sratle/WCH-Model-Terminal/docs/project/Keyboard-2.md

# Keyboard-2 模块（游戏手柄）

## 概述

本模块为游戏操控输入方案，提供丰富的游戏控制输入能力，既服务于终端游戏场景，也可作为独立 USB HID 设备连接电脑。

- **主控芯片**：CH32V103C8T6
- **输入设备**：6 个按钮 + 3 个钮子开关 + 2 个摇杆 + 2 个旋转编码器
- **与核心模块接口**：模块侧 UART1（PA9-TX / PA10-RX），**230400/8-N-1**
- **CH9329 接口**：UART2（PA2-TX / PA3-RX），**115200/8-N-1**
- **模块 ID**：`0x20`（与 Keyboard-1 共用键盘模块 ID，通过子类型区分）
- **模块类型编号**：`0x04`
- **子类型编号**：`0x02`（Game Keyboard）

## 硬件组成

- **CH32V103C8T6**：GPIO 按键扫描、ADC 摇杆采集、编码器计数、协议帧打包、CH9329 通信
- **6 个按钮**（BUTTON1~BUTTON6）：机械按键，GPIO 直连，内部上拉
  - PB10 → BUT1，PB11 → BUT2，PB12 → BUT3
  - PB13 → BUT4，PB14 → BUT5，PB15 → BUT6
- **3 个钮子开关**（SW1~SW3）：每个开关有 UP/DOWN 两路 GPIO，内部上拉
  - PB0 → SW1_UP，PB1 → SW1_DOWN
  - PA13 → SW2_UP，PA14 → SW2_DOWN
  - PB4 → SW3_UP，PB5 → SW3_DOWN
- **2 个摇杆**（ROC1~ROC2）：双轴模拟摇杆，4 路 ADC 输入
  - PA4 → ADC_IN4 → ROC1_X
  - PA5 → ADC_IN5 → ROC1_Y
  - PA6 → ADC_IN6 → ROC2_X
  - PA7 → ADC_IN7 → ROC2_Y
- **2 个旋转编码器**（EC1~EC2）：增量式编码器，A/B 正交信号 + D 按下信号
  - PB6 → EC1_A，PB7 → EC1_B，PA11 → EC1_D（按下）
  - PB8 → EC2_A，PB9 → EC2_B，PA12 → EC2_D（按下）
- **CH9329**：串口转 HID 芯片，UART2 连接，将输入转换为 USB HID 报告
- **USB-A 接口**：Device 口，输出 HID 信号，可接 PC 等主机

### GPIO 引脚分配总表

| 引脚 | 功能 | 方向 | 模式 | 说明 |
|---|---|---|---|---|
| PA2  | UART2_TX | AF_PP | 复用推挽 | CH9329 通信 |
| PA3  | UART2_RX | IPU | 上拉输入 | CH9329 通信 |
| PA4  | ADC_IN4 | AIN | 模拟输入 | 摇杆 1 X 轴 |
| PA5  | ADC_IN5 | AIN | 模拟输入 | 摇杆 1 Y 轴 |
| PA6  | ADC_IN6 | AIN | 模拟输入 | 摇杆 2 X 轴 |
| PA7  | ADC_IN7 | AIN | 模拟输入 | 摇杆 2 Y 轴 |
| PA9  | UART1_TX | AF_PP | 复用推挽 | Core 通信 |
| PA10 | UART1_RX | IPU | 上拉输入 | Core 通信 |
| PA11 | EC1_D | IPU | 上拉输入 | 编码器 1 按下 |
| PA12 | EC2_D | IPU | 上拉输入 | 编码器 2 按下 |
| PA13 | SW2_UP | IPU | 上拉输入 | 开关 2 上拨 |
| PA14 | SW2_DOWN | IPU | 上拉输入 | 开关 2 下拨 |
| PB0  | SW1_UP | IPU | 上拉输入 | 开关 1 上拨 |
| PB1  | SW1_DOWN | IPU | 上拉输入 | 开关 1 下拨 |
| PB4  | SW3_UP | IPU | 上拉输入 | 开关 3 上拨 |
| PB5  | SW3_DOWN | IPU | 上拉输入 | 开关 3 下拨 |
| PB6  | EC1_A | IPU | 上拉输入 | 编码器 1 A 相 |
| PB7  | EC1_B | IPU | 上拉输入 | 编码器 1 B 相 |
| PB8  | EC2_A | IPU | 上拉输入 | 编码器 2 A 相 |
| PB9  | EC2_B | IPU | 上拉输入 | 编码器 2 B 相 |
| PB10 | BUT1 | IPU | 上拉输入 | 按钮 1 |
| PB11 | BUT2 | IPU | 上拉输入 | 按钮 2 |
| PB12 | BUT3 | IPU | 上拉输入 | 按钮 3 |
| PB13 | BUT4 | IPU | 上拉输入 | 按钮 4 |
| PB14 | BUT5 | IPU | 上拉输入 | 按钮 5 |
| PB15 | BUT6 | IPU | 上拉输入 | 按钮 6 |

## 软件职责

### 初始化阶段

- 初始化 CH32V103 时钟、GPIO
- 初始化 UART1（230400, 8-N-1）：PA9-TX / PA10-RX，连接 Core
- 初始化 UART2（115200, 8-N-1）：PA2-TX / PA3-RX，连接 CH9329
- 初始化 GPIO：6 个按钮 + 3 个钮子开关（6 路）+ 2 个编码器 D 信号，配置内部上拉
- 初始化 ADC：配置 4 通道（IN4~IN7）用于摇杆 X/Y 采样
- 初始化编码器：A/B 正交解码（主循环扫描式边沿检测）
- 初始化 CH9329：设置为键盘+鼠标混合模式
- 加载按键映射表

### 运行阶段

- **按钮扫描**：2ms 定时扫描 6 个按钮，检测按下 / 释放事件，软件消抖（3 次扫描 ≈6ms）
- **钮子开关扫描**：定时扫描 3 个开关的 UP/DOWN 状态，检测拨动事件
- **摇杆采集**：2ms 扫描周期内读取 4 通道 ADC，死区处理（±20/255）与归一化至 uint8（0~255，中心 128）
- **编码器解码**：主循环扫描式检测 A/B 正交信号变化，累计旋转增量（顺时针/逆时针），支持 D 按下检测
- **双通道输出**（均变化触发）：
  - 通过 **UART1** 向 Core 上报游戏控制事件（`CMD_KBD_GAME_INPUT`，9 字节全量状态）
  - 通过 **UART2 → CH9329 → USB-A** 输出标准 HID 键盘+鼠标报告（约 20ms 限流），实现接电脑即插即用

### 中断与事件

- TIM2 中断：2ms 扫描节拍（按钮/开关/摇杆 ADC/编码器均在此节拍驱动）
- UART1 中断：接收 Core 下发的查询或配置指令

## 项目目录结构

```
keyboard-2/
├── User/                           # 用户代码
│   ├── main.c                      # 主程序（2ms 扫描调度、双通道输出）
│   ├── Gamepad/                    # 摇杆 ADC、按钮/开关扫描、编码器解码、HID 报告构建
│   ├── CH9329/                     # CH9329 串口转 HID 驱动（UART2 @115200）
│   ├── Uart/                       # UART1 协议栈（230400，接 Core）
│   ├── protocol/                   # 统一协议帧打包/解析
│   └── ...                         # 中断/系统配置
├── Core/  Debug/  Peripheral/  Startup/  Ld/
└── game.wvproj                     # MounRiver Studio 工程文件
```

## 命名规范

- **文件**：统一采用下划线加小写字母，例如 `hardware.c`、`gamepad.h`
- **函数**：每个单词首字母大写加下划线，例如 `Hardware_Init()`、`Joystick_Read()`
- **变量**：统一小写加下划线，例如 `joy_x`、`btn_a_pressed`
- **文件夹**：下划线写法，仅首字母大写，例如 `Gamepad`、`CH9329`
- **系统目录**（`Core`、`Debug`、`Peripheral`、`Startup`）保持不动，不参与上述命名规范

## 开发要点

1. **摇杆死区与迟滞**：ADC 12-bit（0~4095）映射至 uint8（中心 128），软件死区 ±20；
   ROC1 方向判定带**迟滞**（压下阈值 <100/>200，释放阈值 <120/>180），防止方向键抖动；
   变化量 ≥10 才触发上报，滤除 ADC 微跳。**注意 ROC1/ROC2 的 X/Y 轴在硬件上互换**，
   固件已按实际方向修正（见 `gamepad.c` 注释）。
2. **编码器解码**：旋转编码器 A/B 正交信号做主循环扫描式边沿检测与方向判断，累计增量；
   上报 Core 后增量清零；HID 路径上增量 ×3 叠加到鼠标移动。
3. **钮子开关处理**：每个开关有 UP/DOWN 两路 GPIO，低电平有效（内部上拉），同一时刻 UP 和 DOWN 不应同时为低。可编码为三态：上拨（UP=0, DOWN=1）、下拨（UP=1, DOWN=0）、中间（UP=1, DOWN=1）。
4. **CH9329 混合模式映射**：CH9329 原生支持键盘和鼠标 HID 报告，不支持游戏手柄报告描述符。
   实际映射：ROC1 → **方向键**（W/A/S/D 方向 → Up/Left/Down/Right 箭头键）、BUT3~6 → H/J/K/L、
   SW1~3 上拨 → Left Shift/Ctrl/Alt（键盘报告）；ROC2 → 鼠标相对移动（÷8 缩放）、
   BUT1/BUT2 → 鼠标左/右键、EC1_D → 鼠标中键、EC1/EC2 增量 ×3 叠加鼠标 Y/X（鼠标报告）；
   EC2_D 当前未映射。
5. **双通道输出一致性**：同一输入状态同时向 Core（`CMD_KBD_GAME_INPUT`，变化触发）和
   CH9329（键盘+鼠标两帧 HID 报告，变化触发 + 约 20ms 限流）输出。接电脑时无需依赖 Core 即可工作。
6. **与 Keyboard-1 的协议兼容**：两者共用 `0x20` 模块 ID，Core 通过 `CMD_GET_TYPE` 子类型（`0x01` Main / `0x02` Game）区分。支持 `CMD_KBD_GET_STATUS` SUB=0x03 查询当前游戏输入快照。
7. **ADC 采样稳定性**：摇杆电位器供电建议使用 LDO 稳定电压，避免电源波动导致 ADC 值跳变。扫描周期 2ms。
8. **接电脑即插即用**：通过 CH9329 独立输出 HID，意味着即使不插入移动终端，单独把游戏手柄模块接电脑也应能正常工作，这是该模块的重要卖点。
9. **Core 侧联动**：Core 的 `keyboard.c` 将 ROC1 方向转换为方向键 HID 报告、ROC2 转换为鼠标移动
   转发 Display（与模块侧 HID 映射同构），游戏应用（如 Display-1 本地游戏）由此获得方向输入。
