sratle/WCH-Model-Terminal/docs/project/Protocol_Submodels.md

# Submodels 模块通信协议

## 1. 模块概述

- **模块类型编号**：`0x05`
- **模块 ID**：`0x40` ~ `0x42`（对应 UART6/7/8 三个配件槽）

Submodels 为可热插拔的配件模块，通过 UART 与 Core（V5F）通信。整机最多同时插入 **2 ~ 3** 个 Submodel（Submodel-7 副屏占用两个物理位置）。Core 通过 `CMD_GET_TYPE` 识别每个槽位实际插入的子类型。

| 子类型 | 名称 | 功能 |
|---|---|---|
| `0x01` | Fingerprint | 指纹识别 |
| `0x02` | Health | 健康监测（心率/血氧/HRV） |
| `0x03` | NFC | NFC 读卡（被动接收卡号） |
| `0x04` | Touch Ring | 触摸圆环 |
| `0x05` | RGB | RGB 灯效控制 |
| `0x06` | Laser | 激光测距 |
| `0x07` | Sub-Display | 副屏（反射屏，黑白低分辨率） |

### 1.1 帧格式速查

Submodels 通过 **UART6/7/8** 与 Core（V5F）通信，物理层参数：

| 参数 | 值 |
|---|-----|
| 波特率 | 230400 |
| 数据位 | 8 |
| 停止位 | 1 |
| 校验 | 无 |
| 流控 | 无 |

**帧结构**（总长度最大 264 字节）：

```
+--------+--------+--------+--------+--------+-------------+--------+--------+--------+--------+
|  HEAD  |  SRC   |  DST   |  LEN   |  CMD   |  DATA[0..N] | TAIL0  | TAIL1  | TAIL2  | TAIL3  |
| 1 byte | 1 byte | 1 byte | 1 byte | 1 byte |   N bytes   | 1 byte | 1 byte | 1 byte | 1 byte |
+--------+--------+--------+--------+--------+-------------+--------+--------+--------+--------+
```

- **HEAD**：固定 `0xAA`
- **LEN**：`CMD + DATA` 的总字节数，`N = LEN - 1`，范围 `1 ~ 255`
- **DATA**：数据域，长度由 LEN 推导
- **TAIL**：固定序列 `A5 5A FC FD`

**常用模块 ID**：

| ID | 模块 |
|----|---|
| `0x00` | Core（主控） |
| `0x40` | Submodel-1（UART6） |
| `0x41` | Submodel-2（UART7） |
| `0x42` | Submodel-3（UART8） |

> 完整协议规范（含接收状态机、通用操作码 `0x00~0x0F`、NACK 错误码定义）见 `PROJECT.md`。

---

## 2. 通用操作码定义

所有 Submodel 子类型共用以下操作码，通过 **DATA[0] 子命令** 区分具体功能。

| 操作码 | 宏名 | 方向 | 说明 |
| --- | --- | --- | --- |
| `0x40` | `CMD_SUB_EVT_NOTIFY` | Submodel → Core | 事件通知（识别成功、检测到 NFC 标签等） |
| `0x41` | `CMD_SUB_SET_MODE` | Core → Submodel | 设置模式 / 启动动作（注册指纹、开始测距等） |
| `0x42` | `CMD_SUB_GET_STATUS` | Core → Submodel | 查询状态 / 数据 |
| `0x43` | `CMD_SUB_DATA_REPORT` | Submodel → Core | 数据周期性上报（健康数据、RGB 状态等） |
| `0x44` | `CMD_SUB_SET_CONFIG` | Core → Submodel | 设置配置参数（删除指纹、删除标签等） |
| `0x45` | `CMD_SUB_ACTION_RESULT` | Submodel → Core | 动作结果（指纹注册成功、测距完成等） |
| `0x46` | `CMD_SUB_BULK_TRANSFER` | 双向 | 批量传输控制（副屏图片等） |
| `0x47~0x4F` | — | — | 预留 |

---

## 3. ACK/NACK 响应规则

### 3.1 设计原则

| 语义类别 | 说明 | 响应要求 |
|---|---|---|
| **查询 (Query)** | `GET_STATUS` | **必须 ACK + 数据** |
| **设置/动作 (Set/Action)** | `SET_MODE` / `SET_CONFIG` | **发送即忘，不响应** |
| **事件/上报 (Event)** | `EVT_NOTIFY` / `DATA_REPORT` / `ACTION_RESULT` | **不需要响应** |

> 发送即忘：Core 向 Submodel 发送设置/控制命令后不需要等待 ACK。

### 3.2 ACK / NACK 帧格式

**ACK 帧**：`[AA][DST][SRC][LEN][CMD=0x04][DATA...][A5][5A][FC][FD]`

**NACK 帧**：`[AA][DST][SRC][02][CMD=0x05][错误码:1][A5][5A][FC][FD]`

错误码详见 `PROJECT.md`。

---

## 4. 子类型协议详解

### 4.1 指纹识别（子类型 = 0x01）

#### 子命令定义

| 操作码 | 子命令 | 方向 | 说明 | DATA 格式 |
|---|---|---|---|---|
| `0x41` | `0x01` | Core→FP | 开始注册新指纹 | `[子命令:1][ID:1(可选)]`，缺省时模块以当前模板数量作为新 ID |
| `0x41` | `0x02` | Core→FP | 取消注册 | `[子命令:1]` |
| `0x41` | `0x03` | Core→FP | 设置 LED 灯效 | `[子命令:1][功能码:1][颜色:1][速度:1]` |
| `0x41` | `0x04` | Core→FP | 设置安全等级 | `[子命令:1][等级:1]` |
| `0x44` | `0x01` | Core→FP | 删除指纹 | `[子命令:1][指纹ID:1]` |
| `0x44` | `0x02` | Core→FP | 清空所有指纹 | `[子命令:1]` |
| `0x44` | `0x03` | Core→FP | 传感器休眠 | `[子命令:1]` |
| `0x42` | `0x00` | Core→FP | 查询指纹列表 | `[子命令:1]`，ACK + `[数量:1][ID0:1][ID1:1]...`（仅 ID 列表） |
| `0x42` | `0x01` | Core→FP | 查询指纹数量 | `[子命令:1]`，ACK + `[数量:1]` |
| `0x40` | `0x01` | FP→Core | 识别成功 | `[子命令:1][指纹ID:1][名字:16字节]`（模块侧名字补零，用户名由 Core Auth 解析） |
| `0x40` | `0x02` | FP→Core | 识别失败 | `[子命令:1][错误码:1]` |
| `0x40` | `0x03` | FP→Core | 注册/验证进度事件 | `[子命令:1][步骤类型:1][子步骤或ID:1][确认码:1]` |
| `0x45` | `0x01` | FP→Core | 注册成功 | `[子命令:1][指纹ID:1][名字:16字节]`（名字补零） |
| `0x45` | `0x02` | FP→Core | 注册失败 | `[子命令:1][错误码:1]` |

> 名字字段固定 **16 字节**，不足补零，UTF-8 编码；当前固件统一补零，
> 指纹 ID → 用户名的映射由 Core 的 Auth 模块（user.json 凭据绑定）完成。
>
> **进度事件（SUB=0x03）**：自动注册（`PS_AutoEnroll`）与自动验证（`PS_AutoIdentify`）
> 过程中，传感器每个应答包都会转换为一帧进度事件上报 Core：步骤类型对应 Syno 协议
> 的阶段（采图/生成特征/合并/存储/比对等），确认码为该阶段结果。Display 据此实时更新
> 录入引导 UI（提示抬手、再次按压、录入进度）。

#### LED 灯效子命令详解（CMD 0x41 SUB=0x03）

Core 通过此命令控制指纹模块上的 LED 呼吸灯效果，模块内部转发为 Syno 协议的 `PS_ControlBLN`（`0x3C`）指令。

**DATA 格式**：

```
DATA[0] = 0x03（子命令）
DATA[1] = 功能码
DATA[2] = 颜色
DATA[3] = 速度（循环次数/周期）
```

**功能码定义**：

| 功能码 | 宏名 | 说明 |
|---|---|---|
| `0x01` | `FP_LED_BREATH` | 呼吸灯 |
| `0x02` | `FP_LED_FLICKER` | 闪烁 |
| `0x03` | `FP_LED_ON` | 常亮 |
| `0x04` | `FP_LED_OFF` | 关闭 |
| `0x05` | `FP_LED_GRADUAL_ON` | 渐亮 |
| `0x06` | `FP_LED_GRADUAL_OFF` | 渐灭 |
| `0x07` | `FP_LED_HORSE` | 跑马灯 |

**颜色定义**：

| 颜色值 | 宏名 | 说明 |
|---|---|---|
| `0x00` | `FP_COLOR_OFF` | 灭灯 |
| `0x01` | `FP_COLOR_BLUE` | 蓝色 |
| `0x02` | `FP_COLOR_GREEN` | 绿色 |
| `0x03` | `FP_COLOR_CYAN` | 青色 |
| `0x04` | `FP_COLOR_RED` | 红色 |
| `0x05` | `FP_COLOR_MAGENTA` | 品红 |
| `0x06` | `FP_COLOR_YELLOW` | 黄色 |
| `0x07` | `FP_COLOR_WHITE` | 白色 |

**速度**：`0x00` ~ `0xFF`，数值越大速度越快（对应 Syno 协议中的 cycle 参数）。

> **注意**：灯效命令为"发送即忘"，模块不回复 ACK。若传感器处于休眠状态，模块会缓存灯效命令，待唤醒后发送。

#### 安全等级子命令详解（CMD 0x41 SUB=0x04）

设置指纹匹配的安全等级，影响识别精度和速度的平衡。

**DATA 格式**：

```
DATA[0] = 0x04（子命令）
DATA[1] = 安全等级
```

| 等级 | 说明 |
|---|---|
| `0x01` | 低安全等级（速度快，误识率稍高） |
| `0x02` | 中安全等级（默认，平衡） |
| `0x03` | 高安全等级（速度慢，误识率低） |

> 安全等级通过 Syno 协议的 `PS_WriteReg`（`0x0E`）写入系统寄存器实现。

#### 传感器休眠子命令详解（CMD 0x44 SUB=0x03）

使指纹传感器进入低功耗休眠模式。休眠后传感器停止自动检测，需通过 TOUCHOUT 中断或 Core 唤醒。

**DATA 格式**：

```
DATA[0] = 0x03（子命令）
```

> 模块内部发送 `PS_Sleep`（`0x33`）指令。休眠后 TOUCHOUT 引脚仍然有效，手指按下时输出低电平唤醒模块，模块再唤醒传感器进行验证。

#### 查询指纹数量子命令详解（CMD 0x42 SUB=0x01）

轻量级查询，仅返回指纹库中的有效模板数量，不返回完整列表。

**DATA 格式**：

```
DATA[0] = 0x01（子命令）
```

**ACK 响应**：

```
DATA[0] = 数量（1字节，0~255）
```

> 模块内部发送 `PS_ValidTempleteNum`（`0x1D`）获取数量。

#### 注册流程

```
① Core → FP: [标准帧] CMD=0x41 SUB=0x01 开始注册
② FP → Core: [标准帧] CMD=0x04 ACK（进入注册模式）
③ 用户在指纹模块上录入指纹...
④ FP → Core: [标准帧] CMD=0x45 SUB=0x01 注册成功 + 新指纹ID + 名字
```

#### 自动验证流程

```
① 手指按下 → TOUCHOUT 中断触发
② FP 模块发送 PS_AutoIdentify（0x32）启动自动验证
③ 验证成功：FP → Core: [标准帧] CMD=0x40 SUB=0x01 [指纹ID][名字:16字节]
   验证失败：FP → Core: [标准帧] CMD=0x40 SUB=0x02 [错误码]
```

#### LED 灯效控制流程

```
① Core → FP: [标准帧] CMD=0x41 SUB=0x03 [功能码][颜色][速度]
② FP 模块内部转发为 PS_ControlBLN（0x3C）
③ （发送即忘，不回复 ACK）
```

---

### 4.2 健康监测（子类型 = 0x02）

模块上电默认 IDLE（等待手指），检测到手指（IR 超阈值）自动进入 MONITORING 开始测量，
手指离开自动回到 IDLE；Core 也可强制开始/停止。定时主动上报间隔默认 5 秒。

#### 子命令定义

| 操作码 | 子命令 | 方向 | 说明 | DATA 格式 |
|---|---|---|---|---|
| `0x44` | `0x01` | Core→Health | 设置监测间隔 | `[子命令:1][间隔秒数:2(uint16大端)]` |
| `0x44` | `0x02` | Core→Health | 开始监测 | `[子命令:1]` |
| `0x44` | `0x03` | Core→Health | 停止监测 | `[子命令:1]` |
| `0x42` | `0x00` | Core→Health | 查询当前数据 | `[子命令:1]`，ACK + `[心率:1][血氧:1][HRV:2(uint16大端)]` |
| `0x43` | `0x01` | Health→Core | 健康数据上报 | `[子命令:1][心率:1][血氧:1][HRV:2(uint16大端)]` |

> **心率**：0~255 BPM（1 字节）。**血氧**：0~100%（1 字节）。**HRV**：心率变异性 SDNN，0~65535 ms（2 字节 uint16 大端）。
> 心率或血氧为 0 时（算法未产出有效值）模块跳过该次主动上报。

---

### 4.3 NFC（子类型 = 0x03）

NFC 模块为不可配置的被动读卡模块，通过 UART2（9600bps）向 MCU 主动输出卡片数据。MCU 仅做帧解析与协议转发。

#### NFC 模块原始帧格式（UART2, 9600bps）

有卡时每 91ms 输出一次 8 字节帧：

```
[帧头=0xAA:1][路由号:1][卡号:5][奇偶校验:1]
```

- 路由号：`0x30`~`0x33`，对应第 1~4 路卡
- 卡号：5 字节原始卡号
- 奇偶校验：1 字节

#### 子命令定义

| 操作码 | 子命令 | 方向 | 说明 | DATA 格式 |
|---|---|---|---|---|
| `0x40` | `0x01` | NFC→Core | 卡片识别上报 | `[子命令:1][卡ID:1][卡号:5字节]` |
| `0x42` | `0x00` | Core→NFC | 查询当前卡状态 | `[子命令:1]`，ACK + `[卡ID:1][卡号:5字节]` |

> **卡 ID**：1~4（由 NFC 模块路由号 `0x30`~`0x33` 映射）。若无卡，ACK 响应中卡 ID 返回 `0x00`，卡号全 `0x00`。
>
> NFC 模块不可配置，无 SET_MODE / SET_CONFIG 命令。

---

### 4.4 触摸圆环（子类型 = 0x04）

硬件为单片 TTP229-BSF 驱动 16 个触摸焊盘，布局为 **2×2 中心方阵 + 12 位环绕圆环**。

- TP9/TP11/TP8/TP10 → 中心方阵（上左/上右/下左/下右）
- TP13/TP3/TP2/TP1/TP0/TP15/TP14/TP7/TP6/TP5/TP4/TP12 → 环绕圆环（12 位，顺时针）

详见 `Submodel-4.md` 中的键 ID 定义。

#### 子命令定义

| 操作码 | 子命令 | 方向 | 说明 | DATA 格式 |
|---|---|---|---|---|
| `0x43` | `0x01` | Touch→Core | 触摸状态上报 | `[子命令:1][触摸位图:2(uint16大端)]` |
| `0x42` | `0x00` | Core→Touch | 查询触摸状态 | `[子命令:1]`，ACK + `[触摸位图:2(uint16大端)]` |
| `0x41` | `0x01` | Core→Touch | 重新校准基线 | `[子命令:1]` |

#### 触摸位图定义（16-bit）

`bit0`=Key1(TP9,方阵左上) → `bit15`=Key16(TP12,圆环11点钟)，bit=1 表示触摸。

| bit | 键 ID | 触摸引脚 | 分组 | 位置 |
|-----|---|---|---|---|
| 0 | 1 | TP9 | 方阵 | 左上 |
| 1 | 2 | TP11 | 方阵 | 右上 |
| 2 | 3 | TP8 | 方阵 | 左下 |
| 3 | 4 | TP10 | 方阵 | 右下 |
| 4 | 5 | TP13 | 圆环 | 12 点钟 |
| 5 | 6 | TP3 | 圆环 | 1 点钟 |
| 6 | 7 | TP2 | 圆环 | 2 点钟 |
| 7 | 8 | TP1 | 圆环 | 3 点钟 |
| 8 | 9 | TP0 | 圆环 | 4 点钟 |
| 9 | 10 | TP15 | 圆环 | 5 点钟 |
| 10 | 11 | TP14 | 圆环 | 6 点钟 |
| 11 | 12 | TP7 | 圆环 | 7 点钟 |
| 12 | 13 | TP6 | 圆环 | 8 点钟 |
| 13 | 14 | TP5 | 圆环 | 9 点钟 |
| 14 | 15 | TP4 | 圆环 | 10 点钟 |
| 15 | 16 | TP12 | 圆环 | 11 点钟 |

#### 触摸事件流程

```
① 触摸状态变化 → 模块上报 [CMD=0x43 SUB=0x01][位图高字节][位图低字节]
② Core 可随时查询 [CMD=0x42 SUB=0x00] → ACK [位图高字节][位图低字节]
③ Core 可要求重新校准 [CMD=0x41 SUB=0x01]（发送即忘）
```

#### Core 侧行为：圆环 → 鼠标滚轮

Core 收到触摸位图上报后，将圆环（bit4~bit15）的旋转手势映射为标准鼠标
滚轮事件，经 Display 协议 `CMD_DISP_INPUT_EVENT`（0x15）转发给 Display：

- 以半步（0.5 焊盘）分辨率跟踪圆环质心，每 2 半步（1 焊盘）= 1 格滚轮；
- 顺时针 = 向下滚动（滚轮值为负），详见 `Submodel-4.md` 的映射章节；
- 中心 2×2 方阵（bit0~bit3）当前不参与滚轮映射。

---

### 4.5 RGB 灯效（子类型 = 0x05）

RGB 模块为 **7×7 WS2812 LED 矩阵**（共 49 颗灯珠），支持预设模式与自定义逐帧动画。

#### 子命令定义

| 操作码 | 子命令 | 方向 | 说明 | DATA 格式 |
|---|---|---|---|---|
| `0x41` | `0x01` | Core→RGB | 设置 RGB 模式 | `[子命令:1][模式:1][R:1][G:1][B:1][亮度:1][速度:1]` |
| `0x41` | `0x02` | Core→RGB | 传输自定义帧 | `[子命令:1][帧序号:1][帧数据:147]` |
| `0x41` | `0x03` | Core→RGB | 播放自定义动画 | `[子命令:1][总帧数:1][帧间隔:2(uint16大端)]` |
| `0x41` | `0x04` | Core→RGB | 中心波纹动画（一次性事件） | `[子命令:1][速度:1]` |
| `0x41` | `0x05` | Core→RGB | 边缘波浪动画（一次性事件） | `[子命令:1][方向:1][速度:1]` |
| `0x44` | — | Core→RGB | 快捷常亮（无子命令） | `[R:1][G:1][B:1]`（亮度 0xFF、8 档） |
| `0x42` | `0x00` | Core→RGB | 查询当前模式 | `[子命令:1]`，ACK + `[模式:1][R:1][G:1][B:1][亮度:1][速度:1]` |
| `0x43` | `0x01` | RGB→Core | 当前模式上报（预留，当前固件未使用） | `[子命令:1][模式:1][R:1][G:1][B:1][亮度:1][速度:1]` |

> **模式**：`0x00`=自定义（从 rgb.json 加载），`0x01`=常亮，`0x02`=呼吸，`0x03`=跑马灯。
> **帧间隔**：每帧之间的延迟时间，单位 ms。
>
> **固件偏差说明**：查询状态的正确接口为 `0x42 SUB=0x00`（与其他 Submodel 一致，
> Core 侧 `Submodels_RGB_QueryStatus()` 按此发送）。当前 Submodel-5 固件实际响应的是
> 通用 `CMD_GET_STATUS(0x02)`（ACK 同样返回 6 字节状态），对 0x42 会 NACK，
> 属待修正的固件缺陷；协议以本节定义为准。

#### 速度档位定义（V1.6，适用于所有速度字段）

所有命令中的**速度字段统一为档位 1~10**，渲染帧周期固定 10ms（100fps）：

| 档位 | 1 | 2 | 3 | 4 | 5 | 6 | 7 | 8 | 9 | 10 |
|---|---|---|---|---|---|---|---|---|---|----|
| 每步时间 | 47.7ms | 38.1ms | 30.5ms | 24.4ms | 19.5ms | 15.6ms | 12.5ms | **10.0ms** | 8.0ms | 6.4ms |

- **8 档为基准**（10ms/步，即历史固件 speed=255 的行为）；
- 每升一档，动画步进时间 × 0.8；每降一档 ÷ 0.8；
- 9/10 档快于帧周期，模块侧以固定点累加器实现单帧多步，动画仍平滑；
- 非法档位（0 或 >10）按 **8 档**处理。

#### 中心波纹动画事件（CMD 0x41 SUB=0x04）

**一次性动画事件，不是模式切换**：亮度波纹从 7×7 矩阵中心扩散到边缘**一次**后
动画结束，模块自动回到触发前的模式渲染。每颗 LED 按到中心的距离分环，
波前最亮、尾迹线性衰减（4 步）。**颜色与基准亮度沿用模式 1（常亮）配置的
R/G/B/亮度**（本命令不携带颜色参数，也不改变模式状态）。

```
DATA[0] = 0x04（子命令）
DATA[1] = 速度档位（1~10，见速度档位定义）
```

#### 边缘波浪动画事件（CMD 0x41 SUB=0x05）

**一次性动画事件，不是模式切换**：亮度波浪从矩阵一侧传播到另一侧**一次**后
动画结束，模块自动回到触发前的模式渲染。波浪前沿最亮、尾迹线性衰减（3 步）。
**颜色与基准亮度沿用模式 1 配置**。方向决定轴向与传播方向（四方向）。

```
DATA[0] = 0x05（子命令）
DATA[1] = 方向：0x00=左→右, 0x01=右→左, 0x02=上→下, 0x03=下→上
DATA[2] = 速度档位（1~10，见速度档位定义）
```

> **注意**：触发 SUB=0x04/0x05 前应先用 SUB=0x01（模式 1）配置好颜色与亮度，
> 否则颜色/亮度为初始值 0（全暗，动画不可见）。动画播放期间收到新模式设置
> （SUB=0x01）会取消正在播放的一次性动画。发送即忘，模块不回复 ACK。
> `GET_STATUS` 上报的模式字段保持为当前模式（0x00~0x03），不受动画事件影响。
>
> **Display 游戏联动路径**：Display-1 本地游戏通过 Display 协议扩展码
> `CMD_DISP_EXT_RGB_EFFECT`（0x1E）请求 Core 代发本命令（Core 查找 RGB 槽位后
> 调用 `Submodels_RGB_StartRipple` / `Submodels_RGB_StartWave`），详见
> `Protocol_Display.md` V3.6。

#### 预设模式说明

| 模式 | 名称 | 行为 |
|---|---|---|
| `0x00` | 自定义 | 从 `rgb.json` 加载逐帧动画数据 |
| `0x01` | 常亮 | 全部 LED 以指定 R/G/B 颜色常亮 |
| `0x02` | 呼吸 | 全部 LED 以指定颜色呼吸，速度参数控制周期 |
| `0x03` | 跑马灯 | 单灯依次点亮，速度参数控制移动速率 |

#### 自定义帧动画协议

自定义模式（`rgb_mode=0`）下，Core 从 CONFIG 目录下的 `rgb.json` 读取逐帧动画数据，通过标准帧逐帧传输给 RGB 模块。

**rgb.json 格式**：

```json
{
  "frame_count": 5,
  "frame_interval": 100,
  "frames": [
    [[0,0,0],[0,0,0],[0,0,0],...],
    [[255,0,0],[0,255,0],[0,0,255],...],
    ...
  ]
}
```

- `frame_count`：总帧数，最大 **20** 帧
- `frame_interval`：帧间隔（ms），范围 50~1000
- `frames`：数组，每帧包含 49 个 RGB 三元组（每颗 LED 的 24bit RGB888 颜色值）
- 每颗 LED 用 `[R, G, B]` 表示，如 `[255, 0, 0]` 为纯红
- 每帧数据按行优先排列：`[LED0, LED1, ..., LED48]`，对应矩阵位置 `(row, col) = index / 7, index % 7`

**帧传输流程**：

```
① Core 读取 rgb.json，解析帧数据
② Core → RGB: [标准帧] CMD=0x41 SUB=0x02 传输第 N 帧
   DATA: [帧序号:1][LED0_R:1][LED0_G:1][LED0_B:1]...[LED48_R:1][LED48_G:1][LED48_B:1]
   帧序号从 0 开始，每帧 DATA 共 149 字节（1+147，其中 147=49×3 RGB888）

③ 重复②直到所有帧传输完毕

④ Core → RGB: [标准帧] CMD=0x41 SUB=0x03 开始播放
   DATA: [总帧数:1][帧间隔:2(uint16大端)]

⑤ RGB 模块循环播放已接收的帧动画
```

> **帧序号**：0~19，最多 20 帧。
> **单帧数据量**：147 字节（49×3 RGB888），加帧序号共 148 字节，在标准帧最大 255 字节数据域内。
> **RGB888 颜色**：每颗 LED 用 3 字节表示完整颜色（R, G, B 各 1 字节），颜色由帧数据决定，亮度由模式设置命令的全局亮度参数控制。
> **HSV 饱和度**：渲染时 HSV 饱和度强制为最大值（255），仅通过 V 分量缩放实现亮度控制。

---

### 4.6 激光测距（子类型 = 0x06）

采用 VL53L0X-V2 ToF 激光测距传感器，默认模式量程 30~1200 mm。

#### 槽位学习机制

Submodel-6 上电后不知道自身所处的配件槽位（模块 ID），需通过 Core 的 GET_TYPE 命令动态学习：

1. Submodel-6 初始模块 ID 为 `0x00`（未知）
2. Core 向各 UART 端口发送 GET_TYPE，DST 字段为对应槽位地址（0x40/0x41/0x42）
3. Submodel-6 收到 GET_TYPE 后，从 DST 字段读取自身模块 ID
4. 后续所有响应帧的 SRC 字段使用学习到的模块 ID

#### 子命令定义

| 操作码 | 子命令 | 方向 | 说明 | DATA 格式 |
|---|---|---|---|---|
| `0x41` | `0x01` | Core→Laser | 开始测距（切换到 100ms 上报周期） | `[子命令:1]` |
| `0x41` | `0x02` | Core→Laser | 停止测距（回到待机 1s 上报周期） | `[子命令:1]` |
| `0x45` | `0x01` | Laser→Core | 测距结果（按当前周期主动上报） | `[子命令:1][距离mm:2(uint16大端)]` |
| `0x45` | `0x02` | Laser→Core | 测距失败（按当前周期主动上报） | `[子命令:1][错误码:1]` |

> **距离**：0~65535 mm（2 字节 uint16 大端），为模块侧滑动平均滤波（窗口 8）后的结果，
> VL53L0X 默认模式有效量程 30~1200 mm。
> **SET_MODE 命令为发送即忘**，模块不回复 ACK。

#### 测距错误码

| 错误码 | 宏名 | 说明 |
|---|---|---|
| `0x01` | `LR_ERR_NOT_INIT` | 传感器未初始化 |
| `0x02` | `LR_ERR_TIMEOUT` | 测量超时 |
| `0x03` | `LR_ERR_OUT_OF_RANGE` | 超出有效量程 |

#### 双状态定时上报机制

模块上电初始化成功后立即启动 VL53L0X 连续测距（无时自检流程），并进入
**待机状态**。上报为模块侧定时主动发送（TIM2 1kHz 时基调度），不依赖
GET_TYPE 轮询；GET_TYPE 仅回复固定 5 字节身份 ACK。

| 状态 | 进入条件 | 上报周期 | 说明 |
|---|---|---|---|
| 待机（STANDBY） | 上电默认 / 收到 SUB=0x02 | **1000ms** | 每 1s 上报一次滑动平均距离 |
| 测距（RANGING） | 收到 SUB=0x01 | **100ms** | 每 100ms 上报一次滑动平均距离 |

- 传感器连续测距（约 33ms 时序预算），每次数据就绪即采样；
  无效样本（DeviceError ≠ RANGECOMPLETE）不入滤波窗口。
- 滤波为窗口 8 的滑动平均，上报值为窗口内有效样本均值。
- 若上报时刻滤波窗口为空（持续无有效样本），上报 `0x45 SUB=0x02`
  `LR_ERR_OUT_OF_RANGE`。
- Core 收到结果帧后按 `Display_SendSubmodelEvent(SUBMODEL_TYPE_LASER, ...)`
  转发给在线 Display（同 Health 转发路径）。

#### 槽位学习与初始化流程

```
① Core → Laser: [AA][0x00][0x4x][02][0x01][][A5][5A][FC][FD]  (CMD_GET_TYPE)
② Laser 学习自身模块 ID = DST = 0x4x
③ Laser → Core: [AA][0x4x][0x00][03][0x04][0x05][0x06][A5][5A][FC][FD]  (ACK: 类型=0x05, 子类型=0x06)
```

#### 开始测距流程（切换到 50ms 上报）

```
① Core → Laser: [标准帧] CMD=0x41 SUB=0x01 开始测距
② Laser 切换上报周期为 100ms（传感器本就在连续测距）
③ （发送即忘，不回复 ACK）
```

#### 测距数据上报流程（模块主动）

```
Laser → Core: CMD=0x45 SUB=0x01 [距离mm:2]  （待机每 1s / 测距每 100ms）
或 Laser → Core: CMD=0x45 SUB=0x02 [错误码:1]  （滤波窗口为空时）
```

#### 停止测距流程（回到 1s 待机上报）

```
① Core → Laser: [标准帧] CMD=0x41 SUB=0x02 停止测距
② Laser 上报周期切回 1000ms，传感器保持连续测距
③ （发送即忘，不回复 ACK）
```

---

### 4.7 副屏（子类型 = 0x07）

副屏为 2.13 寸反射式黑白屏（122×250 分辨率），通过 UART 接收 Core 发送的状态信息、图片和系统状态。状态模式下支持**三页轮显**（Audio / System / Modules，每 6 次心跳约 3 秒自动切换）；图片模式固定显示 BMP 不翻页。

#### 子命令定义

| 操作码 | 子命令 | 方向 | 说明 | DATA 格式 |
|---|---|---|---|---|
| `0x41` | `0x01` | Core→SubDisp | 传输模块状态 | `[子命令:1][状态数据:变长]` |
| `0x41` | `0x02` | Core→SubDisp | 传输自定义内容 | `[子命令:1][内容类型:1][内容数据:变长]` |
| `0x41` | `0x03` | Core→SubDisp | 清屏 | `[子命令:1]` |
| `0x41` | `0x04` | Core→SubDisp | 切换显示模式 | `[子命令:1][模式:1]` |
| `0x41` | `0x05` | Core→SubDisp | 设置 BMP 文件名 | `[子命令:1][文件名:变长]` |
| `0x41` | `0x10` | Core→SubDisp | BMP 图片传输 | `[子命令:1][帧标志:1][图片数据:变长]`（多帧） |
| `0x41` | `0x11` | Core→SubDisp | 设备列表 | `[子命令:1][帧标志:1][设备数据:变长]`（多帧） |
| `0x42` | `0x00` | SubDisp→Core | 请求系统状态 | `[子命令:1]` |
| `0x42` | `0x01` | SubDisp→Core | 请求设备列表 | `[子命令:1]` |
| `0x42` | `0x02` | SubDisp→Core | 请求 BMP 图片 | `[子命令:1][文件名:变长]` |
| `0x46` | `0x01` | Core→SubDisp | 图片传输握手 | `[子命令:1][图片宽度:2][图片高度:2][数据大小:4]` |
| `0x46` | `0x02` | SubDisp→Core | 图片接收完成确认 | `[子命令:1][结果:1]` |
| `0x46` | `0x03` | Core→SubDisp | 图片数据块 | `[子命令:1][图片数据:变长]`（多帧） |

#### 切换显示模式（CMD 0x41 SUB=0x04）

Core 切换副屏的显示模式。副屏有两种显示模式：

| 模式值 | 宏名 | 说明 |
|---|---|---|
| `0x00` | `SUBDISP_MODE_STATUS` | 状态显示模式 |
| `0x01` | `SUBDISP_MODE_IMAGE` | 图片显示模式（固定显示当前 BMP 图片，不自动翻页） |

**DATA 格式**：

```
DATA[0] = 0x04（子命令）
DATA[1] = 模式（0x00 或 0x01）
```

> 在 `bmp get <filename> sub` 命令中，BMP 传输完成后 Core 自动发送 `SUB=0x04 MODE=0x01` 切换到图片模式。
> 使用 `subdisp mode 0` 可切回状态显示模式，恢复三页轮换。

#### 状态数据格式（CMD 0x41 SUB=0x01）

```
DATA[1]: 状态位图（1字节）
  - bit0: 电量有效    - bit1: 蓝牙状态有效
  - bit2: 时间有效    - bit3: 当前应用有效
DATA[2]: 电量百分比（1字节，若 bit0=1）
DATA[3]: 蓝牙状态（1字节，0=断开, 1=已连接，若 bit1=1）
DATA[4..7]: 时间戳（Unix 时间秒数，32位大端，若 bit2=1）
DATA[8]: 当前应用ID（1字节，若 bit3=1）
```

> 状态数据长度由 LEN 推导，位图指示哪些字段有效。

#### 自定义内容格式（CMD 0x41 SUB=0x02）

```
DATA[1]: 内容类型（1字节）
  - 0x00: 文本    - 0x01: 图标    - 0x02: 进度条
  - 0x03: 简单图形（矩形/圆）
DATA[2..N]: 内容数据（变长，由内容类型定义）
```

#### BMP 图片传输（CMD 0x41 SUB=0x10）

Core 从默认存储设备的 `\BMP` 目录读取指定 BMP 文件，解析为 1bit 位图后，以多帧方式传输给副屏。

**帧标志 FLAGS 定义**（与 Display CLI 直通多帧格式一致）：

| 位 | 宏名 | 值 | 说明 |
|----|---|-----|---|
| bit0 | `SUBDISP_FLAG_SOF` | `0x01` | Start of Frame — 多帧传输的首帧 |
| bit1 | `SUBDISP_FLAG_EOF` | `0x02` | End of Frame — 多帧传输的末帧 |

- 单帧响应：`FLAGS = 0x03`（SOF + EOF 同时置位）
- 多帧首帧：`FLAGS = 0x01`（仅 SOF）
- 多帧中间帧：`FLAGS = 0x00`（无标志）
- 多帧末帧：`FLAGS = 0x02`（仅 EOF）

**首帧 DATA 格式**（FLAGS 包含 SOF）：

```
DATA[0] = 0x10（子命令）
DATA[1] = FLAGS（0x01 或 0x03）
DATA[2..3] = 图片宽度（uint16 大端）
DATA[4..5] = 图片高度（uint16 大端）
DATA[6..9] = 图片数据总字节数（uint32 大端）
DATA[10..N] = 图片数据（首帧 payload，最多 245 字节）
```

**后续帧 DATA 格式**：

```
DATA[0] = 0x10（子命令）
DATA[1] = FLAGS
DATA[2..N] = 图片数据（最多 253 字节）
```

> 每帧 DATA 域最大 255 字节，减去子命令(1) + FLAGS(1) = 253 字节 payload。
> 首帧额外包含图片头(8字节)，因此首帧 payload 最多 245 字节。
> 图片数据为 1bit 位图格式：每行字节数 = `(宽度 + 7) / 8`，行优先排列，MSB 对应最左像素。

**BMP 请求流程**（SubDisp 主动请求）：

```
① SubDisp → Core: [标准帧] CMD=0x42 SUB=0x02 [文件名...]
② Core 读取 \BMP\<文件名>.bmp，解析为 1bit 位图
③ Core → SubDisp: [标准帧] CMD=0x41 SUB=0x10 FLAGS=0x01 [头+数据]
④ Core → SubDisp: [标准帧] CMD=0x41 SUB=0x10 FLAGS=0x00 [数据]
   ...（重复直到所有数据发送完毕）
⑤ Core → SubDisp: [标准帧] CMD=0x41 SUB=0x10 FLAGS=0x02 [最后数据]
```

> 若 BMP 文件不存在或解析失败，Core 发送单帧 `FLAGS=0x03`，DATA 仅含 `[0x10][0x03][0x00]`（宽度=0 表示失败）。

#### 设备列表传输（CMD 0x41 SUB=0x11）

Core 将当前所有模块的在线状态编码后传输给副屏，用于副屏显示设备状态页。

**首帧 DATA 格式**（FLAGS 包含 SOF）：

```
DATA[0] = 0x11（子命令）
DATA[1] = FLAGS
DATA[2] = 模块总数 N（1字节）
DATA[3..] = 模块条目（变长）
```

**模块条目格式**（每个条目 5 字节）：

```
[模块ID:1][模块类型:1][子类型:1][在线状态:1][miss_count:1]
```

- **模块ID**：协议模块 ID（如 `0x10`=Display, `0x20`=Keyboard, `0x40`=Submodel1 等）
- **模块类型**：`MODULE_TYPE_xxx`（如 `0x05`=Submodel）
- **子类型**：`MODULE_SUBTYPE_xxx`
- **在线状态**：`0x00`=UNKNOWN, `0x01`=ONLINE, `0x02`=OFFLINE
- **miss_count**：心跳未回应次数

> 6 个模块 × 5 字节 = 30 字节，可在单帧内传输完毕（FLAGS = 0x03）。

#### 系统状态传输（CMD 0x42 SUB=0x00 请求，Core 多帧响应）

副屏请求系统当前运行状态，Core 以 `CMD_SUB_DATA_REPORT (0x43)` 多帧响应。

**请求帧**：

```
[标准帧] CMD=0x42 SUB=0x00
```

**响应帧**（Core → SubDisp，CMD=0x43，多帧）：

```
DATA[0] = 0x20（系统状态子命令 SUBCMD_SYS_STATUS）
DATA[1] = FLAGS（SOF/EOF 标记）
DATA[2..N] = 系统状态数据
```

**系统状态数据格式（SOF 首帧）**：

| 偏移 | 长度 | 字段 | 说明 |
|---|---|---|---|
| 0 | 1 | 版本 | 状态数据格式版本，当前 `0x02` |
| 1 | 1 | 音频状态 | `0x00`=IDLE, `0x01`=PLAYING, `0x02`=PAUSED, `0x03`=STOPPED |
| 2 | 1 | 音量 | 0~100 |
| 3 | 4 | 播放时长 | 毫秒数（uint32 大端） |
| 7 | 1 | 电量百分比 | 0~100；Power 未在线/未上报时为 `0xFF`=未知 |
| 8 | 1 | 充电状态 | `0x00`=未充电, `0x01`=充电中（取自 Power 状态位图 bit0） |
| 9 | 1 | 蓝牙连接数 | 当前 BLE 连接数 |
| 10 | 1 | 蓝牙可发现 | `0x00`=不可发现, `0x01`=可发现 |
| 11 | 1 | 屏幕亮度 | 0~100 |
| 12 | 1 | 键盘背光 | 0~100 |
| 13 | 1 | CH378 设备 | `0x00`=USB, `0x01`=TF |
| 14 | 1 | CH378 忙碌 | `0x00`=空闲, `0x01`=忙碌 |
| 15 | 1 | CH9350 HID 数量 | 已连接的 HID 设备数 |
| 16 | 1 | RGB 模式 | 0~3 |
| 17 | 1 | RGB 亮度 | 0~255 |
| 18 | 1 | 配置已加载 | `0x00`=否, `0x01`=是 |
| 19 | 1 | 模块总数 | 后续模块条目数量 |
| 20 | 1 | Display 类型 | **v2 新增**：`0x00`=无, `0x01`=LCD, `0x02`=EInk |
| 21 | 1 | Keyboard 类型 | **v2 新增**：`0x00`=无, `0x01`=Main, `0x02`=Game, `0x03`=Music |
| 22 | 1 | CH9350 设备类型 | **v2 新增**：`0x00`=无, `0x01`=键盘, `0x02`=相对鼠标, `0x03`=绝对鼠标, `0x04`=多媒体, `0x05`=扫描枪 |
| 23 | 1 | 曲目名长度 N | **v2 新增**：当前曲名长度（0~31） |
| 24..24+N-1 | N | 曲目名 | **v2 新增**：UTF-8，不含终止符 |
| 24+N | 4 | 键盘按键统计 | **v2 新增**：uint32 大端 |
| 28+N.. | 5×M | 模块条目 | 同 LS_DEV 格式（M = 模块总数） |

> v2 字段（偏移 20 起）为变长布局，解析时必须以曲目名长度字段定位后续偏移。

#### 图片传输流程（Bulk Mode，CMD 0x46）

副屏图片为黑白位图（1 bit/像素），采用 **标准帧握手 + 多帧数据传输**：

```
① Core → SubDisp: [标准帧] CMD=0x46 SUB=0x01 图片握手
   DATA: [宽度:2][高度:2][总字节数:4]
   总字节数 = ceil(宽度/8) × 高度

② SubDisp → Core: [标准帧] CMD=0x04 ACK（准备接收）

③ Core → SubDisp: [标准帧] CMD=0x46 SUB=0x03 [图片数据块]
   每帧最多 252 字节 payload，多帧传输直到全部数据发完

④ SubDisp → Core: [标准帧] CMD=0x46 SUB=0x02 接收完成确认
   DATA[0]: 结果（0=成功, 1=失败）
```

> 图片数据按行优先排列，每行字节数 = `(宽度 + 7) / 8`。MSB 对应每字节最左边的像素。

---

## 5. CMD_GET_TYPE 响应

Submodel 响应 `CMD_GET_TYPE` 时，`CMD_ACK` 的 DATA 格式如下：

| 字节 | 字段 | 值/说明 |
|---|---|---|
| DATA[0] | 模块类型编号 | `0x05` |
| DATA[1] | 模块子类型编号 | 见下表 |
| DATA[2] | 硬件版本号 | 模块硬件版本 |
| DATA[3] | 固件主版本号 | 固件主版本 |
| DATA[4] | 固件次版本号 | 固件次版本 |

> **身份 ACK 指纹约束**：Core 按 `LEN == 6 且 DATA[0] == 0x05` 识别 GET_TYPE 身份 ACK
> 并刷新槽位类型/在线状态。因此：
> 1. 身份 ACK 数据域**固定 5 字节**，不支持扩展字节（原"DATA[5..N] 扩展信息"已废弃）；
> 2. 各子类型的查询 ACK（QUERY_LIST / GET_STATUS 等）数据域长度**不得为 5 字节**；
> 3. 模块→Core 方向避免背靠背连发多帧（Core 双缓冲保旧丢新，紧跟身份 ACK 之后的
>    事件帧在 Core 主循环繁忙时可能被丢弃，事件应可周期重发）。
>
> **链路自恢复**：Core 对非在线槽位会周期性发送 `0x00` 填充字节（反卡死填充），
> 模块解析器必须将 `0x00` 视为无效字节直接忽略（现有帧头 `0xAA` 判定天然满足）。

**Submodel 子类型定义**

> 代码宏定义：`protocol.h` → `MODULE_SUBTYPE_SUBMODEL_*`

| 子类型编号 | 宏名 | 实现名称 | 说明 |
|---|---|---|---|
| `0x00` | `MODULE_SUBTYPE_SUBMODEL_RESERVED` | 保留 | 系统保留 |
| `0x01` | `MODULE_SUBTYPE_SUBMODEL_FINGERPRINT` | 指纹识别 | 指纹录入与识别 |
| `0x02` | `MODULE_SUBTYPE_SUBMODEL_HEALTH` | 健康监测 | 心率/血氧/HRV |
| `0x03` | `MODULE_SUBTYPE_SUBMODEL_NFC` | NFC 读卡 | 被动接收卡号（不可配置） |
| `0x04` | `MODULE_SUBTYPE_SUBMODEL_TOUCH_RING` | 触摸圆环 | TTP229 16 键触摸（2×2 方阵 + 12 位圆环） |
| `0x05` | `MODULE_SUBTYPE_SUBMODEL_RGB` | RGB 灯效 | 灯效控制 |
| `0x06` | `MODULE_SUBTYPE_SUBMODEL_LASER` | 激光测距 | 距离测量 |
| `0x07` | `MODULE_SUBTYPE_SUBMODEL_SUB_DISPLAY` | 副屏 | 反射式黑白屏 |
| `0x08~0xFF` | — | 预留 | 未来扩展 |

---

## 6. 版本记录

| 版本 | 日期 | 说明 |
|---|---|---|
| V1.0 | 2026-04-24 | 初始版本：定义 7 种 Submodel 子类型的通用操作码与子命令体系 |
| V1.1 | 2026-06-05 | 副屏协议扩展：新增 BMP_TRANS(0x10)、LS_DEV(0x11)、GET_STATUS(0x00~0x02)、SET_DISPLAY_MODE(0x04) 命令；多帧传输协议；系统状态数据格式 |
| V1.2 | 2026-06-11 | NFC 子类型重写：改为被动读卡模块，删除 SET_CONFIG 命令，卡号改为 5 字节 + 卡 ID（1~4） |
| V1.3 | 2026-07-21 | 触摸圆环行为定义：Core 将圆环（bit4~bit15）旋转映射为标准鼠标滚轮事件转发 Display（半步质心跟踪，每焊盘 1 格，顺时针=向下） |
| V1.4 | 2026-07-27 | 热插拔可靠性加固：身份 ACK 指纹约束（LEN 固定 6，废弃扩展字节）；查询 ACK 数据域长度禁止为 5 字节；Core 侧接收改双缓冲（保旧丢新）+ 100ms 帧间超时；新增非在线槽位 0x00 反卡死填充机制；OFFLINE 时 Core 清空槽位类型缓存 |
| V1.5 | 2026-08-05 | RGB 子类型扩展：新增一次性动画事件——中心波纹（SUB=0x04）与边缘波浪（SUB=0x05，四方向），播放一次后自动回到原模式，颜色/亮度沿用模式 1 配置 |
| V1.6 | 2026-08-06 | RGB 速度字段改为档位制（1~10）：8 档=10ms/步（原 speed=255 行为），每升一档 × 0.8；非法档位按 8 档处理；config 默认 rgb_speed 由 50 改为 8，旧越界值钳制为 8 |
| V1.7 | 2026-08-06 | 激光测距子类型更名（Infrared/红外 → Laser/激光，宏 `MODULE_SUBTYPE_SUBMODEL_LASER`、`LR_*`）；测距上报机制重做：模块上电即连续测距，待机 1s / 测距 100ms 定时主动上报滑动平均（窗口 8）结果，GET_TYPE 不再附带测距数据 |
| V1.8 | 2026-08-08 | 文档对齐实际固件：指纹新增注册/验证进度事件（0x40 SUB=0x03）、注册可携带可选 ID、查询指纹列表 ACK 改为仅 ID 列表（名字恒补零，由 Core Auth 解析）；健康子类型描述修正为心率/血氧/HRV（无体温），补充手指自动检测与默认 5s 上报；RGB 新增 SET_CONFIG(0x44) 快捷常亮、标注 0x42 查询的固件偏差、0x43 上报标记预留未用；副屏新增 SET_BMP_NAME(0x05)、系统状态响应子命令修正为 0x20、系统状态数据补齐 v2 字段（Display/Keyboard 类型、CH9350 设备类型、曲目名、按键统计）、双页轮显修正为三页轮显 |
