sratle/WCH-Model-Terminal/docs/project/Submodel-2.md

# Submodel-2 模块（健康监测）

## 概述

本模块为生理参数监测扩展方案，用于实时采集心率、血氧及 HRV（心率变异性）数据。

- **主控芯片**：CH32V103C8T6
- **与核心模块接口**：模块侧 UART1（PA9-TX, PA10-RX），**230400/8-N-1**
- **模块 ID**：`0x40` ~ `0x42`
- **模块类型编号**：`0x05`
- **子类型编号**：`0x02`（Health Monitor）

## 硬件组成

- **CH32V103C8T6**：传感器数据采集、滤波处理、协议帧打包
- **心率 / 血氧传感器**：MAX30102（I2C 接口，集成红光 + 红外 LED + 光电二极管）

### 引脚分配

| 引脚 | 功能 | 说明 |
|---|---|---|
| PA9 | UART1_TX | 与 Core 通信发送 |
| PA10 | UART1_RX | 与 Core 通信接收 |
| PB14 | I2C_SCL | MAX30102 时钟线 |
| PB15 | I2C_SDA | MAX30102 数据线 |
| PB13 | GPIO_INT | MAX30102 中断输入（低电平有效） |

## 软件职责

### 初始化阶段

- 初始化 CH32V103 时钟、GPIO、I2C（PB14/PB15）、UART1（PA9/PA10，230400）
- 初始化 MAX30102：配置采样率、LED 电流、FIFO 中断阈值
- 配置 PB13 为外部中断输入，下降沿触发
- 向 Core 回复 `CMD_GET_TYPE`，上报子类型 `0x02`

### 运行阶段

- **心率 / 血氧 / HRV 采集**：
  - 从 MAX30102 FIFO 读取原始光电容积脉搏波（PPG）数据
  - 软件滤波（如移动平均、带通滤波）去除基线漂移与运动伪影
  - 通过峰值检测计算心率（BPM）与血氧饱和度（SpO2）
  - 通过相邻 RR 间期标准差计算 HRV（心率变异性，单位 ms）
- **手指自动检测（IDLE/MONITORING 双状态）**：
  - 上电默认 IDLE 状态，仅监测 PROX_INT / IR 电平；手指放上（IR ≥ `MAX30102_FINGER_OFF_IR_MIN`=5000）
    自动进入 MONITORING 开始测量，无需 Core 下发开始命令
  - 连续 50 个低 IR 样本判定手指离开，自动回到 IDLE 并停止上报
  - Core 也可通过 `CMD_SUB_SET_CONFIG`（0x44）SUB=0x02/0x03 强制开始/停止监测
- **数据上报**：
  - 定时主动上报：`CMD_SUB_DATA_REPORT`（0x43 SUB=0x01），上报间隔默认 **5 秒**，
    可由 `CMD_SUB_SET_CONFIG` SUB=0x01 设置（uint16 大端秒数）
  - 响应 Core 查询：`CMD_SUB_GET_STATUS`（0x42 SUB=0x00），ACK 携带 `[心率:1][血氧:1][HRV:2]`
  - **零值过滤**：心率或血氧为 0 时跳过本次主动上报（算法未产出有效值的
    首次/未稳定阶段不产生 0 值数据，避免污染 Core 侧统计）
- **异常检测**：心率 / 血氧超出预设阈值时，立即上报告警事件

### 中断与事件

- MAX30102 中断（PB13 INT 引脚，EXTI 下降沿）：FIFO 几乎满，触发批量读取
- 主循环 10ms 轮询 `Max30102_PollFIFO()` 作为中断后备（双保险）
- TIM2 更新中断：1kHz 毫秒时基，驱动采样轮询与上报节拍
- UART1 中断：接收 Core 的查询或配置指令

> **注意**：USART1 同时承担 Core 协议通信，禁止 `USART_Printf_Init()` 类 printf 调试输出，
> 否则会污染协议帧（main.c 中已刻意不初始化 printf）。

## 项目目录结构

```
submodel_2/
├── Common/                         # 公共代码与系统文件
│   ├── Common/                     # 自定义公共模块
│   │   ├── Max30102/               # MAX30102 驱动与 PPG 算法
│   │   ├── Filter/                 # 数字滤波算法（移动平均、带通等）
│   │   ├── Uart/                   # UART1 协议栈
│   │   ├── hardware.c              # 全局调度与初始化入口
│   │   └── hardware.h              # 全局调度头文件
│   ├── Core/                       # RISC-V 内核相关文件
│   ├── Debug/                      # 调试支持文件
│   ├── Peripheral/                 # 芯片外设库
│   └── Startup/                    # 启动文件
│
├── User/                           # 用户代码（main.c / 中断 / 系统配置）
├── Ld/                             # 链接脚本
├── .cproject
├── .project
└── submodel_2.wvproj               # MounRiver Studio 工程文件
```

## 命名规范

- **文件**：统一采用下划线加小写字母，例如 `hardware.c`、`max30102.h`
- **函数**：每个单词首字母大写加下划线，例如 `Hardware_Init()`、`Hr_Calculate()`
- **变量**：统一小写加下划线，例如 `heart_rate`、`spo2_value`
- **文件夹**：下划线写法，仅首字母大写，例如 `Max30102`、`Filter`
- **系统目录**（`Core`、`Debug`、`Peripheral`、`Startup`）保持不动，不参与上述命名规范

## 开发要点

1. **PPG 算法精度**：CH32V103 算力有限，不建议实现复杂的机器学习方法；采用简单的峰值检测 + 直流/交流分量比值法估算 SpO2 即可，精度约 ±2%~±5%，满足消费级场景。
2. **HRV 计算**：HRV 通过相邻 RR 间期（峰值间隔）的标准差（SDNN）计算，单位 ms。建议至少积累 5 个有效 RR 间期后再计算并上报，避免数据不稳定。
3. **接触式测量要求**：MAX30102 需要手指紧贴传感器窗口，模块外壳设计应预留测量窗口并做遮光处理，环境光干扰会严重影响 PPG 信号质量。
4. **功耗管理**：MAX30102 可在空闲时进入低功耗模式，仅在测量周期唤醒；若模块由电池供电（通过核心板 5V），降低功耗尤为重要。
5. **数据平滑**：心率和血氧值波动较大，建议在上报前做滑动窗口平均（如前 5 个有效值的均值），避免 UI 上数字乱跳。
6. **与 Core/Display 的协同**：健康数据上报到达 Core 后经 `Display_SendSubmodelEvent(SUBMODEL_TYPE_HEALTH, ...)`
   转发给在线 Display，由 Display 的 Health 应用以数字/图表形式展示；Submodel-2 只负责采集与上报，
   UI 渲染完全由 Display / Core 负责。
7. **软件 I2C**：PB14/PB15 为软件模拟 I2C（非硬件外设），时序由驱动内延时保证。
