sratle/WCH-Model-Terminal/docs/project/Submodel-4.md

# Submodel-4 模块（触摸圆环）

## 概述

本模块为电容触摸输入扩展方案，通过 TTP229-BSF 驱动 16 个触摸焊盘，组成 **2×2 中心方阵 + 12 位环绕圆环**，构成一个「圆盘导航器」：**圆环旋转** → 由 Core 映射为标准鼠标滚轮（列表滚动、滑条调节等），**中心 2×2 方阵** → 由 Core 映射为导航键（确定 / 返回 / 上一项页 / 下一项页），无需触屏或鼠标即可操作整机，适用于菜单浏览、电子书翻页、音乐控制、灯效调节等场景。

- **主控芯片**：CH32V103C8T6
- **与核心模块接口**：模块侧 UART1（PA9/PA10），**230400/8-N-1**
- **模块 ID**：`0x40` ~ `0x42`
- **模块类型编号**：`0x05`
- **子类型编号**：`0x04`（Touch Ring）

## 硬件组成

### 主控

- **CH32V103C8T6**：TTP229 串行读取、协议帧打包

### 触摸 — TTP229-BSF 电容触摸（16 键）

采用单片 TTP229-BSF 驱动 16 个触摸焊盘，全部 16 通道均使用。

| 引脚 | 功能 |
|---|---|
| PB15 | TTP229 SDO（数据输出） |
| PB14 | TTP229 SCL（时钟输出） |

**TTP229 配置要求**：

| 配置引脚 | 功能 | 要求 | 说明 |
|---|---|---|---|
| TP2 (KYSEL) | 键数选择 | 串高阻电阻接 VSS → **16 键模式** | 必须为 16 键串行输出 |
| TP4 (SKMS0) | 多键模式 | 串高阻电阻接 VSS → **多键触发** | 支持多点同时触摸 |
| TP1 (SAHL) | 输出极性 | 悬空（默认低有效） | bit=0 表示触摸 |
| TP3 (SKMS1) | 多键模式 | 串高阻电阻接 VSS → 配合 TP4 实现全 16 键多键 | TP3=0, TP4=0 = 全多键触发 |

### 触摸焊盘布局

16 个触摸焊盘分为两组：

**中心方阵（2×2）**：

```
┌─────┬─────┐
│ TP9 │TP11 │    ← 上排
├─────┼─────┤
│ TP8 │TP10 │    ← 下排
└─────┴─────┘
 左列   右列
```

**环绕圆环（12 位，顺时针）**：

```
          TP13
     TP3        TP2
   TP1            TP0
  TP15            TP14
   TP7            TP6
     TP5        TP4
          TP12
```

圆环顺序（顺时针）：TP13 → TP3 → TP2 → TP1 → TP0 → TP15 → TP14 → TP7 → TP6 → TP5 → TP4 → TP12

### 键 ID 定义

| 键 ID | 触摸引脚 | 分组 | 位置 |
|---|---|---|---|
| 1 | TP9 | 方阵 | 左上 |
| 2 | TP11 | 方阵 | 右上 |
| 3 | TP8 | 方阵 | 左下 |
| 4 | TP10 | 方阵 | 右下 |
| 5 | TP13 | 圆环 | 12 点钟 |
| 6 | TP3 | 圆环 | 1 点钟 |
| 7 | TP2 | 圆环 | 2 点钟 |
| 8 | TP1 | 圆环 | 3 点钟 |
| 9 | TP0 | 圆环 | 4 点钟 |
| 10 | TP15 | 圆环 | 5 点钟 |
| 11 | TP14 | 圆环 | 6 点钟 |
| 12 | TP7 | 圆环 | 7 点钟 |
| 13 | TP6 | 圆环 | 8 点钟 |
| 14 | TP5 | 圆环 | 9 点钟 |
| 15 | TP4 | 圆环 | 10 点钟 |
| 16 | TP12 | 圆环 | 11 点钟 |

### 引脚分配汇总

| 功能 | 引脚 | 模式 | 说明 |
|---|---|---|---|
| UART1 TX | PA9 | AF_PP | 连接 Core（230400） |
| UART1 RX | PA10 | IPU | 连接 Core（230400） |
| TTP229 SDO | PB15 | Input | 触摸 IC 数据输出 |
| TTP229 SCL | PB14 | Output | 触摸 IC 时钟输出 |

## 软件职责

### 初始化阶段

- 初始化 CH32V103 时钟、GPIO、UART1（230400）
- 初始化 TTP229 串行接口 GPIO：PB15（SDO 输入）、PB14（SCL 推挽输出）
- 上电校准 TTP229 基线（消除 PCB 寄生电容）
- 等待 TTP229 上电稳定（约 0.5 秒）
- 向 Core 回复 `CMD_GET_TYPE`，上报子类型 `0x04`

### 运行阶段

- **触摸检测**：定时读取 TTP229 的 16-bit 串行数据，通过校准和映射转换为 16 键状态
- **事件上报**：状态变化时通过 UART1 向 Core 上报触摸事件
- **指令响应**：响应 Core 的模式设置和状态查询

### 中断与事件

- **定时器中断**：触摸扫描周期（建议 ≥ 10ms，TTP229 响应时间 32ms@16 键模式）
- **UART1 中断**：接收 Core 下发的命令

## 项目目录结构

```
submodel-4/
├── User/                           # 用户代码
│   ├── main.c                      # 主程序入口
│   ├── ch32v10x_conf.h             # 外设配置头文件
│   ├── ch32v10x_it.c               # 中断服务函数
│   ├── ch32v10x_it.h
│   ├── system_ch32v10x.c           # 系统时钟配置
│   ├── system_ch32v10x.h
│   ├── TTP229/                     # TTP229 电容触摸 IC 驱动
│   │   ├── ttp229.c                #   串行读取、校准、TP→键映射
│   │   └── ttp229.h
│   └── Uart/                       # UART1 协议通信（后续添加）
│       ├── uart_core.c
│       └── uart_core.h
├── Core/                           # RISC-V 内核文件
├── Debug/                          # 调试支持（USART printf）
├── Peripheral/                     # 芯片外设库
├── Startup/                        # 启动文件
├── Ld/                             # 链接脚本
├── touch.launch                    # OpenOCD 调试配置
└── touch.wvproj                    # MounRiver Studio 工程文件
```

## 命名规范

- **文件**：统一采用下划线加小写字母，例如 `uart_core.c`、`ttp229.h`
- **函数**：每个单词首字母大写加下划线，例如 `TTP229_Read()`、`TTP229_Calibrate()`
- **变量**：统一小写加下划线，例如 `touch_bitmap`、`raw_data`
- **文件夹**：首字母大写，例如 `TTP229`、`Uart`
- **系统目录**（`Core`、`Debug`、`Peripheral`、`Startup`）保持不动，不参与上述命名规范

## 开发要点

1. **TTP229 串行时序**：MCU 等待 SDO 数据有效信号（DV，约 93μs）后发 SCL 时钟读取数据。16 键模式响应时间约 32ms，扫描周期建议 ≥ 10ms。SCL 超时 2ms 自动复位。
2. **上电校准**：TTP229 基线校准受 PCB 寄生电容影响，需在 500ms 上电稳定后捕获空闲状态作为基线，运行时用 `(~raw) & baseline` 消除寄生位。
3. **多键检测**：支持多点同时触摸（和弦/多指手势），TTP229 硬件需配置 TP4=0、TP3=0 启用全多键触发模式。
4. **圆环滑动**：12 位圆环支持滑动手势识别（顺时针/逆时针），需处理跨越 0° 点的情况，建议用环形缓冲区记录最近 N 个触摸点再做趋势判断。
5. **方阵中心键**：2×2 方阵（键 ID 1~4）作为点按环中心键，模块固件只需上报触摸位图，Core 在 `submodels_touch_matrix_to_keys()` 做**上升沿边沿检测**并注入标准 HID 键盘轻触（左上=返回/Esc、右上=确定/Enter、左下=上一项页/Left、右下=下一项页/Right），与圆环的滚轮事件通过位段（方阵 bit0~3、圆环 bit4~15）天然区分。详见下文「Core 侧方阵 → 导航键映射」。

## Core 侧圆环 → 鼠标滚轮映射

模块固件只需在触摸状态变化时上报 16 位触摸位图（已实现，10ms 扫描）。
**Core 负责把圆环旋转映射为标准鼠标滚轮事件**（`submodels.c` 的
`submodels_touch_ring_to_wheel()`）：

- 圆环 12 键占据位图 bit4~bit15（键 ID 5~16），位序号递增方向与物理顺时针一致
  （bit4=TP13 12点钟 → bit15=TP12 11点钟）。
- Core 以**半步**（0.5 焊盘）分辨率跟踪手指质心：一圈 = 12 焊盘 = 24 半步；
  相邻两焊盘同时触发（手指搭接）时质心取半步位置。
- 质心每累计移动 **2 半步（1 个焊盘）** 产生 1 格滚轮增量；一次上报可携带多格
  （快速滑动）。距锚点超过 3 个焊盘的跳变视为异常（多点误触/抬手重放），
  重新锚定不产生滚轮增量；手指离开圆环（位图归零）即停止跟踪。
- 方向约定：**顺时针 = 向下滚动**（滚轮值为负；协议定义滚轮正值 = 向上），
  可由 `TOUCH_RING_WHEEL_DIR` 宏翻转。
- 滚轮增量打包为标准鼠标报告（buttons=0, dx=0, dy=0, wheel=±N），经
  `CMD_DISP_INPUT_EVENT`（0x15）转发给 Display，与真实鼠标滚轮走同一路径。

## Core 侧方阵 → 导航键映射（iPod 式点按环中心键）

方阵 4 键（触摸位图 bit0~bit3，键 ID 1~4）由 Core 的
`submodels_touch_matrix_to_keys()` 映射为标准 HID 键盘事件，与环=滚轮互不干扰
（环用 bit4~15）。整块模块因此成为一个「圆盘导航器」：环滚动 + 中心 4 键
（确定 / 返回 / 上一项页 / 下一项页），无需触屏或鼠标即可操作整机。

| 键 ID | 位置 | 动作 | 注入的 HID 键码 | Display 生成事件 |
|---|---|---|---|---|
| 1 | 左上 (TP9)  | 返回 | Esc `0x29` | `UI_EVENT_KEY_BACK` |
| 2 | 右上 (TP11) | 确定/开始 | Enter `0x28` | `UI_EVENT_KEY_OK` |
| 3 | 左下 (TP8)  | 上一项/页 | Left `0x50`  | `UI_EVENT_KEY_LEFT_ARROW` |
| 4 | 右下 (TP10) | 下一项/页 | Right `0x4F` | `UI_EVENT_KEY_RIGHT_ARROW` |

- **边沿检测**：Core 缓存上一帧方阵位图，仅在**按下的上升沿**触发一次；
  抬起不产生事件。支持多点（多个中心键同帧按下各触发一次）。
- **轻触注入**：每次触发发送「按下报告（键码置于槽位）+ 抬起报告（空）」两帧
  标准 HID 键盘报告，经 `CMD_DISP_INPUT_EVENT`（0x15，dev=`INPUT_DEV_KEYBOARD`）
  转发，与外接键盘走完全相同的路径，因此天然复用 MiniUI 的焦点/返回/翻页逻辑。
- **无自动连发**：一次触摸 = 一次动作（连续滚动交给环）；需要多次翻页可多次点按。
- **一致性**：`UI_EVENT_KEY_LEFT_ARROW`/`RIGHT_ARROW` 在两块屏的电子书里均为
  上一页/下一页；方向键的 USB HID 键码（0x50=Left、0x51=Down）两屏已统一。
