sratle/WCH-Model-Terminal/docs/devboard/hardware/devboard-lcd参考代码/STM32/Objects/2.htm

# Static Call Graph for image .\Objects\2.0TFT

#<CALLGRAPH># ARM Linker, 5060750: Last Updated: Wed Nov 13 20:01:38 2019

### Maximum Stack Usage = 40 bytes + Unknown(Functions without stacksize, Cycles, Untraceable Function Pointers)

### Call chain for Maximum Stack Depth:

__rt_entry_main ⇒ main ⇒ display_char16_16 ⇒ TFT_SEND_DATA

### Functions with no stack information

- __user_initial_stackheap

### Mutually Recursive functions

- NMI_Handler ⇒ NMI_Handler
- HardFault_Handler ⇒ HardFault_Handler
- MemManage_Handler ⇒ MemManage_Handler
- BusFault_Handler ⇒ BusFault_Handler
- UsageFault_Handler ⇒ UsageFault_Handler
- SVC_Handler ⇒ SVC_Handler
- DebugMon_Handler ⇒ DebugMon_Handler
- PendSV_Handler ⇒ PendSV_Handler
- SysTick_Handler ⇒ SysTick_Handler
- ADC1_2_IRQHandler ⇒ ADC1_2_IRQHandler

### Function Pointers

- ADC1_2_IRQHandler from startup_stm32f10x_md.o(.text) referenced from startup_stm32f10x_md.o(RESET)
- BusFault_Handler from startup_stm32f10x_md.o(.text) referenced from startup_stm32f10x_md.o(RESET)
- CAN1_RX1_IRQHandler from startup_stm32f10x_md.o(.text) referenced from startup_stm32f10x_md.o(RESET)
- CAN1_SCE_IRQHandler from startup_stm32f10x_md.o(.text) referenced from startup_stm32f10x_md.o(RESET)
- DMA1_Channel1_IRQHandler from startup_stm32f10x_md.o(.text) referenced from startup_stm32f10x_md.o(RESET)
- DMA1_Channel2_IRQHandler from startup_stm32f10x_md.o(.text) referenced from startup_stm32f10x_md.o(RESET)
- DMA1_Channel3_IRQHandler from startup_stm32f10x_md.o(.text) referenced from startup_stm32f10x_md.o(RESET)
- DMA1_Channel4_IRQHandler from startup_stm32f10x_md.o(.text) referenced from startup_stm32f10x_md.o(RESET)
- DMA1_Channel5_IRQHandler from startup_stm32f10x_md.o(.text) referenced from startup_stm32f10x_md.o(RESET)
- DMA1_Channel6_IRQHandler from startup_stm32f10x_md.o(.text) referenced from startup_stm32f10x_md.o(RESET)
- DMA1_Channel7_IRQHandler from startup_stm32f10x_md.o(.text) referenced from startup_stm32f10x_md.o(RESET)
- DebugMon_Handler from startup_stm32f10x_md.o(.text) referenced from startup_stm32f10x_md.o(RESET)
- EXTI0_IRQHandler from startup_stm32f10x_md.o(.text) referenced from startup_stm32f10x_md.o(RESET)
- EXTI15_10_IRQHandler from startup_stm32f10x_md.o(.text) referenced from startup_stm32f10x_md.o(RESET)
- EXTI1_IRQHandler from startup_stm32f10x_md.o(.text) referenced from startup_stm32f10x_md.o(RESET)
- EXTI2_IRQHandler from startup_stm32f10x_md.o(.text) referenced from startup_stm32f10x_md.o(RESET)
- EXTI3_IRQHandler from startup_stm32f10x_md.o(.text) referenced from startup_stm32f10x_md.o(RESET)
- EXTI4_IRQHandler from startup_stm32f10x_md.o(.text) referenced from startup_stm32f10x_md.o(RESET)
- EXTI9_5_IRQHandler from startup_stm32f10x_md.o(.text) referenced from startup_stm32f10x_md.o(RESET)
- FLASH_IRQHandler from startup_stm32f10x_md.o(.text) referenced from startup_stm32f10x_md.o(RESET)
- HardFault_Handler from startup_stm32f10x_md.o(.text) referenced from startup_stm32f10x_md.o(RESET)
- I2C1_ER_IRQHandler from startup_stm32f10x_md.o(.text) referenced from startup_stm32f10x_md.o(RESET)
- I2C1_EV_IRQHandler from startup_stm32f10x_md.o(.text) referenced from startup_stm32f10x_md.o(RESET)
- I2C2_ER_IRQHandler from startup_stm32f10x_md.o(.text) referenced from startup_stm32f10x_md.o(RESET)
- I2C2_EV_IRQHandler from startup_stm32f10x_md.o(.text) referenced from startup_stm32f10x_md.o(RESET)
- MemManage_Handler from startup_stm32f10x_md.o(.text) referenced from startup_stm32f10x_md.o(RESET)
- NMI_Handler from startup_stm32f10x_md.o(.text) referenced from startup_stm32f10x_md.o(RESET)
- PVD_IRQHandler from startup_stm32f10x_md.o(.text) referenced from startup_stm32f10x_md.o(RESET)
- PendSV_Handler from startup_stm32f10x_md.o(.text) referenced from startup_stm32f10x_md.o(RESET)
- RCC_IRQHandler from startup_stm32f10x_md.o(.text) referenced from startup_stm32f10x_md.o(RESET)
- RTCAlarm_IRQHandler from startup_stm32f10x_md.o(.text) referenced from startup_stm32f10x_md.o(RESET)
- RTC_IRQHandler from startup_stm32f10x_md.o(.text) referenced from startup_stm32f10x_md.o(RESET)
- Reset_Handler from startup_stm32f10x_md.o(.text) referenced from startup_stm32f10x_md.o(RESET)
- SPI1_IRQHandler from startup_stm32f10x_md.o(.text) referenced from startup_stm32f10x_md.o(RESET)
- SPI2_IRQHandler from startup_stm32f10x_md.o(.text) referenced from startup_stm32f10x_md.o(RESET)
- SVC_Handler from startup_stm32f10x_md.o(.text) referenced from startup_stm32f10x_md.o(RESET)
- SysTick_Handler from startup_stm32f10x_md.o(.text) referenced from startup_stm32f10x_md.o(RESET)
- SystemInit from system_stm32f10x.o(i.SystemInit) referenced from startup_stm32f10x_md.o(.text)
- TAMPER_IRQHandler from startup_stm32f10x_md.o(.text) referenced from startup_stm32f10x_md.o(RESET)
- TIM1_BRK_IRQHandler from startup_stm32f10x_md.o(.text) referenced from startup_stm32f10x_md.o(RESET)
- TIM1_CC_IRQHandler from startup_stm32f10x_md.o(.text) referenced from startup_stm32f10x_md.o(RESET)
- TIM1_TRG_COM_IRQHandler from startup_stm32f10x_md.o(.text) referenced from startup_stm32f10x_md.o(RESET)
- TIM1_UP_IRQHandler from startup_stm32f10x_md.o(.text) referenced from startup_stm32f10x_md.o(RESET)
- TIM2_IRQHandler from startup_stm32f10x_md.o(.text) referenced from startup_stm32f10x_md.o(RESET)
- TIM3_IRQHandler from startup_stm32f10x_md.o(.text) referenced from startup_stm32f10x_md.o(RESET)
- TIM4_IRQHandler from startup_stm32f10x_md.o(.text) referenced from startup_stm32f10x_md.o(RESET)
- USART1_IRQHandler from startup_stm32f10x_md.o(.text) referenced from startup_stm32f10x_md.o(RESET)
- USART2_IRQHandler from startup_stm32f10x_md.o(.text) referenced from startup_stm32f10x_md.o(RESET)
- USART3_IRQHandler from startup_stm32f10x_md.o(.text) referenced from startup_stm32f10x_md.o(RESET)
- USBWakeUp_IRQHandler from startup_stm32f10x_md.o(.text) referenced from startup_stm32f10x_md.o(RESET)
- USB_HP_CAN1_TX_IRQHandler from startup_stm32f10x_md.o(.text) referenced from startup_stm32f10x_md.o(RESET)
- USB_LP_CAN1_RX0_IRQHandler from startup_stm32f10x_md.o(.text) referenced from startup_stm32f10x_md.o(RESET)
- UsageFault_Handler from startup_stm32f10x_md.o(.text) referenced from startup_stm32f10x_md.o(RESET)
- WWDG_IRQHandler from startup_stm32f10x_md.o(.text) referenced from startup_stm32f10x_md.o(RESET)
- __main from __main.o(!!!main) referenced from startup_stm32f10x_md.o(.text)

### Global Symbols

__main (Thumb, 8 bytes, Stack size 0 bytes, __main.o(!!!main))

[Calls]

- >> __scatterload
- >> __rt_entry

__scatterload (Thumb, 0 bytes, Stack size unknown bytes, __scatter.o(!!!scatter))

[Called By]

- >> __main

__scatterload_rt2 (Thumb, 44 bytes, Stack size unknown bytes, __scatter.o(!!!scatter), UNUSED)

[Calls]

- >> __rt_entry

__scatterload_rt2_thumb_only (Thumb, 0 bytes, Stack size unknown bytes, __scatter.o(!!!scatter), UNUSED)

__scatterload_null (Thumb, 0 bytes, Stack size unknown bytes, __scatter.o(!!!scatter), UNUSED)

__scatterload_copy (Thumb, 26 bytes, Stack size unknown bytes, __scatter_copy.o(!!handler_copy), UNUSED)

[Calls]

- >> __scatterload_copy

[Called By]

- >> __scatterload_copy

__scatterload_zeroinit (Thumb, 28 bytes, Stack size unknown bytes, __scatter_zi.o(!!handler_zi), UNUSED)

__rt_lib_init (Thumb, 0 bytes, Stack size unknown bytes, libinit.o(.ARM.Collect$$libinit$$00000000))

[Called By]

- >> __rt_entry_li

__rt_lib_init_alloca_1 (Thumb, 0 bytes, Stack size unknown bytes, libinit2.o(.ARM.Collect$$libinit$$0000002E))

__rt_lib_init_argv_1 (Thumb, 0 bytes, Stack size unknown bytes, libinit2.o(.ARM.Collect$$libinit$$0000002C))

__rt_lib_init_atexit_1 (Thumb, 0 bytes, Stack size unknown bytes, libinit2.o(.ARM.Collect$$libinit$$0000001B))

__rt_lib_init_clock_1 (Thumb, 0 bytes, Stack size unknown bytes, libinit2.o(.ARM.Collect$$libinit$$00000021))

__rt_lib_init_cpp_1 (Thumb, 0 bytes, Stack size unknown bytes, libinit2.o(.ARM.Collect$$libinit$$00000032))

__rt_lib_init_exceptions_1 (Thumb, 0 bytes, Stack size unknown bytes, libinit2.o(.ARM.Collect$$libinit$$00000030))

__rt_lib_init_fp_1 (Thumb, 0 bytes, Stack size unknown bytes, libinit2.o(.ARM.Collect$$libinit$$00000002))

__rt_lib_init_fp_trap_1 (Thumb, 0 bytes, Stack size unknown bytes, libinit2.o(.ARM.Collect$$libinit$$0000001F))

__rt_lib_init_getenv_1 (Thumb, 0 bytes, Stack size unknown bytes, libinit2.o(.ARM.Collect$$libinit$$00000023))

__rt_lib_init_heap_1 (Thumb, 0 bytes, Stack size unknown bytes, libinit2.o(.ARM.Collect$$libinit$$0000000A))

__rt_lib_init_lc_collate_1 (Thumb, 0 bytes, Stack size unknown bytes, libinit2.o(.ARM.Collect$$libinit$$00000011))

__rt_lib_init_lc_ctype_1 (Thumb, 0 bytes, Stack size unknown bytes, libinit2.o(.ARM.Collect$$libinit$$00000013))

__rt_lib_init_lc_monetary_1 (Thumb, 0 bytes, Stack size unknown bytes, libinit2.o(.ARM.Collect$$libinit$$00000015))

__rt_lib_init_lc_numeric_1 (Thumb, 0 bytes, Stack size unknown bytes, libinit2.o(.ARM.Collect$$libinit$$00000017))

__rt_lib_init_lc_time_1 (Thumb, 0 bytes, Stack size unknown bytes, libinit2.o(.ARM.Collect$$libinit$$00000019))

__rt_lib_init_preinit_1 (Thumb, 0 bytes, Stack size unknown bytes, libinit2.o(.ARM.Collect$$libinit$$00000004))

__rt_lib_init_rand_1 (Thumb, 0 bytes, Stack size unknown bytes, libinit2.o(.ARM.Collect$$libinit$$0000000E))

__rt_lib_init_return (Thumb, 0 bytes, Stack size unknown bytes, libinit2.o(.ARM.Collect$$libinit$$00000033))

__rt_lib_init_signal_1 (Thumb, 0 bytes, Stack size unknown bytes, libinit2.o(.ARM.Collect$$libinit$$0000001D))

__rt_lib_init_stdio_1 (Thumb, 0 bytes, Stack size unknown bytes, libinit2.o(.ARM.Collect$$libinit$$00000025))

__rt_lib_init_user_alloc_1 (Thumb, 0 bytes, Stack size unknown bytes, libinit2.o(.ARM.Collect$$libinit$$0000000C))

__rt_lib_shutdown (Thumb, 0 bytes, Stack size unknown bytes, libshutdown.o(.ARM.Collect$$libshutdown$$00000000))

[Called By]

- >> __rt_exit_ls

__rt_lib_shutdown_cpp_1 (Thumb, 0 bytes, Stack size unknown bytes, libshutdown2.o(.ARM.Collect$$libshutdown$$00000002))

__rt_lib_shutdown_fp_trap_1 (Thumb, 0 bytes, Stack size unknown bytes, libshutdown2.o(.ARM.Collect$$libshutdown$$00000007))

__rt_lib_shutdown_heap_1 (Thumb, 0 bytes, Stack size unknown bytes, libshutdown2.o(.ARM.Collect$$libshutdown$$0000000F))

__rt_lib_shutdown_return (Thumb, 0 bytes, Stack size unknown bytes, libshutdown2.o(.ARM.Collect$$libshutdown$$00000010))

__rt_lib_shutdown_signal_1 (Thumb, 0 bytes, Stack size unknown bytes, libshutdown2.o(.ARM.Collect$$libshutdown$$0000000A))

__rt_lib_shutdown_stdio_1 (Thumb, 0 bytes, Stack size unknown bytes, libshutdown2.o(.ARM.Collect$$libshutdown$$00000004))

__rt_lib_shutdown_user_alloc_1 (Thumb, 0 bytes, Stack size unknown bytes, libshutdown2.o(.ARM.Collect$$libshutdown$$0000000C))

__rt_entry (Thumb, 0 bytes, Stack size unknown bytes, __rtentry.o(.ARM.Collect$$rtentry$$00000000))

[Called By]

- >> __scatterload_rt2
- >> __main

__rt_entry_presh_1 (Thumb, 0 bytes, Stack size unknown bytes, __rtentry2.o(.ARM.Collect$$rtentry$$00000002))

__rt_entry_sh (Thumb, 0 bytes, Stack size unknown bytes, __rtentry4.o(.ARM.Collect$$rtentry$$00000004))

[Stack]

- Max Depth = 8 + Unknown Stack Size
- Call Chain = __rt_entry_sh ⇒ __user_setup_stackheap

[Calls]

- >> __user_setup_stackheap

__rt_entry_li (Thumb, 0 bytes, Stack size unknown bytes, __rtentry2.o(.ARM.Collect$$rtentry$$0000000A))

[Calls]

- >> __rt_lib_init

__rt_entry_postsh_1 (Thumb, 0 bytes, Stack size unknown bytes, __rtentry2.o(.ARM.Collect$$rtentry$$00000009))

__rt_entry_main (Thumb, 0 bytes, Stack size unknown bytes, __rtentry2.o(.ARM.Collect$$rtentry$$0000000D))

[Stack]

- Max Depth = 40 + Unknown Stack Size
- Call Chain = __rt_entry_main ⇒ main ⇒ display_char16_16 ⇒ TFT_SEND_DATA

[Calls]

- >> exit
- >> main

__rt_entry_postli_1 (Thumb, 0 bytes, Stack size unknown bytes, __rtentry2.o(.ARM.Collect$$rtentry$$0000000C))

__rt_exit (Thumb, 0 bytes, Stack size unknown bytes, rtexit.o(.ARM.Collect$$rtexit$$00000000))

[Called By]

- >> exit

__rt_exit_ls (Thumb, 0 bytes, Stack size unknown bytes, rtexit2.o(.ARM.Collect$$rtexit$$00000003))

[Calls]

- >> __rt_lib_shutdown

__rt_exit_prels_1 (Thumb, 0 bytes, Stack size unknown bytes, rtexit2.o(.ARM.Collect$$rtexit$$00000002))

__rt_exit_exit (Thumb, 0 bytes, Stack size unknown bytes, rtexit2.o(.ARM.Collect$$rtexit$$00000004))

[Calls]

- >> _sys_exit

Reset_Handler (Thumb, 8 bytes, Stack size 0 bytes, startup_stm32f10x_md.o(.text))
[Address Reference Count : 1]

- startup_stm32f10x_md.o(RESET)

NMI_Handler (Thumb, 2 bytes, Stack size 0 bytes, startup_stm32f10x_md.o(.text))

[Calls]

- >> NMI_Handler

[Called By]

- >> NMI_Handler

[Address Reference Count : 1]

- startup_stm32f10x_md.o(RESET)

HardFault_Handler (Thumb, 2 bytes, Stack size 0 bytes, startup_stm32f10x_md.o(.text))

[Calls]

- >> HardFault_Handler

[Called By]

- >> HardFault_Handler

[Address Reference Count : 1]

- startup_stm32f10x_md.o(RESET)

MemManage_Handler (Thumb, 2 bytes, Stack size 0 bytes, startup_stm32f10x_md.o(.text))

[Calls]

- >> MemManage_Handler

[Called By]

- >> MemManage_Handler

[Address Reference Count : 1]

- startup_stm32f10x_md.o(RESET)

BusFault_Handler (Thumb, 2 bytes, Stack size 0 bytes, startup_stm32f10x_md.o(.text))

[Calls]

- >> BusFault_Handler

[Called By]

- >> BusFault_Handler

[Address Reference Count : 1]

- startup_stm32f10x_md.o(RESET)

UsageFault_Handler (Thumb, 2 bytes, Stack size 0 bytes, startup_stm32f10x_md.o(.text))

[Calls]

- >> UsageFault_Handler

[Called By]

- >> UsageFault_Handler

[Address Reference Count : 1]

- startup_stm32f10x_md.o(RESET)

SVC_Handler (Thumb, 2 bytes, Stack size 0 bytes, startup_stm32f10x_md.o(.text))

[Calls]

- >> SVC_Handler

[Called By]

- >> SVC_Handler

[Address Reference Count : 1]

- startup_stm32f10x_md.o(RESET)

DebugMon_Handler (Thumb, 2 bytes, Stack size 0 bytes, startup_stm32f10x_md.o(.text))

[Calls]

- >> DebugMon_Handler

[Called By]

- >> DebugMon_Handler

[Address Reference Count : 1]

- startup_stm32f10x_md.o(RESET)

PendSV_Handler (Thumb, 2 bytes, Stack size 0 bytes, startup_stm32f10x_md.o(.text))

[Calls]

- >> PendSV_Handler

[Called By]

- >> PendSV_Handler

[Address Reference Count : 1]

- startup_stm32f10x_md.o(RESET)

SysTick_Handler (Thumb, 2 bytes, Stack size 0 bytes, startup_stm32f10x_md.o(.text))

[Calls]

- >> SysTick_Handler

[Called By]

- >> SysTick_Handler

[Address Reference Count : 1]

- startup_stm32f10x_md.o(RESET)

ADC1_2_IRQHandler (Thumb, 0 bytes, Stack size 0 bytes, startup_stm32f10x_md.o(.text))

[Calls]

- >> ADC1_2_IRQHandler

[Called By]

- >> ADC1_2_IRQHandler

[Address Reference Count : 1]

- startup_stm32f10x_md.o(RESET)

CAN1_RX1_IRQHandler (Thumb, 0 bytes, Stack size 0 bytes, startup_stm32f10x_md.o(.text))
[Address Reference Count : 1]

- startup_stm32f10x_md.o(RESET)

CAN1_SCE_IRQHandler (Thumb, 0 bytes, Stack size 0 bytes, startup_stm32f10x_md.o(.text))
[Address Reference Count : 1]

- startup_stm32f10x_md.o(RESET)

DMA1_Channel1_IRQHandler (Thumb, 0 bytes, Stack size 0 bytes, startup_stm32f10x_md.o(.text))
[Address Reference Count : 1]

- startup_stm32f10x_md.o(RESET)

DMA1_Channel2_IRQHandler (Thumb, 0 bytes, Stack size 0 bytes, startup_stm32f10x_md.o(.text))
[Address Reference Count : 1]

- startup_stm32f10x_md.o(RESET)

DMA1_Channel3_IRQHandler (Thumb, 0 bytes, Stack size 0 bytes, startup_stm32f10x_md.o(.text))
[Address Reference Count : 1]

- startup_stm32f10x_md.o(RESET)

DMA1_Channel4_IRQHandler (Thumb, 0 bytes, Stack size 0 bytes, startup_stm32f10x_md.o(.text))
[Address Reference Count : 1]

- startup_stm32f10x_md.o(RESET)

DMA1_Channel5_IRQHandler (Thumb, 0 bytes, Stack size 0 bytes, startup_stm32f10x_md.o(.text))
[Address Reference Count : 1]

- startup_stm32f10x_md.o(RESET)

DMA1_Channel6_IRQHandler (Thumb, 0 bytes, Stack size 0 bytes, startup_stm32f10x_md.o(.text))
[Address Reference Count : 1]

- startup_stm32f10x_md.o(RESET)

DMA1_Channel7_IRQHandler (Thumb, 0 bytes, Stack size 0 bytes, startup_stm32f10x_md.o(.text))
[Address Reference Count : 1]

- startup_stm32f10x_md.o(RESET)

EXTI0_IRQHandler (Thumb, 0 bytes, Stack size 0 bytes, startup_stm32f10x_md.o(.text))
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
[Address Reference Count : 1]

- startup_stm32f10x_md.o(RESET)

USBWakeUp_IRQHandler (Thumb, 0 bytes, Stack size 0 bytes, startup_stm32f10x_md.o(.text))
[Address Reference Count : 1]

- startup_stm32f10x_md.o(RESET)

USB_HP_CAN1_TX_IRQHandler (Thumb, 0 bytes, Stack size 0 bytes, startup_stm32f10x_md.o(.text))
[Address Reference Count : 1]

- startup_stm32f10x_md.o(RESET)

USB_LP_CAN1_RX0_IRQHandler (Thumb, 0 bytes, Stack size 0 bytes, startup_stm32f10x_md.o(.text))
[Address Reference Count : 1]

- startup_stm32f10x_md.o(RESET)

WWDG_IRQHandler (Thumb, 0 bytes, Stack size 0 bytes, startup_stm32f10x_md.o(.text))
[Address Reference Count : 1]

- startup_stm32f10x_md.o(RESET)

__user_initial_stackheap (Thumb, 0 bytes, Stack size unknown bytes, startup_stm32f10x_md.o(.text))

[Called By]

- >> __user_setup_stackheap

__use_two_region_memory (Thumb, 2 bytes, Stack size 0 bytes, heapauxi.o(.text), UNUSED)

__rt_heap_escrow$2region (Thumb, 2 bytes, Stack size 0 bytes, heapauxi.o(.text), UNUSED)

__rt_heap_expand$2region (Thumb, 2 bytes, Stack size 0 bytes, heapauxi.o(.text), UNUSED)

__user_setup_stackheap (Thumb, 74 bytes, Stack size 8 bytes, sys_stackheap_outer.o(.text))

[Stack]

- Max Depth = 8 + Unknown Stack Size
- Call Chain = __user_setup_stackheap

[Calls]

- >> __user_perproc_libspace
- >> __user_initial_stackheap

[Called By]

- >> __rt_entry_sh

exit (Thumb, 18 bytes, Stack size 8 bytes, exit.o(.text))

[Stack]

- Max Depth = 8 + Unknown Stack Size
- Call Chain = exit

[Calls]

- >> __rt_exit

[Called By]

- >> __rt_entry_main

__user_libspace (Thumb, 8 bytes, Stack size 0 bytes, libspace.o(.text), UNUSED)

__user_perproc_libspace (Thumb, 0 bytes, Stack size 0 bytes, libspace.o(.text))

[Called By]

- >> __user_setup_stackheap

__user_perthread_libspace (Thumb, 0 bytes, Stack size 0 bytes, libspace.o(.text), UNUSED)

_sys_exit (Thumb, 8 bytes, Stack size 0 bytes, sys_exit.o(.text))

[Called By]

- >> __rt_exit_exit

__I$use$semihosting (Thumb, 0 bytes, Stack size 0 bytes, use_no_semi.o(.text), UNUSED)

__use_no_semihosting_swi (Thumb, 2 bytes, Stack size 0 bytes, use_no_semi.o(.text), UNUSED)

__semihosting_library_function (Thumb, 0 bytes, Stack size unknown bytes, indicate_semi.o(.text), UNUSED)

IO_init (Thumb, 70 bytes, Stack size 0 bytes, 2.0tftspi.o(i.IO_init))

[Called By]

- >> main

OLED_clear (Thumb, 110 bytes, Stack size 12 bytes, 2.0tftspi.o(i.OLED_clear))

[Stack]

- Max Depth = 20
- Call Chain = OLED_clear ⇒ TFT_SEND_DATA

[Calls]

- >> TFT_SEND_DATA
- >> TFT_SEND_CMD

[Called By]

- >> main

OLED_full (Thumb, 116 bytes, Stack size 16 bytes, 2.0tftspi.o(i.OLED_full))

[Stack]

- Max Depth = 24
- Call Chain = OLED_full ⇒ TFT_SEND_DATA

[Calls]

- >> TFT_SEND_DATA
- >> TFT_SEND_CMD

[Called By]

- >> main

OLED_init (Thumb, 488 bytes, Stack size 4 bytes, 2.0tftspi.o(i.OLED_init))

[Stack]

- Max Depth = 12
- Call Chain = OLED_init ⇒ TFT_SEND_DATA

[Calls]

- >> delay_ms
- >> TFT_SEND_DATA
- >> TFT_SEND_CMD

[Called By]

- >> main

Picture_display (Thumb, 116 bytes, Stack size 16 bytes, 2.0tftspi.o(i.Picture_display))

[Stack]

- Max Depth = 24
- Call Chain = Picture_display ⇒ TFT_SEND_DATA

[Calls]

- >> TFT_SEND_DATA
- >> TFT_SEND_CMD

[Called By]

- >> main

SPI_SendByte (Thumb, 56 bytes, Stack size 0 bytes, 2.0tftspi.o(i.SPI_SendByte))

[Called By]

- >> TFT_SEND_DATA
- >> TFT_SEND_CMD

SYS_init (Thumb, 196 bytes, Stack size 0 bytes, 2.0tftspi.o(i.SYS_init))

[Called By]

- >> main

SystemInit (Thumb, 78 bytes, Stack size 8 bytes, system_stm32f10x.o(i.SystemInit))

[Stack]

- Max Depth = 28
- Call Chain = SystemInit ⇒ SetSysClock ⇒ SetSysClockTo72

[Calls]

- >> SetSysClock

[Address Reference Count : 1]

- startup_stm32f10x_md.o(.text)

TFT_SEND_CMD (Thumb, 34 bytes, Stack size 8 bytes, 2.0tftspi.o(i.TFT_SEND_CMD))

[Stack]

- Max Depth = 8
- Call Chain = TFT_SEND_CMD

[Calls]

- >> SPI_SendByte

[Called By]

- >> display_char16_16
- >> Picture_display
- >> OLED_init
- >> OLED_full
- >> OLED_clear

TFT_SEND_DATA (Thumb, 34 bytes, Stack size 8 bytes, 2.0tftspi.o(i.TFT_SEND_DATA))

[Stack]

- Max Depth = 8
- Call Chain = TFT_SEND_DATA

[Calls]

- >> SPI_SendByte

[Called By]

- >> display_char16_16
- >> Picture_display
- >> OLED_init
- >> OLED_full
- >> OLED_clear

delay_ms (Thumb, 24 bytes, Stack size 0 bytes, 2.0tftspi.o(i.delay_ms))

[Called By]

- >> main
- >> OLED_init

display_char16_16 (Thumb, 190 bytes, Stack size 32 bytes, 2.0tftspi.o(i.display_char16_16))

[Stack]

- Max Depth = 40
- Call Chain = display_char16_16 ⇒ TFT_SEND_DATA

[Calls]

- >> TFT_SEND_DATA
- >> TFT_SEND_CMD

[Called By]

- >> main

main (Thumb, 280 bytes, Stack size 0 bytes, 2.0tftspi.o(i.main))

[Stack]

- Max Depth = 40
- Call Chain = main ⇒ display_char16_16 ⇒ TFT_SEND_DATA

[Calls]

- >> display_char16_16
- >> delay_ms
- >> SYS_init
- >> Picture_display
- >> OLED_init
- >> OLED_full
- >> OLED_clear
- >> IO_init

[Called By]

- >> __rt_entry_main

### Local Symbols

SetSysClock (Thumb, 8 bytes, Stack size 8 bytes, system_stm32f10x.o(i.SetSysClock))

[Stack]

- Max Depth = 20
- Call Chain = SetSysClock ⇒ SetSysClockTo72

[Calls]

- >> SetSysClockTo72

[Called By]

- >> SystemInit

SetSysClockTo72 (Thumb, 214 bytes, Stack size 12 bytes, system_stm32f10x.o(i.SetSysClockTo72))

[Stack]

- Max Depth = 12
- Call Chain = SetSysClockTo72

[Called By]

- >> SetSysClock

### Undefined Global Symbols
