sratle/WCH-Model-Terminal/docs/devboard/hardware/PCB_PCB26_2026-08-08.pdf

LED7 | LED8 | LED9 5V 3V³ | LD¹

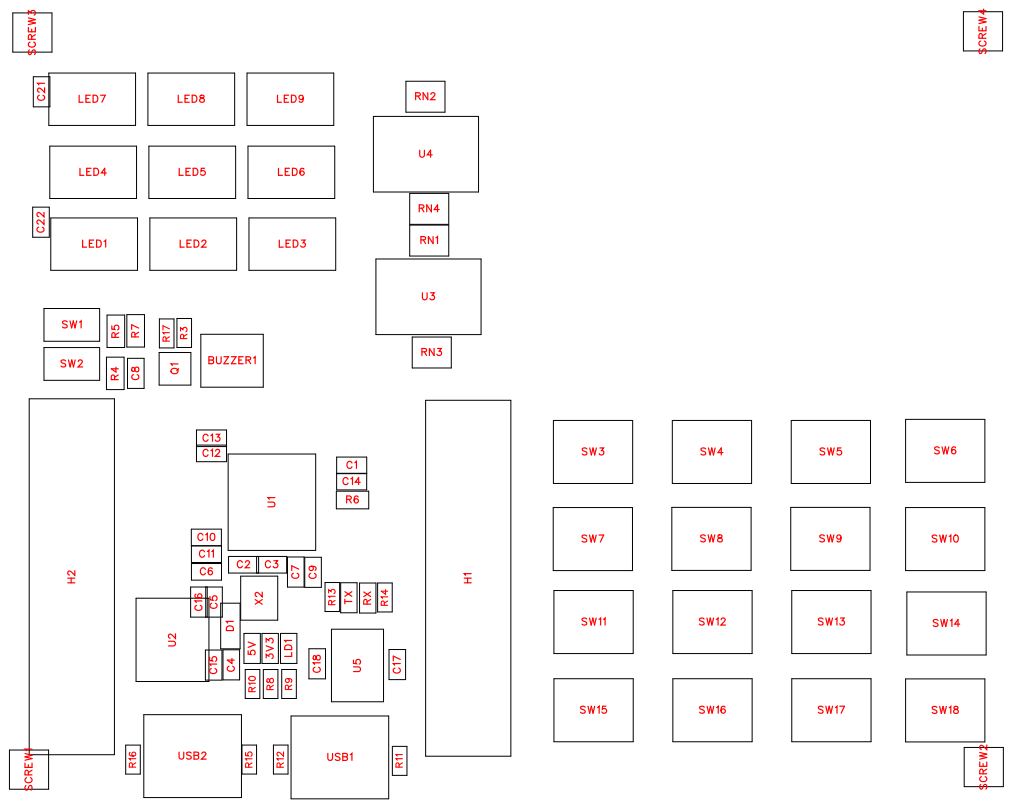
[picture p1: page 1]

FPC1
C19
C20

No. | Quantity | Comment | Designator | Footprint | Value | Manufacturer Part | Manufacturer | Supplier Part | Supplier
1 | 5 | LED_0603-B | 3V3,5V,LD1,RX,TX | LED_0603
2 | 1 | 4kHz | BUZZER1 | BUZ-SMD_L 5.0-W5.5-P4. 60 | 4kHz | MLT-5020 | 华能 | C94598 | LCSC
3 | 16 | 0.1uF | C1,C4,C5,C6,C7,C8,C9,C1 0,C11,C12,C13,C14,C19,C 20,C21,C22 | C0603
4 | 2 | 22pF | C2,C3 | C0603
5 | 2 | 1uF | C15,C16 | C0603
6 | 2 | 100nF | C17,C18 | C0603 | 100nF
7 | 1 | BZT52C3V3-E3-18 | D1 | SOD-123_L2 .7-W1.6-LS3. 7-RD-1 | | BZT52C3V3-E3-18 | VISHAY(威世 ) | C5224067 | LCSC
8 | 1 | FPC-05F-14 PH15 | FPC1 | FPC-SMD_1 4P-P0.50_X UNPU_FPC-05F-14PH15 | | FPC-05F-14 PH15 | XUNPU(讯普 ) | C2856818 | LCSC
9 | 2 | FG-PZ2.54-2 -14P-SMT | H1,H2 | HDR-SMD_2 8P-P2.54-V-M-R2-C14-L S7.5 | | FG-PZ2.54-2 -14P-SMT | FG(富港) | C55130829 | LCSC
10 | 9 | XL-5050RGB C-2812B | LED1,LED2,LED3,LED4,LE D5,LED6,LED7,LED8,LED9 | LED-SMD_4 P-L5.0-W5.0-BL_XL-5050 RGBC | | XL-5050RGB C-2812B | XINGLIGHT( 成兴光) | C2843785 | LCSC
11 | 1 | SS8550 | Q1 | SOT-23-3_L2 .9-W1.3-P1.9 0-LS2.4-BR | | SS8550 | 宏嘉诚 | C7420371 | LCSC
12 | 1 | 10K | R3 | R0603_2 | 10K
13 | 3 | 10K | R4,R6,R7 | 0603 | 10K
14 | 1 | 1K | R5 | 0603
15 | 2 | 1K | R8,R9 | R0603 | 1K
16 | 3 | 3K | R10,R13,R14 | R0603 | 3K
17 | 4 | 5.1K | R11,R12,R15,R16 | R0603 | 5.1K
18 | 1 | 1K | R17 | R0603_2 | 1K
19 | 4 | 10k | RN1,RN2,RN3,RN4 | RES-ARRAY -SMD_0603-8P-L3.2-W1. 6-BL | 10k | 4D03WGJ01 03T5E | UNI-ROYAL( 厚声) | C29718 | LCSC
20 | 4 | M2螺丝 | SCREW1,SCREW2,SCRE W3,SCREW4 | M2螺丝
21 | 2 | HX 3x4x2-2P -1.6N TACTILE SWITCH | SW1,SW2 | KEY-SMD_L 4.0-W3.0-LS 4.9-1 | | HX 3x4x2-2P -1.6N TACTILE SWITCH | hanxia(韩下) | C49234124 | LCSC

22 | 16 | KEYBOARD-SW | SW3,SW4,SW5,SW6,SW7, SW8,SW9,SW10,SW11,SW 12,SW13,SW14,SW15,SW1 6,SW17,SW18 | SW-SMD_L6 .1-W6.1-LS6. 7_YZA-069-5 .0
23 | 1 | CH32V307W | U1 | QFN68_8X8
24 | 1 | TLV1117LV3 3DCYR | U2 | SOT-223_L6. 7-W3.5-P2.3 0-BR | | TLV1117LV3 3DCYR | TI(德州仪器 ) | C15578 | LCSC
25 | 2 | 74HC165D,6 53 | U3,U4 | SOIC-16_L9. 9-W3.9-P1.2 7-LS6.0-BL | | 74HC165D,6 53 | Nexperia( 安 ) 世 | C5613 | LCSC
26 | 1 | CH340N | U5 | SOP-8_L4.9-W3.9-P1.27-LS6.0-BL | | CH340N | WCH(南京沁 恒) | C2977777 | LCSC
27 | 2 | TYPE-C 16PIN 2MD(073) | USB1,USB2 | USB-C-SMD _TYPE-C-6PI N-2MD-073 | | TYPE-C 16PIN 2MD(073) | SHOU HAN(首韩 ) | C2765186 | LCSC
28 | 1 | 8MHz | X2 | CRYSTAL-S MD_4P-L3.2-W2.5-BL | 8MHz | X322525MO B4SI | YXC(扬兴晶 振) | | LCSC

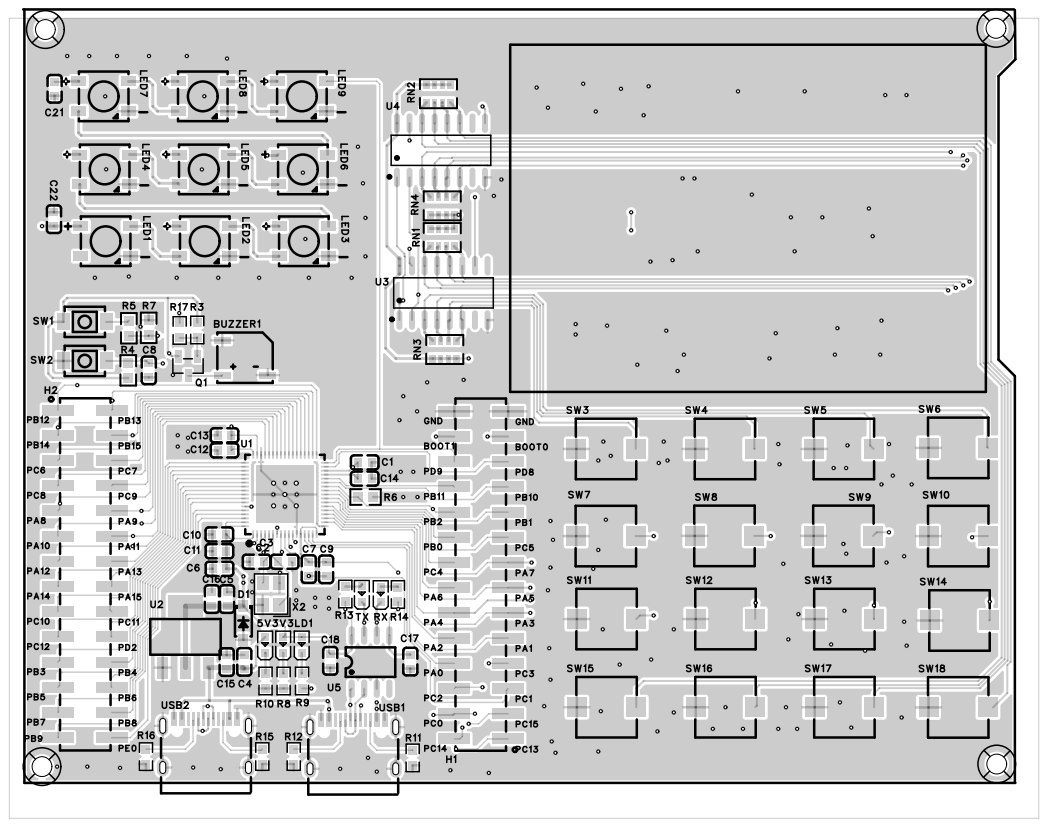
[picture p2: page 5]

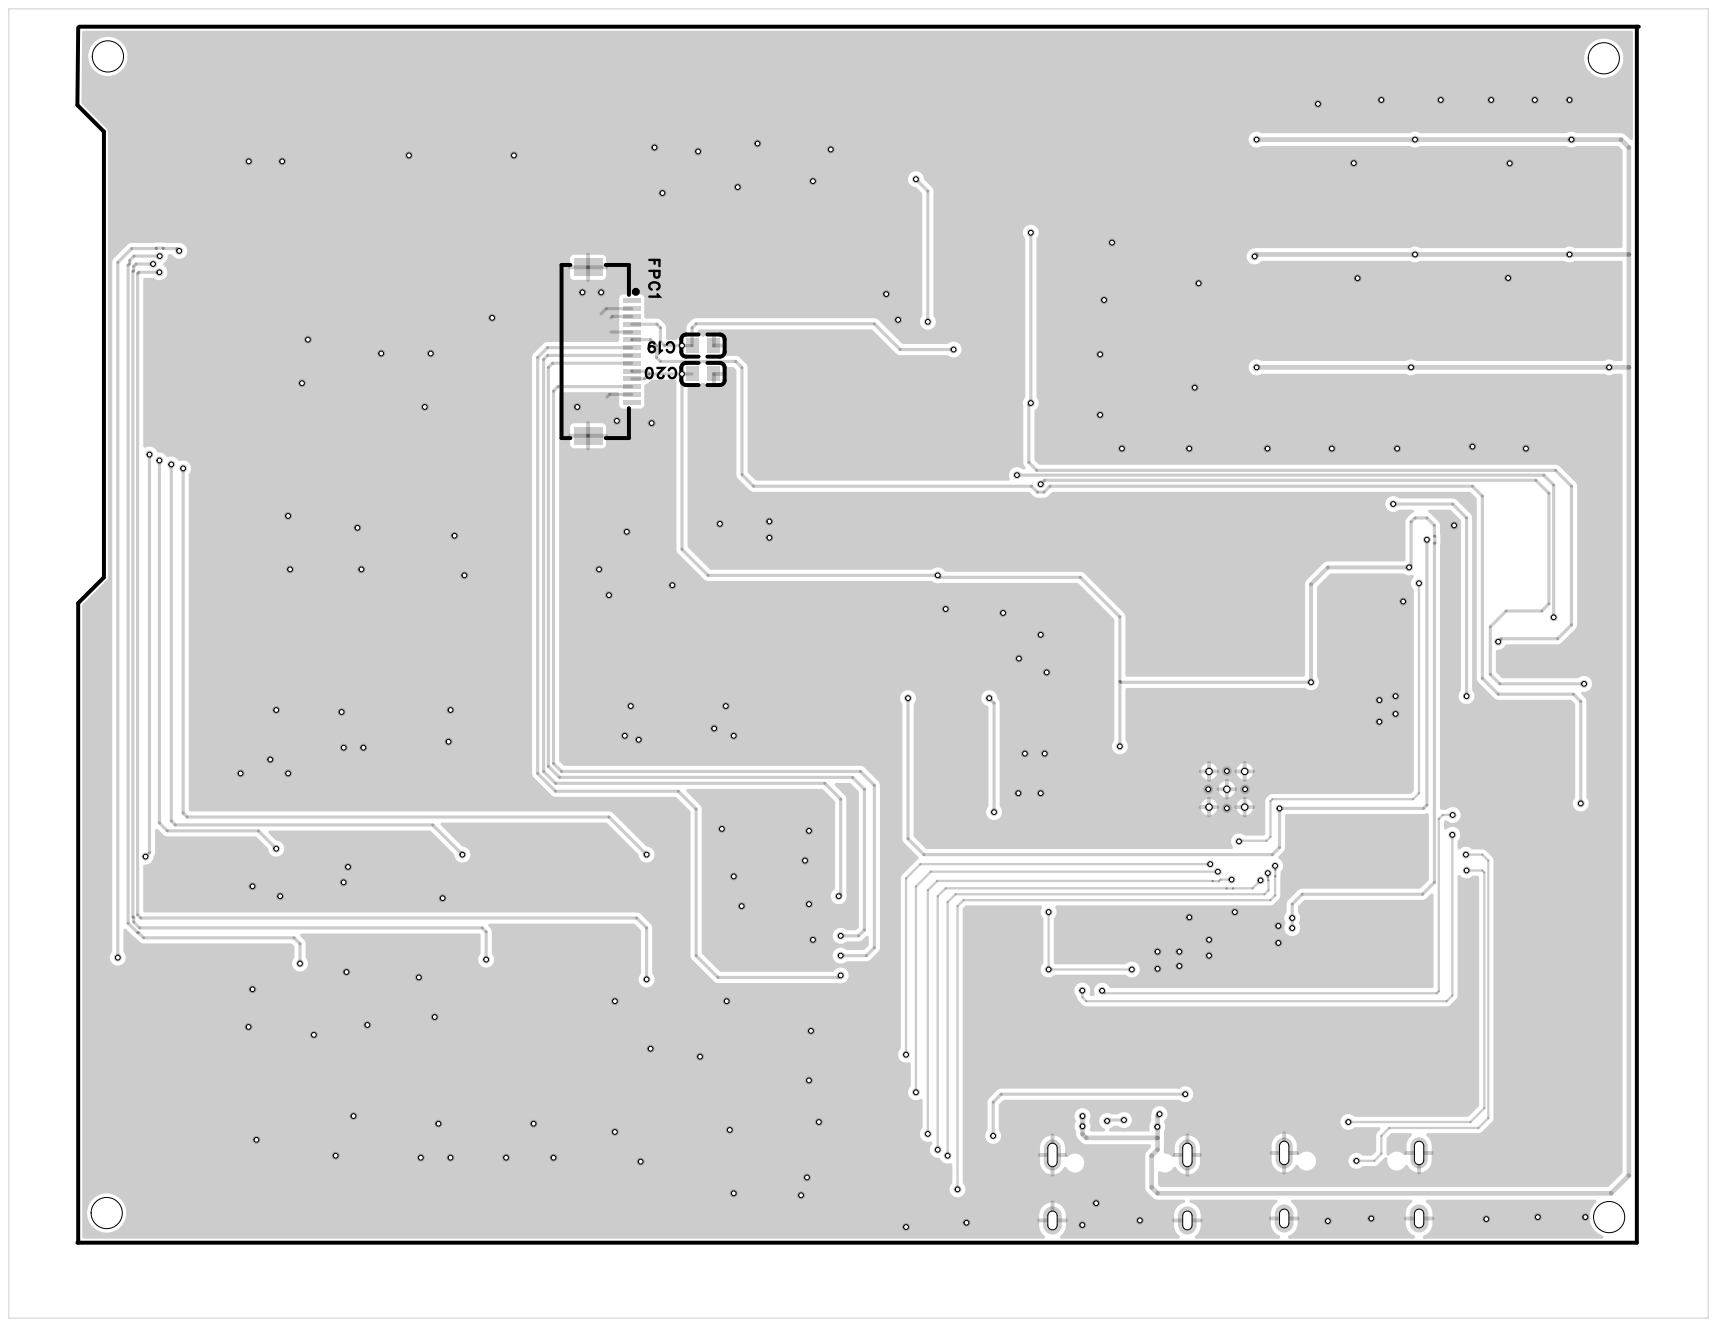
[picture p3: page 6]
