sratle/WCH-Model-Terminal/docs/datasheet/Epaper.md

# ZJY648480-0583AAAMFGN 电子纸显示模块技术规格书
**版本**：3.0  
**发布日期**：2022年07月13日  
**制造商**：郑州中景园电子技术有限公司  
**商城地址**：https://oled-zjy.taobao.com  
**联系电话**：18639000975  
**公司地址**：中国河南省郑州市高新技术产业开发区金盏街16号亿达科技新城9号楼302室

## 注意事项
1. 在基于本模块规格书设计产品前，请联系郑州中景园电子技术有限公司。
2. 本文档所含信息仅用于说明产品特性和性能。郑州中景园电子技术有限公司不对因使用本文档所述模块而产生的任何知识产权索赔或其他问题承担责任。

## 修订历史
| Rev | 日期 | 修改项 | 页码 | 备注 |
|-----|---|---|---|---|
| 1.0 | 2020.10.09 | 首次创建 | 全部 | |
| 2.0 | 2021.04.12 | 首次创建 | 全部 | |
| 3.0 | 2022.07.13 | 更新电子纸模块机械图纸<br>更新直流特性<br>更新光学规格<br>更新检验方法和条件<br>更新包装 | P5<br>P8<br>P36<br>P41-44<br>P45 | |

## 目录
1. 概述 -------------------------------------------------------------------------------(4)
2. 特性 -------------------------------------------------------------------------------(4)
3. 机械规格 ---------------------------------------------------------------------------(4)
4. 电子纸模块机械图纸 -----------------------------------------------------------------(5)
5. 输入/输出引脚定义 -----------------------------------------------------------------(6-7)
6. 电气特性 ---------------------------------------------------------------------------(7)
    6.1 绝对最大额定值 -------------------------------------------------------------(7)
    6.2 面板直流特性 ---------------------------------------------------------------(8)
    6.3 面板交流特性 ---------------------------------------------------------------(9-11)
    6.4 时序特性 -------------------------------------------------------------------(12-13)
7. 命令表 -----------------------------------------------------------------------------(14-35)
8. 光学规格 ---------------------------------------------------------------------------(36)
9. 操作、安全与环境要求 --------------------------------------------------------------(36)
10. 可靠性测试 -------------------------------------------------------------------------(37)
11. 典型SPI接口应用电路 ---------------------------------------------------------------(38)
12. 典型操作流程 ----------------------------------------------------------------------(39)
    12.1 正常操作流程 -------------------------------------------------------------(39)
    12.2 正常操作参考程序代码 -----------------------------------------------------(40)
13. 零件编号定义 ----------------------------------------------------------------------(41)
14. 检验方法和条件 --------------------------------------------------------------------(41)
    14.1 检验条件 -----------------------------------------------------------------(41)
    14.2 显示区域 -----------------------------------------------------------------(41)
    14.3 产品通用检验标准 ---------------------------------------------------------(42-44)
15. 包装 ------------------------------------------------------------------------------(45)

## 1. 概述
本显示器为TFT有源矩阵电泳显示器，集成了接口和参考系统设计。5.83英寸有效显示区域包含648×480像素，支持1位黑白全显示能力。每个面板均集成了栅极缓冲器、源极缓冲器、接口、时序控制逻辑、振荡器、DC-DC转换器、SRAM、LUT、VCOM和边框控制电路。

## 2. 特性
- 648×480像素分辨率
- 高对比度
- 高反射率
- 超宽视角
- 超低功耗
- 纯反射模式
- 双稳态显示
- 商用温度范围
- 支持横屏/竖屏模式
- 硬涂层防眩光显示表面
- 超低电流深度睡眠模式
- 片上显示RAM
- 波形可存储在片上OTP或由MCU写入
- 支持串行外设接口(SPI)
- 片上振荡器
- 片上升压和调节器控制，用于生成VCOM、栅极和源极驱动电压
- I2C信号主接口，用于读取外部温度传感器
- 内置温度传感器

## 3. 机械规格
| 参数 | 规格 | 单位 | 备注 |
|---|---|---|---|
| 屏幕尺寸 | 5.83 | Inch | |
| 显示分辨率 | 648(H)×480(V) | Pixel | Dpi:138 |
| 有效显示区域 | 118.78×88.22 | mm | |
| 像素间距 | 0.1833×0.1833 | mm | |
| 像素形状 | 矩形 | | |
| 外形尺寸 | 125.4(H)×99.5(V)×1.20(D) | mm | |
| 重量 | 28.6±0.5 | g | |

## 4. 电子纸模块机械图纸
**单位：mm**
- 整体尺寸：125.40±0.20(H) × 99.50±0.20(V)
- 有效显示区域：118.78(A.A) × 88.22(A.A)
- 其他关键尺寸：
  - 24.00±0.3
  - 6.00±0.30
  - 57.43±0.30
  - 55.47
  - 3.30
  - 0.30±0.03

## 5. 输入/输出引脚定义
**引脚类型说明**：I=输入引脚，O=输出引脚，I/O=双向引脚，P=电源引脚，C=电容引脚

| 引脚号 | 名称 | I/O | 描述 | 备注 |
|---|---|-----|---|---|
| 1 | NC | - | 不与其他NC引脚连接 | 保持开路 |
| 2 | GDR | O | N沟道MOSFET栅极驱动控制 | |
| 3 | RESE | I | 控制环路电流检测输入 | |
| 4 | NC | - | 不与其他NC引脚连接 | 保持开路 |
| 5 | VSH2 | C | 正源极驱动电压(红色) | |
| 6 | TSCL | O | I2C时钟(需外部上拉电阻，未使用时开路) | |
| 7 | TSDA | I/O | I2C数据(需外部上拉电阻，未使用时开路) | |
| 8 | BS1 | I | 总线接口选择引脚 | 注5-5 |
| 9 | BUSY | O | 忙状态输出引脚 | 注5-4 |
| 10 | RES# | I | 复位信号输入，低电平有效 | 注5-3 |
| 11 | D/C# | I | 数据/命令控制引脚 | 注5-2 |
| 12 | CS# | I | 片选输入引脚 | 注5-1 |
| 13 | SCL | I | 串行时钟引脚(SPI) | |
| 14 | SDA | I/O | 串行数据引脚(SPI) | |
| 15 | VDDIO | P | 接口逻辑引脚电源，应与VCI连接 | |
| 16 | VCI | P | 芯片电源 | |
| 17 | VSS | P | 地 | |
| 18 | VDD | C | 核心逻辑电源引脚，可由VCI内部调节，需在VDD与VSS间接电容 | |
| 19 | VPP | P | 测试用 | |
| 20 | VSH1 | C | 正源极驱动电压 | |
| 21 | VGH | C | 正栅极驱动电压和VSH1电源引脚 | |
| 22 | VSL | C | 负源极驱动电压 | |
| 23 | VGL | C | 负栅极驱动电压、VCOM和VSL电源引脚 | |
| 24 | VCOM | C | VCOM驱动电压 | |

### 引脚说明备注
- **注5-1**：CS#为连接MCU的片选输入，仅当CS#拉低时，芯片才允许与MCU通信。
- **注5-2**：D/C#为4线SPI模式下连接MCU的数据/命令控制引脚。引脚为高电平时，SDA上的数据被解释为数据；引脚为低电平时，被解释为命令。
- **注5-3**：RES#为复位信号输入，低电平有效。
- **注5-4**：BUSY为忙状态输出引脚。当BUSY为高电平时，不应中断芯片操作，不应发送命令。芯片在以下情况会将BUSY引脚置高：输出显示波形、与数字温度传感器通信。
- **注5-5**：总线接口选择

| BS1状态 | MCU接口 |
|---|---|
| L | 4线串行外设接口(SPI)-8位SPI |
| H | 3线串行外设接口(SPI)-9位SPI |

## 6. 电气特性
### 6.1 绝对最大额定值
| 参数 | 符号 | 额定值 | 单位 |
|---|---|---|---|
| 逻辑电源电压 | VCI | -0.3 ~ +6.0 | V |
| 逻辑输入电压 | VIN | -0.3 ~ VCI+0.3 | V |
| 工作温度范围 | TOPR | 0 ~ +50 | ℃ |
| 存储温度范围 | TSTG | -25 ~ +70 | ℃ |
| 最佳存储温度 | TSTGo | 23±2 | ℃ |
| 最佳存储湿度 | HSTGo | 55±10 | %RH |

**注意**：超过最大额定值可能导致器件损坏。功能操作应限制在面板直流特性表规定的范围内。

### 6.2 面板直流特性
**测试条件**：VSS=0V，VCI=3.3V

| 参数 | 符号 | 条件 | 适用引脚 | 最小值 | 典型值 | 最大值 | 单位 |
|---|---|---|---|---|---|---|---|
| 单端地 | VSS | - | - | - | 0 | - | V |
| 逻辑电源电压 | VCI | - | VCI | 2.3 | 3.3 | 3.6 | V |
| 核心逻辑电压 | VDD | - | VDD | 2.3 | 3.3 | 3.6 | V |
| 高电平输入电压 | VIH | - | - | 0.7VCI | - | VCI | V |
| 低电平输入电压 | VIL | - | - | 0 | - | 0.3VCI | V |
| 高电平输出电压 | VOH | IOH=-400uA | - | VCI-0.4 | - | - | V |
| 低电平输出电压 | VOL | IOL=400uA | - | 0 | - | 0.4 | V |
| 典型功耗 | PTYP | - | - | - | 21.45 | - | mW |
| 深度睡眠模式功耗 | PSTPY | - | - | - | 0.003 | - | mW |
| 典型工作电流 | Iopr_VCI | - | - | - | 6.5 | - | mA |
| 图像更新时间 | - | 25℃ | - | - | 4 | - | sec |
| 睡眠模式电流 | Islp_VCI | DC/DC关闭，无时钟，无输入负载，RAM数据保留 | - | - | 30 | - | uA |
| 深度睡眠模式电流 | Idslp_VCI | DC/DC关闭，无时钟，无输入负载，RAM数据不保留 | - | - | 1 | - | uA |

### 备注
1. 典型功耗是在从水平2阶图案切换到垂直2阶图案时测量的。
2. 深度睡眠功耗是面板控制器处于深度睡眠模式时的功耗。
3. 所列电气/光学特性仅在中景园提供的控制器和波形下保证。

### 6.3 面板交流特性
#### 6.3.1 MCU接口选择
提供3线/4线串行接口，用于从MCU传输命令和显示数据。串行接口支持8位模式。芯片激活(CSB=低)时，可通过时钟输入/输出数据。输入时，数据在时钟上升沿从MSB开始写入。输入过多参数时，芯片仅接受定义的参数，忽略未定义的参数。

| BS | 接口 | CSB | DC | SCL | SDA |
|----|---|---|---|---|---|
| 高 | 3线SPI | 可用 | 接地 | 可用 | 可用 |
| 低 | 4线SPI | 可用 | 可用 | 可用 | 可用 |

#### 6.3.2 3线SPI格式
数据/命令通过传输的第一位识别。数据以9位为单位传输。为防止噪声导致故障，建议每9位将CSB信号置高(CSB信号上升沿复位串行计数器)。
- **写操作**：依次传输命令、第一个参数、最后一个参数
- **读操作**：若SDA上第一个输入数据为高，SDA引脚将在第一个SCL下降沿后输出数据的MSB位

#### 6.3.3 4线SPI格式
数据/命令通过DC引脚识别。数据以8位为单位传输。为防止噪声导致故障，建议每8位将CSB信号置高(CSB信号上升沿复位串行计数器)。
- **写操作**：依次传输命令、第一个参数、最后一个参数
- **读操作**：若DC引脚为高，SDA引脚将在CSB下降沿后输出数据的MSB位

#### 6.3.4 3线双SPI格式
数据/命令通过SDA上传输的第一位识别。数据以5个SPI时钟为单位传输。为防止噪声导致故障，建议每5个SPI时钟将CSB信号置高(CSB信号上升沿复位串行计数器)。在3线双SPI模式下，SDA和SDA1仅用于数据写传输的输入模式。

#### 6.3.5 4线双SPI格式
数据/命令通过DC引脚识别。数据以4个SPI时钟为单位传输。为防止噪声导致故障，建议每4个SPI时钟将CSB信号置高(CSB信号上升沿复位串行计数器)。在4线双SPI模式下，SDA和SDA1仅用于数据写传输的输入模式。

### 6.4 时序特性
#### 3线串行接口特性(写模式)
| 符号 | 信号/参数 | 最小值 | 单位 |
|---|---|---|---|
| Tcss | 片选建立时间 | 60 | ns |
| TcSH | 片选保持时间 | 65 | ns |
| Tscc | 片选建立时间 | 20 | ns |
| TCHW | 片选建立时间 | 40 | ns |
| TscYcW | 串行时钟周期(写) | 100 | ns |
| TSHW | SCL高电平脉冲宽度(写) | 35 | ns |
| TSLW | SCL低电平脉冲宽度(写) | 35 | ns |
| TsDs | SDA(DIN)数据建立时间 | 30 | ns |
| TSDH | SDA(DIN)数据保持时间 | 30 | ns |

#### 3线串行接口特性(读模式)
| 符号 | 信号/参数 | 最小值 | 最大值 | 单位 |
|---|---|---|---|---|
| Tcss | 片选建立时间 | 60 | | ns |
| TcSH | 片选保持时间 | 65 | | ns |
| Tscc | 片选建立时间 | 20 | | ns |
| TCHW | 片选建立时间 | 40 | | ns |
| TSCYCR | 串行时钟周期(读) | 230 | | ns |
| TSHR | SCL高电平脉冲宽度(读) | 60 | | ns |
| TSLR | SCL低电平脉冲宽度(读) | 60 | | ns |
| TACC | SDA(DOUT)访问时间 | | 230 | ns |
| TOH | SDA(DOUT)输出禁用时间 | 15 | | ns |

#### 4线串行接口特性(写模式)
| 符号 | 信号/参数 | 最小值 | 单位 |
|---|---|---|---|
| Tcss | CSB片选建立时间 | 60 | ns |
| TCSH | 片选保持时间 | 65 | ns |
| Tscc | 片选建立时间 | 20 | ns |
| TCHW | 片选建立时间 | 40 | ns |
| TSCYCW | SCL串行时钟周期(写) | 100 | ns |
| TSHW | SCL高电平脉冲宽度(写) | 35 | ns |
| TSLW | SCL低电平脉冲宽度(写) | 35 | ns |
| TDocs | DC建立时间 | 30 | ns |
| TDCH | DC保持时间 | 30 | ns |
| TsDs | SDA(DIN)数据建立时间 | 30 | ns |
| TSDH | SDA(DIN)数据保持时间 | 30 | ns |

#### 4线串行接口特性(读模式)
| 符号 | 信号/参数 | 最小值 | 最大值 | 单位 |
|---|---|---|---|---|
| Tcss | CSB片选建立时间 | 60 | | ns |
| TCSH | 片选保持时间 | 65 | | ns |
| Tscc | 片选建立时间 | 20 | | ns |
| TCHW | 片选建立时间 | 40 | | ns |
| TSCYCR | SCL串行时钟周期(读) | 230 | | ns |
| TSHR | SCL高电平脉冲宽度(读) | 60 | | ns |
| TSLR | SCL低电平脉冲宽度(读) | 60 | | ns |
| TDocs | DC建立时间 | 30 | | ns |
| TDCH | DC保持时间 | 30 | | ns |
| TACC | SDA(DOUT)访问时间 | | 230 | ns |
| TOH | SDA(DOUT)输出禁用时间 | 15 | | ns |

## 7. 命令表
**说明**：W/R: 0=写周期，1=读周期；C/D: 0=命令，1=数据；D7-D0: -=无关，#=有效数据

| 序号 | 命令 | W/R | C/D | D7-D0 | 寄存器 | 默认值 |
|---|---|-----|-----|---|---|---|
| 1 | 面板设置(PSR) | 0 | 0 | 00000000 | R00H | 00H |
| | | 0 | 1 | REG KW/R UD SHL SHD_N RST_N | | 0FH |
| 2 | 电源设置(PWR) | 0 | 0 | 00000001 | R01H | 01H |
| | | 0 | 1 | - BD_EN - VSR_EN VS_EN VG_EN | | 07H |
| | | 0 | 1 | VCOM_SLEW - VG_LVL[2:0] | | 17H |
| | | 0 | 1 | VDH_LVL[5:0] | | 3AH |
| | | 0 | 1 | VDL_LVL[5:0] | | 3AH |
| | | 0 | 1 | VDHR_LVL[5:0] | | 03H |
| 3 | 电源关闭(POF) | 0 | 0 | 00000010 | R02H | 02H |
| 4 | 电源关闭序列设置(PFS) | 0 | 0 | 00000011 | R03H | 03H |
| | | 0 | 1 | T_VDS_OFF[1:0] | | 00H |
| 5 | 电源开启(PON) | 0 | 0 | 00000100 | R04H | 04H |
| 6 | 电源开启测量(PMES) | 0 | 0 | 00000101 | R05H | 05H |
| 7 | 升压软启动(BTST) | 0 | 0 | 00000110 | R06H | 06H |
| | | 0 | 1 | BT_PHA[7:0] | | 17H |
| | | 0 | 1 | BT_PHB[7:0] | | 17H |
| | | 0 | 1 | BT_PHC1[5:0] | | 17H |
| | | 0 | 1 | PHC2_EN BT_PHC2[5:0] | | 17H |
| 8 | 深度睡眠(DSLP) | 0 | 0 | 00000111 | R07H | 07H |
| | | 0 | 1 | 10100101(校验码) | | A5H |
| 9 | 显示开始传输1(DTM1，白/黑数据) | 0 | 0 | 00010000 | R10H | 10H |
| | | 0 | 1 | KPXL[1:8]~KPXL[n-7:n] | | - |
| 10 | 数据停止(DSP) | 0 | 0 | 00010001 | R11H | 11H |
| | | 1 | 1 | data_flag | | 00H |
| 11 | 显示刷新(DRF) | 0 | 0 | 00010010 | R12H | 12H |
| 12 | 显示开始传输2(DTM2，红数据) | 0 | 0 | 00010011 | R13H | 13H |
| | | 0 | 1 | RPXL[1:8]~RPXL[n-7:n] | | - |
| 13 | 双SPI模式(DUSPI) | 0 | 0 | 00010101 | R15H | 15H |
| | | 1 | 1 | MM_EN DUSPI_EN | | 00H |
| 14 | 自动序列(AUTO) | 0 | 0 | 00010111 | R17H | 17H |
| | | 0 | 1 | 10100101(校验码) | | A5H |
| 15 | VCOM查找表(LUTC，61字节命令) | 0 | 0 | 00100000 | R20H | 20H |
| | | 0 | 1 | 电平选择0~3、帧数0~3、重复次数 | | - |
| 16 | 白到白查找表(LUTWW，43字节命令) | 0 | 0 | 00100001 | R21H | 21H |
| | | 0 | 1 | 电平选择0~3、帧数0~3、重复次数 | | - |
| 17 | 黑到白/红色查找表(LUTKW/LUTR，61字节) | 0 | 0 | 00100010 | R22H | 22H |
| | | 0 | 1 | 电平选择0~3、帧数0~3、重复次数 | | - |
| 18 | 白到黑查找表(LUTWK/LUTW) | 0 | 0 | 00100011 | R23H | 23H |
| 19 | 黑到黑查找表(LUTKK/LUTK) | 0 | 0 | 00100100 | R24H | 24H |
| 20 | 边框查找表(LUTBD，43字节命令) | 0 | 0 | 00100101 | R25H | 25H |
| | | 0 | 1 | 电平选择0~3、帧数0~3、重复次数 | | - |
| 21 | LUT选项(LUTOPT) | 0 | 0 | 00101010 | R2AH | 2AH |
| | | 0 | 1 | STATE_XON[9:0] | | 00H |
| 22 | KW LUT选项(KWOPT) | 0 | 0 | 00101011 | R2BH | 2BH |
| | | 0 | 1 | ATRED NORED | | 00H |
| | | 0 | 1 | KWE[9:8] | | 00H |
| | | 0 | 1 | KWE[7:0] | | 00H |
| 23 | PLL控制(PLL) | 0 | 0 | 00110000 | R30H | 30H |
| | | 0 | 1 | FRS[3:0] | | 06H |
| 24 | 温度传感器校准(TSC) | 0 | 0 | 01000000 | R40H | 40H |
| | | 1 | 1 | D10/TS7~D3/TS0 | | 00H |
| | | 1 | 1 | D2 D1 D0 | | 00H |
| 25 | 温度传感器使能(TSE) | 0 | 0 | 01000001 | R41H | 41H |
| | | 0 | 1 | TSE - TO[3:0] | | 00H |
| 26 | 温度传感器写入(TSW) | 0 | 0 | 01000010 | R42H | 42H |
| | | 0 | 1 | WATTR[7:0] | | 00H |
| | | 0 | 1 | WMSB[7:0] | | 00H |
| | | 0 | 1 | WLSB[7:0] | | 00H |
| 27 | 温度传感器读取(TSR) | 0 | 0 | 01000011 | R43H | 43H |
| | | 1 | 1 | RMSB[7:0] | | 00H |
| | | 1 | 1 | RLSB[7:0] | | 00H |
| 28 | 面板玻璃检查(PBC) | 0 | 0 | 01000100 | R44H | 44H |
| | | 1 | 1 | PSTA | | 00H |
| 29 | VCOM和数据间隔设置(CDI) | 0 | 0 | 01010000 | R50H | 50H |
| | | 0 | 1 | BDZ BDV[1:0] N2OCP DDX[1:0] | | 31H |
| | | 0 | 1 | SDEND CDI[3:0] | | 07H |
| 30 | 低功耗检测(LPD) | 0 | 0 | 01010001 | R51H | 51H |
| | | 1 | 1 | LPD | | 01H |
| 31 | 结束电压设置(EVS) | 0 | 0 | 01010010 | R52H | 52H |
| | | 0 | 1 | VCEND 0 0 BDEND[1:0] | | 02H |
| 32 | TCON设置(TCON) | 0 | 0 | 01100000 | R60H | 60H |
| | | 0 | 1 | S2G[3:0] G2S[3:0] | | - |
| 33 | 分辨率设置(TRES) | 0 | 0 | 01100001 | R61H | 61H |
| | | 0 | 1 | HRES[9:8] | | 03H |
| | | 0 | 1 | HRES[7:3] 000 | | 20H |
| | | 0 | 1 | VRES[9:8] | | 02H |
| | | 0 | 1 | VRES[7:0] | | 58H |
| 34 | 栅极/源极起始设置(GSST) | 0 | 0 | 01100101 | R65H | 65H |
| | | 0 | 1 | HST[9:8] | | 00H |
| | | 0 | 1 | HST[7:3] 000 | | 00H |
| | | 0 | 1 | VST[9:8] | | 00H |
| | | 0 | 1 | VST[7:0] | | 00H |
| 35 | 版本号(REV) | 0 | 0 | 01110000 | R70H | 70H |
| | | 1 | 1 | PROD_REV[23:16] | | FFH |
| | | 1 | 1 | PROD_REV[15:8] | | FFH |
| | | 1 | 1 | PROD_REV[7:0] | | FFH |
| | | 1 | 1 | LUT_REV[23:16] | | FFH |
| | | 1 | 1 | LUT_REV[15:8] | | FFH |
| | | 1 | 1 | CHIP_REV[7:0] | | 0CH |
| | | 1 | 1 | LUT_REV[7:0] | | FFH |
| 36 | 获取状态(FLG) | 0 | 0 | 01110001 | R71H | 71H |
| | | 1 | 1 | PTL_Flag I2C_ERR IC_BUSYN Data_Flag PON POF BUSY_N | | 13H |
| 37 | 自动测量VCOM(AMV) | 0 | 0 | 10000000 | R80H | 80H |
| | | 0 | 1 | AMVT[1:0] XON AMVS AMV AMVE | | 10H |
| 38 | VCOM值(VV) | 0 | 0 | 10000001 | R81H | 81H |
| | | 1 | 1 | VV[6:0] | | 00H |
| 39 | VCOM_DC设置(VDCS) | 0 | 0 | 10000010 | R82H | 82H |
| | | 0 | 1 | VDCS[6:0] | | 00H |
| 40 | 部分窗口(PTL) | 0 | 0 | 10010000 | R90H | 90H |
| | | 0 | 1 | HRST[9:8] | | 00H |
| | | 0 | 1 | HRST[7:3] 000 | | 00H |
| | | 0 | 1 | HRED[9:8] | | 03H |
| | | 0 | 1 | HRED[7:3] | | 1FH |
| | | 0 | 1 | VRST[9:8] | | 00H |
| | | 0 | 1 | VRST[7:0] | | 00H |
| | | 0 | 1 | VRED[9:8] | | 02H |
| | | 0 | 1 | VRED[7:0] | | 57H |
| | | 0 | 1 | PT_SCAN | | 00H |
| 41 | 部分进入(PTIN) | 0 | 0 | 10010001 | R91H | 91H |
| 42 | 部分退出(PTOUT) | 0 | 0 | 10010010 | R92H | 92H |
| 43 | 编程模式(PGM) | 0 | 0 | 10100000 | RA0H | A0H |
| 44 | 激活编程(APG) | 0 | 0 | 10100001 | RA1H | A1H |
| 45 | 读取OTP数据(ROTP) | 0 | 0 | 10100010 | RA2H | A2H |
| | | 1 | 1 | OTP地址0x000~0x17FF的数据 | | - |
| 46 | 级联设置(CCSET) | 0 | 0 | 11100000 | RE0H | E0H |
| | | 0 | 1 | TSFIX CCEN | | 00H |
| 47 | 省电模式(PWS) | 0 | 0 | 11100011 | RE3H | E3H |
| | | 0 | 1 | VCOM_W[3:0] SD_W[3:0] | | 00H |
| 48 | LVD电压选择(LVSEL) | 0 | 0 | 11100100 | RE4H | E4H |
| | | 0 | 1 | LVD_SEL[1:0] | | 03H |
| 49 | 强制温度(TSSET) | 0 | 0 | 11100101 | RE5H | E5H |
| | | 0 | 1 | TS_SET[7:0] | | 00H |
| 50 | 温度边界相位-C2(TSBDRY) | 0 | 0 | 11100111 | RE7H | E7H |
| | | 0 | 1 | TSBDRY_PHC2[7:0] | | 00H |

### 命令详细说明
#### (1) 面板设置(PSR，R00H)
| 操作 | W/R | C/D | D7 | D6 | D5 | D4 | D3 | D2 | D1 | D0 |
|---|-----|-----|----|----|----|----|----|----|----|----|
| 设置面板 | 0 | 0 | 0 | 0 | 0 | 0 | 0 | 0 | 0 | 0 |
| | 0 | 1 | REG | KW/R | UD | SHL | SHD_N | RST_N | | |

- **REG**：LUT选择，0=来自OTP(默认)，1=来自寄存器
- **KW/R**：黑白红模式，0=黑白红(KWR)模式(默认)，1=黑白(KW)模式
- **UD**：栅极扫描方向，0=向下扫描(Gn-1→G0)，1=向上扫描(G0→Gn-1，默认)
- **SHL**：源极移位方向，0=左移(Sn-1→S0)，1=右移(S0→Sn-1，默认)
- **SHD_N**：升压开关，0=升压关闭，1=升压开启(默认)
- **RST_N**：软复位，0=复位(升压关闭，寄存器恢复默认，驱动复位)，1=无影响(默认)

#### (2) 电源设置(PWR，R01H)
| 操作 | W/R | C/D | D7 | D6 | D5 | D4 | D3 | D2 | D1 | D0 |
|---|-----|-----|----|----|----|----|----|----|----|----|
| 选择内部/外部电源 | 0 | 0 | 0 | 0 | 0 | 0 | 0 | 0 | 0 | 1 |
| | 0 | 1 | | BD_EN | | VSR_EN | VS_EN | VG_EN | | |
| | 0 | 1 | | VCOM_SLEW | | VG_LVL[2:0] | | | | |
| | 0 | 1 | VDH_LVL[5:0] | | | | | | | |
| | 0 | 1 | VDL_LVL[5:0] | | | | | | | |
| | 0 | 1 | VDHR_LVL[5:0] | | | | | | | |

- **BD_EN**：边框LDO使能，0=禁用(默认)，1=使能
- **VSR_EN**：源极LV电源选择，0=外部VDHR引脚，1=内部DC/DC生成(默认)
- **VS_EN**：源极电源选择，0=外部VDH/VDL引脚，1=内部DC/DC生成(默认)
- **VG_EN**：栅极电源选择，0=外部VGH/VGL引脚，1=内部DC/DC生成(默认)
- **VCOM_SLEW**：VCOM压摆率选择，固定为"1"

**VG_LVL[2:0]电压等级**
| VG_LVL[2:0] | VGH/VGL电压 |
|---|---|
| 000 | 9V/-9V |
| 001 | 10V/-10V |
| 010 | 11V/-11V |
| 011 | 12V/-12V |
| 100 | 17V/-17V |
| 101 | 18V/-18V |
| 110 | 19V/-19V |
| 111(默认) | 20V/-20V |

**VDL_LVL[5:0]电压等级(默认：111010b=-14.0V)**
| VDL_LVL | 电压(V) | VDL_LVL | 电压(V) | VDL_LVL | 电压(V) | VDL_LVL | 电压(V) |
|---|---|---|---|---|---|---|---|
| 000000 | -2.4 | 010001 | -5.8 | 100010 | -9.2 | 110011 | -12.6 |
| 000001 | -2.6 | 010010 | -6.0 | 100011 | -9.4 | 110100 | -12.8 |
| 000010 | -2.8 | 010011 | -6.2 | 100100 | -9.6 | 110101 | -13.0 |
| 000011 | -3.0 | 010100 | -6.4 | 100101 | -9.8 | 110110 | -13.2 |
| 000100 | -3.2 | 010101 | -6.6 | 100110 | -10.0 | 110111 | -13.4 |
| 000101 | -3.4 | 010110 | -6.8 | 100111 | -10.2 | 111000 | -13.6 |
| 000110 | -3.6 | 010111 | -7.0 | 101000 | -10.4 | 111001 | -13.8 |
| 000111 | -3.8 | 011000 | -7.2 | 101001 | -10.6 | 111010 | -14.0 |
| 001000 | -4.0 | 011001 | -7.4 | 101010 | -10.8 | 111011 | -14.2 |
| 001001 | -4.2 | 011010 | -7.6 | 101011 | -11.0 | 111100 | -14.4 |
| 001010 | -4.4 | 011011 | -7.8 | 101100 | -11.2 | 111101 | -14.6 |
| 001011 | -4.6 | 011100 | -8.0 | 101101 | -11.4 | 111110 | -14.8 |
| 001100 | -4.8 | 011101 | -8.2 | 101110 | -11.6 | 111111 | -15.0 |
| 001101 | -5.0 | 011110 | -8.4 | 101111 | -11.8 | | |
| 001110 | -5.2 | 011111 | -8.6 | 110000 | -12.0 | | |
| 001111 | -5.4 | 100000 | -8.8 | 110001 | -12.2 | | |
| 010000 | -5.6 | 100001 | -9.0 | 110010 | -12.4 | | |

**VDHR_LVL[5:0]电压等级(默认：000011b=3.0V)**
| VDHR_LVL | 电压(V) | VDHR_LVL | 电压(V) | VDHR_LVL | 电压(V) | VDHR_LVL | 电压(V) |
|---|---|---|---|---|---|---|---|
| 000000 | 2.4 | 010001 | 5.8 | 100010 | 9.2 | 110011 | 12.6 |
| 000001 | 2.6 | 010010 | 6.0 | 100011 | 9.4 | 110100 | 12.8 |
| 000010 | 2.8 | 010011 | 6.2 | 100100 | 9.6 | 110101 | 13.0 |
| 000011 | 3.0 | 010100 | 6.4 | 100101 | 9.8 | 110110 | 13.2 |
| 000100 | 3.2 | 010101 | 6.6 | 100110 | 10.0 | 110111 | 13.4 |
| 000101 | 3.4 | 010110 | 6.8 | 100111 | 10.2 | 111000 | 13.6 |
| 000110 | 3.6 | 010111 | 7.0 | 101000 | 10.4 | 111001 | 13.8 |
| 000111 | 3.8 | 011000 | 7.2 | 101001 | 10.6 | 111010 | 14.0 |
| 001000 | 4.0 | 011001 | 7.4 | 101010 | 10.8 | 111011 | 14.2 |
| 001001 | 4.2 | 011010 | 7.6 | 101011 | 11.0 | 111100 | 14.4 |
| 001010 | 4.4 | 011011 | 7.8 | 101100 | 11.2 | 111101 | 14.6 |
| 001011 | 4.6 | 011100 | 8.0 | 101101 | 11.4 | 111110 | 14.8 |
| 001100 | 4.8 | 011101 | 8.2 | 101110 | 11.6 | 111111 | 15.0 |
| 001101 | 5.0 | 011110 | 8.4 | 101111 | 11.8 | | |
| 001110 | 5.2 | 011111 | 8.6 | 110000 | 12.0 | | |
| 001111 | 5.4 | 100000 | 8.8 | 110001 | 12.2 | | |
| 010000 | 5.6 | 100001 | 9.0 | 110010 | 12.4 | | |

#### (3) 电源关闭(POF，R02H)
| 操作 | W/R | C/D | D7 | D6 | D5 | D4 | D3 | D2 | D1 | D0 |
|---|-----|-----|----|----|----|----|----|----|----|----|
| 关闭电源 | 0 | 0 | 0 | 0 | 0 | 0 | 0 | 0 | 1 | 0 |

执行该命令后，驱动器将关闭电源。将关闭升压、控制器、源极驱动器、栅极驱动器、VCOM和温度传感器，但寄存器数据将保留直到VDD关闭或进入深度睡眠模式。源极/栅极/边框/VCOM将被释放为浮空状态。

#### (4) 电源关闭序列设置(PFS，R03H)
| 操作 | W/R | C/D | D7 | D6 | D5 | D4 | D3 | D2 | D1 | D0 |
|---|-----|-----|----|----|----|----|----|----|----|----|
| 设置电源关闭序列 | 0 | 0 | 0 | 0 | 0 | 0 | 0 | 0 | 1 | 1 |
| | 0 | 1 | | | | | | T_VDS_OFF[1:0] | | |

- **T_VDS_OFF[1:0]**：源极到栅极电源关闭间隔时间
  - 00b：1帧(默认)
  - 01b：2帧
  - 10b：3帧
  - 11b：4帧

#### (5) 电源开启(PON，R04H)
| 操作 | W/R | C/D | D7 | D6 | D5 | D4 | D3 | D2 | D1 | D0 |
|---|-----|-----|----|----|----|----|----|----|----|----|
| 开启电源 | 0 | 0 | 0 | 0 | 0 | 0 | 0 | 1 | 0 | 0 |

执行该命令后，驱动器将开启电源。将开启升压、控制器、调节器，温度传感器将在升压使能前进行一次检测。当所有电压准备就绪后，BUSY_N信号将返回高电平。

#### (6) 电源开启测量(PMES，R05H)
| 操作 | W/R | C/D | D7 | D6 | D5 | D4 | D3 | D2 | D1 | D0 |
|---|-----|-----|----|----|----|----|----|----|----|----|
| 设置内部带隙 | 0 | 0 | 0 | 0 | 0 | 0 | 0 | 1 | 0 | 1 |

该命令使能内部带隙，将在下一次POF命令时清除。

#### (7) 升压软启动(BTST，R06H)
| 操作 | W/R | C/D | D7 | D6 | D5 | D4 | D3 | D2 | D1 | D0 |
|---|-----|-----|----|----|----|----|----|----|----|----|
| 设置升压软启动 | 0 | 0 | 0 | 0 | 0 | 0 | 0 | 1 | 1 | 0 |
| | 0 | 1 | BT_PHA[7:6] | BT_PHA[5:3] | BT_PHA[2:0] | | | | | |
| | 0 | 1 | BT_PHB[7:6] | BT_PHB[5:3] | BT_PHB[2:0] | | | | | |
| | 0 | 1 | | BT_PHC1[5:3] | BT_PHC1[2:0] | | | | | |
| | 0 | 1 | PHC2EN | BT_PHC2[5:3] | BT_PHC2[2:0] | | | | | |

- **BT_PHA/PHB/PHC[7:6]**：对应相位的软启动周期
  - 00b：10ms
  - 01b：20ms
  - 10b：30ms
  - 11b：40ms
- **BT_PHA/PHB/PHC[5:3]**：对应相位的驱动强度
  - 000b：强度1
  - 001b：强度2
  - ...
  - 111b：强度8(最强)
- **BT_PHA/PHB/PHC[2:0]**：对应相位GDR的最小关断时间
  - 000b：0.27μs
  - 001b：0.34μs
  - 010b：0.40μs
  - 011b：0.54μs
  - 100b：0.80μs
  - 101b：1.54μs
  - 110b：3.34μs
  - 111b：6.58μs
- **PHC2EN**：升压相位C2使能
  - 0：禁用，相位C始终使用相位C1设置
  - 1：使能，温度>TSBDRY_PHC2时用C1，≤时用C2

#### (8) 深度睡眠(DSLP，R07H)
| 操作 | W/R | C/D | D7 | D6 | D5 | D4 | D3 | D2 | D1 | D0 |
|---|-----|-----|----|----|----|----|----|----|----|----|
| 进入深度睡眠 | 0 | 0 | 0 | 0 | 0 | 0 | 0 | 1 | 1 | 1 |
| | 0 | 1 | 1 | 0 | 1 | 0 | 0 | 1 | 0 | 1(校验码A5H) |

传输该命令后，芯片将进入深度睡眠模式以节省功耗。仅当校验码为0xA5时命令才会执行。可通过硬件复位退出深度睡眠模式，返回待机模式。

#### (9) 显示开始传输1(DTM1，R10H)
| 操作 | W/R | C/D | D7-D0 |
|---|-----|-----|---|
| 开始数据传输 | 0 | 0 | 00010000 |
| | 0 | 1 | Pixel1~Pixel8, ..., Pixel(n-7)~Pixel(n) |

该命令开始传输数据并写入SRAM：
- KW模式：写入"OLD"数据到SRAM
- KWR模式：写入"K/W"数据到SRAM
- 编程模式：写入"OTP"数据到SRAM用于编程

#### (10) 数据停止(DSP，R11H)
| 操作 | W/R | C/D | D7-D0 |
|---|-----|-----|---|
| 停止数据传输 | 0 | 0 | 00010001 |
| | 1 | 1 | data_flag |

- **data_flag**：用户数据接收标志
  - 0：驱动器未接收完所有数据
  - 1：驱动器已接收完一帧数据(DTM1和DTM2)

在"数据开始"或"数据停止"命令后，若data_flag=1，面板将开始刷新，BUSY_N信号变为"0"。

#### (11) 显示刷新(DRF，R12H)
| 操作 | W/R | C/D | D7-D0 |
|---|-----|-----|---|
| 刷新显示 | 0 | 0 | 00010010 |

发送该命令后，驱动器将根据SRAM数据和LUT刷新显示(data/VCOM)。BUSY_N信号变为"0"，面板开始刷新。

#### (12) 显示开始传输2(DTM2，R13H)
| 操作 | W/R | C/D | D7-D0 |
|---|-----|-----|---|
| 开始数据传输 | 0 | 0 | 00010011 |
| | 0 | 1 | Pixel1~Pixel8, ..., Pixel(n-7)~Pixel(n) |

该命令开始传输数据并写入SRAM：
- KW模式：写入"NEW"数据到SRAM
- KWR模式：写入"RED"数据到SRAM

#### (13) 双SPI模式(DUSPI，R15H)
| 操作 | W/R | C/D | D7-D0 |
|---|-----|-----|---|
| 设置双SPI模式 | 0 | 0 | 00010101 |
| | 1 | 1 | MM_EN DUSPI_EN |

- **MM_EN**：MM输入引脚定义使能，0=禁用，1=使能
- **DUSPI_EN**：双SPI模式使能，0=禁用(单SPI模式)，1=使能

#### (14) 自动序列(AUTO，R17H)
| 操作 | W/R | C/D | D7-D0 |
|---|-----|-----|---|
| 自动序列 | 0 | 0 | 00010111 |
| | 0 | 1 | 10100101(校验码) |

该命令使能内部序列连续执行多个命令，最小化空闲时间，降低功耗并简化主机控制流程：
- AUTO(0x17)+Code(0xA5) = PON → DRF → POF
- AUTO(0x17)+Code(0xA7) = PON → DRF → POF → DSLP

#### (15) VCOM查找表(LUTC，R20H，61字节命令)
结构：字节2~7重复10次，共61字节
- 字节2,8,14,...56：电平选择(D[7:6]=电平0，D[5:4]=电平1，D[3:2]=电平2，D[1:0]=电平3)
  - 00b：VCOM_DC
  - 01b：VDH+VCOM_DC(VCOMH)
  - 10b：VDL+VCOM_DC(VCOML)
  - 11b：浮空
- 字节3~6,9~12,...57~60：帧数(00000000b=0帧，11111111b=255帧)
- 字节7,13,19,...61：重复次数(00000000b=0次，11111111b=255次)

- KWR模式(KW/R=0)：使用全部10组
- KW模式(KW/R=1)：仅使用前7组

#### (16) 白到白查找表(LUTWW，R21H，43字节命令)
结构：字节2~7重复7次，共43字节
- 字节2,8,14,...38：电平选择
  - 00b：GND
  - 01b：VDH
  - 10b：VDL
  - 11b：VDHR
- 字节3~6,9~12,...39~42：帧数(00000000b=0帧，11111111b=255帧)
- 字节7,13,19,...43：重复次数(00000000b=0次，11111111b=255次)

- KWR模式(KW/R=0)：不使用
- KW模式(KW/R=1)：使用

#### (17) 黑到白/红色查找表(LUTKW/LUTR，R22H，61字节命令)
结构同LUTC，电平选择同LUTWW。
- KWR模式(KW/R=0)：使用全部10组
- KW模式(KW/R=1)：仅使用前7组

#### (18) 白到黑查找表(LUTWK/LUTW，R23H)
结构和定义同LUTKW/LUTR，无论KW/R为0或1均使用。

#### (19) 黑到黑查找表(LUTKK/LUTK，R24H)
结构和定义同LUTKW/LUTR，无论KW/R为0或1均使用。

#### (20) 边框查找表(LUTBD，R25H，43字节命令)
结构同LUTWW，电平选择：
- BD_EN=0：00b=VCOM，01b=VDH，10b=VDL，11b=VDHR
- BD_EN=1：00b=VCOM，01b=VBH(VCOM-VDL)，10b=VBL(VCOM-VDH)，11b=VDHR

无论KW/R为0或1，仅使用7组。

#### (21) LUT选项(LUTOPT，R2AH)
| 操作 | W/R | C/D | D7-D0 |
|---|-----|-----|---|
| 设置LUT选项 | 0 | 0 | 00101010 |
| | 0 | 1 | STATE_XON[9:0] |

- **STATE_XON[9:0]**：全栅极开启控制，每一位对应一个状态
  - 0000000000b：无全栅极开启
  - 0000000001b：状态1全栅极开启
  - 0000000011b：状态1和状态2全栅极开启

#### (22) KW LUT选项(KWOPT，R2BH，仅KWR模式有效)
| 操作 | W/R | C/D | D7-D0 |
|---|-----|-----|---|
| 设置KW LUT选项 | 0 | 0 | 00101011 |
| | 0 | 1 | ATRED NORED |
| | 0 | 1 | KWE[9:8] |
| | 0 | 1 | KWE[7:0] |

**(ATRED, NORED) LUT选择**
| ATRED | NORED | 描述 |
|---|---|---|
| 0 | 0 | 始终使用KWR LUT |
| 0 | 1 | 仅使用KW LUT |
| 1 | 0 | 由红色数据自动检测 |
| 1 | 1 | 仅使用KW LUT |

- **KWE[9:0]**：KW LUT使能控制位，每一位对应一个状态，至少需设置1位使能

#### (23) PLL控制(PLL，R30H)
| 操作 | W/R | C/D | D7-D0 |
|---|-----|-----|---|
| 控制PLL | 0 | 0 | 00110000 |
| | 0 | 1 | FRS[3:0] |

**FRS帧速率设置**
| FRS | 帧速率(Hz) | FRS | 帧速率(Hz) |
|-----|---|-----|---|
| 0000 | 5 | 1000 | 70 |
| 0001 | 10 | 1001 | 80 |
| 0010 | 15 | 1010 | 90 |
| 0011 | 20 | 1011 | 100 |
| 0100 | 30 | 1100 | 110 |
| 0101 | 40 | 1101 | 130 |
| 0110 | 50 | 1110 | 150 |
| 0111 | 60 | 1111 | 200 |

- 水平Hsync H_Active：820时钟
- 垂直Vsync V_Active：620行

#### (24) 温度传感器校准(TSC，R40H)
| 操作 | W/R | C/D | D7-D0 |
|---|-----|-----|---|
| 温度检测 | 0 | 0 | 01000000 |
| | 1 | 1 | D10/TS7 D9/TS6 D8/TS5 D7/TS4 D6/TS3 D5/TS2 D4/TS1 D3/TS0 |
| | 1 | 1 | D2 D1 D0 |

- TSE(R41h)=0：读取内部温度传感器值(TS[7:0])
- TSE(R41h)=1：读取外部LM75温度传感器值(D[10:0])

**温度值对应表**
| TS[7:0]/D[10:3] | 温度(℃) | TS[7:0]/D[10:3] | 温度(℃) | TS[7:0]/D[10:3] | 温度(℃) |
|---|---|---|---|---|---|
| 11100111 | -25 | 11111000 | -8 | 00011001 | 25 |
| 11101000 | -24 | 11111001 | -7 | 00011010 | 26 |
| 11101001 | -23 | 11111010 | -6 | 00011011 | 27 |
| 11101010 | -22 | 11111011 | -5 | 00011100 | 28 |
| 11101011 | -21 | 11111100 | -4 | 00011101 | 29 |
| 11101100 | -20 | 11111101 | -3 | 00011110 | 30 |
| 11101101 | -19 | 11111110 | -2 | 00011111 | 31 |
| 11101110 | -18 | 11111111 | -1 | 00100000 | 32 |
| 11101111 | -17 | 00000000 | 0 | 00100001 | 33 |
| 11110000 | -16 | 00000001 | 1 | 00100010 | 34 |
| 11110001 | -15 | 00000010 | 2 | 00100011 | 35 |
| 11110010 | -14 | 00000011 | 3 | 00100100 | 36 |
| 11110011 | -13 | 00000100 | 4 | 00100101 | 37 |
| 11110100 | -12 | 00000101 | 5 | 00100110 | 38 |
| 11110101 | -11 | 00000110 | 6 | 00100111 | 39 |
| 11110110 | -10 | 00000111 | 7 | 00101000 | 40 |
| 11110111 | -9 | 00001000 | 8 | 00101001 | 41 |
| | | 00001001 | 9 | 00101010 | 42 |
| | | 00001010 | 10 | 00101011 | 43 |
| | | 00001011 | 11 | 00101100 | 44 |
| | | 00001100 | 12 | 00101101 | 45 |
| | | 00001101 | 13 | 00101110 | 46 |
| | | 00001110 | 14 | 00101111 | 47 |
| | | 00001111 | 15 | 00110000 | 48 |
| | | 00010000 | 16 | 00110001 | 49 |
| | | 00010001 | 17 | | |
| | | 00010010 | 18 | | |
| | | 00010011 | 19 | | |
| | | 00010100 | 20 | | |
| | | 00010101 | 21 | | |
| | | 00010110 | 22 | | |
| | | 00010111 | 23 | | |
| | | 00011000 | 24 | | |

#### (25) 温度传感器使能(TSE，R41H)
| 操作 | W/R | C/D | D7-D0 |
|---|-----|-----|---|
| 使能温度传感器/偏移 | 0 | 0 | 01000001 |
| | 0 | 1 | TSE - TO[3:0] |

- **TSE**：内部温度传感器开关，0=使能(默认)，1=禁用(使用外部传感器)
- **TO[3:0]**：温度偏移

**温度偏移校准**
| TO[3:0] | 校准值(℃) | TO[3:0] | 校准值(℃) |
|---|---|---|---|
| 0000 | +0(默认) | 1000 | -8 |
| 0001 | +1 | 1001 | -7 |
| 0010 | +2 | 1010 | -6 |
| 0011 | +3 | 1011 | -5 |
| 0100 | +4 | 1100 | -4 |
| 0101 | +5 | 1101 | -3 |
| 0110 | +6 | 1110 | -2 |
| 0111 | +7 | 1111 | -1 |

#### (26) 温度传感器写入(TSW，R42H)
| 操作 | W/R | C/D | D7-D0 |
|---|-----|-----|---|
| 写入外部温度传感器 | 0 | 0 | 01000010 |
| | 0 | 1 | WATTR[7:0] |
| | 0 | 1 | WMSB[7:0] |
| | 0 | 1 | WLSB[7:0] |

- **WATTR[7:6]**：I2C写字节数
  - 00b：1字节(仅头字节)
  - 01b：2字节(头字节+指针)
  - 10b：3字节(头字节+指针+1参数)
  - 11b：4字节(头字节+指针+1参数+2参数)
- **WATTR[5:3]**：用户定义地址位(A2,A1,A0)
- **WATTR[2:0]**：指针设置
- **WMSB[7:0]**：写入外部温度传感器数据的高字节
- **WLSB[7:0]**：写入外部温度传感器数据的低字节

#### (27) 温度传感器读取(TSR，R43H)
| 操作 | W/R | C/D | D7-D0 |
|---|-----|-----|---|
| 读取外部温度传感器 | 0 | 0 | 01000011 |
| | 1 | 1 | RMSB[7:0] |
| | 1 | 1 | RLSB[7:0] |

- **RMSB[7:0]**：从外部温度传感器读取数据的高字节
- **RLSB[7:0]**：从外部温度传感器读取数据的低字节

#### (28) 面板玻璃检查(PBC，R44H)
| 操作 | W/R | C/D | D7-D0 |
|---|-----|-----|---|
| 检查面板玻璃 | 0 | 0 | 01000100 |
| | 1 | 1 | PSTA |

- **PSTA**：面板检查结果，0=检查失败(面板损坏)，1=检查通过

#### (29) VCOM和数据间隔设置(CDI，R50H)
| 操作 | W/R | C/D | D7-D0 |
|---|-----|-----|---|
| 设置VCOM和数据间隔 | 0 | 0 | 01010000 |
| | 0 | 1 | BDZ BDV[1:0] N2OCP DDX[1:0] |
| | 0 | 1 | SDEND CDI[3:0] |

- **BDZ**：边框高阻控制，0=禁用(默认)，1=使能
- **BDV[1:0]**：边框LUT选择(不同模式下对应不同LUT)
- **N2OCP**：KW模式下显示刷新后将NEW数据复制到OLD数据，0=禁用(默认)，1=使能
- **DDX[1:0]**：数据极性(不同模式下对应不同LUT)
- **SDEND**：源极驱动结束，0=结束时输出2帧0V，1=保持最后状态
- **CDI[3:0]**：VCOM和数据间隔(单位：hsync)，0000b=17，0111b=10(默认)，1111b=2

#### (30) 低功耗检测(LPD，R51H)
| 操作 | W/R | C/D | D7-D0 |
|---|-----|-----|---|
| 检测低功耗 | 0 | 0 | 01010001 |
| | 1 | 1 | LPD |

- **LPD**：内部低功耗检测标志，0=低功耗输入(VDD<LVSEL设置值)，1=正常状态(默认)

#### (31) 结束电压设置(EVS，R52H)
| 操作 | W/R | C/D | D7-D0 |
|---|-----|-----|---|
| 设置结束电压 | 0 | 0 | 01010010 |
| | 0 | 1 | VCEND 0 0 BDEND[1:0] |

- **VCEND**：VCOM结束电压选择，0b=VCOM_DC，1b=浮空
- **BDEND[1:0]**：边框结束电压选择，00b=0V，01b=0V，10b=VCOM_DC，11b=浮空

#### (32) TCON设置(TCON，R60H)
| 操作 | W/R | C/D | D7-D0 |
|---|-----|-----|---|
| 设置栅极/源极非重叠周期 | 0 | 0 | 01100000 |
| | 0 | 1 | S2G[3:0] G2S[3:0] |

- **S2G[3:0]/G2S[3:0]**：源极到栅极/栅极到源极非重叠周期，单位=667ns
  - 0000b：4
  - 0010b：12(默认)
  - 1111b：64

#### (33) 分辨率设置(TRES，R61H)
| 操作 | W/R | C/D | D7-D0 |
|---|-----|-----|---|
| 设置显示分辨率 | 0 | 0 | 01100001 |
| | 0 | 1 | HRES[9:8] |
| | 0 | 1 | HRES[7:3] 000 |
| | 0 | 1 | VRES[9:8] |
| | 0 | 1 | VRES[7:0] |

- **HRES[9:3]**：水平显示分辨率(范围：01h~64h)
- **VRES[9:0]**：垂直显示分辨率(范围：001h~258h)
- 有源通道计算(HST=0,VST=0)：
  - 栅极：首有源栅极=G0，末有源栅极=VRES[9:0]-1
  - 源极：首有源源极=S0，末有源源极=HRES[9:3]×8-1

#### (34) 栅极/源极起始设置(GSST，R65H)
| 操作 | W/R | C/D | D7-D0 |
|---|-----|-----|---|
| 设置栅极/源极起始位置 | 0 | 0 | 01100101 |
| | 0 | 1 | HST[9:8] |
| | 0 | 1 | HST[7:3] 000 |
| | 0 | 1 | VST[9:8] |
| | 0 | 1 | VST[7:0] |

- **HST[9:3]**：水平显示起始位置(源极，范围：00h~63h)
- **VST[9:0]**：垂直显示起始位置(栅极，范围：000h~257h)

#### (35) 版本号(REV，R70H)
| 操作 | W/R | C/D | D7-D0 |
|---|-----|-----|---|
| 读取版本 | 0 | 0 | 01110000 |
| | 1 | 1 | PROD_REV[23:16] |
| | 1 | 1 | PROD_REV[15:8] |
| | 1 | 1 | PROD_REV[7:0] |
| | 1 | 1 | LUT_REV[23:16] |
| | 1 | 1 | LUT_REV[15:8] |
| | 1 | 1 | CHIP_REV[7:0] |
| | 1 | 1 | LUT_REV[7:0] |

- **PROD_REV[23:0]**：产品版本，从OTP地址0x0BDD~0x0BDF或0x17DD~0x17DF读取
- **LUT_REV[23:0]**：LUT版本，从OTP地址0x0BE0~0x0BE2或0x17E0~0x17E2读取
- **CHIP_REV[7:0]**：芯片版本，固定为00001100b

#### (36) 获取状态(FLG，R71H)
| 操作 | W/R | C/D | D7-D0 |
|---|-----|-----|---|
| 读取标志 | 0 | 0 | 01110001 |
| | 1 | 1 | PTL_Flag I2C_ERR IC_BUSYN Data_Flag PON POF BUSY_N |

- **PTL_Flag**：部分显示状态(高=部分模式)
- **I2C_ERR**：I2C主错误状态
- **IC_BUSYN**：I2C主忙状态(低有效)
- **Data_Flag**：驱动器已接收完一帧数据
- **PON**：电源开启状态
- **POF**：电源关闭状态
- **BUSY_N**：驱动器忙状态(低有效)

#### (37) 自动测量VCOM(AMV，R80H)
| 操作 | W/R | C/D | D7-D0 |
|---|-----|-----|---|
| 自动测量VCOM | 0 | 0 | 10000000 |
| | 0 | 1 | AMVT[1:0] XON AMVS AMV AMVE |

- **AMVT[1:0]**：自动测量VCOM时间
  - 00b：3s
  - 01b：5s(默认)
  - 10b：8s
  - 11b：10s
- **XON**：自动测量期间全栅极开启，0=正常扫描(默认)，1=全栅极开启
- **AMVS**：自动测量期间源极输出，0=输出0V(默认)，1=输出VDHR
- **AMV**：VCOM值获取方式，0=通过VV命令获取(默认)，1=模拟信号输出(需外部ADC)
- **AMVE**：自动测量VCOM使能，0=无影响(默认)，1=触发自动测量

#### (38) VCOM值(VV，R81H)
| 操作 | W/R | C/D | D7-D0 |
|---|-----|-----|---|
| 获取VCOM值 | 0 | 0 | 10000001 |
| | 1 | 1 | VV[6:0] |

**VV[6:0] VCOM电压对应表**
| VV[6:0] | 电压(V) | VV[6:0] | 电压(V) | VV[6:0] | 电压(V) |
|---|---|---|---|---|---|
| 0000000 | -0.10 | 0011011 | -1.45 | 0110110 | -2.80 |
| 0000001 | -0.15 | 0011100 | -1.50 | 0110111 | -2.85 |
| 0000010 | -0.20 | 0011101 | -1.55 | 0111000 | -2.90 |
| 0000011 | -0.25 | 0011110 | -1.60 | 0111001 | -2.95 |
| 0000100 | -0.30 | 0011111 | -1.65 | 0111010 | -3.00 |
| 0000101 | -0.35 | 0100000 | -1.70 | 0111011 | -3.05 |
| 0000110 | -0.40 | 0100001 | -1.75 | 0111100 | -3.10 |
| 0000111 | -0.45 | 0100010 | -1.80 | 0111101 | -3.15 |
| 0001000 | -0.50 | 0100011 | -1.85 | 0111110 | -3.20 |
| 0001001 | -0.55 | 0100100 | -1.90 | 0111111 | -3.25 |
| 0001010 | -0.60 | 0100101 | -1.95 | 1000000 | -3.30 |
| 0001011 | -0.65 | 0100110 | -2.00 | 1000001 | -3.35 |
| 0001100 | -0.70 | 0100111 | -2.05 | 1000010 | -3.40 |
| 0001101 | -0.75 | 0101000 | -2.10 | 1000011 | -3.45 |
| 0001110 | -0.80 | 0101001 | -2.15 | 1000100 | -3.50 |
| 0001111 | -0.85 | 0101010 | -2.20 | 1000101 | -3.55 |
| 0010000 | -0.90 | 0101011 | -2.25 | 1000110 | -3.60 |
| 0010001 | -0.95 | 0101100 | -2.30 | 1000111 | -3.65 |
| 0010010 | -1.00 | 0101101 | -2.35 | 1001000 | -3.70 |
| 0010011 | -1.05 | 0101110 | -2.40 | 1001001 | -3.75 |
| 0010100 | -1.10 | 0101111 | -2.45 | 1001010 | -3.80 |
| 0010101 | -1.15 | 0110000 | -2.50 | 1001011 | -3.85 |
| 0010110 | -1.20 | 0110001 | -2.55 | 1001100 | -3.90 |
| 0010111 | -1.25 | 0110010 | -2.60 | 1001101 | -3.95 |
| 0011000 | -1.30 | 0110011 | -2.65 | 1001110 | -4.00 |
| 0011001 | -1.35 | 0110100 | -2.70 | 1001111 | -4.05 |
| 0011010 | -1.40 | 0110101 | -2.75 | | |

#### (39) VCOM_DC设置(VDCS，R82H)
| 操作 | W/R | C/D | D7-D0 |
|---|-----|-----|---|
| 设置VCOM_DC | 0 | 0 | 10000010 |
| | 0 | 1 | VDCS[6:0] |

VDCS[6:0]电压对应表同VV[6:0]。

#### (40) 部分窗口(PTL，R90H)
| 操作 | W/R | C/D | D7-D0 |
|---|-----|-----|---|
| 设置部分窗口 | 0 | 0 | 10010000 |
| | 0 | 1 | HRST[9:8] |
| | 0 | 1 | HRST[7:3] 000 |
| | 0 | 1 | HRED[9:8] |
| | 0 | 1 | HRED[7:3] |
| | 0 | 1 | VRST[9:8] |
| | 0 | 1 | VRST[7:0] |
| | 0 | 1 | VRED[9:8] |
| | 0 | 1 | VRED[7:0] |
| | 0 | 1 | PT_SCAN |

- **HRST[9:3]**：水平起始通道组(范围：00h~63h)
- **HRED[9:3]**：水平结束通道组(范围：00h~63h，必须大于HRST)
- **VRST[9:0]**：垂直起始行(范围：000h~257h)
- **VRED[9:0]**：垂直结束行(范围：000h~257h，必须大于VRST)
- **PT_SCAN**：栅极扫描范围，0=仅扫描部分窗口内，1=扫描部分窗口内外(默认)

#### (41) 部分进入(PTIN，R91H)
| 操作 | W/R | C/D | D7-D0 |
|---|-----|-----|---|
| 进入部分模式 | 0 | 0 | 10010001 |

#### (42) 部分退出(PTOUT，R92H)
| 操作 | W/R | C/D | D7-D0 |
|---|-----|-----|---|
| 退出部分模式 | 0 | 0 | 10010010 |

执行后退出部分模式，进入正常模式。

#### (43) 编程模式(PGM，RA0H)
| 操作 | W/R | C/D | D7-D0 |
|---|-----|-----|---|
| 进入编程模式 | 0 | 0 | 10100000 |

发送该命令后，芯片进入编程模式。编程完成后，需硬件复位退出编程模式。

#### (44) 激活编程(APG，RA1H)
| 操作 | W/R | C/D | D7-D0 |
|---|-----|-----|---|
| 激活OTP编程 | 0 | 0 | 10100001 |

传输该命令后，编程状态机被激活。BUSY_N标志将变为0直到编程完成。

#### (45) 读取OTP数据(ROTP，RA2H)
| 操作 | W/R | C/D | D7-D0 |
|---|-----|-----|---|
| 读取OTP数据 | 0 | 0 | 10100010 |
| | 1 | 1 | OTP地址0x000~0x17FF的数据 |

用于读取OTP内容以检查编程数据。最大地址=0x17FF。

**OTP编程流程**：
1. 供电并复位
2. 发送PGM命令进入编程模式
3. 发送DTM1命令写入数据
4. 施加VPP=7.75V，等待10ms
5. 发送APG命令激活编程
6. 检查BUSY_N=1，移除VPP，等待VPP<3.0V
7. 发送ROTP命令检查数据
8. 若正确则完成，否则跳过0x0BF0~0x0BFF
9. 复位退出

#### (46) 级联设置(CCSET，RE0H)
| 操作 | W/R | C/D | D7-D0 |
|---|-----|-----|---|
| 设置级联选项 | 0 | 0 | 11100000 |
| | 0 | 1 | TSFIX CCEN |

- **TSFIX**：从机温度与主机相同，0=由内部/外部传感器定义(默认)，1=由TS_SET[7:0]寄存器定义
- **CCEN**：输出时钟使能，0=CL引脚输出0V(默认)，1=CL引脚输出时钟到从芯片

#### (47) 省电模式(PWS，RE3H)
| 操作 | W/R | C/D | D7-D0 |
|---|-----|-----|---|
| VCOM和源极省电 | 0 | 0 | 11100011 |
| | 0 | 1 | VCOM_W[3:0] SD_W[3:0] |

- **VCOM_W[3:0]**：VCOM省电宽度(单位：行周期)
- **SD_W[3:0]**：源极省电宽度(单位：660ns)

当VCOM/源极输出电压从负变正或正变负时，省电机制被激活。

#### (48) LVD电压选择(LVSEL，RE4H)
| 操作 | W/R | C/D | D7-D0 |
|---|-----|-----|---|
| 选择LVD电压 | 0 | 0 | 11100100 |
| | 0 | 1 | LVD_SEL[1:0] |

**LVD电压选择**
| LVD_SEL[1:0] | LVD值 |
|---|---|
| 00 | <2.2V |
| 01 | <2.3V |
| 10 | <2.4V |
| 11(默认) | <2.5V |

#### (49) 强制温度(TSSET，RE5H)
| 操作 | W/R | C/D | D7-D0 |
|---|-----|-----|---|
| 级联强制温度值 | 0 | 0 | 11100101 |
| | 0 | 1 | TS_SET[7:0] |

用于级联时固定主从芯片的温度值。

#### (50) 温度边界相位-C2(TSBDRY，RE7H)
| 操作 | W/R | C/D | D7-D0 |
|---|-----|-----|---|
| 设置相位-C2温度边界 | 0 | 0 | 11100111 |
| | 0 | 1 | TSBDRY_PHC2[7:0] |

用于判断是否应用升压相位-C2的温度边界。

## 8. 光学规格
**测量条件**：照明角度45°，检测角度垂直(除非另有说明)

| 符号 | 参数 | 条件 | 最小值 | 典型值 | 最大值 | 单位 | 备注 |
|---|---|---|---|---|---|---|---|
| CR | 对比度 | 室内 | 8:1 | - | - | - | 注8-1,8-2 |
| R | 白色反射率 | - | - | 30 | - | % | |
| GN | 2灰度级 | - | - | DS+(WS-DS)*n(m-1) | - | - | 注8-3 |
| T_update | 图像更新时间 | 23℃ | - | 4 | - | sec | |
| Life | 寿命 | TOPR | - | 1000000次或5年 | - | - | |

### 备注
- 8-1：亮度计：Eye-One Pro分光光度计
- 8-2：CR=全白像素表面反射率/全黑像素表面反射率
- 8-3：WS=白态，DS=暗态

## 9. 操作、安全与环境要求
### 警告
- 显示器玻璃掉落或撞击硬物可能破裂，请小心操作。
- 若显示器破裂，请勿接触电泳材料。若不慎接触，请用肥皂水清洗。

### 注意事项
- 显示模块不应暴露在酸、碱等腐蚀性有害气体中。
- 请勿拆卸显示模块，否则会造成永久性损坏并使保修失效。
- 请遵守处理精密电子元件的通用注意事项。玻璃易碎，前表面易损坏，且显示器对静电和恶劣环境条件敏感。

### 数据手册状态
本数据手册包含最终产品规格。

### 极限值
给出的极限值符合IEC 134绝对最大额定值系统。超过一个或多个极限值可能导致器件永久性损坏。这些仅为应力额定值，不暗示器件可在这些或特性部分规定以外的任何条件下工作。长时间暴露在极限值下可能影响器件可靠性。

### 应用信息
所提供的应用信息仅为参考，不构成规格书的一部分。

## 10. 可靠性测试
| 序号 | 测试项目 | 测试条件 |
|---|---|---|
| 1 | 低温存储 | T=-25℃，240h，白图案测试 |
| 2 | 高温存储 | T=60℃，RH=35%，240h，白图案测试 |
| 3 | 高温工作 | T=40℃，RH=35%，240h |
| 4 | 低温工作 | 0℃，240h |
| 5 | 高温高湿工作 | T=40℃，RH=80%，240h |
| 6 | 高温高湿存储 | T=50℃，RH=90%，240h，白图案测试 |
| 7 | 温度循环 | 1周期：[-25℃ 30min] → [+60℃ 30min]，共50周期，白图案测试 |
| 8 | 抗紫外线照射 | 765W/m²，168h，40℃，白图案测试 |
| 9 | ESD静电枪 | 成品外壳：空气±15KV，接触±8KV<br>裸EPD(不含IC和FPC区域)：空气±8KV，接触±6KV<br>裸EPD(含IC和FPC区域)：空气±4KV，接触±2KV |

**注意**：测试完成后在常温下放置1小时，显示性能正常即为合格。

## 11. 典型SPI接口应用电路
### 电路连接
- 电源：VDD、VDDIO、VCI接3.3V，VSS接地
- SPI接口：CSB、RST_N、SCL、SDA、DC、BS接MCU对应引脚
- 控制引脚：BUSY_N接MCU输入引脚
- 温度传感器：TSCL、TSDA接外部I2C温度传感器(需上拉)
- 电源引脚：VGH、VGL、VDH、VDL、VDHR、VCOM接对应滤波电容
- 外部元件：NMOS管Q1、电阻R1、多个滤波电容、肖特基二极管、电感

### 推荐元器件
1. **开关NMOS**：Vishay Si1308EDL
   - VDS>20V，ID>500mA，VGS(th)<1.5V
   - Ciss<200pF，RDS(on)<400mΩ
2. **肖特基二极管**：OnSemi MBR0530
   - VR>20V，IF>500mA
   - IR<1mA @VR=15V，TA=100℃
3. **电感**：Bourns SRN2010TA-1R5Y
   - DCR=0.5Ω，Isat=1.2A @25℃

### 推荐电阻要求
| 类别 | 引脚 | 电阻要求 |
|---|---|---|
| 电源 | VDD, VDDA, VDDIO, GND, GNDA, VDM | <10Ω |
| 升压 | VGL, VGH, GDR, RESE | <10Ω |
| 调节器 | VDH, VDL, VDHR, VCOM, VDDD, VDDO | <10Ω |
| 逻辑 | MS, BS, CSB, SCL, SDA, SDA1, GDR等 | <50Ω |
| OTP | VPP | <20Ω |

## 12. 典型操作流程
### 12.1 正常操作流程
```
开始
  ↓
在VDD/VDDA/VDDIO上施加2.3V~3.6V，等待VDD达到95%×(2.3V~3.6V)至少1ms
  ↓
复位IC
  ↓
复位完成：RST_N=高，BUSY=高，VDD电流≤34uA
  ↓
初始化IC：
  PSR(R00H) → PWR(R01H) → PFS(R03H) → BTST(R06H)
  PLL(R30H) → CDI(R50H) → TCON(R60H) → VDCS(R82H) → PWS(RE3H)
  ↓
初始化完成
  ↓
显示流程：
  TRES(R61H) → GSST(R65H) → DTM1(R10H)写入图像数据
  → DTM2(R13H)写入图像数据 → PON(R04H)
  ↓
检查BUSY=1
  ↓
DRF(R12H)刷新显示
  ↓
检查BUSY=1
  ↓
POF(R02H)关闭电源
  ↓
检查BUSY=1
  ↓
显示完成：VGH=VDD，VGL/VDH/VDHR/VDL=0V，VDD电流≤34uA
  ↓
(可选)进入深度睡眠
  ↓
深度睡眠完成：VDDDO≈0V，VDD电流≤1.1uA
  ↓
结束：移除VDD/VDDA/VDDIO电源至0V
```

**注意**：定义为输入类型的控制引脚不能浮空。

### 12.2 正常操作参考程序代码
```c
void Epaper_Init(void)
{
    Epaper_Write_Command(0x00);
    Epaper_Write_Data(0x0f);
}
```

## 13. 零件编号定义
TBD(待定)

## 14. 检验方法和条件
### 14.1 检验条件
| 项目 | 条件 |
|---|---|
| 照度 | 800~1500 lux |
| 温度 | 22℃±3℃ |
| 湿度 | 55±10%RH |
| 距离 | ≥30cm |
| 角度 | 法线0°，前后45° |
| 检验方法 | 目视 |

### 14.2 显示区域划分
- **A区**：有效显示区域
- **B区**：边框区域
- **C区**：从B区边缘到面板边缘

### 14.3 产品通用检验标准
#### 14.3.1 外观检验标准
##### 斑点缺陷(点、异物、气泡、凹痕等)
- 直径计算：D=(L+W)/2(L=长度，W=宽度)
- 两点间距≥10mm
- **A区标准**：
  - D>1mm：N=0
  - 0.8<D≤1mm：N≤1
  - 0.5<D≤0.8mm：N≤2
  - 0.25<D≤0.5mm：N≤3/cm²
  - D≤0.25mm：忽略，N<4个忽略
- **B/C区**：标准同A区
- 检验方法：目视
- 严重程度：MIN(轻微)

##### 线条缺陷(划痕、毛发等)
- 判定规则：W/L<1/4按线条判定，W/L≥1/4按点判定
- 两线间距≥5mm
- **7.5"-13.3"模块(不含7.5")**：
  - L>10mm或W>0.8mm：N=0
  - 5mm≤L≤10mm且0.5mm≤W≤0.8mm：N≤2
  - L≤5mm且W≤0.5mm：忽略
- **4.2"-7.5"模块(不含4.2")**：
  - L>8mm或W>0.2mm：N=0
  - 2mm<L<8mm且0.1mm<W<0.2mm：N<4
  - L≤2mm且W≤0.1mm：忽略
- **4.2"以下模块**：
  - L>5mm或W>0.2mm：N=0
  - 2mm≤L≤5mm且0.1mm≤W≤0.2mm：N≤4
  - L≤2mm且W≤0.1mm：忽略
- **B/C区**：忽略
- 检验方法：目视、膜厚计
- 严重程度：MIN(轻微)

##### 面板崩角和裂纹缺陷
- **面板崩角**：
  - 边缘崩角：7.5"以上(含7.5")模块：X≤6mm，Y≤1mm，Z≤T，N=3允许；7.5"以下模块：X≤3mm，Y≤1mm，Z≤T，N=3允许
  - 角落崩角：IC侧X≤2mm，Y≤2mm；非IC侧X≤1mm，Y≤1mm允许
  - 注意：崩角不得损坏边缘布线，不影响显示则允许
- **裂纹**：玻璃任何区域不允许有裂纹
- **毛边**：不超过外形尺寸正负偏差，X+Y≤0.2mm
- **面板翘曲**：翘曲高度H≤总面板长度×1%
- 检验方法：目视、膜厚计、卡尺
- 严重程度：MIN(轻微)

##### 防水膜缺陷
- 防水膜损坏、起皱、开边：不允许
- 超出模块边缘(按图纸)：不允许
- 边缘翘曲超过技术文件高度：不允许
- 检验方法：目视
- 严重程度：MIN(轻微)

##### 胶粘剂缺陷
- **RTV胶**：
  - 溢出超出面板侧边影响尺寸：不允许
  - 边缘无胶1mm且未暴露布线：允许
  - 胶高度超过显示表面：不允许
- **EC胶**：
  - 溢出超出面板侧边影响尺寸：不允许
  - 边缘无胶1mm且未暴露布线：允许
  - 胶高度超过显示表面：不允许
  - 点胶均匀，无明显凹陷、断裂、气泡、鼓包，不高于PS上表面，补胶直径≤1mm
- **银点胶**：
  - 单个银点点胶量≥1mm：允许
  - 双银点一个≥1mm且另一个有胶：允许
  - 面板上银点胶残留≤0.2mm：允许
- 检验方法：目视、膜厚计
- 严重程度：MIN(轻微)

##### FPC缺陷
- FPC/TCP损坏、金手指氧化、胶残留：不允许
- TCP冲切面毛边高度≤0.4mm：允许
- FPC损坏断裂：不允许
- 折痕不影响电气性能和显示：允许
- 检验方法：目视、卡尺
- 严重程度：MIN(轻微)

##### 保护膜缺陷
- 表面划痕、折痕但不影响保护功能：允许
- 边缘胶L≤5mm，W≤0.5mm，N=2，未进入显示区：允许
- 检验方法：目视
- 严重程度：MIN(轻微)

##### 其他缺陷
- **污渍**：可用>99%酒精正常擦除：允许
- **拉片**：位置和方向符合文件要求，保护膜可撕下
- **遮光胶带**：倾斜≤10°，平整无翘曲，完全覆盖IC
- **加强板**：平整无翘曲，不允许超出FPC左右边缘，左右可小于FPC边缘0.5mm
- **标签/喷码**：内容符合工单要求，粘贴位置符合技术文件要求
- 检验方法：目视、手动拉扯、膜厚计
- 严重程度：MIN(轻微)

## 15. 包装
- **包装类型**：PET托盘(TPET648480-0583A)
- **包装顺序**：
  1. 每个PET托盘放1个产品
  2. 15个PET托盘叠放，顶部放1个空托盘
  3. 16个托盘为一组放入内小纸箱
  4. 12个小纸箱放入一个外纸箱
  5. 包装完成
- **包装数量**：1×15×12=180个/外纸箱
- **纸箱尺寸**：
  - 小纸箱：190×160×80mm
  - 外纸箱：394×344×255mm
- **版本**：Ver.1
