sratle/WCH-Model-Terminal/docs/project/Protocol_Keyboard.md

# Keyboard 模块通信协议

## 1. 模块概述

- **模块类型编号**：`0x04`
- **模块 ID**：`0x20`（预留范围 `0x20~0x22`）

Keyboard 模块有三种物理形态，均通过 UART3 与 Core（V5F）通信：

| 子类型 | 名称 | 主要特征 |
|---|---|---|
| `0x01` | Keyboard-1（主键盘） | 40 配列，CH9329 串口转 HID，标准 USB HID 键盘输出 |
| `0x02` | Keyboard-2（游戏键盘） | 2 摇杆 + 6 按钮 + 3 钮子开关 + 2 旋转编码器，CH9329 串口转 HID（键盘+鼠标混合模式） |
| `0x03` | Keyboard-3（音乐键盘） | 24 触摸琴键（TTP229） + 3 推子 + 12 按钮，无 CH9329，直连 Core |

### 1.1 帧格式速查

Keyboard 模块通过 **UART3** 与 Core（V5F）通信，物理层参数：

| 参数 | 值 |
|---|-----|
| 波特率 | 230400 |
| 数据位 | 8 |
| 停止位 | 1 |
| 校验 | 无 |
| 流控 | 无 |

**帧结构**（总长度最大 264 字节）：

```
+--------+--------+--------+--------+--------+-------------+--------+--------+--------+--------+
|  HEAD  |  SRC   |  DST   |  LEN   |  CMD   |  DATA[0..N] | TAIL0  | TAIL1  | TAIL2  | TAIL3  |
| 1 byte | 1 byte | 1 byte | 1 byte | 1 byte |   N bytes   | 1 byte | 1 byte | 1 byte | 1 byte |
+--------+--------+--------+--------+--------+-------------+--------+--------+--------+--------+
```

- **HEAD**：固定 `0xAA`。仅在接收状态机处于“等待帧头”时识别为新帧起始，数据域中的 `0xAA` 不会触发重解析。
- **LEN**：`CMD + DATA` 的总字节数，即 `N = LEN - 1`，范围 `1 ~ 255`。`LEN = 1` 表示 DATA 为空。
- **DATA**：数据域，长度由 LEN 推导，最大 255 字节。
- **TAIL**：固定序列 `A5 5A FC FD`，任一字节不匹配则丢弃整帧。

**常用模块 ID**：

| ID | 模块 |
|----|---|
| `0x00` | Core（主控） |
| `0x20` | Keyboard（本模块） |

**帧长度计算**：
```
总帧长 = 1(HEAD) + 1(SRC) + 1(DST) + 1(LEN) + 1(CMD) + N(DATA) + 4(TAIL)
       = 9 + N
       = 8 + LEN
```

> 完整协议规范（含接收状态机、通用操作码 `0x00~0x0F`、NACK 错误码定义）见 `PROJECT.md`。

---

## 2. 操作码定义

Keyboard 模块专用操作码范围为 `0x21 ~ 0x2F`，按模块 ID 高 4 位 `0x2` 统一分配。

### 2.1 基础操作码（0x21 ~ 0x2F）

| 操作码 | 宏名 | 方向 | 说明 | DATA 格式 |
| --- | --- | --- | --- | --- |
| `0x21` | `CMD_KBD_SET_BACKLIGHT` | Core -> Keyboard | 设置键盘背光 | `[模式:1][亮度:1]` |
| `0x22` | `CMD_KBD_GET_BACKLIGHT` | Core -> Keyboard | 获取背光状态 | 无，Keyboard 回复 ACK + `[模式:1][亮度:1]` |
| `0x23` | `CMD_KBD_SET_CONFIG` | Core -> Keyboard | 设置配置参数（键映射等） | `[配置项:1][配置值:变长]` |
| `0x24` | `CMD_KBD_GET_STATUS` | Core -> Keyboard | 获取键盘状态 | `[状态类型:1]`，Keyboard 回复 ACK + 状态数据 |
| `0x25` | `CMD_KBD_HID_REPORT` | Keyboard -> Core | HID 输入报告（Keyboard-1/2） | `[报告类型:1][HID报告数据:变长]` |
| `0x26` | `CMD_KBD_MUSIC_KEYS` | Keyboard -> Core | 音乐键盘琴键位图（Keyboard-3） | `[位图:3]` |
| `0x27` | `CMD_KBD_MUSIC_BUTTONS` | Keyboard -> Core | 音乐键盘按钮位图（Keyboard-3） | `[位图:2]` |
| `0x28` | `CMD_KBD_MUSIC_FADERS` | Keyboard -> Core | 音乐键盘推子值（Keyboard-3） | `[推子1:2][推子2:2][推子3:2]` |
| `0x29` | `CMD_KBD_GAME_INPUT` | Keyboard -> Core | 游戏键盘输入事件 | `[ROC1_X:uint8][ROC1_Y:uint8][ROC2_X:uint8][ROC2_Y:uint8][按钮:1][开关:1][EC1增量:int8][EC2增量:int8][编码器按下:1]` |
| `0x2A` | `CMD_KBD_MUSIC_EVENT_CTRL` | Core -> Keyboard | 开始/停止音乐键盘事件定时上报 | `[状态:1]` |
| `0x2B~0x2F` | — | — | 预留 | — |

---

## 3. ACK/NACK 响应规则

### 3.1 设计原则

ACK/NACK 由**命令语义**决定：

| 语义类别 | 说明 | 响应要求 |
|---|---|---|
| **查询 (Query)** | 请求获取某信息 | **必须 ACK + 数据** |
| **动作 (Action)** | 请求执行某操作 | **必须 ACK（空）或 NACK** |
| **设置 (Set)** | 修改某参数/状态 | **发送即忘，不响应** |
| **事件 (Event)** | 单向输入/状态上报 | **不需要响应** |

> **发送即忘**：Core 向 Keyboard 发送设置类命令后不需要等待 ACK。Keyboard 被动执行，不支持时静默丢弃。

### 3.2 操作码响应要求

| 码 | 命令 | 语义 | 接收方行为 |
|---|---|---|---|
| `0x21` | SET_BACKLIGHT | 设置 | 发送即忘，Keyboard 不回复 |
| `0x22` | GET_BACKLIGHT | 查询 | Keyboard 回复 ACK + `[模式:1][亮度:1]` |
| `0x23` | SET_CONFIG | 设置 | 发送即忘，Keyboard 不回复 |
| `0x24` | GET_STATUS | 查询 | Keyboard 回复 ACK + 状态数据 或 NACK |
| `0x25` | HID_REPORT | 事件 | Core 不回复 |
| `0x26` | MUSIC_KEYS | 事件/状态 | Core 不回复（事件上报时）；ACK + 数据（查询响应时） |
| `0x27` | MUSIC_BUTTONS | 事件/状态 | Core 不回复（事件上报时）；ACK + 数据（查询响应时） |
| `0x28` | MUSIC_FADERS | 事件/状态 | Core 不回复（事件上报时）；ACK + 数据（查询响应时） |
| `0x29` | GAME_INPUT | 事件 | Core 不回复 |
| `0x2A` | MUSIC_EVENT_CTRL | 设置 | 发送即忘，Keyboard 不回复 |

### 3.3 ACK / NACK 帧格式

**ACK 帧**：
```
[AA][DST][SRC][LEN][CMD=0x04][DATA...][A5][5A][FC][FD]
```
- SRC/DST 与原请求**交换**
- DATA 可选携带响应数据，`LEN = 1 + data_len`
- 空 ACK：`LEN = 01`，无 DATA

**NACK 帧**：
```
[AA][DST][SRC][02][CMD=0x05][错误码:1][A5][5A][FC][FD]
```
- DATA[0] = 错误码（1 字节），详见 `PROJECT.md` 通用协议错误码定义
- `LEN = 02`

### 3.4 Core 侧超时处理

Core 发送**查询类**命令后，应在 **500ms** 内收到 ACK/NACK。超时后由应用层处理。**协议层不实现自动重传**。

---

## 4. 数据格式详解

### 4.1 背光控制格式（CMD 0x21 / 0x22）

**设置背光（Core → Keyboard，0x21）**：
```
DATA[0]: 背光模式（1字节）
  - 0x00: 关闭
  - 0x01: 常亮
  - 0x02: 呼吸灯
  - 0x03: 跑马灯
  - 0x04: 随按键点亮
  - 0x80~0xFF: 用户自定义
DATA[1]: 亮度（1字节，0~100，0xFF=不变）
```

**获取背光响应（Keyboard → Core，ACK）**：
```
DATA[0]: 当前背光模式（1字节）
DATA[1]: 当前亮度（1字节，0~100）
```

### 4.2 配置设置/查询格式（CMD 0x23 / 0x24）

**设置配置（Core → Keyboard，0x23）**：
```
DATA[0]: 配置项（1字节）
  - 0x00: 键位映射层（0=默认层, 1=Fn层, 2=自定义层1...）
  - 0x01: 单个键映射（DATA[1]=物理键ID, DATA[2]=映射键码）
  - 0x02: 去抖时间（DATA[1]=毫秒，1字节）
  - 0x03: 重复按键速率（DATA[1]=字符/秒，1字节）
  - 0x80~0xFF: 用户自定义配置项
DATA[1..N]: 配置值（变长，由配置项决定长度）
```

**获取状态（Core → Keyboard，0x24）**：
```
DATA[0]: 状态类型（1字节）
  - 0x00: 查询音乐键盘琴键状态 → 回复 ACK，DATA 格式同 4.4 节
  - 0x01: 查询音乐键盘按钮状态 → 回复 ACK，DATA 格式同 4.5 节
  - 0x02: 查询音乐键盘推子状态 → 回复 ACK，DATA 格式同 4.6 节
  - 0x03: 查询游戏键盘输入状态 → 回复 ACK，DATA 格式同 4.7 节
  - 0x04: 查询当前按键矩阵状态 → 回复 ACK + `[按键位图:变长]`
  - 0x05: 查询音乐键盘事件上报状态 → 回复 ACK + `[状态:1]`（0=停止，1=运行）
```

### 4.3 HID 输入报告格式（CMD 0x25）

Keyboard-1（主键盘）和 Keyboard-2（游戏键盘）通过 CH9329 获取 HID 报告，通过本命令上报给 Core。

```
DATA[0]: 报告类型（1字节）
  - 0x00: 键盘报告（仿 HID Keyboard Boot Report）
  - 0x01: 鼠标报告（仿 HID Mouse Boot Report）

DATA[1..N]: HID 报告数据（N = LEN - 2）
```

**键盘报告（类型 = 0x00，N = 8）**：
```
DATA[1]: 修饰键（bitmask）
  - bit0: Left Ctrl    - bit1: Left Shift
  - bit2: Left Alt     - bit3: Left GUI
  - bit4: Right Ctrl   - bit5: Right Shift
  - bit6: Right Alt    - bit7: Right GUI
DATA[2]: 保留（0x00）
DATA[3]: 键码 0（USB HID Usage ID，0x00 表示空槽）
DATA[4]: 键码 1
DATA[5]: 键码 2
DATA[6]: 键码 3
DATA[7]: 键码 4
DATA[8]: 键码 5
```

> 最多同时上报 6 个非修饰键。释放按键时对应键码槽填 `0x00`。

**鼠标报告（类型 = 0x01，N = 4）**：
```
DATA[1]: 按钮状态（bitmask）
  - bit0: 左键    - bit1: 右键    - bit2: 中键
DATA[2]: X 轴偏移（int8，-128~127，正值向右）
DATA[3]: Y 轴偏移（int8，-128~127，正值向下）
DATA[4]: 滚轮偏移（int8，正值为远离用户/向上滚动）
```

### 4.4 音乐键盘琴键格式（CMD 0x26）

Keyboard-3（音乐键盘）上报 24 个琴键的按下/释放位图。

```
DATA[0]: 琴键位图 byte0（bit0=键1/C4, bit1=键2/C#4, ..., bit7=键8/G4）
DATA[1]: 琴键位图 byte1（bit0=键9/G#4, ..., bit7=键16/D#5）
DATA[2]: 琴键位图 byte2（bit0=键17/E5, ..., bit7=键24/B5）
```

> 位图共 3 字节（24 bit），bit = 1 表示按下，bit = 0 表示释放。
> 键 ID 与 MIDI note 的关系：`MIDI note = 59 + 键 ID`（键 1 = C4 = MIDI 60）。
> LEN = 4（CMD + 3 字节位图）。
> 无按键按下时 3 字节全为 `0x00`。

**示例**：同时按下 C4（键1）、E4（键5）和 G4（键8）
```
LEN = 04
DATA[0] = 0x91  /* bit0(键1/C4) + bit4(键5/E4) + bit7(键8/G4) = 0b10010001 */
DATA[1] = 0x00
DATA[2] = 0x00
```

### 4.5 音乐键盘按钮格式（CMD 0x27）

```
DATA[0]: 按钮位图低字节（bit0=KEY1, bit1=KEY2, ..., bit7=KEY8）
DATA[1]: 按钮位图高字节（bit0=KEY9, bit1=KEY10, bit2=KEY11, bit3=KEY12, bit4~7=预留）
```

> 位图共 2 字节（12 bit 有效），bit = 1 表示按下，bit = 0 表示释放。
> DATA[1] 的 bit4~7 为预留位，应置 0。
> LEN = 3（CMD + 2 字节位图）。

**示例**：KEY1 和 KEY7 同时按下
```
LEN = 03
DATA[0] = 0x41  /* bit0(KEY1) + bit6(KEY7) = 0b01000001 */
DATA[1] = 0x00
```

### 4.6 音乐键盘推子格式（CMD 0x28）

```
DATA[0..1]: 推子 1 值（uint16 大端，0~65535，左推子 FADER_L）
DATA[2..3]: 推子 2 值（uint16 大端，0~65535，中推子 FADER_M）
DATA[4..5]: 推子 3 值（uint16 大端，0~65535，右推子 FADER_R）
```

> 推子值 0 表示最低位置，65535 表示最高位置。
> 推子为电位器通过 ADC 采集，原始 12-bit（0~4095）左移映射到 16-bit。
> LEN = 7（CMD + 6 字节）。

### 4.7 游戏键盘输入格式（CMD 0x29）

Keyboard-2（游戏键盘）上报 2 个摇杆、6 个按钮、3 个钮子开关、2 个旋转编码器的完整状态。

**HID 映射方案（CH9329 混合模式，实际固件实现）**：

| 输入设备 | CH9329 HID 映射 | 说明 |
|---|---|---|
| ROC1 方向 | 方向键（Up/Down/Left/Right） | 带迟滞：压下 <100/>200，释放 <120/>180；X/Y 轴硬件互换已在固件修正 |
| ROC2 X/Y | 鼠标相对移动 | (值-128)/8 缩放，保留模拟精度 |
| BUT1 | 鼠标左键 | mouse button bit0 |
| BUT2 | 鼠标右键 | mouse button bit1 |
| BUT3~BUT6 | H/J/K/L 键盘键 | |
| SW1 | Left Shift | 修饰键 bit1（上拨=按下） |
| SW2 | Left Ctrl | 修饰键 bit0（上拨=按下） |
| SW3 | Left Alt | 修饰键 bit2（上拨=按下） |
| EC1 旋转 | 鼠标 Y 轴偏移 | 增量 ×3 叠加 |
| EC2 旋转 | 鼠标 X 轴偏移 | 增量 ×3 叠加 |
| EC1_D | 鼠标中键 | button bit2 |
| EC2_D | 未映射 | 预留 |

> 钮子开关映射为修饰键：SW UP 位置 = 修饰键按下，SW 中间/DOWN = 修饰键释放。

**Core 协议数据格式**：

```
DATA[0]: ROC1_X 轴（uint8，0~255，中心=128）
DATA[1]: ROC1_Y 轴（uint8，0~255，中心=128）
DATA[2]: ROC2_X 轴（uint8，0~255，中心=128）
DATA[3]: ROC2_Y 轴（uint8，0~255，中心=128）
DATA[4]: 按钮位图（bitmask）
  - bit0: BUT1    - bit1: BUT2
  - bit2: BUT3    - bit3: BUT4
  - bit4: BUT5    - bit5: BUT6
  - bit6~7: 预留
DATA[5]: 钮子开关状态（bitmask）
  - bit0~1: SW1 状态（00=中间, 01=UP, 10=DOWN, 11=保留）
  - bit2~3: SW2 状态（00=中间, 01=UP, 10=DOWN, 11=保留）
  - bit4~5: SW3 状态（00=中间, 01=UP, 10=DOWN, 11=保留）
  - bit6~7: 预留
DATA[6]: EC1 旋转增量（int8，正=顺时针，负=逆时针，读后清零）
DATA[7]: EC2 旋转增量（int8，正=顺时针，负=逆时针，读后清零）
DATA[8]: 编码器按下位图（bitmask）
  - bit0: EC1_D（编码器1按下）
  - bit1: EC2_D（编码器2按下）
  - bit2~7: 预留
```

> 摇杆中心位置为 (128, 128)，经过死区处理后上报。
> 按钮按下对应 bit 置 1，释放置 0。
> 编码器增量为累积值，Core 读取后 Keyboard 侧清零。
> LEN = 10（CMD + 9 字节 DATA）。
> 上报周期建议 10~20ms，仅在数据变化时上报（节省带宽）。

### 4.8 音乐键盘事件控制格式（CMD 0x2A）

Core 向 Keyboard-3 发送，控制是否开启事件定时上报。

```
DATA[0]: 控制状态（1字节）
  - 0x00: 停止事件上报（进入待机模式）
  - 0x01: 开始事件上报（进入定时上报模式）
```

> 发送即忘，Keyboard 不回复 ACK/NACK。
> Keyboard-3 上电后默认处于待机模式，仅响应心跳和查询，不主动上报事件。
> 收到 0x01 后开始按固定周期上报琴键（0x26）、按钮（0x27）、推子（0x28）状态。
> 收到 0x00 后停止上报，回到待机模式。

---

## 5. CMD_GET_TYPE 响应

Keyboard 模块响应 `CMD_GET_TYPE` 时，`CMD_ACK` 的 DATA 格式如下：

| 字节 | 字段 | 值/说明 |
|---|---|---|
| DATA[0] | 模块类型编号 | `0x04` |
| DATA[1] | 模块子类型编号 | 见下表 |
| DATA[2] | 硬件版本号 | 键盘硬件版本 |
| DATA[3] | 固件主版本号 | 键盘固件主版本 |
| DATA[4] | 固件次版本号 | 键盘固件次版本 |

> **身份 ACK 指纹约束**：Core 按 `LEN == 6 且 DATA[0] == 0x04` 识别 GET_TYPE 身份 ACK
> 并刷新槽位在线状态与 `type_id`。因此：
> 1. 身份 ACK 数据域**固定 5 字节**，不支持扩展字节（原"DATA[5..N] 扩展信息"已废弃）；
> 2. 查询类 ACK 数据域长度**不得为 5 字节**（现有查询均满足：背光 2B、琴键位图 2B、
>    按钮位图 1B、推子 6B、事件控制 1B、游戏输入 9B），新增查询命令时必须遵守。

**Keyboard 子类型定义**

> 代码宏定义：`protocol.h` → `MODULE_SUBTYPE_KEYBOARD_*`

| 子类型编号 | 宏名 | 实现名称 | 说明 |
|---|---|---|---|
| `0x00` | `MODULE_SUBTYPE_KEYBOARD_RESERVED` | 保留 | 系统保留 |
| `0x01` | `MODULE_SUBTYPE_KEYBOARD_MAIN` | Main Keyboard | 主键盘（标准 40 配列 + CH9329） |
| `0x02` | `MODULE_SUBTYPE_KEYBOARD_GAME` | Game Keyboard | 游戏键盘（摇杆 + 自定义按键 + CH9329） |
| `0x03` | `MODULE_SUBTYPE_KEYBOARD_MUSIC` | Music Keyboard | 音乐键盘（24 触摸琴键 + 3 推子 + 12 按钮） |
| `0x04~0xFF` | — | 预留 | 未来扩展 |

---

## 6. 版本记录

| 版本 | 日期 | 说明 |
|---|---|---|
| V1.0 | 2026-04-24 | 初始版本：定义 HID 报告、音乐键盘、游戏键盘操作码及数据格式 |
| V1.1 | 2026-06-08 | Keyboard-3 硬件对齐：24 键位图、12 按钮位图、3 推子；新增事件控制命令（0x2A）；移除旋钮；修正 HID 报告适用模块 |
| V1.2 | 2026-07-06 | Keyboard-2 硬件对齐：2 摇杆 + 6 按钮 + 3 钮子开关 + 2 旋转编码器；扩展 GAME_INPUT(0x29) 数据格式至 9 字节；定义 CH9329 键盘+鼠标混合模式 HID 映射 |
| V1.3 | 2026-07-27 | 热插拔可靠性加固：身份 ACK 指纹约束（LEN 固定 6，废弃扩展字节，查询 ACK 数据域禁止 5 字节）——修复背光/推子等查询 ACK 被 Core 误认身份帧污染 type_id 的缺陷；键盘失联时 Core 复位 type_id；模块侧 USART ISR 增加 ORE 清除 |
| V1.4 | 2026-08-08 | 文档对齐实际固件：Keyboard-2 HID 映射修正为实际实现（ROC1→方向键带迟滞、ROC2→鼠标移动 ÷8、EC 增量 ×3、EC1_D→鼠标中键、EC2_D 未映射、X/Y 轴硬件互换说明）；Keyboard-1 补充 74HC165 级联 39 键方案与 HID 报告节流说明（模块文档侧） |
