sratle/WCH-Model-Terminal/docs/project/Protocol_Wireless.md

# Wireless 模块通信协议

## 1. 模块概述

- **模块类型编号**：`0x02`
- **模块 ID**：`0x01`
- **物理接口**：SPI（CH585F 侧 = SPI0 Slave，Core 侧 V5F = SPI4 Master，同一物理链路两侧外设编号不同）

CH585F 为独立 RISC-V MCU，内置 **BLE 协议栈**，与 Core 通过 SPI 进行全双工通信。应用层载荷严格遵循统一紧凑二进制协议格式。

> **注意**：CH585F 仅支持 **BLE（低功耗蓝牙）**，不支持 Bluetooth Classic，因此不支持 A2DP、SPP 等 Classic 协议。当前固件仅实现 **Peripheral 角色**（APP CLI 数据通道）；Central 角色（BLE 键鼠 HID over GATT）在协议层预留、固件未实现。

### 1.1 帧格式速查

SPI 物理层参数：

| 参数 | 值 |
|---|-----|
| 接口 | CH585F 侧 SPI0 Slave / Core 侧 SPI4 Master |
| 角色 | V5F = Master，CH585F = Slave |
| 数据位 | 8 |
| 时钟极性 | CPOL Low（Mode 0） |
| 时钟相位 | CPHA 1Edge |
| NSS | 软件控制；CH585F 复用 NSS 线产生上行通知脉冲 |
| 收发缓冲 | CH585F 侧 RX/TX 各 20KB 环形缓冲 |

**标准帧结构**（总长度最大 264 字节，DATA ≤ 255 字节）：

```
+--------+--------+--------+--------+--------+-------------+--------+--------+--------+--------+
|  HEAD  |  SRC   |  DST   |  LEN   |  CMD   |  DATA[0..N] | TAIL0  | TAIL1  | TAIL2  | TAIL3  |
| 1 byte | 1 byte | 1 byte | 1 byte | 1 byte |   N bytes   | 1 byte | 1 byte | 1 byte | 1 byte |
+--------+--------+--------+--------+--------+-------------+--------+--------+--------+--------+
```

- **HEAD**：固定 `0xAA`。仅在接收状态机处于"等待帧头"时识别为新帧起始，数据域中的 `0xAA` 不会触发重解析。
- **LEN**：`CMD + DATA` 的总字节数，即 `N = LEN - 1`，范围 `1 ~ 255`。`LEN = 1` 表示 DATA 为空。
- **DATA**：数据域，长度由 LEN 推导，最大 255 字节。
- **TAIL**：固定序列 `A5 5A FC FD`，任一字节不匹配则丢弃整帧。

**流式帧结构**（用于大数据量传输，DATA 长度不受 255 字节限制）：

```
+--------+--------+--------+--------+--------+-------------+--------+--------+--------+--------+
|  HEAD  |  SRC   |  DST   |  0xFF  |  CMD   |  DATA[0..N] | TAIL0  | TAIL1  | TAIL2  | TAIL3  |
| 1 byte | 1 byte | 1 byte | 1 byte | 1 byte |  N bytes    | 1 byte | 1 byte | 1 byte | 1 byte |
+--------+--------+--------+--------+--------+-------------+--------+--------+--------+--------+
```

- **LEN = 0xFF**：特殊值，表示本帧为**流式帧**，DATA 长度不由 LEN 字段决定，而是通过扫描帧尾序列 `A5 5A FC FD` 来确定。
- **DATA 最大长度**：受实现限制，建议单帧不超过 20KB。
- **帧尾冲突处理**：若 DATA 中偶然出现与帧尾相同的字节序列，接收方状态机需支持**回退解析**（详见 1.3 节）。

**常用模块 ID**：

| ID | 模块 |
|----|---|
| `0x00` | Core（主控） |
| `0x01` | Wireless / CH585F（本模块） |

**帧长度计算**：
```
标准帧总帧长 = 1(HEAD) + 1(SRC) + 1(DST) + 1(LEN) + 1(CMD) + N(DATA) + 4(TAIL)
             = 9 + N
             = 8 + LEN

流式帧总帧长 = 9 + N（N 由帧尾位置决定，N 可为任意值）
```

> 完整协议规范（含通用操作码 `0x00~0x0F`、NACK 错误码定义）见 `PROJECT.md`。

### 1.2 流式帧尾扫描与回退机制

当 LEN = 0xFF 时，接收状态机不预先计算 DATA 长度，而是逐字节扫描帧尾序列。为避免 DATA 中偶然出现的帧尾字节被误识别，状态机采用以下回退策略：

```
WAIT_STREAM_DATA:
  - 收到 TAIL0 (0xA5)：进入 TENTATIVE_TAIL1，暂存该字节位置
  - 收到其他字节：存入 DATA 缓冲区

TENTATIVE_TAIL1:
  - 收到 TAIL1 (0x5A)：进入 TENTATIVE_TAIL2
  - 收到其他字节：将之前暂存的 TAIL0 和当前字节均存入 DATA，返回 WAIT_STREAM_DATA

TENTATIVE_TAIL2:
  - 收到 TAIL2 (0xFC)：进入 TENTATIVE_TAIL3
  - 收到其他字节：将之前暂存的 TAIL0、TAIL1 和当前字节均存入 DATA，返回 WAIT_STREAM_DATA

TENTATIVE_TAIL3:
  - 收到 TAIL3 (0xFD)：帧完整，提交处理
  - 收到其他字节：将之前暂存的 TAIL0、TAIL1、TAIL2 和当前字节均存入 DATA，返回 WAIT_STREAM_DATA
```

> 此机制保证 DATA 中即使出现完整的 `A5 5A FC FD` 序列（概率极低，约 2.3e-10），也只会提前结束当前帧。应用层可通过帧完整性校验（如下一帧 HEAD 是否正确）检测并恢复。

### 1.3 SPI 通信特殊说明

CH585F 作为 **SPI Slave**，无法主动发起数据传输。当前实现采用**通知 + 轮询双保险**：

1. **NSS 通知脉冲（主路径）**：CH585F 有上行数据入 TX 缓冲时，在 NSS 线上产生通知脉冲
   （`SPI_Slave_NotifyMaster()`），Core 侧 EXTI 置位标志后发起 SPI 读取事务。
2. **周期保活轮询（兜底）**：Core 主循环每 10ms 至少发起一次全双工事务
   （`CH585F_BT_Poll()`，每次交换固定长度字节，无数据补 `0x00` dummy），
   防止通知丢失造成死锁；Core 有下行数据待发时也立即发起事务。
3. **全双工复用**：每次事务同时完成下行发送与上行接收。

---

## 2. 操作码定义

Wireless 模块专用操作码范围为 `0x50 ~ 0x5F`（特例，不参与模块 ID 高 4 位映射）。当基础操作码空间不足时，使用扩展操作码机制。

> **实现状态（2026-08）**：当前 CH585F 固件仅实现 `CMD_GET_TYPE`(0x01)、
> `CMD_BT_GET_STATUS`(0x51)、`CMD_BT_RESET`(0x59) 与扩展码 `CMD_BT_EXT_CLI_DATA`(0x50/0x07)；
> 其余操作码为协议预留（Central 角色功能），收发两侧固件均未实现，
> CH585F 收到未实现的命令会回复 `NACK(PROTO_ERR_UNSUPPORTED_CMD)`。

### 2.1 基础操作码（0x51 ~ 0x5F）

| 操作码 | 宏名 | 方向 | 说明 | DATA 格式 |
| --- | --- | --- | --- | --- |
| `0x51` | `CMD_BT_GET_STATUS` | Core -> CH585F | 查询蓝牙连接状态 | 无，CH585F 回复 ACK + 状态数据 |
| `0x52` | `CMD_BT_SEND_DATA` | Core -> CH585F | 通过蓝牙发送原始数据（APP 数据通道） | `[数据:变长]` |
| `0x53` | — | — | 预留 | — |
| `0x54` | `CMD_BT_CONN_EVT` | CH585F -> Core | 蓝牙连接/断开/配对事件 | `[事件类型:1][设备类型:1][MAC:6][名称:16]` |
| `0x55` | `CMD_BT_RECV_DATA` | CH585F -> Core | 蓝牙接收到数据上报（APP 数据通道） | `[数据:变长]` |
| `0x56` | `CMD_BT_HID_REPORT` | CH585F -> Core | HID 输入事件上报（BLE 键鼠） | `[报告类型:1][HID数据:变长]` |
| `0x57` | — | — | 预留 | — |
| `0x58` | `CMD_BT_SET_DISCOVERABLE` | Core -> CH585F | 设置可发现性/广播开关 | `[开关:1]` |
| `0x59` | `CMD_BT_RESET` | Core -> CH585F | 复位蓝牙模块 | `[确认码:0xA5]` |
| `0x5A~0x5F` | — | — | 预留 | — |

### 2.2 扩展操作码（CMD = 0x50，DATA[0] 为子命令）

| 扩展码 | 宏名 | 方向 | 说明 | DATA 格式 |
| --- | --- | --- | --- | --- |
| `0x01` | `CMD_BT_EXT_SCAN` | Core -> CH585F | 请求扫描/停止扫描 | `[操作:1][超时:1][过滤:1]` |
| `0x02` | `CMD_BT_EXT_DEVICE_LIST` | CH585F -> Core | 设备列表（扫描结果/配对列表） | `[列表类型:1][数量:1][设备信息:23字节×N]` |
| `0x03` | `CMD_BT_EXT_CONNECT` | Core -> CH585F | 请求连接/断开指定设备 | `[操作:1][MAC:6]` |
| `0x04` | `CMD_BT_EXT_PAIRING_MGMT` | 双向 | 配对设备管理（查询/删除/清空/结果） | `[操作:1][MAC(6)/结果(1)]` |
| `0x05` | `CMD_BT_EXT_SET_MODE` | Core -> CH585F | 设置蓝牙工作模式与广播参数 | `[模式:1][名称开关:1][自定义名:16]` |
| `0x06` | — | — | 预留 | — |
| `0x07` | `CMD_BT_EXT_CLI_DATA` | 双向 | APP CLI 数据通道 | `[FLAGS:1][数据:变长]` |
| `0x08` | — | — | 预留 | — |
| `0x09` | — | — | 预留 | — |
| `0x0A~0x3F` | — | — | 预留 | — |

---

## 3. ACK/NACK 响应规则

### 3.1 设计原则

ACK/NACK 由**命令语义**决定：

| 语义类别 | 说明 | 响应要求 |
|---|---|---|
| **查询 (Query)** | 请求获取某信息 | **必须 ACK + 数据** |
| **动作 (Action)** | 请求执行某操作 | **必须 ACK（空）或 NACK** |
| **设置 (Set)** | 修改某参数/状态 | **发送即忘，不响应** |
| **事件 (Event)** | 单向状态/输入上报 | **不需要响应** |

> **发送即忘**：Core 向 CH585F 发送设置类命令后不需要等待 ACK。CH585F 被动执行，不支持时静默丢弃。

### 3.2 操作码响应要求

| 码 | 命令 | 语义 | 接收方行为 |
|---|---|---|---|
| `0x51` | GET_STATUS | 查询 | CH585F 回复 ACK + 状态数据 |
| `0x52` | SEND_DATA | 动作 | CH585F 回复 ACK 空 或 NACK（缓冲区满时） |
| `0x53` | — | — | 预留 |
| `0x54` | CONN_EVT | 事件 | Core 不回复 |
| `0x55` | RECV_DATA | 事件 | Core 不回复 |
| `0x56` | HID_REPORT | 事件 | Core 不回复 |
| `0x57` | — | — | 预留 |
| `0x58` | SET_DISCOVERABLE | 设置 | 发送即忘，CH585F 不回复 |
| `0x59` | RESET | 动作 | CH585F 回复 ACK 空 或 NACK |
| `0x50/0x01` | SCAN | 动作 | CH585F 回复 ACK 空 或 NACK |
| `0x50/0x02` | DEVICE_LIST | 查询响应 | 发送即忘（作为扫描/查询的 ACK payload） |
| `0x50/0x03` | CONNECT | 动作 | CH585F 回复 ACK 空 或 NACK |
| `0x50/0x04` | PAIRING_MGMT | 动作/查询 | 双向 ACK 或 NACK |
| `0x50/0x05` | SET_MODE | 设置 | 发送即忘，CH585F 不回复 |
| `0x50/0x06` | — | — | 预留 |
| `0x50/0x07` | CLI_DATA | 数据通道 | **应用层自定义**，协议层不强制 ACK。建议采用流式帧（LEN=0xFF）传输。 |
| `0x50/0x08` | — | — | 预留 |
| `0x50/0x09` | — | — | 预留 |

### 3.3 ACK / NACK 帧格式

**ACK 帧**：
```
[AA][DST][SRC][LEN][CMD=0x04][DATA...][A5][5A][FC][FD]
```
- SRC/DST 与原请求**交换**
- DATA 可选携带响应数据，`LEN = 1 + data_len`
- 空 ACK：`LEN = 01`，无 DATA

**NACK 帧**：
```
[AA][DST][SRC][02][CMD=0x05][错误码:1][A5][5A][FC][FD]
```
- DATA[0] = 错误码（1 字节），详见 `PROJECT.md` 通用协议错误码定义
- `LEN = 02`

### 3.4 Core 侧超时处理

Core 发送**查询/动作类**命令后，应在 **500ms** 内收到 ACK/NACK。超时后由应用层处理。**协议层不实现自动重传**。

---

## 4. 数据格式详解

### 4.1 蓝牙状态格式（CMD 0x51 ACK）

CH585F 回复 `CMD_BT_GET_STATUS` 时使用以下格式：

```
DATA[0]: 状态位图（1字节）
  - bit0: 蓝牙开关状态（0=关闭, 1=开启）
  - bit1: 是否正在扫描（0=否, 1=是）
  - bit2: 是否有 BLE 设备已连接（0=否, 1=是）
  - bit3: APP 数据通道是否已连接（0=否, 1=是）
  - bit4~7: 预留

DATA[1]: 已连接设备数量（1字节）
DATA[2]: 当前工作模式（1字节）
  - 0x00: 待机/关闭
  - 0x01: HID Host 模式（扫描连接 BLE 键鼠）
  - 0x02: Peripheral 模式（广播等待 APP 作为 Central 连接）
  - 0x03: 并发模式（HID + APP 同时运行）

DATA[3..8]: 主连接设备 MAC 地址（6字节，无连接时全填 0x00）
```

> 总 DATA 长度：9 字节，`LEN = 10`。

### 4.2 蓝牙数据发送格式（CMD 0x52）

Core 通过本命令向已连接的 BLE 设备（如手机 APP）发送原始数据。

```
DATA[0..N]: 原始数据（变长，N ≤ 255，实际受 LEN 限制）
```

> 本命令为通用数据通道，不解析数据内容。若目标为 APP CLI，建议优先使用扩展码 `0x07`（`CMD_BT_EXT_CLI_DATA`）以获得更清晰的语义。

### 4.3 连接事件格式（CMD 0x54）

CH585F 在 BLE 设备连接、断开、配对状态变化时主动上报。

```
DATA[0]: 事件类型（1字节）
  - 0x00: 设备已连接
  - 0x01: 设备已断开
  - 0x02: 连接失败/超时
  - 0x03: 配对成功
  - 0x04: 配对请求（需用户确认）

DATA[1]: 设备类型（1字节）
  - 0x00: 未知
  - 0x01: BLE 键盘
  - 0x02: BLE 鼠标
  - 0x03: 其他 BLE HID 设备
  - 0x04: 手机/PC（APP）

DATA[2..7]: 设备 MAC 地址（6字节）
DATA[8..23]: 设备名称（16字节，不足补 0x00，UTF-8 编码）
```

> 总 DATA 长度：24 字节，`LEN = 25`。

### 4.4 蓝牙数据接收格式（CMD 0x55）

CH585F 收到 BLE 远端（如手机 APP）发来的数据后，通过本命令上报 Core。

```
DATA[0..N]: 原始数据（变长，N ≤ 255）
```

### 4.5 HID 报告格式（CMD 0x56）

CH585F 在连接的 BLE HID 设备（键盘/鼠标）有输入时上报。

```
DATA[0]: 报告类型（1字节）
  - 0x00: 键盘报告（仿 HID Keyboard Boot Report）
  - 0x01: 鼠标报告（仿 HID Mouse Boot Report）

DATA[1..N]: HID 报告数据（N = LEN - 2）
```

**键盘报告（类型 = 0x00，N = 8）**：
```
DATA[1]: 修饰键（bitmask）
  - bit0: Left Ctrl    - bit1: Left Shift
  - bit2: Left Alt     - bit3: Left GUI
  - bit4: Right Ctrl   - bit5: Right Shift
  - bit6: Right Alt    - bit7: Right GUI
DATA[2]: 保留（0x00）
DATA[3]: 键码 0（USB HID Usage ID，0x00 表示空槽）
DATA[4]: 键码 1
DATA[5]: 键码 2
DATA[6]: 键码 3
DATA[7]: 键码 4
DATA[8]: 键码 5
```

> 最多同时上报 6 个非修饰键。释放按键时对应键码槽填 `0x00`。

**鼠标报告（类型 = 0x01，N = 4）**：
```
DATA[1]: 按钮状态（bitmask）
  - bit0: 左键    - bit1: 右键    - bit2: 中键
DATA[2]: X 轴偏移（int8，-128~127，正值向右）
DATA[3]: Y 轴偏移（int8，-128~127，正值向下）
DATA[4]: 滚轮偏移（int8，正值为远离用户/向上滚动）
```

### 4.6 扫描请求格式（扩展码 0x01）

Core 请求 CH585F 开始或停止扫描周围 BLE 设备。

```
DATA[0]: 扩展码 = 0x01
DATA[1]: 操作类型（1字节）
  - 0x00: 开始扫描
  - 0x01: 停止扫描

DATA[2]: 扫描超时（1字节，单位秒，0 表示使用默认 10 秒）
DATA[3]: 设备类型过滤（1字节，bitmask）
  - bit0: HID 设备（键鼠）
  - bit1: 手机/PC（APP）
  - bit2~7: 预留
  - 0xFF: 不过滤（扫描所有 BLE 设备）
```

> 总 DATA 长度：4 字节，`LEN = 5`。

### 4.7 设备列表格式（扩展码 0x02）

CH585F 将扫描结果或已配对设备列表上报 Core。

```
DATA[0]: 扩展码 = 0x02
DATA[1]: 列表类型（1字节）
  - 0x00: 扫描结果
  - 0x01: 已配对设备列表

DATA[2]: 设备数量 N（1字节）
DATA[3]:      设备1状态（1字节）
  - 0x00: 已配对
  - 0x01: 已连接
  - 0x02: 发现中（仅扫描结果）
DATA[4..19]:  设备1名称（16字节，不足补 0x00，UTF-8 编码）
DATA[20..25]: 设备1 MAC 地址（6字节）
... 后续设备
```

> 每个设备信息固定 **23 字节**：状态(1) + 名称(16) + MAC(6)。
> 设备数量 `N = (LEN - 1 - 2) / 23`。
> 若设备列表超过单帧容量，可分多帧上报，或先以 `NACK`（`PROTO_ERR_LEN_MISMATCH`）拒绝，再由 Core 通过 `CMD_BT_EXT_PAIRING_MGMT`（查询）分批次获取。

### 4.8 连接/断开请求格式（扩展码 0x03）

Core 请求 CH585F 连接或断开指定 BLE 设备。

```
DATA[0]: 扩展码 = 0x03
DATA[1]: 操作类型（1字节）
  - 0x00: 断开指定设备
  - 0x01: 连接指定设备（需已配对或在最近扫描结果中）
  - 0x02: 断开所有已连接设备

DATA[2..7]: 目标设备 MAC 地址（6字节，操作类型为 0x00/0x01 时有效；0x02 时可填 0x00）
```

> 总 DATA 长度：8 字节，`LEN = 9`。

### 4.9 配对管理格式（扩展码 0x04）

双向命令，用于管理已配对设备列表。

**查询/删除/清空（Core -> CH585F）**：
```
DATA[0]: 扩展码 = 0x04
DATA[1]: 操作类型（1字节）
  - 0x00: 查询已配对列表
  - 0x01: 删除指定配对设备
  - 0x02: 清空所有配对记录

DATA[2..7]: MAC 地址（6字节，仅操作类型 0x01 时有效）
```

- 操作类型 `0x00`：CH585F 回复 ACK，其 DATA 使用扩展码 `0x02`（`CMD_BT_EXT_DEVICE_LIST`，列表类型 = `0x01`）。
- 操作类型 `0x01/0x02`：发送即忘，或回复 ACK 空。

**配对结果上报（CH585F -> Core）**：
```
DATA[0]: 扩展码 = 0x04
DATA[1]: 操作类型 = 0x03（配对结果）
DATA[2]: 结果状态（1字节）
  - 0x00: 配对成功
  - 0x01: 配对失败（拒绝/超时）
  - 0x02: 配对取消

DATA[3..8]: 设备 MAC 地址（6字节）
DATA[9..24]: 设备名称（16字节）
```

### 4.10 工作模式设置格式（扩展码 0x05）

Core 设置 CH585F 的蓝牙工作模式与广播参数。

```
DATA[0]: 扩展码 = 0x05
DATA[1]: 工作模式（1字节）
  - 0x00: 关闭蓝牙
  - 0x01: HID Host 模式（扫描连接 BLE 键鼠，不对外广播等待 APP）
  - 0x02: Peripheral 模式（广播等待 APP 作为 Central 连接）
  - 0x03: 双角色并发模式（Central 连接 BLE 键鼠 + Peripheral 被手机 APP 连接）

DATA[2]: 广播名称开关（1字节）
  - 0x00: 不修改广播名称
  - 0x01: 使用默认广播名称
  - 0x02: 使用后续自定义名称

DATA[3..18]: 自定义广播名称（16字节，不足补 0x00，仅当 DATA[2]=0x02 时有效）
```

> 总 DATA 长度：19 字节，`LEN = 20`。

### 4.11 CLI 数据格式（扩展码 0x07）

移动端 APP 通过 BLE 自定义 Profile 与 CH585F 建立数据通道，CH585F 通过本扩展码与 Core 双向透传 CLI 数据。

#### 4.11.1 标准帧模式（单帧 CLI 数据 ≤ 253 字节）

```
DATA[0]: 扩展码 = 0x07
DATA[1]: FLAGS（1字节）
  - bit0: SOF (Start of Frame) — 1 = 本条消息的首包
  - bit1: EOF (End of Frame)   — 1 = 本条消息的尾包
  - bit2~7: 预留，填 0

DATA[2..N]: CLI 原始数据（变长，UTF-8 编码）
```

> 总 DATA 长度：2 + N 字节，`LEN = 3 + N`。单帧 CLI 数据不超过 253 字节。

#### 4.11.2 流式帧模式（单帧 CLI 数据 > 253 字节，最大 20KB）

当单条 CLI 数据超过 253 字节时，使用**流式帧**（LEN = 0xFF）：

```
[AA][SRC][DST][0xFF][CMD=0x50][DATA: 07 FLAGS <CLI数据>][A5][5A][FC][FD]
```

- **LEN = 0xFF**：表示本帧为流式帧，DATA 长度不受 255 字节限制。
- **FLAGS**：同标准帧，bit0=SOF, bit1=EOF。
- **DATA 最大长度**：受实现限制，建议单帧不超过 20KB。
- **帧尾确定边界**：接收方通过扫描 `A5 5A FC FD` 确定帧结束，而非解析 LEN 字段。

**多帧拆分规则**：

若 CLI 数据超过单帧容量（甚至超过流式帧容量），可拆分为多帧：

```
帧 1: [AA][01][00][0xFF][50][07][01][数据块1...][A5][5A][FC][FD]  (SOF=1, EOF=0)
帧 2: [AA][01][00][0xFF][50][07][00][数据块2...][A5][5A][FC][FD]  (SOF=0, EOF=0)
帧 N: [AA][01][00][0xFF][50][07][02][数据块N...][A5][5A][FC][FD]  (SOF=0, EOF=1)
```

> 接收方通过 FLAGS 的 SOF/EOF 位判断整条 CLI 消息的起止。

**数据流向**：
- **下行**（APP -> CH585F -> Core）：APP 发送命令字符串，CH585F 重组完整消息后，通过本命令上报 Core，Core 转发给 `CLI_Process()` 解析执行。
- **上行**（Core -> CH585F -> APP）：`CLI_Process()` 的输出通过 `printf()` 经本命令下发给 CH585F，由 CH585F 经 BLE 回传 APP。

> 对于大输出（如 `tree`、`cat 大文件`），Core 应将输出分块发送，每块一个流式帧。CH585F 收到后立即通过 BLE Notify 转发给 APP，无需缓存完整 20KB。

---

## 5. CMD_GET_TYPE 响应

CH585F 模块响应 `CMD_GET_TYPE` 时，`CMD_ACK` 的 DATA 格式如下：

| 字节 | 字段 | 值/说明 |
|---|---|---|
| DATA[0] | 模块类型编号 | `0x02` |
| DATA[1] | 模块子类型编号 | `0x01`（`MODULE_SUBTYPE_WIRELESS_BT`，标准 BLE 模块） |
| DATA[2] | 硬件版本号 | CH585F 硬件版本（当前 `0x01`） |
| DATA[3] | 固件主版本号 | 固件主版本（当前 `0x01`） |
| DATA[4] | 固件次版本号 | 固件次版本（当前 `0x00`） |
| DATA[5] | 保留 | `0x00` |

> **注意**：Wireless 的 GET_TYPE ACK 数据域为 **6 字节**（LEN=7），与其他 UART 模块的
> 5 字节身份指纹规则不同；Wireless 不在 6 个 UART 心跳槽位内，不受该约束。

**Wireless 子类型定义**

> 代码宏定义：`protocol.h` → `MODULE_SUBTYPE_WIRELESS_*`

| 子类型编号 | 宏名 | 实现名称 | 说明 |
|---|---|---|---|
| `0x00` | `MODULE_SUBTYPE_WIRELESS_RESERVED` | 保留 | 系统保留 |
| `0x01` | `MODULE_SUBTYPE_WIRELESS_BT` | 标准 BLE 模块 | CH585F（BLE 5.4，支持 HID over GATT + 自定义数据通道） |
| `0x02~0xFF` | — | 预留 | 未来扩展 |

---

## 6. 版本记录

| 版本 | 日期 | 说明 |
|---|---|---|
| V1.0 | 2026-04-24 | 初始版本：定义 5 个基础操作码 |
| V2.0 | 2026-05-04 | 扩展并引入扩展操作码机制（基码 0x50），新增 HID 上报、扫描/连接/配对管理、APP CLI 等协议（**基于错误假设，误认为支持 Classic/A2DP**） |
| V2.1 | 2026-05-04 | 修正：根据 CH585F 数据手册，确认芯片仅支持 BLE（不支持 Classic/A2DP）。移除音频流、音频控制、OTA 相关操作码及数据格式；修正 HID 为 HID over GATT；修正工作模式描述。 |
| V2.2 | 2026-05-12 | 修正 CLI_DATA 格式：去除 DATA 中冗余的基码 0x50（CMD 字段已含 0x50）；新增流式帧机制（LEN=0xFF），支持单帧最大 20KB 数据传输，以帧尾为结束标志；新增帧尾回退解析机制说明。 |
| V2.3 | 2026-08-08 | 对齐实际固件：物理接口澄清为 CH585F 侧 SPI0 Slave / Core 侧 SPI4 Master；§1.3 改写为已实现的 NSS 通知脉冲 + 10ms 保活轮询机制；标注当前仅实现 GET_TYPE/GET_STATUS/RESET/CLI_DATA，Central 相关操作码为预留；GET_TYPE ACK 数据域修正为固定 6 字节（含保留字节） |
