sratle/WCH-Model-Terminal/docs/datasheet/TTP229-BSF.md

# TTP229-BSF TonTouch™

## 16键/8键触摸按键检测IC

**版本**：V1.1 | **初稿日期**：2009/12/22 | 页码：共16页
---

## 一、总体描述（GENERAL DESCRIPTION）

TTP229-BSF TonTouch™ 是一款专为触摸按键控制设计的**电容式感应IC**，芯片内置触摸传感器稳压器，感应方案稳定性强，可适配多种使用环境。
该芯片可透过非导电介质连接人机交互面板，主要用于替代传统机械开关/按键。这款专用标准产品（ASSP）可独立配置为**8路触摸按键**或**最多16路触摸按键**。

---

## 二、产品特性（FEATURES）

1. 工作电压：**2.4V ~ 5.5V**
2. 内置稳压器
3. 休眠电流（3V供电，休眠模式、采样率8Hz）
   - 16键模式：典型值 **2.5μA**
   - 8键模式：典型值 **2.0μA**
4. 可通过配置选择**8独立按键**或**16独立按键**模式
5. 8键模式可配置**8路独立并行输出**；8键/16键模式均支持**二线串行输出接口**
6. 8路独立输出可配置驱动类型：CMOS/开漏(OD)/集电极开路(OC)，同时可选择高有效/低有效
7. 二线串行接口可配置高有效/低有效
8. 支持**单键触发/多键同时触发**配置
9. 休眠模式提供两种采样率：低速8Hz、高速64Hz
10. 可通过引脚配置**最长按键锁定时长**，典型约80秒
11. 灵敏度可通过外接电容调节，电容取值范围：**1~50pF**
12. 上电后拥有约**0.5秒稳定时间**，此阶段请勿触摸按键，芯片所有功能暂时禁用
13. 具备**环境自动校准功能**：所有按键长时间无触发时，自动重新校准，重校准周期约4.0秒
    **应用领域（APPLICATION）**
    各类消费电子产品、传统机械按键替代场景

---

## 三、模块框图（BLOCK DIAGRAM）

```
SENADJ0 ──── TP0 TP1 TP2 TP3
SENADJ1 ──── TP4 TP5 TP6 TP7
SENADJ2 ──── TP8 TP9 TP10 TP11
SENADJ3 ──── TP12 TP13 TP14 TP15
┌─────────────────────────────────────────────────────────────┐
│ 感应端口与检测电路 + 感应输入电路 + 按键扫描电路 │
└───────────────┬───────────────────────────────────────────┘
 │
┌───────────────▼──────────────┐ ┌───────────────────────┐
│ 时序计数器 │ │ 唤醒检测控制电路 │
└───────────────┬──────────────┘ └───────────┬───────────┘
 │ │
┌───────────────▼──────────────┐ ┌───────────▼───────────┐
│ 功能控制电路 │ │ SLPSENA SLPSENB │
└───────────────┬──────────────┘ └───────────┬───────────┘
 │ │
┌───────────────▼──────────────┐ ┌───────────▼───────────┐
│ 系统振荡器电路 │ │ 串行输出缓冲电路 │
└───────────────┬──────────────┘ │ SDO SCL │
 │ └───────────────────────┘
┌───────────────▼──────────────┐
│ 功能选项控制电路 │
└───────────────┬──────────────┘
 │
┌───────────────▼──────────────┐
│ 测试引脚 TEST │
└───────────────┬──────────────┘
 │
┌───────────────▼──────────────┐
│ 上电电路 + 内部稳压器电路 │
└──────────────────────────────┘
```

---

## 四、封装引脚定义（PACKAGE CONFIGURATION）

**封装类型**：SSOP-28（28脚窄体贴片）

### 引脚排布（引脚号对应）

| 引脚号 | 引脚名称 | 引脚号 | 引脚名称 | 引脚号 | 引脚名称 | 引脚号 | 引脚名称 |
| --- | --- | --- | --- | --- | --- | --- | --- |
| 1 | SLPSENA | 8 | TP14 | 15  | TP11 | 22  | TP6 |
| 2 | TP2 | 9 | SENADJ3 | 16  | TP10 | 23  | SENADJ1 |
| 3 | TP3 | 10  | TP13 | 17  | SENADJ2 | 24  | TP5 |
| 4 | SENADJ0 | 11  | TP12 | 18  | TP9 | 25  | TP4 |
| 5 | TP1 | 12  | SDO | 19  | TP8 | 26  | VDD |
| 6 | TP0 | 13  | SCL | 20  | TEST | 27  | VSS |
| 7 | TP15 | 14  | SLPSENB | 21  | TP7 | 28  | SLPSENA |

> 补充：3脚为空脚(NC)

---

## 五、引脚详细说明（PIN DESCRIPTION）

**引脚类型说明**

- I：仅CMOS输入
- I-PH：CMOS输入+内部上拉电阻
- I-PL：CMOS输入+内部下拉电阻
- O：CMOS推挽输出
- I/O：双向CMOS口
- P：电源/地
- OD：开漏输出（TPQ0~TPQ7内置二极管保护；SDO无二极管保护）
  
  | 引脚号 | 引脚名称    | 复用功能   | 引脚类型   | 功能描述                                         |
  | --- | ------- | ------ | ------ | -------------------------------------------- |
  | 1   | SLPSENA | -      | I/O    | A组(TP0~TP7)休眠模式灵敏度调节引脚                       |
  | 2   | TP2     | KYSEL  | I/O    | 触摸按键输入(KEY-2)；**按键数量选择**：8键/16键，默认8键         |
  | 3   | NC      | -      | -      | 空脚                                           |
  | 4   | SENADJ0 | -      | I/O    | TP0~TP3 共用灵敏度调节引脚                            |
  | 5   | TP1     | SAHL   | I/O    | 触摸按键输入(KEY-1)；**输出极性选择**：高有效/低有效             |
  | 6   | TP0     | OPDEN  | I/O    | 触摸按键输入(KEY-0)；8路并行输出驱动类型选择：CMOS/OD/OC        |
  | 7   | TP15    | TPQ7   | I/O/OD | 触摸按键输入(KEY-15)；8键模式并行输出引脚TPQ7                |
  | 8   | TP14    | TPQ6   | I/O/OD | 触摸按键输入(KEY-14)；8键模式并行输出引脚TPQ6                |
  | 9   | SENADJ3 | -      | I/O    | TP12~TP15 共用灵敏度调节引脚                          |
  | 10  | TP13    | TPQ5   | I/O/OD | 触摸按键输入(KEY-13)；8键模式并行输出引脚TPQ5                |
  | 11  | TP12    | TPQ4   | I/O/OD | 触摸按键输入(KEY-12)；8键模式并行输出引脚TPQ4                |
  | 12  | SDO     | -      | O      | 二线串行输出数据端；极性由TP1配置                           |
  | 13  | SCL     | -      | I      | 二线串行输入时钟端；极性由TP1配置                           |
  | 14  | SLPSENB | -      | I/O    | B组(TP8~TP15)休眠模式灵敏度调节引脚                      |
  | 15  | TP11    | TPQ3   | I/O/OD | 触摸按键输入(KEY-11)；8键模式并行输出引脚TPQ3                |
  | 16  | TP10    | TPQ2   | I/O/OD | 触摸按键输入(KEY-10)；8键模式并行输出引脚TPQ2                |
  | 17  | SENADJ2 | -      | I/O    | TP8~TP11 共用灵敏度调节引脚                           |
  | 18  | TP9     | TPQ1   | I/O/OD | 触摸按键输入(KEY-9)；8键模式并行输出引脚TPQ1                 |
  | 19  | TP8     | TPQ0   | I/O/OD | 触摸按键输入(KEY-8)；8键模式并行输出引脚TPQ0                 |
  | 20  | TEST    | -      | I-PL   | 测试专用引脚，正常使用悬空/接地                             |
  | 21  | TP7     | SKSRT  | I/O    | 触摸按键输入(KEY-7)；**最长按键时长配置**：无限时长/80秒，默认无限     |
  | 22  | TP6     | SLWPTM | I/O    | 触摸按键输入(KEY-6)；休眠模式采样时长配置：4.0ms/2.0ms，默认4.0ms |
  | 23  | SENADJ1 | -      | I/O    | TP4~TP7 共用灵敏度调节引脚                            |
  | 24  | TP5     | WPSCT  | I/O    | 触摸按键输入(KEY-5)；**休眠采样率**：8Hz/64Hz，默认8Hz       |
  | 25  | TP4     | SKMS0  | I/O    | 触摸按键输入(KEY-4)；单键/多键触发配置位0，默认单键               |
  | 26  | VDD     | -      | P      | 电源正极                                         |
  | 27  | VSS     | -      | P      | 电源负极/系统地                                     |
  | 28  | SLPSENA | -      | I/O    | A组(TP0~TP7)休眠模式灵敏度调节引脚                       |
  | 补充  | TP3     | SKMS1  | I/O    | 触摸按键输入(KEY-3)；单键/多键触发配置位1，默认单键               |

---

## 六、电气特性（ELECTRICAL CHARACTERISTICS）

### 1. 绝对最大额定值（Absolute Maximum Ratings）

| 参数 | 符号 | 测试条件 | 数值 | 单位  |
| --- | ---- | ---- | --- | --- |
| 工作温度 | TOP  | — | -40 ~ +85 | ℃ |
| 存储温度 | TSTG | — | -50 ~ +125 | ℃ |
| 供电电压 | VDD  | 25℃  | VSS-0.3 ~ VSS+6.0 | V |
| 输入电压 | VIN  | 25℃  | VSS-0.3 ~ VDD+0.3 | V |
| 人体模式ESD防静电 | ESD  | — | 6 | KV  |

> 备注：VSS 代表系统地

### 2. 直流/交流电气参数（测试条件：室温25℃）

| 参数 | 符号 | 测试条件 | 最小值 | 典型值  | 最大值 | 单位  |
| --- | ---- | --- | --- | ---- | --- | --- |
| 工作电压 | VDD  | — | 2.4 | — | 5.5 | V |
| 内部稳压器输出电压 | VREG | — | 2.2 | 2.3  | 2.4 | V |
| 工作电流（无负载） | IOP  | VDD=3.0V | — | 20 | — | μA  |
| 休眠电流（8键、采样率8Hz、采样时长4.0ms）  | ISD  | VDD=3.0V | — | 2.0  | — | μA  |
| 休眠电流（16键、采样率8Hz、采样时长4.0ms） | ISD  | VDD=3.0V | — | 2.5  | — | μA  |
| 休眠电流（8键、采样率64Hz） | ISD  | VDD=3.0V | — | 5.5  | — | μA  |
| 休眠电流（16键、采样率64Hz） | ISD  | VDD=3.0V | — | 9.0  | — | μA  |
| 输入低电平电压 | VIL  | 输入端口 | 0 | — | 0.2VDD | V |
| 输入高电平电压 | VIH  | 输入端口 | 0.8VDD | — | 1.0VDD | V |
| 输出灌电流 | IOL  | VDD=3V, VOL=0.6V | — | 8 | — | mA  |
| 输出拉电流 | IOH  | VDD=3V, VOH=2.4V | — | -4 | — | mA  |
| 休眠模式唤醒响应时间(8Hz) | TWU  | VDD=3.0V | — | 125  | — | mS  |
| 休眠模式唤醒响应时间(64Hz) | TWU  | VDD=3.0V | — | 15.6 | — | mS  |
| 工作模式输出响应时间(16键) | TR | VDD=3.0V | — | 32 | — | mS  |
| 工作模式输出响应时间(8键) | TR | VDD=3.0V | — | 16 | — | mS  |
| 最长按键锁定时长 | TMOT | — | 50 | 80 | 110 | Sec |
| TEST引脚内部下拉电阻 | RPL  | VDD=3.0V | — | 30K  | — | ohm |

---

## 七、功能详解（FUNCTION DESCRIPTION）

### 1. 灵敏度调节

PCB上电极尺寸、走线寄生电容都会影响触摸灵敏度，芯片提供多种外部调节方式：

#### 1.1 电极尺寸

其他条件不变：**电极面积越大，灵敏度越高**；面积越小，灵敏度越低（需在有效范围内使用）。

#### 1.2 面板厚度

其他条件不变：**覆盖介质面板越薄，灵敏度越高**；面板越厚，灵敏度越低（不可超过最大限值）。

#### 1.3 外接电容调节（核心方式）

电容取值范围：`1pF ≤ CJ0~CJ3、CJWA、CJWB ≤ 50pF`

- 电容容值越大，灵敏度越低；电容悬空（不接）时，灵敏度最高。
- **CJ0~CJ3**：调节**正常工作模式**下按键灵敏度
- **CJWA、CJWB**：调节**休眠唤醒模式**下灵敏度
- 调节顺序建议：先调CJ0~CJ3，再调CJWA/CJWB
  电容与按键分组对应：
- CJ0：K0、K8
- CJ1：K1、K2、K3、K9、K10、K11
- CJ2：K4、K5、K6、K7、K12、K13
- CJ3：K14、K15
- CJWA：A组唤醒灵敏度（TP0~TP7）
- CJWB：B组唤醒灵敏度（TP8~TP15）
  
  ### 2. 按键数量选择（8键 / 16键）
  
  由 **TP2(KYSEL)** 引脚配置：
- 引脚**不接电阻到VSS**（默认）：**8键模式**
- 引脚**串高阻值电阻接VSS**：**16键模式**
  
  ### 3. 输出模式
  
  #### 3.1 模式总规则
1. 16键模式：**仅支持二线串行输出**
2. 8键模式：同时支持「8路独立并行输出」+「二线串行输出」；并行输出仅8键模式可用
   
   #### 3.2 8路并行输出驱动类型（TP0/OPDEN）
- TP0悬空（默认）：**CMOS推挽输出**
- TP0串高阻电阻接VSS：**开漏(OD)输出**
  
  #### 3.3 并行输出极性 / OD/OC选择（TP1/SAHL）
1. **CMOS输出模式下**
   - TP1悬空（默认）：并行输出**高有效**
   - TP1串高阻电阻接VSS：并行输出**低有效**
2. **OD/OC输出模式下**
   - TP1悬空（默认）：**开漏(OD)**，状态：浮空 / 低有效
   - TP1串高阻电阻接VSS：**集电极开路(OC)**，状态：浮空 / 高有效
     
     > 注意：OD/OC模式引脚内置二极管保护，禁止外接不同电压域器件，避免漏电流。
     
     #### 3.4 二线串行输出接口（SDO+SCL）
- SDO：串行数据输出；SCL：串行时钟输入
- 极性由TP1(SAHL)配置：默认低有效，接电阻到VSS变为高有效
- 工作方式：
  1. 主控轮询读取按键数据
  2. 等待芯片输出数据有效(DV)信号后，主控发时钟读取数据
- 超时机制：SCL引脚**2ms无电平跳变**，串行接口自动复位，回到待机状态
  
  #### 3.5 串行接口时序参数
  
  | 参数          | 最小值 | 典型值 | 最大值  | 单位  |
  | ----------- | --- | --- | ---- | --- |
  | DV          | —   | 93  | —    | μs  |
  | Tw          | 10  | —   | —    | μs  |
  | Tout        | —   | 2   | —    | ms  |
  | T_resp(16键) | —   | 32  | —    | ms  |
  | T_resp(8键)  | —   | 16  | —    | ms  |
  | F_SCL       | 1K  | —   | 512K | Hz  |
  | 时序分类：       |     |     |      |     |
1. TP1=1、TP2=0：16键，高有效
2. TP1=0、TP2=0：16键，低有效
3. TP1=1、TP2=1：8键，高有效
4. TP1=0、TP2=1：8键，低有效
   
   ### 4. 按键触发模式（单键 / 多键）
   
   由 **TP3(SKMS1)、TP4(SKMS0)** 组合配置；引脚接电阻到VSS = 逻辑0，悬空 = 逻辑1。
   按键分组：
- 第一组：TP0、TP1、TP2、TP3、TP8、TP9、TP10、TP11
- 第二组：TP4、TP5、TP6、TP7、TP12、TP13、TP14、TP15
  
  | TP3(SKMS1) | TP4(SKMS0) | 工作模式             |
  | ---------- | ---------- | ---------------- |
  | 1（默认）      | 1（默认）      | 整组16键，**全单键触发**  |
  | 1          | 0          | 两组独立，**两组均单键触发** |
  | 0          | 1          | 两组独立，一组单键、二组多键   |
  | 0          | 0          | 整组16键，**全多键触发**  |
  | 补充说明：      |            |                  |
1. 8键模式仅使用 TP0~TP7；
2. 单键模式下多键同时按下时，**按扫描顺序(TP0→TP15)判定优先级**，与按压力度无关。
   
   ### 5. 休眠模式采样率 & 采样时长
   
   #### 5.1 休眠采样率（TP5/WPSCT）
- 引脚悬空（默认）：**8Hz**
- 引脚串高阻电阻接VSS：**64Hz**
  对应唤醒响应：8Hz→125ms；64Hz→15.6ms
  
  #### 5.2 休眠采样时长（TP6/SLWPTM）
- 引脚悬空（默认）：**4.0ms**
- 引脚串高阻电阻接VSS：**2.0ms**
  
  ### 6. 最长按键锁定时长（TP7/SKSRT）
  
  用于防误触发（异物长期覆盖按键）：
- 引脚悬空（默认）：**关闭限时**，按键可一直触发（无限时长）
- 引脚串高阻电阻接VSS：**开启80秒限时**；超时后输出复位，需重新触摸才可触发
  
  > 注意：开启80秒限时+串行输出时，串行接口仅支持**轮询读取**模式。
  
  ### 7. 内置稳压器
  
  电容触摸电路对电源稳定性要求高，芯片集成稳压器，稳定内部供电，杜绝灵敏度异常、误触发。
  
  ### 8. 自动校准功能
1. 上电后：0.5秒初始化校准，此阶段所有功能禁用，禁止触摸按键；
2. 正常工作后：**所有按键4秒无触发，自动重新环境校准**，循环执行，适配温湿度、环境变化。
   
   ### 9. 休眠→工作模式时序
3. 误触发：短暂触摸唤醒后，4秒无有效按键，自动重校准，回到休眠；
4. 有效触发：触摸唤醒→进入按键扫描（工作模式）；按键松开后，约8秒无新触发，回到休眠。
   
   ### 10. 功能配置总表
   
   > 规则：引脚悬空=状态1；引脚串高阻电阻接VSS=状态0
   
   #### （1）输出模式组合（TP0 + TP1）
   
   | TP0(OPDEN) | TP1(SAHL) | 8路并行输出       | 二线串行输出  |
   | ---------- | --------- | ------------ | ------- |
   | 1          | 1         | CMOS 高有效（默认） | 低有效（默认） |
   | 1          | 0         | CMOS 低有效     | 高有效     |
   | 0          | 1         | OD 低有效       | 低有效     |
   | 0          | 0         | OC 高有效       | 高有效     |
   
   #### （2）按键数量（TP2/KYSEL）
   
   | TP2 | 模式       |
   | --- | -------- |
   | 1   | 8键模式（默认） |
   | 0   | 16键模式    |
   
   #### （3）单/多键模式（TP3+TP4）
   
   见本文「4. 按键触发模式」表格
   
   #### （4）休眠采样率（TP5/WPSCT）
   
   | TP5 | 采样率     |
   | --- | ------- |
   | 1   | 8Hz（默认） |
   | 0   | 64Hz    |
   
   #### （5）休眠采样时长（TP6/SLWPTM）
   
   | TP6 | 采样时长      |
   | --- | --------- |
   | 1   | 4.0ms（默认） |
   | 0   | 2.0ms     |
   
   #### （6）按键最长时长（TP7/SKSRT）
   
   | TP7 | 功能状态          |
   | --- | ------------- |
   | 1   | 关闭限时，无限触发（默认） |
   | 0   | 开启80秒最长按键锁定   |

---

## 八、应用电路（APPLICATION CIRCUIT）

### 1. 16键模式应用电路

- 供电：VDD 接电源，VSS 接地；VDD-VSS之间并联104(0.1μF)滤波电容C1，走线尽量短。
- 按键电极：TP0~TP15分别外接触摸电极K0~K15。
- 灵敏度电容：CJ0/CJ1/CJ2/CJ3、CJWA/CJWB 按分组外接1~50pF高精度电容。
- 配置电阻：RP2~RP7（推荐820KΩ）按需接至对应配置引脚与VSS之间，实现功能选择。
- 串行接口：SDO、SCL 外接主控MCU。
  
  ### 2. 8键模式应用电路
- 基础电路同16键；仅使用 TP0~TP7 对应按键 K0~K7。
- 并行输出：TPQ0~TPQ7（TP8~TP15引脚）作为8路独立输出。
- 闲置引脚：不使用串行接口时，**SCL引脚必须接VDD/VSS，禁止悬空**。
  
  ### PCB设计注意事项
1. 触摸电极到芯片引脚的走线**越短越好**，走线禁止平行、交叉；
2. 电源必须稳定，电压快速波动会造成灵敏度异常、误触发；
3. 按键覆盖面板**禁止含金属/导电材质**，表面涂层保持一致；
4. 电源滤波电容C1紧邻VDD/VSS引脚布局，走线最短；
5. 灵敏度电容优先选用 **NPO/X7R** 低温度系数电容，推荐NPO；
6. 配置电阻RP0~RP7 标准取值：**820KΩ**；
7. 不用串行接口时，SCL严禁悬空。

---

## 九、封装尺寸（PACKAGE OUTLINE）

**封装**：SSOP-28
包含公制(mm)、英制(inch)尺寸，关键尺寸摘要：

- 总宽度、引脚间距、本体厚度、引脚厚度等参数详见原厂尺寸表；
- 模具凸起、浇口毛刺单边不得超过0.006英寸。

---

## 十、订购信息 & 版本修订记录

### 1. 订购型号

封装型号：**TTP229-BSF**

### 2. 版本修订历史

1. **2009/12/03 V1.0**：初始版本
2. **2009/12/22 V1.1（当前版本）**
   - 补充休眠电流参数；
   - 增加OD/OC输出结构说明；
   - 补充单键模式优先级说明；
   - 修正/补充最长按键锁定时长参数；
   - 优化分组模式表格描述；
   - 配置电阻阻值由1MΩ更新为**820KΩ**。

---

文档结束 | 原版页码：Page 1 ~ Page 16 | Ver:1.1
