sratle/WCH-Model-Terminal/docs/devboard/hardware/SCH_Schematic23_2026-08-08.pdf

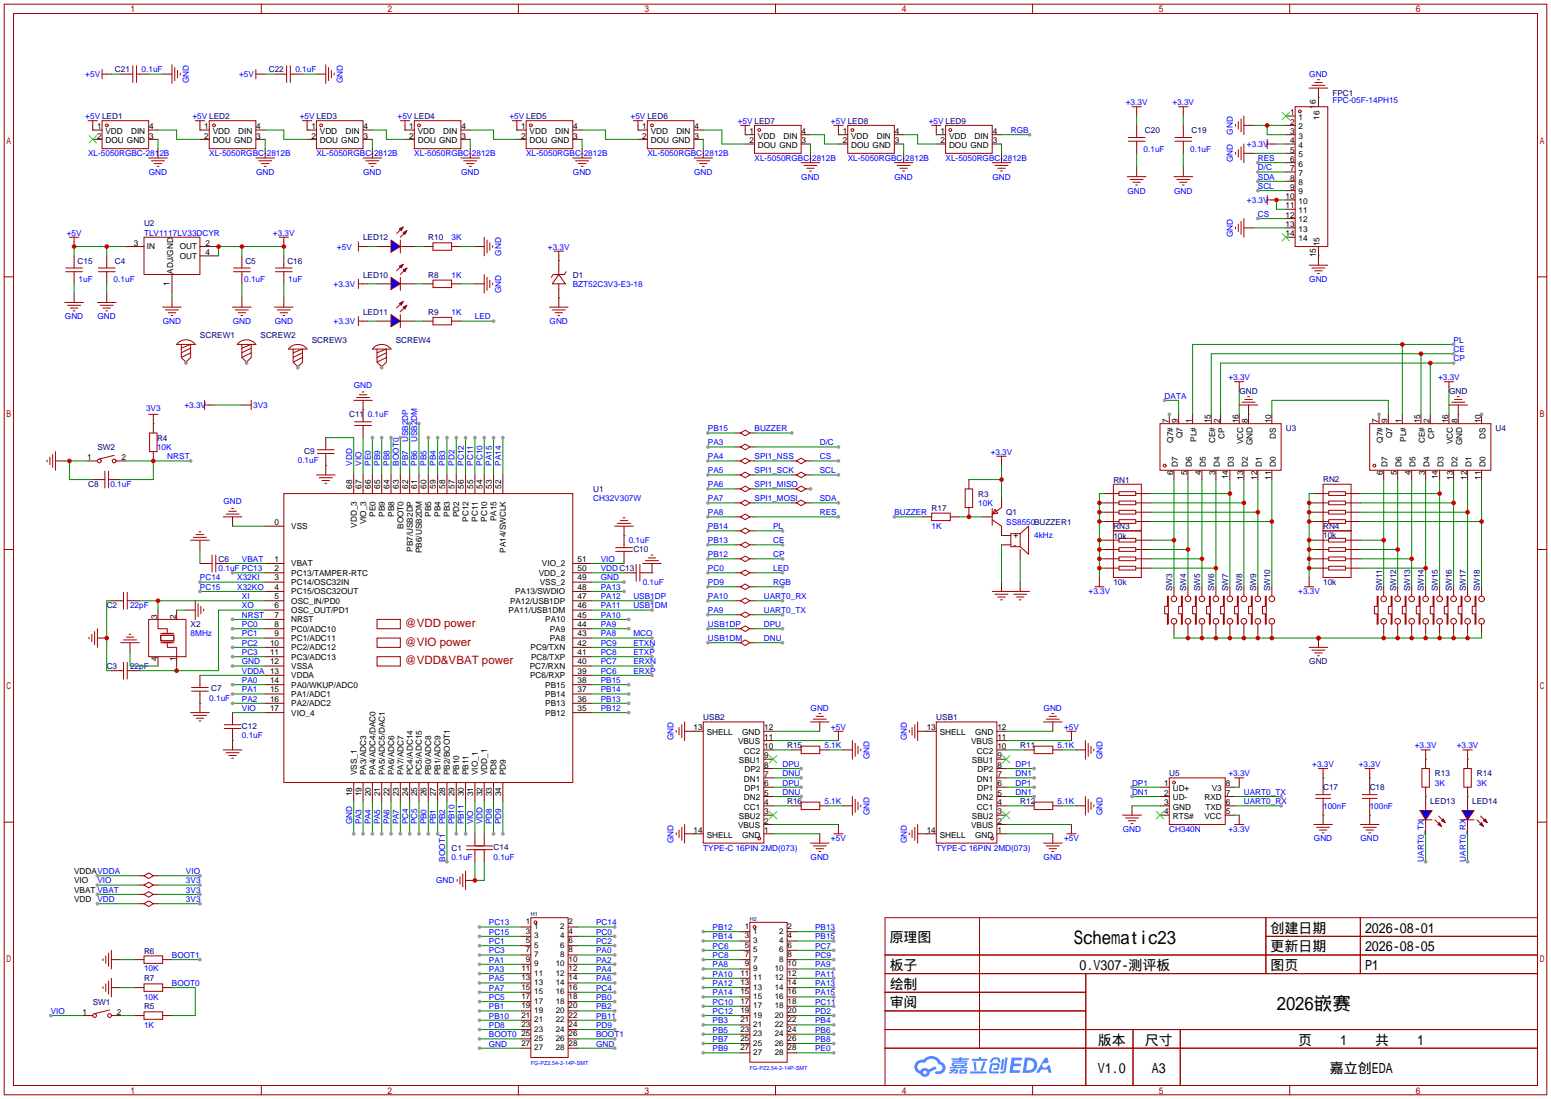
[picture p4: page 1]

@VDD power
@VIO power
@VDD&VBAT power PD⁸ 33

原理图 | Schematic23 | 创建日期 | 2026-08-01

更新日期 | 2026-08-05

板子 | 0.V307-测评板 | 图页 | P1
绘制 | | 2026嵌赛
审阅

V1.0 | A3 | 嘉立创EDA
