sratle/WCH-Model-Terminal/main-model/core/Common/Common/Keyboard/keyboard.c

#include "keyboard.h"
#include "../Protocol/protocol_common.h"
#include "../Display/display.h"
#include "../hardware.h"
#include "../CH378/CH378.h"
#include "../CS43131/cs43131.h"

keyboard_t *keyboard_ptr = NULL;

/* ============================================================================
 * Music Keyboard 状态
 * ============================================================================ */
static uint8_t music_active = 0;           /* 1=音乐键盘已启动事件上报 */
static uint8_t prev_key_bitmap[3] = {0};   /* 上一帧琴键位图 */
static uint8_t current_playing_key = 0;    /* 当前正在播放的琴键 ID (1~24, 0=无) */
static uint8_t prev_button_bitmap[2] = {0};/* 上一帧控制按钮位图（12 bit，鼓点边沿检测用） */

/* Game Keyboard state */
static game_input_state_t game_state = {0};
static uint8_t game_active = 0;            /* 1=游戏键盘已连接 */
static uint8_t prev_dir_keys = 0;           /* debounced direction keys bitmask */

/* Hysteresis thresholds for ROC1 direction detection
 * Press: <100 or >200 (asymmetric due to Y-axis offset)
 * Release: <120 or >180 */
#define ROC_PRESS_LOW   100
#define ROC_PRESS_HIGH  200
#define ROC_RELEASE_LOW 120
#define ROC_RELEASE_HIGH 180

/* 检查 Display 是否在线 */
static uint8_t Keyboard_IsDisplayOnline(void)
{
    uint8_t i;
    for (i = 0; i < HB_MAX_SLOTS; i++) {
        if (hardware_g.hb_slots[i].module_id == MODULE_ID_DISPLAY &&
            hardware_g.hb_slots[i].status == HB_STATUS_ONLINE)
            return 1;
    }
    return 0;
}

/* 将 Keyboard-3 音乐事件原始帧透传给 Display（SRC=CORE, DST=DISPLAY） */
static void Keyboard_ForwardMusicEventToDisplay(const protocol_frame_t *req)
{
    uint8_t buf[PROTO_MAX_FRAME_LEN];
    uint16_t len;

    if (!music_active) return;
    if (!Keyboard_IsDisplayOnline()) return;

    len = Protocol_PackFrame(MODULE_ID_CORE, MODULE_ID_DISPLAY,
                             req->cmd, req->data, req->len,
                             buf, sizeof(buf));
    if (len > 0)
        Display_Send_Data(&display_g, buf, len);
}

/* ============================================================================
 * 前向声明：Keyboard 专用命令 handler
 * ============================================================================ */

/* 请求类 handler：返回 1=成功（resp_buf 写入 DATA 域，*resp_len=DATA 长度），0=失败 */
static uint8_t Keyboard_HandleSetBacklight(const protocol_frame_t *req,
                                           uint8_t *resp_buf, uint16_t resp_size,
                                           uint8_t *resp_len);
static uint8_t Keyboard_HandleGetBacklight(const protocol_frame_t *req,
                                           uint8_t *resp_buf, uint16_t resp_size,
                                           uint8_t *resp_len);
static uint8_t Keyboard_HandleSetConfig(const protocol_frame_t *req,
                                        uint8_t *resp_buf, uint16_t resp_size,
                                        uint8_t *resp_len);
static uint8_t Keyboard_HandleGetStatus(const protocol_frame_t *req,
                                        uint8_t *resp_buf, uint16_t resp_size,
                                        uint8_t *resp_len);

/* 事件类 handler：无返回值 */
static void Keyboard_HandleHidReport(const protocol_frame_t *req);
static void Keyboard_HandleMusicKeys(const protocol_frame_t *req);
static void Keyboard_HandleMusicButtons(const protocol_frame_t *req);
static void Keyboard_HandleMusicFaders(const protocol_frame_t *req);
static void Keyboard_HandleGameInput(const protocol_frame_t *req);

/* Convert gamepad state to HID events and send to Display */
static void Keyboard_SendGameInputAsHID(void);

/* ============================================================================
 * UART 初始化与数据收发
 * ============================================================================ */

void Keyboard_Init(keyboard_t *keyboard)
{
    GPIO_InitTypeDef GPIO_InitStructure;
    USART_InitTypeDef USART_InitStructure;

    RCC_HB2PeriphClockCmd(RCC_HB2Periph_AFIO | RCC_HB2Periph_GPIOE, ENABLE);
    RCC_HB1PeriphClockCmd(RCC_HB1Periph_USART3, ENABLE);

    GPIO_PinAFConfig(KEYBOARD_UART_TX_PORT, GPIO_PinSource10, KEYBOARD_UART_TX_AF);
    GPIO_PinAFConfig(KEYBOARD_UART_RX_PORT, GPIO_PinSource11, KEYBOARD_UART_RX_AF);

    GPIO_InitStructure.GPIO_Pin = KEYBOARD_UART_TX_PIN;
    GPIO_InitStructure.GPIO_Speed = GPIO_Speed_Very_High;
    GPIO_InitStructure.GPIO_Mode = GPIO_Mode_AF_PP;
    GPIO_Init(KEYBOARD_UART_TX_PORT, &GPIO_InitStructure);

    GPIO_InitStructure.GPIO_Pin = KEYBOARD_UART_RX_PIN;
    GPIO_InitStructure.GPIO_Speed = GPIO_Speed_Very_High;
    GPIO_InitStructure.GPIO_Mode = GPIO_Mode_IN_FLOATING;
    GPIO_Init(KEYBOARD_UART_RX_PORT, &GPIO_InitStructure);

    USART_InitStructure.USART_BaudRate = KEYBOARD_UART_BAUDRATE;
    USART_InitStructure.USART_WordLength = USART_WordLength_8b;
    USART_InitStructure.USART_StopBits = USART_StopBits_1;
    USART_InitStructure.USART_Parity = USART_Parity_No;
    USART_InitStructure.USART_HardwareFlowControl = USART_HardwareFlowControl_None;
    USART_InitStructure.USART_Mode = USART_Mode_Tx | USART_Mode_Rx;

    USART_Init(KEYBOARD_UART, &USART_InitStructure);
    USART_Cmd(KEYBOARD_UART, ENABLE);

    // 使能接收中断并配置 NVIC
    USART_ITConfig(KEYBOARD_UART, USART_IT_RXNE, ENABLE);
    NVIC_SetPriority(KEYBOARD_UART_IRQn, 1 << 4);
    NVIC_EnableIRQ(KEYBOARD_UART_IRQn);

    // 初始化协议接收状态机
    Protocol_InitRxCtx(&keyboard->rx_ctx);

    Keyboard_Get_Type(keyboard);
    keyboard_ptr = keyboard;
}

void Keyboard_UART_IRQ_Handler(keyboard_t *keyboard)
{
    if (keyboard == NULL)
        return;

    if (USART_GetITStatus(KEYBOARD_UART, USART_IT_RXNE) != RESET)
    {
        uint8_t byte = (uint8_t)USART_ReceiveData(KEYBOARD_UART);
        Protocol_ParseByte(&keyboard->rx_ctx, byte);
    }

    /* 热插拔噪声防护：ORE/FE/NE 置位时读 STATR+DATAR 清除，
     * 否则错误标志滞留会导致中断反复触发、RX 永久卡死 */
    if (USART_GetFlagStatus(KEYBOARD_UART, USART_FLAG_ORE) != RESET ||
        USART_GetFlagStatus(KEYBOARD_UART, USART_FLAG_FE)  != RESET ||
        USART_GetFlagStatus(KEYBOARD_UART, USART_FLAG_NE)  != RESET)
    {
        (void)USART_ReceiveData(KEYBOARD_UART);
    }
}

void Keyboard_Get_Type(keyboard_t *keyboard)
{
    uint8_t buf[PROTO_MAX_FRAME_LEN];
    uint16_t len;

    len = Protocol_PackFrame(MODULE_ID_CORE, MODULE_ID_KEYBOARD,
                             CMD_GET_TYPE, NULL, 0,
                             buf, sizeof(buf));
    if (len > 0)
        Keyboard_Send_Data(keyboard, buf, len);
}

void Keyboard_Send_Data(keyboard_t *keyboard, uint8_t *data, uint16_t length)
{
    int i = 0;

    (void)keyboard;

    if (length == 0) return;

    for (i = 0; i < length; i++)
    {
        while (USART_GetFlagStatus(KEYBOARD_UART, USART_FLAG_TXE) == RESET)
            ;
        USART_SendData(KEYBOARD_UART, *data++);
    }
    while (USART_GetFlagStatus(KEYBOARD_UART, USART_FLAG_TC) == RESET)
        ;
}

/* ============================================================================
 * 通用命令回调
 * ============================================================================ */

static uint8_t keyboard_on_get_type(const protocol_frame_t *req,
                                    uint8_t *resp_buf, uint16_t resp_size,
                                    uint8_t *resp_len)
{
    (void)req;
    (void)resp_size;
    resp_buf[0] = MODULE_TYPE_KEYBOARD;
    resp_buf[1] = MODULE_SUBTYPE_KEYBOARD_MAIN;
    resp_buf[2] = 0x01; /* hw_ver */
    resp_buf[3] = 0x01; /* fw_major */
    resp_buf[4] = 0x00; /* fw_minor */
    *resp_len = 5;
    return 1;
}

static const protocol_common_cb_t keyboard_common_cb = {
    .on_get_type = keyboard_on_get_type,
};

/* ============================================================================
 * 专用命令分发辅助函数
 * ============================================================================ */

static uint8_t keyboard_dispatch_req(const protocol_frame_t *req,
                                     uint8_t (*handler)(const protocol_frame_t *,
                                                        uint8_t *, uint16_t, uint8_t *),
                                     uint8_t *resp_buf, uint16_t resp_size)
{
    uint8_t data_len = 0;

    if (handler == NULL)
        return ProtocolCommon_Nack(req->dst, req->src, PROTO_ERR_UNSUPPORTED_CMD,
                                   resp_buf, resp_size);

    if (!handler(req, resp_buf, resp_size, &data_len))
        return ProtocolCommon_Nack(req->dst, req->src, PROTO_ERR_UNSUPPORTED_CMD,
                                   resp_buf, resp_size);

    if (data_len > 0)
        return Protocol_PackFrame(req->dst, req->src, CMD_ACK,
                                  resp_buf, data_len, resp_buf, resp_size);

    return ProtocolCommon_Ack(req->dst, req->src, resp_buf, resp_size);
}

/* ============================================================================
 * 主循环帧处理
 * ============================================================================ */

void Keyboard_Process(keyboard_t *keyboard)
{
    uint8_t resp[PROTO_MAX_FRAME_LEN];
    uint8_t resp_len;
    uint8_t handled;
    protocol_frame_t *req;
    /* 单次调用排干接收队列（上限 8 帧防饿死其他模块）：琴键事件处理含
     * CH378 操作（~15ms/帧），若每轮主循环只处理一帧，快速滑奏时帧到达
     * 速率超过服务速率，队列饱和丢帧 = 丢音（"一段时间无法触发"根因） */
    uint8_t budget = 8;

    if (keyboard == NULL)
        return;

    while (budget-- > 0 && keyboard->rx_ctx.frame_ready)
    {
    resp_len = 0;
    handled = 0;
    req = &keyboard->rx_ctx.read_frame;

    /* 0. 处理 Keyboard 返回的 ACK 响应（心跳 GET_TYPE 的回复）。
     * 键盘还会用 ACK 回复背光/按键/推子等查询（长度与身份帧不同），
     * 必须按 GET_TYPE ACK 指纹（len==6 且 type 匹配）门控，
     * 否则查询数据会污染 type_id 与心跳槽位类型。 */
    if (req->cmd == CMD_ACK)
    {
        if (req->len == 6 && req->data[0] == MODULE_TYPE_KEYBOARD)
        {
            module_identity_t id;
            if (Protocol_ParseIdentity(req, &id))
            {
                Hardware_Hb_MarkOnline(MODULE_ID_KEYBOARD, id.type, id.subtype);
                keyboard->type_id = id.subtype;
                /* Reset game state if keyboard type is not Game */
                if (id.subtype != MODULE_SUBTYPE_KEYBOARD_GAME)
                    game_active = 0;
            }
        }
        handled = 1;
    }
    /* 1. 通用命令（0x00~0x0F） */
    else if (ProtocolCommon_Dispatch(req, &keyboard_common_cb,
                                resp, sizeof(resp), &resp_len))
    {
        handled = 1;
    }
    /* 2. Keyboard 专用操作码：0x21 ~ 0x2A */
    else if (req->cmd >= CMD_KBD_SET_BACKLIGHT && req->cmd <= CMD_KBD_MUSIC_EVENT_CTRL)
    {
        switch (req->cmd)
        {
            /* ---- Core→Kbd 请求类 ---- */
            case CMD_KBD_SET_BACKLIGHT:
                resp_len = keyboard_dispatch_req(req, Keyboard_HandleSetBacklight,
                                                 resp, sizeof(resp));
                handled = 1;
                break;
            case CMD_KBD_GET_BACKLIGHT:
                resp_len = keyboard_dispatch_req(req, Keyboard_HandleGetBacklight,
                                                 resp, sizeof(resp));
                handled = 1;
                break;
            case CMD_KBD_SET_CONFIG:
                resp_len = keyboard_dispatch_req(req, Keyboard_HandleSetConfig,
                                                 resp, sizeof(resp));
                handled = 1;
                break;
            case CMD_KBD_GET_STATUS:
                resp_len = keyboard_dispatch_req(req, Keyboard_HandleGetStatus,
                                                 resp, sizeof(resp));
                handled = 1;
                break;

            /* ---- Kbd→Core 事件类（不需要 ACK） ---- */
            case CMD_KBD_HID_REPORT:
                Keyboard_HandleHidReport(req);
                handled = 1;
                break;
            case CMD_KBD_MUSIC_KEYS:
                Keyboard_HandleMusicKeys(req);
                handled = 1;
                break;
            case CMD_KBD_MUSIC_BUTTONS:
                Keyboard_HandleMusicButtons(req);
                handled = 1;
                break;
            case CMD_KBD_MUSIC_FADERS:
                Keyboard_HandleMusicFaders(req);
                handled = 1;
                break;
            case CMD_KBD_GAME_INPUT:
                Keyboard_HandleGameInput(req);
                handled = 1;
                break;

            default:
                resp_len = ProtocolCommon_Nack(req->dst, req->src,
                                               PROTO_ERR_UNSUPPORTED_CMD,
                                               resp, sizeof(resp));
                handled = 1;
                break;
        }
    }

    /* 发送响应（如果有） */
    if (handled && resp_len > 0)
        Keyboard_Send_Data(keyboard, resp, resp_len);

    /* 释放当前帧并自动递补队列中的下一帧，下一轮循环继续处理 */
    Protocol_ResetRxCtx(&keyboard->rx_ctx);
    }
}

/* ============================================================================
 * Keyboard 专用命令 handler 实现
 * ============================================================================ */

/* ---- 请求类 handler ---- */
static uint8_t Keyboard_HandleSetBacklight(const protocol_frame_t *req,
                                           uint8_t *resp_buf, uint16_t resp_size,
                                           uint8_t *resp_len)
{
    (void)req; (void)resp_buf; (void)resp_size;
    *resp_len = 0;
    return 0; /* 暂不支持 */
}

static uint8_t Keyboard_HandleGetBacklight(const protocol_frame_t *req,
                                           uint8_t *resp_buf, uint16_t resp_size,
                                           uint8_t *resp_len)
{
    (void)req; (void)resp_buf; (void)resp_size;
    *resp_len = 0;
    return 0;
}

static uint8_t Keyboard_HandleSetConfig(const protocol_frame_t *req,
                                        uint8_t *resp_buf, uint16_t resp_size,
                                        uint8_t *resp_len)
{
    (void)req; (void)resp_buf; (void)resp_size;
    *resp_len = 0;
    return 0;
}

static uint8_t Keyboard_HandleGetStatus(const protocol_frame_t *req,
                                        uint8_t *resp_buf, uint16_t resp_size,
                                        uint8_t *resp_len)
{
    (void)req; (void)resp_buf; (void)resp_size;
    *resp_len = 0;
    return 0;
}

/* ---- 事件类 handler ---- */
static void Keyboard_HandleHidReport(const protocol_frame_t *req)
{
    uint8_t report_type;
    uint8_t report_len;
    const uint8_t *report_data;

    if (req->len < 2)
        return;

    report_type = req->data[0];
    report_data = &req->data[1];
    report_len = req->len - 1;

    if (report_type == 0x00)
    {
        if (report_len < 8)
            return;

        printf("[KBD] HID KB | Mod: 0x%02X | Keys:", report_data[0]);
        for (uint8_t i = 2; i < 8; i++)
        {
            if (report_data[i])
                printf(" 0x%02X", report_data[i]);
        }
        printf("\r\n");

        Display_SendInputEvent(&display_g, INPUT_DEV_KEYBOARD,
                               report_data, 8);
    }
    else if (report_type == 0x01)
    {
        if (report_len < 4)
            return;

        printf("[KBD] HID MS | Btn: 0x%02X | X: %+4d | Y: %+4d | W: %+4d\r\n",
               report_data[0],
               (int8_t)report_data[1],
               (int8_t)report_data[2],
               (int8_t)report_data[3]);

        Display_SendInputEvent(&display_g, INPUT_DEV_MOUSE,
                               report_data, 4);
    }
}

/* ============================================================================
 * Music Keyboard (Keyboard-3) 事件处理
 * ============================================================================ */

/* ----------------------------------------------------------------------------
 * 琴键 / 鼓点 音色播放：双通道轮转分配
 *
 * 琴键（PIANO-xx.WAV）与控制按钮鼓点（DRUM-xx.WAV）共用同一套 ch0/ch1 轮转。
 * music_last_ch 记录上一次（无论琴键还是鼓点）实际使用的通道，每个新音色一律
 * 分配到"另一路"，实现 ch0 ↔ ch1 严格交替：上一个仍在延音的音色留在原通道
 * 继续自然衰减，新音色在另一通道起播，避免相互打断、保证播放流畅。
 * -------------------------------------------------------------------------- */
static uint8_t music_last_ch = 1; /* 初值 1 → 第一次分配得到 ch0 */

/* 取下一个播放通道：与上一次使用的通道交替（0↔1） */
static uint8_t Music_PickChannel(void)
{
    music_last_ch ^= 1u;
    return music_last_ch;
}

/*
 * 在轮转分配的通道上流式播放一个 WAV 音色文件（琴键与鼓点共用）。
 * path: CH378 上的 8.3 短文件名完整路径
 * tag : 日志标签（"PIANO" / "DRUM"）
 */
static void Music_PlaySampleFile(const char *path, const char *tag)
{
    uint8_t status;
    uint8_t header[512];
    uint16_t real_len;
    wav_info_t info;
    uint8_t ch;

    /* 双通道轮转：与上一个音色交替，避免打断仍在延音的上一路 */
    ch = Music_PickChannel();

    /* 仅停止选中的通道 */
    Audio_ChannelStop(ch);

    /* CH378 单句柄：打开新文件会隐式关闭其他通道的文件，
     * 必须显式清除其 file_open 标记，否则 Audio_Process 会读错文件 */
    {
        uint8_t j;
        for (j = 0; j < AUDIO_MAX_CHANNELS; j++) {
            if (j != ch && CS43131_g.channels[j].file_open) {
                CS43131_g.channels[j].file_open = 0;
            }
        }
    }

    /* 打开文件 */
    status = CH378FileOpen((uint8_t*)path);
    if (status != ERR_SUCCESS) {
        printf("[%s] Cannot open %s (0x%02X)\r\n", tag, path, status);
        return;
    }

    /* 读取 WAV 头 */
    status = CH378ByteRead(header, 512, &real_len);
    if (status != ERR_SUCCESS || real_len < 44) {
        printf("[%s] Failed to read header\r\n", tag);
        CH378FileClose(0);
        return;
    }

    /* 解析头 */
    if (Audio_ParseWAVHeader(header, &info) != 0) {
        CH378FileClose(0);
        return;
    }

    /* 定位到 data chunk 起始位置 */
    status = CH378ByteLocate(info.data_offset);
    if (status != ERR_SUCCESS) {
        printf("[%s] Seek failed (0x%02X)\r\n", tag, status);
        CH378FileClose(0);
        return;
    }

    /* 不关闭文件：交给音频引擎继续顺序读取，避免二次 open 失败 */

    /* 启动流式播放 */
    if (Audio_ChannelStart(ch, path, &info) != 0) {
        printf("[%s] Failed to start channel %d\r\n", tag, ch);
        CH378FileClose(0);
        return;
    }
    /* 标记文件已打开，Audio_Process 直接顺序读取 */
    CS43131_g.channels[ch].file_open = 1;

    printf("[%s] %s → ch%d\r\n", tag, path, ch);
}

/*
 * 播放指定琴键对应的钢琴音色 WAV 文件
 * key_id: 1~24 → \SOUND\PIANO-01.WAV ~ PIANO-24.WAV
 */
static void Music_PlayPianoKey(uint8_t key_id)
{
    char path[CH378_MAX_PATH_LEN];

    if (key_id < 1 || key_id > 24)
        return;

    /* 构建路径: \SOUND\PIANO-xx.WAV (8.3 短文件名) */
    snprintf(path, sizeof(path), "\\SOUND\\PIANO-%02d.WAV", key_id);
    Music_PlaySampleFile(path, "PIANO");
}

/*
 * 播放指定控制按钮对应的鼓点音色 WAV 文件
 * btn_id: 1~12（KEY1~KEY12）→ \SOUND\DRUM-01.WAV ~ DRUM-12.WAV
 * 与琴键共用 ch0/ch1 轮转（见 Music_PickChannel）
 */
static void Music_PlayDrum(uint8_t btn_id)
{
    char path[CH378_MAX_PATH_LEN];

    if (btn_id < 1 || btn_id > 12)
        return;

    /* 构建路径: \SOUND\DRUM-xx.WAV (8.3 短文件名) */
    snprintf(path, sizeof(path), "\\SOUND\\DRUM-%02d.WAV", btn_id);
    Music_PlaySampleFile(path, "DRUM");
}

static void Keyboard_HandleMusicKeys(const protocol_frame_t *req)
{
    const uint8_t *bitmap;
    uint8_t i;
    uint8_t pressed_count = 0;
    uint8_t last_pressed_key = 0;
    uint8_t new_key_pressed = 0;

    if (req->len < 4)  /* CMD + 3 bytes bitmap */
        return;

    /* 透传给 Display */
    Keyboard_ForwardMusicEventToDisplay(req);

    bitmap = &req->data[0];

    /* 打印当前琴键位图 */
    printf("[MUSIC] Keys: %02X %02X %02X\r\n", bitmap[0], bitmap[1], bitmap[2]);

    /* 检测新按下的键（从 bitmap 中查找） */
    for (i = 0; i < 24; i++) {
        uint8_t byte_idx = i >> 3;
        uint8_t bit_mask = 1u << (i & 7);
        uint8_t is_pressed = (bitmap[byte_idx] & bit_mask) ? 1 : 0;
        uint8_t was_pressed = (prev_key_bitmap[byte_idx] & bit_mask) ? 1 : 0;

        if (is_pressed) {
            pressed_count++;
            last_pressed_key = i + 1;  /* 1-based key ID */
            if (!was_pressed) {
                new_key_pressed = 1;
            }
        }
    }

    /* 处理琴键事件
     * 延音逻辑：松键不主动停止播放，让 WAV 自然衰减结束。
     * 只有新音符触发或外部音频打断才会停止当前播放。 */
    if (new_key_pressed) {
        /* 有新键按下 → 播放最后按下的键（打断当前音符） */
        current_playing_key = last_pressed_key;
        Music_PlayPianoKey(current_playing_key);
    }
    else if (pressed_count > 0 && current_playing_key != 0) {
        /* 有键仍按住：检查当前播放的键是否还在按下列表中 */
        uint8_t byte_idx = (current_playing_key - 1) >> 3;
        uint8_t bit_mask = 1u << ((current_playing_key - 1) & 7);
        if (!(bitmap[byte_idx] & bit_mask)) {
            /* 当前播放的键已释放，切换到最后一个仍按下的键 */
            current_playing_key = last_pressed_key;
            Music_PlayPianoKey(current_playing_key);
        }
    }
    /* pressed_count == 0: 所有键释放 → 不主动停止，让 WAV 自然延音结束 */

    /* 保存当前位图 */
    prev_key_bitmap[0] = bitmap[0];
    prev_key_bitmap[1] = bitmap[1];
    prev_key_bitmap[2] = bitmap[2];
}

static void Keyboard_HandleMusicButtons(const protocol_frame_t *req)
{
    const uint8_t *bitmap;
    uint8_t i;

    if (req->len < 3)  /* CMD + 2 bytes bitmap */
        return;

    /* 透传给 Display */
    Keyboard_ForwardMusicEventToDisplay(req);

    bitmap = &req->data[0];
    printf("[MUSIC] Buttons: %02X %02X\r\n", bitmap[0], bitmap[1]);

    /* 12 个控制按钮 KEY1~KEY12 → \SOUND\DRUM-01.WAV ~ DRUM-12.WAV
     * 边沿检测：仅在按钮由"松"变"按"（上升沿）时触发一次鼓点，
     * 一击即发、不做延音；松开不主动停止，让 WAV 自然衰减结束。
     * 每次触发共用琴键的 ch0/ch1 轮转（见 Music_PickChannel），
     * 上一个音色（琴键或鼓点）留在原通道继续，鼓点落到另一通道。
     * 位图布局：byte0 bit0~7 = KEY1~KEY8，byte1 bit0~3 = KEY9~KEY12。 */
    for (i = 0; i < 12; i++) {
        uint8_t byte_idx = i >> 3;
        uint8_t bit_mask = 1u << (i & 7);
        uint8_t is_pressed  = (bitmap[byte_idx] & bit_mask) ? 1 : 0;
        uint8_t was_pressed = (prev_button_bitmap[byte_idx] & bit_mask) ? 1 : 0;
        if (is_pressed && !was_pressed)
            Music_PlayDrum(i + 1);  /* 1-based: KEY1→DRUM-01 */
    }

    /* 保存当前位图用于下一帧边沿检测 */
    prev_button_bitmap[0] = bitmap[0];
    prev_button_bitmap[1] = bitmap[1];
}

static void Keyboard_HandleMusicFaders(const protocol_frame_t *req)
{
    uint16_t fader_l, fader_m, fader_r;
    uint8_t pct_l, pct_m, pct_r;
    static uint8_t prev_l = 0xFF, prev_m = 0xFF, prev_r = 0xFF;

    if (req->len < 7)  /* CMD + 6 bytes (3 x uint16 big-endian) */
        return;

    /* 透传给 Display（不受死区滤波影响，Display 获得原始值） */
    Keyboard_ForwardMusicEventToDisplay(req);

    fader_l = ((uint16_t)req->data[0] << 8) | req->data[1];
    fader_m = ((uint16_t)req->data[2] << 8) | req->data[3];
    fader_r = ((uint16_t)req->data[4] << 8) | req->data[5];

    /* Convert 16-bit (0~65535) to percentage (0~100%) */
    pct_l = (uint8_t)((uint32_t)fader_l * 100 / 65535);
    pct_m = (uint8_t)((uint32_t)fader_m * 100 / 65535);
    pct_r = (uint8_t)((uint32_t)fader_r * 100 / 65535);

    /* 死区滤波：变化 < 3% 不更新，避免 ADC 抖动导致频繁重算效果器系数 */
    {
        int dl = (int)pct_l - (int)prev_l; if (dl < 0) dl = -dl;
        int dm = (int)pct_m - (int)prev_m; if (dm < 0) dm = -dm;
        int dr = (int)pct_r - (int)prev_r; if (dr < 0) dr = -dr;
        if (dl < 3 && dm < 3 && dr < 3) return;
    }

    printf("[MUSIC] Faders: L=%3u%% M=%3u%% R=%3u%%\r\n", pct_l, pct_m, pct_r);

    /* 效果器总开关关闭时，仅更新前值记录，不操作效果器 */
    if (!CS43131_g.fx_master_enable) {
        prev_l = pct_l; prev_m = pct_m; prev_r = pct_r;
        return;
    }

    /* ---- Fader L → Bass EQ (-12 ~ +12 dB) ---- */
    {
        int dl = (int)pct_l - (int)prev_l; if (dl < 0) dl = -dl;
        if (dl >= 3) {
            int16_t bass_db = (int16_t)((int)pct_l * 24 / 100) - 12; /* 0%→-12, 50%→0, 100%→+12 */
            Audio_EQ_SetBass(bass_db);
            if (bass_db != 0)
                Audio_EQ_Enable(1);
            else if (CS43131_g.eq.mid_gain_db == 0 && CS43131_g.eq.treble_gain_db == 0)
                Audio_EQ_Enable(0); /* 所有频段归零则关闭 EQ */
            prev_l = pct_l;
        }
    }

    /* ---- Fader M → Echo Mix (0~40%) + Auto Enable ---- */
    {
        int dm = (int)pct_m - (int)prev_m; if (dm < 0) dm = -dm;
        if (dm >= 3) {
            uint8_t echo_mix = (uint8_t)((uint32_t)pct_m * 40 / 100); /* 0%→0, 100%→40 */
            uint8_t echo_fb  = (uint8_t)((uint32_t)pct_m * 80 / 100);  /* 0%→0, 100%→80 (~31%) */
            if (pct_m > 2) {
                if (!CS43131_g.echo.enable)
                    Audio_Echo_Enable(1); /* 仅首次启用时清空延迟线 */
                Audio_Echo_SetParams(60, echo_fb, echo_mix); /* 60ms delay */
            } else {
                if (CS43131_g.echo.enable)
                    Audio_Echo_Enable(0);
            }
            prev_m = pct_m;
        }
    }

    /* ---- Fader R → Compressor (threshold 0 ~ -18dB, ratio 1~3) ---- */
    {
        int dr = (int)pct_r - (int)prev_r; if (dr < 0) dr = -dr;
        if (dr >= 3) {
            if (pct_r > 2) {
                int16_t threshold = -(int16_t)((uint32_t)pct_r * 18 / 100); /* 0%→0, 100%→-18 */
                int16_t ratio = 1 + (int16_t)((uint32_t)pct_r * 2 / 100);   /* 0%→1, 100%→3 */
                int16_t makeup = (int16_t)((uint32_t)pct_r * 5 / 100);      /* 补偿增益 0~5dB */
                Audio_Comp_SetParams(threshold, ratio, makeup);
                if (!CS43131_g.compressor.enable)
                    Audio_Comp_Enable(1);
            } else {
                if (CS43131_g.compressor.enable)
                    Audio_Comp_Enable(0);
            }
            prev_r = pct_r;
        }
    }
}

static void Keyboard_HandleGameInput(const protocol_frame_t *req)
{
    static uint8_t prev_buttons = 0;
    static uint8_t prev_switches = 0;
    static uint8_t prev_ec_buttons = 0;
    static int8_t prev_ec1_delta = 0;
    static int8_t prev_ec2_delta = 0;

    if (req->len < 10)  /* CMD + 9 bytes DATA */
    {
        printf("[GAME] Frame too short: %d\r\n", req->len);
        return;
    }

    /* Parse 9-byte game input data (joystick: uint8 0~255, center=128) */
    game_state.roc1_x    = req->data[0];
    game_state.roc1_y    = req->data[1];
    game_state.roc2_x    = req->data[2];
    game_state.roc2_y    = req->data[3];
    game_state.buttons   = req->data[4];
    game_state.switches  = req->data[5];
    game_state.ec1_delta = (int8_t)req->data[6];
    game_state.ec2_delta = (int8_t)req->data[7];
    game_state.ec_buttons = req->data[8];

    game_active = 1;

    /* ROC1 direction detection with hysteresis (deadzone expansion)
     * NOTE: X/Y axes are swapped on Keyboard-2 hardware;
     * roc1_x is actually Y (up/down), roc1_y is actually X (left/right).
     * Press threshold: <100 or >156
     * Release threshold: <120 or >136 (wider deadzone prevents jitter) */
    uint8_t raw_dir_keys = 0;
    if (game_state.roc1_x > ROC_PRESS_HIGH)  raw_dir_keys |= 0x01; /* S (down) */
    if (game_state.roc1_x < ROC_PRESS_LOW)   raw_dir_keys |= 0x02; /* W (up) */
    if (game_state.roc1_y < ROC_PRESS_LOW)   raw_dir_keys |= 0x04; /* A (left) */
    if (game_state.roc1_y > ROC_PRESS_HIGH)  raw_dir_keys |= 0x08; /* D (right) */

    /* Hysteresis: use separate release thresholds */
    uint8_t cur_dir_keys = prev_dir_keys;
    /* Press: if raw has the bit and prev doesn't, set it */
    cur_dir_keys |= raw_dir_keys;
    /* Release: only clear if value is within release zone */
    if (game_state.roc1_x < ROC_RELEASE_HIGH && game_state.roc1_x > ROC_RELEASE_LOW)
        cur_dir_keys &= ~0x01; /* S release */
    if (game_state.roc1_x < ROC_RELEASE_HIGH && game_state.roc1_x > ROC_RELEASE_LOW)
        cur_dir_keys &= ~0x02; /* W release */
    if (game_state.roc1_y < ROC_RELEASE_HIGH && game_state.roc1_y > ROC_RELEASE_LOW)
        cur_dir_keys &= ~0x04; /* A release */
    if (game_state.roc1_y < ROC_RELEASE_HIGH && game_state.roc1_y > ROC_RELEASE_LOW)
        cur_dir_keys &= ~0x08; /* D release */

    uint8_t dir_changed = cur_dir_keys ^ prev_dir_keys;
    if (dir_changed) {
        if (dir_changed & 0x01) printf("[GAME] %s\r\n", (cur_dir_keys & 0x01) ? "S(DOWN) press" : "S(DOWN) release");
        if (dir_changed & 0x02) printf("[GAME] %s\r\n", (cur_dir_keys & 0x02) ? "W(UP) press" : "W(UP) release");
        if (dir_changed & 0x04) printf("[GAME] %s\r\n", (cur_dir_keys & 0x04) ? "A(LEFT) press" : "A(LEFT) release");
        if (dir_changed & 0x08) printf("[GAME] %s\r\n", (cur_dir_keys & 0x08) ? "D(RIGHT) press" : "D(RIGHT) release");
        prev_dir_keys = cur_dir_keys;
    }

    /* Log ROC2 mouse movement (only when non-zero)
     * NOTE: X/Y axes are swapped on Keyboard-2 hardware. */
    int16_t mx = (int16_t)game_state.roc2_y - 128;  /* was roc2_x */
    int16_t my = (int16_t)game_state.roc2_x - 128;  /* was roc2_y */
    int8_t ec_x = game_state.ec2_delta;  /* was ec1_delta */
    int8_t ec_y = game_state.ec1_delta;  /* was ec2_delta */
    if (mx != 0 || my != 0 || ec_x != 0 || ec_y != 0) {
        printf("[GAME] Mouse: ROC2(%+4d,%+4d) EC1:%+4d EC2:%+4d\r\n",
               mx, my, ec_x, ec_y);
    }

    /* Log non-joystick data changes only (buttons, switches, encoders) */
    if (game_state.buttons != prev_buttons ||
        game_state.switches != prev_switches ||
        game_state.ec_buttons != prev_ec_buttons ||
        game_state.ec1_delta != prev_ec1_delta ||
        game_state.ec2_delta != prev_ec2_delta) {
        printf("[GAME] Btn:0x%02X SW:0x%02X EC1:%+4d EC2:%+4d ECD:0x%02X\r\n",
               game_state.buttons, game_state.switches,
               game_state.ec1_delta, game_state.ec2_delta,
               game_state.ec_buttons);
        prev_buttons = game_state.buttons;
        prev_switches = game_state.switches;
        prev_ec_buttons = game_state.ec_buttons;
        prev_ec1_delta = game_state.ec1_delta;
        prev_ec2_delta = game_state.ec2_delta;
    }

    /* Forward to Display as standard HID keyboard + mouse events */
    Keyboard_SendGameInputAsHID();
}

/* Convert gamepad state to standard HID keyboard + mouse reports and send to Display.
 * ROC1 is mapped to HID arrow keys (not WASD) so that Display's ui_input_feed_keyboard()
 * automatically generates UI_EVENT_KEY_*_ARROW events — no game changes needed for direction.
 * BUT3-6 are mapped to HJKL letter keys for game-specific actions. */
static void Keyboard_SendGameInputAsHID(void)
{
    uint8_t kb_report[8] = {0};
    uint8_t ms_report[4] = {0};
    uint8_t slot = 2;  /* key slots start at index 2 in HID report */

    if (!Keyboard_IsDisplayOnline())
        return;

    /* --- Keyboard report --- */
    /* Modifiers from switches (2 bits each: 00=mid, 01=up, 10=down) */
    if ((game_state.switches & 0x03) == 0x01)       kb_report[0] |= 0x02; /* SW1 → L-Shift */
    if (((game_state.switches >> 2) & 0x03) == 0x01) kb_report[0] |= 0x01; /* SW2 → L-Ctrl */
    if (((game_state.switches >> 4) & 0x03) == 0x01) kb_report[0] |= 0x04; /* SW3 → L-Alt */

    /* ROC1 → HID arrow keys (using debounced prev_dir_keys)
     * Bitmask: 0x01=S(down), 0x02=W(up), 0x04=A(left), 0x08=D(right) */
    if (prev_dir_keys & 0x02) kb_report[slot++] = 0x52; /* Up arrow (W) */
    if (prev_dir_keys & 0x01) kb_report[slot++] = 0x51; /* Down arrow (S) */
    if (prev_dir_keys & 0x04) kb_report[slot++] = 0x50; /* Left arrow (A) */
    if (prev_dir_keys & 0x08) kb_report[slot++] = 0x4F; /* Right arrow (D) */

    /* BUT3-6 → HJKL letter keys */
    if ((game_state.buttons & (1 << 2)) && slot < 8) kb_report[slot++] = 0x0B; /* H */
    if ((game_state.buttons & (1 << 3)) && slot < 8) kb_report[slot++] = 0x0D; /* J */
    if ((game_state.buttons & (1 << 4)) && slot < 8) kb_report[slot++] = 0x0E; /* K */
    if ((game_state.buttons & (1 << 5)) && slot < 8) kb_report[slot++] = 0x0F; /* L */

    /* --- Mouse report --- */
    /* Buttons: BUT1=left, BUT2=right, EC1_D=middle */
    if (game_state.buttons & (1 << 0)) ms_report[0] |= 0x01;
    if (game_state.buttons & (1 << 1)) ms_report[0] |= 0x02;
    if (game_state.ec_buttons & (1 << 0)) ms_report[0] |= 0x04;

    /* Movement: ROC2 (centered + scaled) + encoder deltas
     * NOTE: X/Y axes are swapped on Keyboard-2 hardware;
     * roc2_x is actually Y (up/down), roc2_y is actually X (left/right). */
    int16_t mx = (int16_t)game_state.roc2_y - 128;  /* was roc2_x */
    mx = mx / 8;
    mx += (int16_t)game_state.ec2_delta * 3;  /* was ec1_delta */
    if (mx > 127) mx = 127; if (mx < -128) mx = -128;
    ms_report[1] = (uint8_t)(int8_t)mx;

    int16_t my = (int16_t)game_state.roc2_x - 128;  /* was roc2_y */
    my = my / 8;
    my += (int16_t)game_state.ec1_delta * 3;  /* was ec2_delta */
    if (my > 127) my = 127; if (my < -128) my = -128;
    ms_report[2] = (uint8_t)(int8_t)my;

    /* Send to Display */
    Display_SendInputEvent(&display_g, INPUT_DEV_KEYBOARD, kb_report, 8);
    Display_SendInputEvent(&display_g, INPUT_DEV_MOUSE, ms_report, 4);
}

const game_input_state_t *Keyboard_Game_GetState(void)
{
    if (!game_active || keyboard_ptr == NULL)
        return NULL;
    if (keyboard_ptr->type_id != MODULE_SUBTYPE_KEYBOARD_GAME)
        return NULL;
    return &game_state;
}

/* ============================================================================
 * Music Keyboard 控制 API
 * ============================================================================ */

uint8_t Keyboard_Music_Start(void)
{
    uint8_t data[1];
    uint8_t buf[PROTO_MAX_FRAME_LEN];
    uint16_t len;

    if (keyboard_ptr == NULL)
        return 0;

    if (keyboard_ptr->type_id != MODULE_SUBTYPE_KEYBOARD_MUSIC)
        return 0;

    data[0] = 0x01;  /* start */
    len = Protocol_PackFrame(MODULE_ID_CORE, MODULE_ID_KEYBOARD,
                             CMD_KBD_MUSIC_EVENT_CTRL,
                             data, 1, buf, sizeof(buf));
    if (len == 0)
        return 0;

    Keyboard_Send_Data(keyboard_ptr, buf, len);
    music_active = 1;

    /* 清空状态 */
    prev_key_bitmap[0] = prev_key_bitmap[1] = prev_key_bitmap[2] = 0;
    prev_button_bitmap[0] = prev_button_bitmap[1] = 0;
    current_playing_key = 0;

    /* 启用效果器总开关 + 电子琴增强预设 */
    Audio_FX_MasterEnable(1);
    Audio_FX_ApplyMusicPreset();

    printf("[MUSIC] Keyboard-3 event reporting STARTED (FX + piano preset)\r\n");
    return 1;
}

uint8_t Keyboard_Music_Stop(void)
{
    uint8_t data[1];
    uint8_t buf[PROTO_MAX_FRAME_LEN];
    uint16_t len;

    if (keyboard_ptr == NULL)
        return 0;

    if (keyboard_ptr->type_id != MODULE_SUBTYPE_KEYBOARD_MUSIC)
        return 0;

    data[0] = 0x00;  /* stop */
    len = Protocol_PackFrame(MODULE_ID_CORE, MODULE_ID_KEYBOARD,
                             CMD_KBD_MUSIC_EVENT_CTRL,
                             data, 1, buf, sizeof(buf));
    if (len == 0)
        return 0;

    Keyboard_Send_Data(keyboard_ptr, buf, len);
    music_active = 0;

    /* 停止播放并关闭效果器总开关 */
    Audio_PlayStop();
    Audio_FX_MasterEnable(0);
    current_playing_key = 0;
    prev_key_bitmap[0] = prev_key_bitmap[1] = prev_key_bitmap[2] = 0;
    prev_button_bitmap[0] = prev_button_bitmap[1] = 0;

    printf("[MUSIC] Keyboard-3 event reporting STOPPED (FX disabled)\r\n");
    return 1;
}

uint8_t Keyboard_Music_IsActive(void)
{
    return music_active;
}

void Keyboard_Music_Disable(void)
{
    /* 强制关闭音乐/效果器（不校验当前子类型，也不向键盘发帧）。
     * 供心跳检测到键盘子类型不再是音乐键盘时调用。 */
    if (!music_active)
        return;

    music_active = 0;
    Audio_PlayStop();
    Audio_FX_MasterEnable(0);
    current_playing_key = 0;
    prev_key_bitmap[0] = prev_key_bitmap[1] = prev_key_bitmap[2] = 0;
    prev_button_bitmap[0] = prev_button_bitmap[1] = 0;
    printf("[MUSIC] Force-disabled (keyboard subtype changed)\r\n");
}
