sratle/WCH-Model-Terminal/main-model/core/Common/Common/Display/display.c

#include "display.h"
#include "../Protocol/protocol_common.h"
#include "../CS43131/cs43131.h"
#include "../CH378/CH378.h"
#include "../CH585F/ch585f.h"
#include "../CH585F/ch585f_bt.h"
#include "../CLI/CLI.h"
#include "../Config/config.h"
#include "../Power/power.h"
#include "../CH9350/CH9350.h"
#include "../Submodels/submodels.h"
#include "../Auth/auth.h"
#include "../hardware.h"
#include <string.h>

display_t *display_ptr = NULL;

/* External globals from hardware.c */
extern cs43131_t CS43131_g;
extern ch378_t ch378_g;
extern ch585f_t ch585f_g;

/* CLI printf capture (defined in ch585f_bt.c) */
extern uint8_t cli_capture_buf[];
extern uint16_t cli_capture_len;
extern uint8_t cli_capture_flag;

/* ============================================================================
 * 前向声明：Display 专用命令 handler
 *
 * V3.0 CLI 直通重构后：
 *   - 文件操作/音乐控制/目录导航 → 全部通过 CLI 直通（DISP_EXT_CLI）
 *   - 显示控制（亮度/旋转/页面/屏幕/通知/复位）→ 保留专用操作码
 *   - 查询类（亮度/旋转/屏幕状态）→ 保留专用操作码
 *   - 事件类（输入/音乐状态/模块/蓝牙/电源/Submodel）→ 保留专用操作码
 *
 * 已废弃操作码（0x06-0x0B, 0x14, 0x19 扩展; 0x1B, 0x1D 基础）→ 回复 NACK
 * ============================================================================ */

/* 保留的 handler */
static uint8_t Display_HandleGetBrightness(const protocol_frame_t *req,
                                           uint8_t *resp_buf, uint16_t resp_size, uint8_t *resp_len);
static uint8_t Display_HandleGetRotation(const protocol_frame_t *req,
                                         uint8_t *resp_buf, uint16_t resp_size, uint8_t *resp_len);
static uint8_t Display_HandleGetScreenState(const protocol_frame_t *req,
                                            uint8_t *resp_buf, uint16_t resp_size, uint8_t *resp_len);
static uint8_t Display_HandleAppLaunch(const protocol_frame_t *req,
                                       uint8_t *resp_buf, uint16_t resp_size, uint8_t *resp_len);
static uint8_t Display_HandleAppClose(const protocol_frame_t *req,
                                      uint8_t *resp_buf, uint16_t resp_size, uint8_t *resp_len);
static uint8_t Display_HandleAppData(const protocol_frame_t *req,
                                     uint8_t *resp_buf, uint16_t resp_size, uint8_t *resp_len);
static uint8_t Display_HandleGetModuleStatus(const protocol_frame_t *req,
                                             uint8_t *resp_buf, uint16_t resp_size, uint8_t *resp_len);
static uint8_t Display_HandleBtControl(const protocol_frame_t *req,
                                       uint8_t *resp_buf, uint16_t resp_size, uint8_t *resp_len);
static uint8_t Display_HandleSaveConfig(const protocol_frame_t *req,
                                        uint8_t *resp_buf, uint16_t resp_size, uint8_t *resp_len);
static uint8_t Display_HandleLoadConfig(const protocol_frame_t *req,
                                        uint8_t *resp_buf, uint16_t resp_size, uint8_t *resp_len);
static uint8_t Display_HandleSetRgbMode(const protocol_frame_t *req,
                                        uint8_t *resp_buf, uint16_t resp_size, uint8_t *resp_len);
static uint8_t Display_HandleCLI(const protocol_frame_t *req,
                                 uint8_t *resp_buf, uint16_t resp_size, uint8_t *resp_len);

/* 事件类 handler（Core -> Display，无需响应） */
static void Display_HandleInputEvent(const protocol_frame_t *req);
static void Display_HandleModuleStatus(const protocol_frame_t *req);
static void Display_HandleBtEvent(const protocol_frame_t *req);
static void Display_HandleSubmodelEvent(const protocol_frame_t *req);
static void Display_HandlePowerEvent(const protocol_frame_t *req);
static void Display_HandleConfigResult(const protocol_frame_t *req);
static void Display_HandleErrorReport(const protocol_frame_t *req);
static void Display_HandleRgbEffect(const protocol_frame_t *req);

/* ============================================================================
 * UART 初始化与数据收发
 * ============================================================================ */

void Display_Init(display_t *display)
{
    GPIO_InitTypeDef GPIO_InitStructure;
    USART_InitTypeDef USART_InitStructure;

    RCC_HB2PeriphClockCmd(RCC_HB2Periph_AFIO | RCC_HB2Periph_GPIOF, ENABLE);
    RCC_HB1PeriphClockCmd(RCC_HB1Periph_USART4, ENABLE);

    GPIO_PinAFConfig(DISPLAY_UART_TX_PORT, GPIO_PinSource4, DISPLAY_UART_TX_AF);
    GPIO_PinAFConfig(DISPLAY_UART_RX_PORT, GPIO_PinSource3, DISPLAY_UART_RX_AF);

    GPIO_InitStructure.GPIO_Pin = DISPLAY_UART_TX_PIN;
    GPIO_InitStructure.GPIO_Speed = GPIO_Speed_Very_High;
    GPIO_InitStructure.GPIO_Mode = GPIO_Mode_AF_PP;
    GPIO_Init(DISPLAY_UART_TX_PORT, &GPIO_InitStructure);

    GPIO_InitStructure.GPIO_Pin = DISPLAY_UART_RX_PIN;
    GPIO_InitStructure.GPIO_Speed = GPIO_Speed_Very_High;
    GPIO_InitStructure.GPIO_Mode = GPIO_Mode_IN_FLOATING;
    GPIO_Init(DISPLAY_UART_RX_PORT, &GPIO_InitStructure);

    USART_InitStructure.USART_BaudRate = DISPLAY_UART_BAUDRATE;
    USART_InitStructure.USART_WordLength = USART_WordLength_8b;
    USART_InitStructure.USART_StopBits = USART_StopBits_1;
    USART_InitStructure.USART_Parity = USART_Parity_No;
    USART_InitStructure.USART_HardwareFlowControl = USART_HardwareFlowControl_None;
    USART_InitStructure.USART_Mode = USART_Mode_Tx | USART_Mode_Rx;

    USART_Init(DISPLAY_UART, &USART_InitStructure);
    USART_Cmd(DISPLAY_UART, ENABLE);

    USART_ITConfig(DISPLAY_UART, USART_IT_RXNE, ENABLE);
    NVIC_SetPriority(DISPLAY_UART_IRQn, 1 << 4);
    NVIC_EnableIRQ(DISPLAY_UART_IRQn);

    Protocol_InitRxCtx(&display->rx_ctx);

    display->bulk_state = BULK_IDLE;
    display->bulk_total_size = 0;
    display->bulk_received = 0;
    display->bulk_block_size = DISPLAY_BULK_BLOCK_SIZE;

    Display_Get_Type(display);
    display_ptr = display;
}

void Display_UART_IRQ_Handler(display_t *display)
{
    if (display == NULL)
        return;

    if (USART_GetITStatus(DISPLAY_UART, USART_IT_RXNE) != RESET)
    {
        uint8_t byte = (uint8_t)USART_ReceiveData(DISPLAY_UART);
        Protocol_ParseByte(&display->rx_ctx, byte);
    }

    /* 热插拔噪声防护：ORE/FE/NE 置位时读 STATR+DATAR 清除，
     * 否则错误标志滞留会导致中断反复触发、RX 永久卡死 */
    if (USART_GetFlagStatus(DISPLAY_UART, USART_FLAG_ORE) != RESET ||
        USART_GetFlagStatus(DISPLAY_UART, USART_FLAG_FE)  != RESET ||
        USART_GetFlagStatus(DISPLAY_UART, USART_FLAG_NE)  != RESET)
    {
        (void)USART_ReceiveData(DISPLAY_UART);
    }
}

void Display_Get_Type(display_t *display)
{
    uint8_t buf[PROTO_MAX_FRAME_LEN];
    uint16_t len;

    len = Protocol_PackFrame(MODULE_ID_CORE, MODULE_ID_DISPLAY,
                             CMD_GET_TYPE, NULL, 0,
                             buf, sizeof(buf));
    if (len > 0)
    {
        printf("[Display] CMD_GET_TYPE sent, %d bytes:", len);
        for (uint16_t i = 0; i < len; i++) {
            printf(" %02X", buf[i]);
        }
        printf("\r\n");
        Display_Send_Data(display, buf, len);
        display->type_requested = 1;
    }
}

void Display_Send_Data(display_t *display, const uint8_t *data, uint16_t length)
{
    uint16_t i;
    (void)display;

    for (i = 0; i < length; i++)
    {
        while (USART_GetFlagStatus(DISPLAY_UART, USART_FLAG_TC) == RESET)
            ;
        USART_SendData(DISPLAY_UART, *data++);
    }
}

/* ============================================================================
 * 通用命令回调
 * ============================================================================ */

static uint8_t display_on_get_type(const protocol_frame_t *req,
                                   uint8_t *resp_buf, uint16_t resp_size,
                                   uint8_t *resp_len)
{
    (void)req;
    (void)resp_size;
    resp_buf[0] = MODULE_TYPE_DISPLAY;
    resp_buf[1] = MODULE_SUBTYPE_DISPLAY_LCD;
    resp_buf[2] = 0x01; /* hw_ver */
    resp_buf[3] = 0x01; /* fw_major */
    resp_buf[4] = 0x00; /* fw_minor */
    *resp_len = 5;
    return 1;
}

static const protocol_common_cb_t display_common_cb = {
    .on_get_type = display_on_get_type,
};

/* ============================================================================
 * 专用命令分发辅助函数
 * ============================================================================ */

/**
 * @brief  请求/动作类 handler 的统一分发与 ACK/NACK 打包
 */
static uint8_t display_dispatch_req(const protocol_frame_t *req,
                                    uint8_t (*handler)(const protocol_frame_t *,
                                                       uint8_t *, uint16_t, uint8_t *),
                                    uint8_t *resp_buf, uint16_t resp_size)
{
    uint8_t data_len = 0;

    if (handler == NULL)
        return ProtocolCommon_Nack(req->dst, req->src, PROTO_ERR_UNSUPPORTED_CMD,
                                   resp_buf, resp_size);

    if (!handler(req, resp_buf, resp_size, &data_len))
        return ProtocolCommon_Nack(req->dst, req->src, PROTO_ERR_UNSUPPORTED_CMD,
                                   resp_buf, resp_size);

    if (data_len > 0)
        return Protocol_PackFrame(req->dst, req->src, CMD_ACK,
                                  resp_buf, data_len, resp_buf, resp_size);

    return ProtocolCommon_Ack(req->dst, req->src, resp_buf, resp_size);
}

/* ============================================================================
 * 主循环帧处理
 * ============================================================================ */

void Display_Process(display_t *display)
{
    uint8_t resp[PROTO_MAX_FRAME_LEN];
    uint8_t resp_len = 0;
    uint8_t handled = 0;
    /* 帧拷贝（static 避免占用栈，主循环单线程安全） */
    static protocol_frame_t s_req_copy;
    protocol_frame_t *req;

    if (display == NULL || !display->rx_ctx.frame_ready)
        return;

    /* 先拷贝并立即释放 read_frame：处理（尤其 CLI 直通，含 PreFill/
     * Delay_Ms(20)/分帧发送，耗时几十 ms，LFN ls 可达 ~1.5s）期间 ISR
     * 才能接收并停放下一帧。此前 read_frame 在整个处理期间被占，
     * commit_frame 的保旧丢新策略会把处理期间到达的所有帧静默丢弃
     * （SFX play 之后的 pause/ls 丢失的根因）。 */
    memcpy(&s_req_copy, &display->rx_ctx.read_frame, sizeof(protocol_frame_t));
    Protocol_ResetRxCtx(&display->rx_ctx);
    req = &s_req_copy;

    /* 0. 处理 Display 返回的 ACK 响应（Core 发送请求后 Display 的回复）。
     * 仅 GET_TYPE 身份 ACK（len==6 且 type 匹配）参与心跳/类型管理，
     * 其他查询 ACK（如 GET_STATUS 的 3 字节状态）不得污染槽位类型。 */
    if (req->cmd == CMD_ACK)
    {
        if (req->len == 6 && req->data[0] == MODULE_TYPE_DISPLAY)
        {
            module_identity_t id;
            if (Protocol_ParseIdentity(req, &id))
            {
                /* 首次识别 / 热插拔重连 / 换插不同型号屏：重新下发配置
                 * （type_received 在心跳判定 OFFLINE 时会被复位） */
                if (!display->type_received || display->type_id != id.subtype)
                {
                    display->type_received = 1;
                    display->type_id = id.subtype;
                    display->identity = id;
                    printf("[Display] GET_TYPE ACK: type=0x%02X subtype=0x%02X hw=0x%02X fw=%d.%d\r\n",
                           id.type, id.subtype, id.hw_ver, id.fw_major, id.fw_minor);
                    /* Display 刚上线，重新下发配置（可能在 Config_Init 时 Display 尚未就绪） */
                    Config_Apply();
                    /* 同步当前登录用户（Core 重启后 Display 侧缓存的用户名可能过期） */
                    Auth_ReportStatusToDisplay();
                }
                /* 更新心跳在线状态 */
                Hardware_Hb_MarkOnline(MODULE_ID_DISPLAY, id.type, id.subtype);
            }
        }
        handled = 1;
    }
    /* 处理 Display 返回的 NACK 响应 */
    else if (req->cmd == CMD_NACK)
    {
        if (display->type_requested && !display->type_received)
        {
            uint8_t err_code = (req->len >= 2) ? req->data[0] : 0xFF;
            printf("[Display] GET_TYPE NACK: err=0x%02X\r\n", err_code);
        }
        handled = 1;
    }
    /* 1. 通用命令（0x00~0x0F） */
    else if (ProtocolCommon_Dispatch(req, &display_common_cb,
                                resp, sizeof(resp), &resp_len))
    {
        handled = 1;
    }
    /* 2. Display 扩展操作码：CMD = 0x10, DATA[0] 为子命令 */
    else if (req->cmd == CMD_DISP_EXTENSION)
    {
        if (req->len >= 2)
        {
            uint8_t ext = req->data[0];
            switch (ext)
            {
                /* ---- CLI 直通（Display→Core 文件/音乐/目录操作统一入口） ---- */
                case CMD_DISP_EXT_CLI:
                    Display_HandleCLI(req, resp, sizeof(resp), &resp_len);
                    /* CLI response already sent via Display_SendCLIResponse, no ACK needed */
                    resp_len = 0;
                    handled = 1;
                    break;

                /* ---- 保留的请求/动作类 ---- */
                case CMD_DISP_EXT_APP_LAUNCH:
                    resp_len = display_dispatch_req(req, Display_HandleAppLaunch,
                                                    resp, sizeof(resp));
                    handled = 1;
                    break;
                case CMD_DISP_EXT_APP_CLOSE:
                    resp_len = display_dispatch_req(req, Display_HandleAppClose,
                                                    resp, sizeof(resp));
                    handled = 1;
                    break;
                case CMD_DISP_EXT_APP_DATA:
                    resp_len = display_dispatch_req(req, Display_HandleAppData,
                                                    resp, sizeof(resp));
                    handled = 1;
                    break;
                case CMD_DISP_EXT_GET_MODULE_STATUS:
                    resp_len = display_dispatch_req(req, Display_HandleGetModuleStatus,
                                                    resp, sizeof(resp));
                    handled = 1;
                    break;
                case CMD_DISP_EXT_BT_CONTROL:
                    resp_len = display_dispatch_req(req, Display_HandleBtControl,
                                                    resp, sizeof(resp));
                    handled = 1;
                    break;
                case CMD_DISP_EXT_SAVE_CONFIG:
                    resp_len = display_dispatch_req(req, Display_HandleSaveConfig,
                                                    resp, sizeof(resp));
                    handled = 1;
                    break;
                case CMD_DISP_EXT_LOAD_CONFIG:
                    resp_len = display_dispatch_req(req, Display_HandleLoadConfig,
                                                    resp, sizeof(resp));
                    handled = 1;
                    break;
                case CMD_DISP_EXT_SET_RGB_MODE:
                    resp_len = display_dispatch_req(req, Display_HandleSetRgbMode,
                                                    resp, sizeof(resp));
                    handled = 1;
                    break;

                /* ---- 已废弃（V3.0 CLI 直通替代）：默认 NACK ---- */
                /* 0x06-0x0B (FILE_LIST/READ/SAVE/OP/PLAY_MUSIC), 0x14 (BULK), 0x19 (CD)
                 * 均由 CLI 直通替代，走 default → NACK */

                /* ---- 事件类（Core -> Display，无需响应） ---- */
                case CMD_DISP_EXT_MODULE_STATUS:
                    Display_HandleModuleStatus(req);
                    handled = 1;
                    break;
                case CMD_DISP_EXT_BT_EVENT:
                    Display_HandleBtEvent(req);
                    handled = 1;
                    break;
                case CMD_DISP_EXT_SUBMODEL_EVENT:
                    Display_HandleSubmodelEvent(req);
                    handled = 1;
                    break;
                case CMD_DISP_EXT_POWER_EVENT:
                    Display_HandlePowerEvent(req);
                    handled = 1;
                    break;
                case CMD_DISP_EXT_CONFIG_RESULT:
                    Display_HandleConfigResult(req);
                    handled = 1;
                    break;
                case CMD_DISP_EXT_ERROR_REPORT:
                    Display_HandleErrorReport(req);
                    handled = 1;
                    break;
                /* ---- RGB 一次性动画事件（Display -> Core，发送即忘） ---- */
                case CMD_DISP_EXT_RGB_EFFECT:
                    Display_HandleRgbEffect(req);
                    handled = 1;
                    break;

                /* ---- 系统状态拉取（Display 进页一次）：重发全部反应式状态 ---- */
                case CMD_DISP_EXT_GET_SYS_STATUS:
                    Hardware_ReportModuleStatusToDisplay();  /* 模块在线（含 Power） */
                    Power_ReportStatusToDisplay(&power_g);    /* 电量/充电 */
                    CH585F_BT_ReportStatusToDisplay();        /* 无线在线/连接/流量 */
                    CH9350_ReportHidStatusToDisplay(&ch9350_g); /* 外接 HID(USB) */
                    Auth_ReportStatusToDisplay();     /* 当前登录用户 */
                    handled = 1;
                    break;

                /* ---- 设置类（Core -> Display，发送即忘） ---- */
                case CMD_DISP_EXT_SUBDISP_CONTENT:
                case CMD_DISP_EXT_SUBDISP_CONFIG:
                case CMD_DISP_EXT_HID_STATUS:
                    /* Display 收到后执行，不回复 */
                    handled = 1;
                    break;

                default:
                    resp_len = ProtocolCommon_Nack(req->dst, req->src,
                                                   PROTO_ERR_UNSUPPORTED_CMD,
                                                   resp, sizeof(resp));
                    handled = 1;
                    break;
            }
        }
        else
        {
            resp_len = ProtocolCommon_Nack(req->dst, req->src,
                                           PROTO_ERR_INVALID_PARAM,
                                           resp, sizeof(resp));
            handled = 1;
        }
    }
    /* 3. Display 基础操作码：0x11 ~ 0x1E */
    else if (req->cmd >= CMD_DISP_SET_BRIGHTNESS && req->cmd <= CMD_DISP_FACTORY_RESET)
    {
        switch (req->cmd)
        {
            /* ---- 事件类（Core -> Display，无需响应） ---- */
            case CMD_DISP_INPUT_EVENT:
                Display_HandleInputEvent(req);
                handled = 1;
                break;

            /* ---- 查询类（Display -> Core，需要 ACK + 数据） ---- */
            case CMD_DISP_GET_BRIGHTNESS:
                resp_len = display_dispatch_req(req, Display_HandleGetBrightness,
                                                resp, sizeof(resp));
                handled = 1;
                break;
            case CMD_DISP_GET_ROTATION:
                resp_len = display_dispatch_req(req, Display_HandleGetRotation,
                                                resp, sizeof(resp));
                handled = 1;
                break;
            case CMD_DISP_GET_SCREEN_STATE:
                resp_len = display_dispatch_req(req, Display_HandleGetScreenState,
                                                resp, sizeof(resp));
                handled = 1;
                break;

            /* ---- 已废弃（V3.0 CLI 直通替代）：默认 NACK ---- */
            /* CMD_DISP_MUSIC_CONTROL (0x1B), CMD_DISP_VOLUME_CONTROL (0x1D)
             * 均由 CLI 直通替代，走 default → NACK */

            /* ---- 设置类（Core -> Display，发送即忘） ---- */
            case CMD_DISP_SET_BRIGHTNESS:
            case CMD_DISP_SHOW_PAGE:
            case CMD_DISP_UPDATE_STATUS:
            case CMD_DISP_SET_ROTATION:
            case CMD_DISP_SCREEN_CONTROL:
            case CMD_DISP_SHOW_NOTICE:
            case CMD_DISP_MUSIC_STATUS:
            case CMD_DISP_FACTORY_RESET:
                /* Display 收到后执行，不回复 */
                handled = 1;
                break;

            default:
                resp_len = ProtocolCommon_Nack(req->dst, req->src,
                                               PROTO_ERR_UNSUPPORTED_CMD,
                                               resp, sizeof(resp));
                handled = 1;
                break;
        }
    }

    /* 发送响应（如果有） */
    if (handled && resp_len > 0)
        Display_Send_Data(display, resp, resp_len);

    /* 状态变化推送：也在主循环里独立调用 Display_SyncStatus()，
     * 因此即使 Display 长时间不发帧，Core 侧的状态变化也能及时同步。 */
    Display_SyncStatus(display);
}

/*********************************************************************
 * @fn      Display_SyncStatus
 *
 * @brief   若音频/播放/音量/外放等状态有变化（status_dirty），
 *          主动向 Display 推送一次 MUSIC_STATUS。需在主循环中周期调用，
 *          不依赖是否收到 Display 帧。
 *********************************************************************/
void Display_SyncStatus(display_t *display)
{
    if (display == NULL || !display->type_received)
        return;

    if (Audio_IsStatusDirty())
    {
        Display_SendMusicStatus(display);
        Audio_ClearStatusDirty();
    }
}

/* ============================================================================
 * 基础操作码 handler 实现
 * ============================================================================ */

/* ---- 输入事件（事件类，Core -> Display） ---- */
static void Display_HandleInputEvent(const protocol_frame_t *req)
{
    /* Core 将输入事件转发给 Display，Display 侧更新 UI。
     * 此 handler 在 Core 侧不需要做任何事，因为 Core 是发送方。
     * 如果此函数被调用，说明 Display 发来了 INPUT_EVENT（异常情况），
     * 静默忽略即可。 */
    (void)req;
}

/* ---- 查询亮度（查询类，Display -> Core） ---- */
static uint8_t Display_HandleGetBrightness(const protocol_frame_t *req,
                                           uint8_t *resp_buf, uint16_t resp_size,
                                           uint8_t *resp_len)
{
    (void)req;
    int val = 50;
    Config_GetInt("0101", "brightness", &val);
    if (resp_size < 1)
        return 0;
    resp_buf[0] = (uint8_t)val;
    *resp_len = 1;
    return 1;
}

/* ---- 查询旋转角度（查询类，Display -> Core） ---- */
static uint8_t Display_HandleGetRotation(const protocol_frame_t *req,
                                         uint8_t *resp_buf, uint16_t resp_size,
                                         uint8_t *resp_len)
{
    (void)req;
    int val = 0;
    Config_GetInt("0101", "rotation", &val);
    if (resp_size < 1)
        return 0;
    resp_buf[0] = (uint8_t)val;
    *resp_len = 1;
    return 1;
}

/* ---- 查询屏幕状态（查询类，Display -> Core） ---- */
static uint8_t Display_HandleGetScreenState(const protocol_frame_t *req,
                                            uint8_t *resp_buf, uint16_t resp_size,
                                            uint8_t *resp_len)
{
    (void)req;
    if (resp_size < 4)
        return 0;
    /* 返回屏幕状态：[亮屏/息屏:1][亮度:1][旋转角度:1][自动息屏超时:1] */
    resp_buf[0] = 0x01; /* 亮屏 */
    resp_buf[1] = 50;   /* 亮度 */
    resp_buf[2] = 0;    /* 旋转角度 */
    resp_buf[3] = 30;   /* 自动息屏超时(秒) */
    *resp_len = 4;
    return 1;
}

/* ============================================================================
 * 扩展操作码 handler 实现
 * ============================================================================ */

/* ---- 启动应用（动作类，Display -> Core） ---- */
static uint8_t Display_HandleAppLaunch(const protocol_frame_t *req,
                                       uint8_t *resp_buf, uint16_t resp_size,
                                       uint8_t *resp_len)
{
    (void)req;
    (void)resp_buf;
    (void)resp_size;
    (void)resp_len;
    /* 应用管理待实现 */
    return 1;
}

/* ---- 关闭应用（动作类，Display -> Core） ---- */
static uint8_t Display_HandleAppClose(const protocol_frame_t *req,
                                      uint8_t *resp_buf, uint16_t resp_size,
                                      uint8_t *resp_len)
{
    (void)req;
    (void)resp_buf;
    (void)resp_size;
    (void)resp_len;
    return 1;
}

/* ---- 应用数据传输（数据通道，双向） ---- */
static uint8_t Display_HandleAppData(const protocol_frame_t *req,
                                     uint8_t *resp_buf, uint16_t resp_size,
                                     uint8_t *resp_len)
{
    (void)req;
    (void)resp_buf;
    (void)resp_size;
    (void)resp_len;
    /* 应用层数据通道，协议层不强制 ACK */
    return 1;
}

/* ---- 获取模块状态（查询类，Display -> Core） ---- */
static uint8_t Display_HandleGetModuleStatus(const protocol_frame_t *req,
                                             uint8_t *resp_buf, uint16_t resp_size,
                                             uint8_t *resp_len)
{
    (void)req;
    /* 返回扩展码 0x04 + 事件类型 0x02 + 模块列表
     * 格式: [0x04][0x02][N][模块1_ID][模块1_类型][模块1_子类型]...
     * 当前返回空列表 */
    if (resp_size < 3)
        return 0;
    resp_buf[0] = CMD_DISP_EXT_MODULE_STATUS;
    resp_buf[1] = 0x02; /* 完整模块列表 */
    resp_buf[2] = 0;    /* 模块数量 */
    *resp_len = 3;
    return 1;
}

/* ---- 蓝牙控制请求（动作类，Display -> Core） ---- */
static uint8_t Display_HandleBtControl(const protocol_frame_t *req,
                                       uint8_t *resp_buf, uint16_t resp_size,
                                       uint8_t *resp_len)
{
    uint8_t ctrl_type;
    (void)resp_buf;
    (void)resp_size;
    (void)resp_len;

    if (PROTO_DATA_LEN(*req) < 2)
        return 0;

    ctrl_type = req->data[1];

    switch (ctrl_type)
    {
        case BT_CTRL_SCAN_START:
        case BT_CTRL_SCAN_STOP:
        case BT_CTRL_CONNECT:
        case BT_CTRL_DISCONNECT:
        case BT_CTRL_DISCONNECT_ALL:
        case BT_CTRL_SET_DISCOVERABLE:
            /* 需要通过 SPI 向 CH585F 发送命令，待实现 */
            return 1;
        default:
            return 0;
    }
}

/* ---- 保存配置（动作类，Display -> Core） ---- */
static uint8_t Display_HandleSaveConfig(const protocol_frame_t *req,
                                        uint8_t *resp_buf, uint16_t resp_size,
                                        uint8_t *resp_len)
{
    (void)req;
    (void)resp_buf;
    (void)resp_size;
    (void)resp_len;
    /* TODO: 使用 CH378 保存配置文件 */
    return 1;
}

/* ---- 加载配置（查询类，Display -> Core） ---- */
static uint8_t Display_HandleLoadConfig(const protocol_frame_t *req,
                                        uint8_t *resp_buf, uint16_t resp_size,
                                        uint8_t *resp_len)
{
    (void)req;
    (void)resp_buf;
    (void)resp_size;
    (void)resp_len;
    /* TODO: 使用 CH378 加载配置文件 */
    return 1;
}

/* ---- 设置 RGB 灯效模式（动作类，Display -> Core） ---- */
static uint8_t Display_HandleSetRgbMode(const protocol_frame_t *req,
                                        uint8_t *resp_buf, uint16_t resp_size,
                                        uint8_t *resp_len)
{
    (void)req;
    (void)resp_buf;
    (void)resp_size;
    (void)resp_len;
    /* TODO: 通过 Submodel 转发给 RGB 模块 */
    return 1;
}

/* ---- CLI 命令直通（动作类，Display -> Core） ---- */
/* 使用 cli.c 已有的 CLI_Process 执行命令，通过 cli_capture 机制
 * 捕获 printf 输出，再通过 Display_SendCLIResponse 发回 Display。 */

static uint8_t Display_HandleCLI(const protocol_frame_t *req,
                                 uint8_t *resp_buf, uint16_t resp_size,
                                 uint8_t *resp_len)
{
    char cmd[256]; /* CLI_BUF_SIZE in cli.c */
    uint8_t cmd_len;

    (void)resp_buf;
    (void)resp_size;
    (void)resp_len;

    if (display_ptr == NULL)
        return 0;

    /* DATA[0] = ext_code, DATA[1..N] = command string */
    cmd_len = (uint8_t)(PROTO_DATA_LEN(*req) > 1 ? PROTO_DATA_LEN(*req) - 1 : 0);
    if (cmd_len > sizeof(cmd) - 1) cmd_len = sizeof(cmd) - 1;
    if (cmd_len > 0)
        memcpy(cmd, &req->data[1], cmd_len);
    cmd[cmd_len] = '\0';

    printf("[Display] CLI: \"%s\"\r\n", cmd);

    /* 启用 printf 捕获 */
    cli_capture_flag = 1;
    cli_capture_len = 0;

    /* 调用已有的 CLI 命令处理器 */
    CLI_Process((uint8_t *)cmd, cmd_len);

    /* 停止捕获 */
    cli_capture_flag = 0;

    /* CH378 状态稳定延时：仅文件类命令需要（cd/ls 等连续执行时 CH378 FAT32
     * 目录状态需要稳定）；音频控制类命令（play/pause/vol/stop 等）跳过此
     * 延时，显著降低每条 CLI 的占用时间，缓解命令积压时心跳 ACK 被丢弃。 */
    Delay_Ms(CLI_LastCmdNeededCH378() ? 20 : 2);

    /* 将捕获到的输出发回 Display，使用 SOF/EOF 标记多帧传输 */
    if (cli_capture_len > 0) {
        /* 分帧发送，每帧最大 239 字节 payload (1 ext_code + 1 flags + payload ≤ 250) */
        uint16_t offset = 0;
        uint8_t chunk_idx = 0;
        uint8_t total_chunks = (uint8_t)((cli_capture_len + 238) / 239);
        while (offset < cli_capture_len) {
            uint16_t chunk = cli_capture_len - offset;
            if (chunk > 239) chunk = 239;
            uint8_t flags = 0;
            if (chunk_idx == 0) flags |= CLI_FLAG_SOF;
            if (chunk_idx == total_chunks - 1) flags |= CLI_FLAG_EOF;
            Display_SendCLIResponseEx(display_ptr,
                                      (const char *)&cli_capture_buf[offset],
                                      chunk, flags);
            offset += chunk;
            chunk_idx++;
            /* Pace chunk frames: without a gap the display-side RX ring
             * overflows on large responses and silently drops frames
             * (EOF lost → response never dispatches → apps hang).
             * Display-1 polls the ring once per UI frame (~40ms at 25fps,
             * longer while rendering images), so keep well under the
             * ~92B/ms line rate: 5ms per ≤250B chunk ≈ 50B/ms leaves
             * ~2KB of inflow per 40ms poll window against the 8KB ring.
             * Display-2 (1bpp, 8KB CLI buffer) benefits the same. */
            if (offset < cli_capture_len) Delay_Ms(5);
        }
    } else {
        /* 无输出也发一个空响应（SOF+EOF），让 Display 知道命令已执行 */
        Display_SendCLIResponseEx(display_ptr, "ok\n", 3, CLI_FLAG_SOF | CLI_FLAG_EOF);
    }

    cli_capture_len = 0;

    /* 音乐控制类命令执行后，主动推送 MUSIC_STATUS 给 Display 同步状态。
     * playst 命令本身不修改状态（不会设置 dirty），但 Display 需要完整状态同步，
     * 因此对 playst 也强制推送。其他命令（pause/resume/stop/play/vol）会设置
     * dirty 标记，通过 IsStatusDirty 检测即可。 */
    if (strncmp(cmd, "playst", 6) == 0 || Audio_IsStatusDirty()) {
        Display_SendMusicStatus(display_ptr);
        Audio_ClearStatusDirty();
    }

    return 1; /* ACK 空（响应已通过 CLI response 帧发送） */
}

/* ---- 模块状态事件（事件类，Core -> Display） ---- */
static void Display_HandleModuleStatus(const protocol_frame_t *req)
{
    (void)req;
    /* Core 侧不需要处理，此事件是 Core 发给 Display 的 */
}

/* ---- 蓝牙事件（事件类，Core -> Display） ---- */
static void Display_HandleBtEvent(const protocol_frame_t *req)
{
    (void)req;
}

/* ---- Submodel 事件（事件类，Core -> Display） ---- */
static void Display_HandleSubmodelEvent(const protocol_frame_t *req)
{
    (void)req;
}

/* ---- 电源事件（事件类，Core -> Display） ---- */
static void Display_HandlePowerEvent(const protocol_frame_t *req)
{
    (void)req;
}

/* ---- 配置结果（事件类，Core -> Display） ---- */
static void Display_HandleConfigResult(const protocol_frame_t *req)
{
    (void)req;
}

/* ---- 错误上报（事件类，Display -> Core） ---- */
static void Display_HandleErrorReport(const protocol_frame_t *req)
{
    (void)req;
    /* TODO: 记录 Display 上报的错误 */
}

/* ---- RGB 一次性动画事件（Display -> Core，发送即忘） ----
 * DATA: [0x1E][effect:1][direction:1][speed:1]
 *   effect: 0=ripple(中心波纹，忽略 direction), 1=wave(边缘波浪)
 *   direction: 0=左→右, 1=右→左, 2=上→下, 3=下→上（仅 wave）
 *   speed: 档位 1~10（非法值由 RGB 模块按 8 档处理）
 * 转发给 RGB Submodel（CMD_SUB_SET_MODE SUB=0x04/0x05）。 */
static void Display_HandleRgbEffect(const protocol_frame_t *req)
{
    submodels_t *rgb;
    uint8_t effect, direction, speed;

    if (PROTO_DATA_LEN(*req) < 4)
        return;

    effect    = req->data[1];
    direction = req->data[2];
    speed     = req->data[3];

    rgb = Submodels_FindRgbSlot();
    if (rgb == NULL)
        return;

    if (effect == RGB_EFFECT_RIPPLE)
        Submodels_RGB_StartRipple(rgb, speed);
    else if (effect == RGB_EFFECT_WAVE && direction <= RGB_WAVE_DIR_B2T)
        Submodels_RGB_StartWave(rgb, direction, speed);
}

/* ============================================================================
 * Core 主动发送函数实现（Core -> Display 方向）
 * ============================================================================ */

void Display_SendInputEvent(display_t *display, uint8_t dev_type,
                            const uint8_t *report, uint8_t report_len)
{
    uint8_t buf[PROTO_MAX_FRAME_LEN];
    uint8_t data[1 + 8]; /* dev_type + max report (keyboard=8) */
    uint16_t frame_len;

    if (display == NULL || report == NULL || report_len == 0)
        return;
    if (report_len > 8)
        report_len = 8; /* 限制最大报告长度 */

    data[0] = dev_type;
    memcpy(&data[1], report, report_len);

    frame_len = Protocol_PackFrame(MODULE_ID_CORE, MODULE_ID_DISPLAY,
                                   CMD_DISP_INPUT_EVENT,
                                   data, 1 + report_len,
                                   buf, sizeof(buf));
    if (frame_len > 0)
        Display_Send_Data(display, buf, frame_len);
}

void Display_SendHidStatus(display_t *display, uint8_t dev_type, uint8_t connected)
{
    uint8_t buf[PROTO_MAX_FRAME_LEN];
    uint8_t data[3]; /* ext_code + evt + dev_type */
    uint16_t frame_len;

    if (display == NULL)
        return;

    data[0] = CMD_DISP_EXT_HID_STATUS;
    data[1] = connected ? HID_EVT_CONNECTED : HID_EVT_DISCONNECTED;
    data[2] = dev_type;

    frame_len = Protocol_PackFrame(MODULE_ID_CORE, MODULE_ID_DISPLAY,
                                   CMD_DISP_EXTENSION,
                                   data, 3,
                                   buf, sizeof(buf));
    if (frame_len > 0)
        Display_Send_Data(display, buf, frame_len);
}

void Display_SendMusicStatus(display_t *display)
{
    uint8_t buf[PROTO_MAX_FRAME_LEN];
    uint8_t data[11 + 64]; /* 状态(1)+时间(4)+时长(4)+音量(1)+外放(1)+曲目名(变长) */
    uint16_t frame_len;
    audio_state_t state;
    uint32_t play_time;
    const char *track_name;
    uint8_t track_len;
    uint8_t vol;

    if (display == NULL)
        return;

    /* MUSIC_STATUS 帧携带的是 ch0 的曲目/进度，状态同样报 ch0 通道状态，
     * 使音乐 UI 完全不受 ch1 短音效（SFX）状态迁移影响 */
    state = Audio_ChannelGetState(0);
    play_time = Audio_GetPlayTime_ms();
    track_name = Audio_GetCurrentTrackName();
    vol = Audio_GetVolume();

    /* 播放状态 */
    switch (state)
    {
        case AUDIO_STATE_IDLE:    data[0] = MUSIC_STATE_IDLE; break;
        case AUDIO_STATE_PLAYING: data[0] = MUSIC_STATE_PLAYING; break;
        case AUDIO_STATE_PAUSED:  data[0] = MUSIC_STATE_PAUSED; break;
        case AUDIO_STATE_STOPPED: data[0] = MUSIC_STATE_STOPPED; break;
        default:                  data[0] = MUSIC_STATE_IDLE; break;
    }

    /* 当前播放时间（大端） */
    data[1] = (play_time >> 24) & 0xFF;
    data[2] = (play_time >> 16) & 0xFF;
    data[3] = (play_time >> 8) & 0xFF;
    data[4] = play_time & 0xFF;

    /* 总时长（大端） */
    uint32_t duration = Audio_GetDuration_ms();
    data[5] = (duration >> 24) & 0xFF;
    data[6] = (duration >> 16) & 0xFF;
    data[7] = (duration >> 8) & 0xFF;
    data[8] = duration & 0xFF;

    /* 音量 */
    data[9] = vol;

    /* 外放状态（功放 SHUTDOWN 位掩码，非0=有通道正在外放） */
    data[10] = (uint8_t)Speaker_GetState();

    /* 曲目名称 */
    if (track_name != NULL)
    {
        track_len = (uint8_t)strlen(track_name);
        if (track_len > 63)
            track_len = 63;
        memcpy(&data[11], track_name, track_len);
    }
    else
    {
        track_len = 0;
    }

    frame_len = Protocol_PackFrame(MODULE_ID_CORE, MODULE_ID_DISPLAY,
                                   CMD_DISP_MUSIC_STATUS,
                                   data, 11 + track_len,
                                   buf, sizeof(buf));
    if (frame_len > 0)
        Display_Send_Data(display, buf, frame_len);
}

void Display_SendModuleStatus(display_t *display, uint8_t evt_type,
                              uint8_t module_id, uint8_t module_type,
                              uint8_t module_subtype)
{
    uint8_t buf[PROTO_MAX_FRAME_LEN];
    uint8_t data[5]; /* ext_code + evt_type + module_id + type + subtype */
    uint16_t frame_len;

    if (display == NULL)
        return;

    data[0] = CMD_DISP_EXT_MODULE_STATUS;
    data[1] = evt_type;
    data[2] = module_id;
    data[3] = module_type;
    data[4] = module_subtype;

    frame_len = Protocol_PackFrame(MODULE_ID_CORE, MODULE_ID_DISPLAY,
                                   CMD_DISP_EXTENSION,
                                   data, 5,
                                   buf, sizeof(buf));
    if (frame_len > 0)
        Display_Send_Data(display, buf, frame_len);
}

void Display_SendModuleList(display_t *display)
{
    uint8_t buf[PROTO_MAX_FRAME_LEN];
    uint8_t data[3 + 3 * 8]; /* ext_code + evt_type + count + max 8 modules */
    uint16_t frame_len;
    uint8_t count = 0;

    if (display == NULL)
        return;

    data[0] = CMD_DISP_EXT_MODULE_STATUS;
    data[1] = 0x02; /* 完整模块列表 */
    /* TODO: 填充实际模块列表 */
    data[2] = count;

    frame_len = Protocol_PackFrame(MODULE_ID_CORE, MODULE_ID_DISPLAY,
                                   CMD_DISP_EXTENSION,
                                   data, 3 + count * 3,
                                   buf, sizeof(buf));
    if (frame_len > 0)
        Display_Send_Data(display, buf, frame_len);
}

void Display_SendBtEvent(display_t *display, uint8_t evt_type,
                         const uint8_t *evt_data, uint8_t evt_data_len)
{
    uint8_t buf[PROTO_MAX_FRAME_LEN];
    uint8_t data[2 + 64]; /* ext_code + evt_type + evt_data */
    uint16_t frame_len;

    if (display == NULL)
        return;

    data[0] = CMD_DISP_EXT_BT_EVENT;
    data[1] = evt_type;

    if (evt_data != NULL && evt_data_len > 0)
    {
        if (evt_data_len > 64)
            evt_data_len = 64;
        memcpy(&data[2], evt_data, evt_data_len);
    }
    else
    {
        evt_data_len = 0;
    }

    frame_len = Protocol_PackFrame(MODULE_ID_CORE, MODULE_ID_DISPLAY,
                                   CMD_DISP_EXTENSION,
                                   data, 2 + evt_data_len,
                                   buf, sizeof(buf));
    if (frame_len > 0)
        Display_Send_Data(display, buf, frame_len);
}

void Display_SendSubmodelEvent(display_t *display, uint8_t sub_type,
                               uint8_t sub_cmd,
                               const uint8_t *evt_data, uint8_t evt_data_len)
{
    uint8_t buf[PROTO_MAX_FRAME_LEN];
    uint8_t data[3 + 64]; /* ext_code + sub_type + sub_cmd + evt_data */
    uint16_t frame_len;

    if (display == NULL)
        return;

    data[0] = CMD_DISP_EXT_SUBMODEL_EVENT;
    data[1] = sub_type;
    data[2] = sub_cmd;

    if (evt_data != NULL && evt_data_len > 0)
    {
        if (evt_data_len > 64)
            evt_data_len = 64;
        memcpy(&data[3], evt_data, evt_data_len);
    }
    else
    {
        evt_data_len = 0;
    }

    frame_len = Protocol_PackFrame(MODULE_ID_CORE, MODULE_ID_DISPLAY,
                                   CMD_DISP_EXTENSION,
                                   data, 3 + evt_data_len,
                                   buf, sizeof(buf));
    if (frame_len > 0)
        Display_Send_Data(display, buf, frame_len);
}

void Display_SendPowerEvent(display_t *display, uint8_t evt_type,
                            const uint8_t *evt_data, uint8_t evt_data_len)
{
    uint8_t buf[PROTO_MAX_FRAME_LEN];
    uint8_t data[2 + 16]; /* ext_code + evt_type + evt_data */
    uint16_t frame_len;

    if (display == NULL)
        return;

    data[0] = CMD_DISP_EXT_POWER_EVENT;
    data[1] = evt_type;

    if (evt_data != NULL && evt_data_len > 0)
    {
        if (evt_data_len > 16)
            evt_data_len = 16;
        memcpy(&data[2], evt_data, evt_data_len);
    }
    else
    {
        evt_data_len = 0;
    }

    frame_len = Protocol_PackFrame(MODULE_ID_CORE, MODULE_ID_DISPLAY,
                                   CMD_DISP_EXTENSION,
                                   data, 2 + evt_data_len,
                                   buf, sizeof(buf));
    if (frame_len > 0)
        Display_Send_Data(display, buf, frame_len);
}

void Display_SendConfigResult(display_t *display, uint8_t result,
                              uint8_t err_code,
                              const uint8_t *config_data, uint16_t config_len)
{
    uint8_t buf[PROTO_MAX_FRAME_LEN];
    uint8_t data[3 + 64]; /* ext_code + result + err_code + config_data */
    uint16_t frame_len;
    uint16_t payload_len;

    if (display == NULL)
        return;

    data[0] = CMD_DISP_EXT_CONFIG_RESULT;
    data[1] = result;
    data[2] = err_code;

    payload_len = config_len;
    if (payload_len > 64)
        payload_len = 64;

    if (config_data != NULL && payload_len > 0)
        memcpy(&data[3], config_data, payload_len);

    frame_len = Protocol_PackFrame(MODULE_ID_CORE, MODULE_ID_DISPLAY,
                                   CMD_DISP_EXTENSION,
                                   data, 3 + (uint8_t)payload_len,
                                   buf, sizeof(buf));
    if (frame_len > 0)
        Display_Send_Data(display, buf, frame_len);
}

void Display_SendUpdateStatus(display_t *display, const uint8_t *status_data,
                              uint8_t status_len)
{
    uint8_t buf[PROTO_MAX_FRAME_LEN];
    uint16_t frame_len;

    if (display == NULL || status_data == NULL || status_len == 0)
        return;

    frame_len = Protocol_PackFrame(MODULE_ID_CORE, MODULE_ID_DISPLAY,
                                   CMD_DISP_UPDATE_STATUS,
                                   status_data, status_len,
                                   buf, sizeof(buf));
    if (frame_len > 0)
        Display_Send_Data(display, buf, frame_len);
}

void Display_SendScreenControl(display_t *display, uint8_t ctrl_type,
                               uint8_t param)
{
    uint8_t buf[PROTO_MAX_FRAME_LEN];
    uint8_t data[2]; /* ctrl_type + param */
    uint16_t frame_len;

    if (display == NULL)
        return;

    data[0] = ctrl_type;
    data[1] = param;

    frame_len = Protocol_PackFrame(MODULE_ID_CORE, MODULE_ID_DISPLAY,
                                   CMD_DISP_SCREEN_CONTROL,
                                   data, (ctrl_type == SCREEN_CTRL_SET_TIMEOUT) ? 2 : 1,
                                   buf, sizeof(buf));
    if (frame_len > 0)
        Display_Send_Data(display, buf, frame_len);
}

void Display_SendNotice(display_t *display, uint8_t priority,
                        const char *title, const char *content)
{
    uint8_t buf[PROTO_MAX_FRAME_LEN];
    uint8_t data[1 + 16 + 128]; /* priority + title(16) + content */
    uint16_t frame_len;
    uint8_t content_len;

    if (display == NULL)
        return;

    data[0] = priority;

    /* 标题固定 16 字节 */
    memset(&data[1], 0, 16);
    if (title != NULL)
    {
        uint8_t tlen = (uint8_t)strlen(title);
        if (tlen > 16) tlen = 16;
        memcpy(&data[1], title, tlen);
    }

    /* 内容变长 */
    content_len = 0;
    if (content != NULL)
    {
        content_len = (uint8_t)strlen(content);
        if (content_len > 128)
            content_len = 128;
        memcpy(&data[17], content, content_len);
    }

    frame_len = Protocol_PackFrame(MODULE_ID_CORE, MODULE_ID_DISPLAY,
                                   CMD_DISP_SHOW_NOTICE,
                                   data, 17 + content_len,
                                   buf, sizeof(buf));
    if (frame_len > 0)
        Display_Send_Data(display, buf, frame_len);
}

void Display_SendSubdispContent(display_t *display, uint8_t content_type,
                                const uint8_t *content, uint16_t content_len)
{
    uint8_t buf[PROTO_MAX_FRAME_LEN];
    uint8_t data[2 + 64]; /* ext_code + content_type + content */
    uint16_t frame_len;
    uint16_t payload_len;

    if (display == NULL)
        return;

    data[0] = CMD_DISP_EXT_SUBDISP_CONTENT;
    data[1] = content_type;

    payload_len = content_len;
    if (payload_len > 64)
        payload_len = 64;

    if (content != NULL && payload_len > 0)
        memcpy(&data[2], content, payload_len);

    frame_len = Protocol_PackFrame(MODULE_ID_CORE, MODULE_ID_DISPLAY,
                                   CMD_DISP_EXTENSION,
                                   data, 2 + (uint8_t)payload_len,
                                   buf, sizeof(buf));
    if (frame_len > 0)
        Display_Send_Data(display, buf, frame_len);
}

void Display_SendCLIResponse(display_t *display, const char *output, uint16_t output_len)
{
    /* Backward-compatible wrapper: single frame with SOF+EOF */
    Display_SendCLIResponseEx(display, output, output_len, CLI_FLAG_SOF | CLI_FLAG_EOF);
}

void Display_SendCLIResponseEx(display_t *display, const char *output, uint16_t output_len, uint8_t flags)
{
    uint8_t buf[PROTO_MAX_FRAME_LEN];
    uint8_t data[1 + 1 + 248]; /* ext_code + flags + output */
    uint16_t frame_len;
    uint16_t payload_len;

    if (display == NULL || output == NULL)
        return;

    data[0] = CMD_DISP_EXT_CLI;
    data[1] = flags;

    payload_len = output_len;
    if (payload_len > 248)
        payload_len = 248;

    if (payload_len > 0)
        memcpy(&data[2], output, payload_len);

    frame_len = Protocol_PackFrame(MODULE_ID_CORE, MODULE_ID_DISPLAY,
                                   CMD_DISP_EXTENSION,
                                   data, 2 + (uint8_t)payload_len,
                                   buf, sizeof(buf));
    if (frame_len > 0)
        Display_Send_Data(display, buf, frame_len);
}

void Display_SendCWDNotify(display_t *display, const char *path)
{
    uint8_t buf[PROTO_MAX_FRAME_LEN];
    uint8_t data[1 + 64]; /* ext_code + path */
    uint16_t frame_len;
    uint8_t path_len;

    if (display == NULL || path == NULL)
        return;

    data[0] = CMD_DISP_EXT_CWD_NOTIFY;
    path_len = (uint8_t)strlen(path);
    if (path_len > 63)
        path_len = 63;
    memcpy(&data[1], path, path_len);

    frame_len = Protocol_PackFrame(MODULE_ID_CORE, MODULE_ID_DISPLAY,
                                   CMD_DISP_EXTENSION,
                                   data, 1 + path_len,
                                   buf, sizeof(buf));
    if (frame_len > 0)
        Display_Send_Data(display, buf, frame_len);
}
