sratle/WCH-Model-Terminal/display-model/display-1/Common/Common/Apps/app_file.c

/********************************** (C) COPYRIGHT *******************************
* File Name          : app_file.c
* Author             : LCD Model Team
* Version            : V4.0.0
* Date               : 2026/05/25
* Description        : File Manager app (V4.0 full-featured).
*                      Browse directories, open music/text files via CLI.
*                      Keyboard + mouse + touch navigation.
*                      Context menu (rename, copy, stat, delete).
*                      Breadcrumb path bar, new file/folder creation.
*                      All file I/O routed through UART_SendCLI.
********************************************************************************/
#include "app_file.h"
#include "app_music.h"
#include "app_editor.h"
#include "../UI/ui_app_common.h"
#include "../UART/uart_module.h"
#include "../MiniUI/miniui_page.h"
#include "../MiniUI/miniui_anim.h"
#include "debug.h"
#include <string.h>
#include <stdio.h>

/*=============================================================================
 *  Layout Configuration (800x480)
 *=============================================================================*/

#define FILE_TOOLBAR_H      40
#define FILE_TOOLBAR_Y      APP_TITLE_BAR_H
#define FILE_BREADCRUMB_H   28
#define FILE_BREADCRUMB_Y   (FILE_TOOLBAR_Y + FILE_TOOLBAR_H)
#define FILE_LIST_Y         (FILE_BREADCRUMB_Y + FILE_BREADCRUMB_H)
#define FILE_LIST_H         (UI_SCREEN_HEIGHT - FILE_LIST_Y)
#define FILE_ITEM_H         52
#define FILE_VISIBLE_ITEMS  (FILE_LIST_H / FILE_ITEM_H)
#define FILE_MAX_ENTRIES    FILE_LIST_MAX_ENTRIES
#define FILE_PATH_MAX       64
#define TB_BTN_W            56
#define TB_BTN_H            28
#define TB_BTN_Y            (FILE_TOOLBAR_Y + 6)

/* Context menu */
#define CTX_MENU_W          200
#define CTX_MENU_ITEM_H     40
#define CTX_MENU_MAX_ITEMS  5

/* Input dialog */
#define INPUT_DLG_W         360
#define INPUT_DLG_H         140

/*=============================================================================
 *  Colors
 *=============================================================================*/

#define FILE_BG             UI_COLOR_BG_MAIN
#define FILE_ITEM_BG        UI_COLOR_BG_CARD
#define FILE_ITEM_SEL       UI_HEX(0xE0F2F1)
#define FILE_ITEM_ALT       UI_HEX(0xFAFAFA)
#define FILE_DIR_COLOR      UI_HEX(0xFFA726)
#define FILE_FILE_COLOR     UI_HEX(0x42A5F5)
#define FILE_WAV_COLOR      UI_HEX(0xAB47BC)
#define FILE_TXT_COLOR      UI_HEX(0x5C6BC0)
#define FILE_IMG_COLOR      UI_HEX(0x66BB6A)
#define FILE_SIZE_COLOR     UI_COLOR_TEXT_SECONDARY
#define FILE_BORDER         UI_HEX(0xE0E0E0)
#define FILE_BREADCRUMB_BG  UI_HEX(0xF0F0F0)
#define FILE_BREADCRUMB_TXT UI_HEX(0x616161)
#define FILE_BREADCRUMB_SEP UI_HEX(0xBDBDBD)
#define CTX_MENU_BG         UI_COLOR_BG_CARD
#define CTX_MENU_BORDER     UI_HEX(0xE0E0E0)
#define CTX_MENU_SEL        UI_HEX(0xE8F5E9)
#define CTX_MENU_DANGER     UI_COLOR_DANGER
#define INPUT_DLG_BG        UI_COLOR_BG_CARD
#define INPUT_DLG_BORDER    UI_HEX(0xBDBDBD)

/*=============================================================================
 *  Context Menu State
 *=============================================================================*/

typedef enum {
    CTX_NONE = 0,
    CTX_RENAME,
    CTX_COPY,
    CTX_STAT,
    CTX_DELETE,
} ctx_action_t;

typedef struct {
    bool visible;
    int16_t x, y;
    int16_t selected;
    ctx_action_t actions[CTX_MENU_MAX_ITEMS];
    const char *labels[CTX_MENU_MAX_ITEMS];
    uint8_t count;
    int16_t target_idx;     /* Which file entry the context menu acts on */
} ctx_menu_t;

/*=============================================================================
 *  Input Dialog State
 *=============================================================================*/

typedef enum {
    INPUT_NONE = 0,
    INPUT_NEW_FOLDER,
    INPUT_NEW_FILE,
    INPUT_RENAME,
    INPUT_COPY,
} input_dlg_type_t;

typedef struct {
    bool visible;
    input_dlg_type_t type;
    char buffer[FILE_NAME_MAX_LEN + 1];
    uint8_t buf_len;
    char title[32];
    char hint[32];
    int16_t cursor_pos;     /* Cursor position in buffer */
} input_dlg_t;

/*=============================================================================
 *  Auth Dialog State (私密文件夹认证)
 *=============================================================================*/

#define AUTH_DLG_W          620
#define AUTH_DLG_H          300
#define AUTH_LEFT_W         380
#define AUTH_PAD_X          400
#define AUTH_PAD_Y          16
#define AUTH_PAD_W          (AUTH_DLG_W - AUTH_PAD_X - 16)
#define AUTH_PAD_H          (AUTH_DLG_H - 32)
#define AUTH_MAX_USERS      8
#define AUTH_PIN_MAX        8

typedef struct {
    bool visible;
    char pending_dir[FILE_NAME_MAX_LEN + 1]; /* 待重试进入的目录名 */
    char pin[AUTH_PIN_MAX + 1];
    uint8_t pin_len;
    char users[AUTH_MAX_USERS][17];          /* 来自 user ls */
    uint8_t user_count;
    int8_t  user_sel;
    char message[48];
    bool fetching_users;
} auth_dlg_t;

/*=============================================================================
 *  File Manager State
 *=============================================================================*/

typedef struct {
    char path[FILE_PATH_MAX];       /* Real path from Core (via ls header / CWD_NOTIFY) */
    file_entry_t entries[FILE_MAX_ENTRIES];
    int16_t count;
    int16_t selected;
    int16_t scroll_offset;          /* Scroll goal (items); animated px pos in s_list_scroller */
    bool loading;
    bool data_ready;
    uint8_t last_status;
    uint8_t current_device;         /* 0=SD, 1=USB */
    ctx_menu_t ctx;
    input_dlg_t input;
    char stat_text[256];            /* Result of stat command */
    bool stat_visible;
} file_state_t;

/*=============================================================================
 *  Static Data
 *=============================================================================*/

static ui_app_page_t s_app_file;
static ui_widget_t s_list_touch;
static ui_button_t btn_up, btn_new_folder, btn_new_file, btn_delete, btn_refresh, btn_device;
static ui_widget_t *s_file_widgets[10];
static file_state_t s_fs;
static auth_dlg_t s_auth;
static ui_pinpad_t s_auth_pinpad;
static char s_pending_enter[FILE_NAME_MAX_LEN + 1]; /* 最近尝试进入的目录（cd 被拦截时重试用） */
static bool s_pending_enter_valid;
static char s_status_text[80];
static char s_path_display[FILE_PATH_MAX + 16];

/* Smooth (animated, pixel-level) list scrolling */
static ui_scroller_t s_list_scroller;

/* Double-click detection */
static uint32_t s_last_click_ms = 0;
#define DOUBLE_CLICK_MS  400

/*=============================================================================
 *  Forward Declarations
 *=============================================================================*/

static void file_request_list(void);
static void file_sort_entries(void);
static void file_update_status(void);
static void file_draw_list(void);
static void file_draw_toolbar(void);
static void file_draw_breadcrumb(void);
static void file_draw_context_menu(void);
static void file_draw_input_dialog(void);
static void file_draw_stat_dialog(void);
static void file_enter_path(const char *name);
static void file_go_up(void);
static void file_go_root(void);
static void file_switch_device(void);
static void file_show_context_menu(int16_t x, int16_t y, int16_t item_idx);
static void file_hide_context_menu(void);
static void file_show_input_dialog(input_dlg_type_t type, const char *title, const char *hint);
static void file_hide_input_dialog(void);
static void file_input_dialog_confirm(void);
static void file_ctx_menu_execute(void);
static void file_show_auth_dialog(void);
static void file_hide_auth_dialog(void);
static void file_auth_confirm(void);
static void file_auth_retry(void);
static void file_auth_parse_users(const char *buf, uint16_t len);
static void file_draw_auth_dialog(void);
static void file_invalidate_auth_dialog(void);

/*=============================================================================
 *  Dirty Region Helpers
 *=============================================================================*/

/* Invalidate the file list area (toolbar + breadcrumb + list) */
static void file_invalidate_content(void)
{
    ui_rect_t r = {0, FILE_TOOLBAR_Y, UI_SCREEN_WIDTH, UI_SCREEN_HEIGHT - FILE_TOOLBAR_Y};
    ui_page_invalidate(&r);
}

/* Invalidate just the scrollable list viewport (used per animation frame) */
static void file_invalidate_list(void)
{
    ui_rect_t r = {0, FILE_LIST_Y, UI_SCREEN_WIDTH, FILE_LIST_H};
    ui_page_invalidate(&r);
}

/* Scroller position update: redraw the list at the new pixel offset */
static void file_scroll_moved(int32_t value, void *user_data)
{
    (void)value; (void)user_data;
    file_invalidate_list();
}

/* Set list scroll (in items), clamped; animates the pixel position */
static void file_scroll_set(int16_t items, bool animate)
{
    int16_t max_items = s_fs.count - FILE_VISIBLE_ITEMS;
    if (max_items < 0) max_items = 0;
    if (items > max_items) items = max_items;
    if (items < 0) items = 0;
    s_fs.scroll_offset = items;
    if (animate) {
        ui_scroller_set_goal(&s_list_scroller, (int32_t)items * FILE_ITEM_H);
    } else {
        ui_scroller_jump(&s_list_scroller, (int32_t)items * FILE_ITEM_H);
    }
}

/* Invalidate a single list item row */
static void file_invalidate_item(int16_t idx)
{
    int32_t pos = s_list_scroller.pos;
    int16_t y = FILE_LIST_Y + idx * FILE_ITEM_H - (int16_t)pos;
    if (y + FILE_ITEM_H <= FILE_LIST_Y || y >= FILE_LIST_Y + FILE_LIST_H) return;
    ui_rect_t r = {0, y, UI_SCREEN_WIDTH, FILE_ITEM_H};
    ui_page_invalidate(&r);
}

/* Invalidate the breadcrumb bar */
static void file_invalidate_breadcrumb(void)
{
    ui_rect_t r = {0, FILE_BREADCRUMB_Y, UI_SCREEN_WIDTH, FILE_BREADCRUMB_H};
    ui_page_invalidate(&r);
}

/* Invalidate the scroll indicator region */
static void file_invalidate_scrollbar(void)
{
    ui_rect_t r = {UI_SCREEN_WIDTH - 8, FILE_LIST_Y, 8, FILE_LIST_H};
    ui_page_invalidate(&r);
}

/* Invalidate the context menu region */
static void file_invalidate_ctx_menu(void)
{
    ctx_menu_t *ctx = &s_fs.ctx;
    if (!ctx->visible) return;
    int16_t menu_h = ctx->count * CTX_MENU_ITEM_H;
    ui_rect_t r = {ctx->x - 2, ctx->y - 2, CTX_MENU_W + 7, menu_h + 7};
    ui_page_invalidate(&r);
}

/* Invalidate the input dialog region */
static void file_invalidate_input_dialog(void)
{
    /* Dialog draws a full-screen dim overlay, so we must invalidate the
     * entire content area (not just the dialog box) to clear the overlay. */
    ui_rect_t r = {0, APP_TITLE_BAR_H, UI_SCREEN_WIDTH, UI_SCREEN_HEIGHT - APP_TITLE_BAR_H};
    ui_page_invalidate(&r);
}

/* Invalidate the stat dialog region */
static void file_invalidate_stat_dialog(void)
{
    /* Dialog draws a full-screen dim overlay, so we must invalidate the
     * entire content area (not just the dialog box) to clear the overlay. */
    ui_rect_t r = {0, APP_TITLE_BAR_H, UI_SCREEN_WIDTH, UI_SCREEN_HEIGHT - APP_TITLE_BAR_H};
    ui_page_invalidate(&r);
}

/* Invalidate old and new selected items (for selection change) */
static void file_invalidate_selection_change(int16_t old_sel, int16_t new_sel)
{
    if (old_sel >= 0) file_invalidate_item(old_sel);
    if (new_sel >= 0) file_invalidate_item(new_sel);
    file_invalidate_scrollbar();
}

/*=============================================================================
 *  Helpers
 *=============================================================================*/

static bool file_is_wav(const char *name)
{
    int len = strlen(name);
    if (len < 5) return false;
    const char *ext = name + len - 4;
    return (ext[0] == '.' &&
            (ext[1] == 'w' || ext[1] == 'W') &&
            (ext[2] == 'a' || ext[2] == 'A') &&
            (ext[3] == 'v' || ext[3] == 'V'));
}

static bool file_is_text(const char *name)
{
    const char *dot = strrchr(name, '.');
    if (!dot) return false;
    if (strlen(dot) < 2) return false;

    char ext[8];
    int elen = 0;
    dot++;
    while (*dot && elen < (int)sizeof(ext) - 1) {
        ext[elen++] = (*dot >= 'A' && *dot <= 'Z') ? (*dot + 32) : *dot;
        dot++;
    }
    ext[elen] = '\0';

    static const char *text_exts[] = {
        "txt", "json", "xml", "csv", "log", "md",
        "ini", "cfg", "conf", "dat",
        "c", "h", "cpp", "hpp", "py", "lua", "js",
        "html", "htm", "css",
        NULL
    };
    for (int i = 0; text_exts[i] != NULL; i++) {
        if (strcmp(ext, text_exts[i]) == 0) return true;
    }
    return false;
}

static bool file_is_image(const char *name)
{
    const char *dot = strrchr(name, '.');
    if (!dot) return false;
    char ext[8];
    int elen = 0;
    dot++;
    while (*dot && elen < (int)sizeof(ext) - 1) {
        ext[elen++] = (*dot >= 'A' && *dot <= 'Z') ? (*dot + 32) : *dot;
        dot++;
    }
    ext[elen] = '\0';
    return (strcmp(ext, "bmp") == 0 || strcmp(ext, "png") == 0 ||
            strcmp(ext, "jpg") == 0 || strcmp(ext, "jpeg") == 0);
}

static ui_color_t file_icon_color(const file_entry_t *e)
{
    if (e->attr & FILE_ATTR_IS_DIR) return FILE_DIR_COLOR;
    if (file_is_wav(e->name)) return FILE_WAV_COLOR;
    if (file_is_text(e->name)) return FILE_TXT_COLOR;
    if (file_is_image(e->name)) return FILE_IMG_COLOR;
    return FILE_FILE_COLOR;
}

static const char *file_icon_text(const file_entry_t *e)
{
    if (e->attr & FILE_ATTR_IS_DIR) return "D";
    if (file_is_wav(e->name)) return "~";
    if (file_is_text(e->name)) return "#";
    if (file_is_image(e->name)) return "I";
    return "F";
}

static void file_format_size(uint32_t size, char *buf, int buf_len)
{
    if (size < 1024)
        snprintf(buf, buf_len, "%u B", (unsigned)size);
    else if (size < 1024 * 1024)
        snprintf(buf, buf_len, "%u.%u KB", (unsigned)(size / 1024),
                 (unsigned)((size % 1024) * 10 / 1024));
    else
        snprintf(buf, buf_len, "%u.%u MB", (unsigned)(size / (1024 * 1024)),
                 (unsigned)(((size / 1024) % 1024) * 10 / 1024));
}

static int file_cmp_name(const char *a, const char *b)
{
    while (*a && *b) {
        char ca = *a, cb = *b;
        if (ca >= 'A' && ca <= 'Z') ca += 32;
        if (cb >= 'A' && cb <= 'Z') cb += 32;
        if (ca != cb) return ca - cb;
        a++; b++;
    }
    return *a - *b;
}

static void file_sort_entries(void)
{
    for (int i = 0; i < s_fs.count - 1; i++) {
        for (int j = i + 1; j < s_fs.count; j++) {
            bool di = (s_fs.entries[i].attr & FILE_ATTR_IS_DIR) != 0;
            bool dj = (s_fs.entries[j].attr & FILE_ATTR_IS_DIR) != 0;
            bool swap = false;
            if (di != dj) swap = dj;
            else if (file_cmp_name(s_fs.entries[i].name, s_fs.entries[j].name) > 0) swap = true;
            if (swap) {
                file_entry_t tmp = s_fs.entries[i];
                s_fs.entries[i] = s_fs.entries[j];
                s_fs.entries[j] = tmp;
            }
        }
    }
}

/* Ensure selected item is visible in the scroll viewport */
static void file_ensure_selected_visible(void)
{
    if (s_fs.selected < 0) return;
    if (s_fs.selected < s_fs.scroll_offset)
        file_scroll_set(s_fs.selected, true);
    else if (s_fs.selected >= s_fs.scroll_offset + FILE_VISIBLE_ITEMS)
        file_scroll_set(s_fs.selected - FILE_VISIBLE_ITEMS + 1, true);
}

/*=============================================================================
 *  Protocol Callbacks
 *=============================================================================*/

static void on_file_list_received(uint8_t status, const file_entry_t *entries, uint8_t count)
{
    printf("[FILE] list: status=%d count=%d\r\n", status, count);
    s_fs.loading = false;
    s_fs.data_ready = true;
    s_fs.last_status = status;
    if (status == 0x00) {
        s_fs.count = (count > FILE_MAX_ENTRIES) ? FILE_MAX_ENTRIES : count;
        memcpy(s_fs.entries, entries, s_fs.count * sizeof(file_entry_t));
        file_sort_entries();
        s_pending_enter_valid = false;  /* 成功进入目录，清除拦截重试记录 */
    } else {
        s_fs.count = 0;
    }
    s_fs.selected = -1;
    file_scroll_set(0, false);
    file_update_status();
    file_invalidate_content();
}

static void on_cwd_changed(const char *path)
{
    strncpy(s_fs.path, path, FILE_PATH_MAX - 1);
    s_fs.path[FILE_PATH_MAX - 1] = '\0';
    file_update_status();
    file_invalidate_breadcrumb();
}

static void file_on_cli_complete(const char *buf, uint16_t len, const char *tag);

static uart_cli_cb_t s_file_cb = {
    .on_file_list = on_file_list_received,
    .on_cli_complete = file_on_cli_complete,
    .on_cwd_notify = on_cwd_changed,
};

static void file_on_cli_complete(const char *buf, uint16_t len, const char *tag)
{
    printf("[FILE] complete: tag='%s' len=%d\r\n", tag ? tag : "(null)", len);
    if (!tag) return;

    /* 私密文件夹拦截：弹出认证对话框（标记固定为响应首行，防止文件内容误判） */
    if (strncmp(buf, "AUTH_REQUIRED", 13) == 0) {
        if (!s_auth.visible)
            file_show_auth_dialog();
        return;
    }

    /* 认证对话框开启期间的用户列表/登录响应 */
    if (s_auth.visible) {
        if (s_auth.fetching_users && strcmp(tag, "user") == 0) {
            file_auth_parse_users(buf, len);
            return;
        }
        if (strcmp(tag, "login") == 0) {
            if (strstr(buf, "Login OK") != NULL) {
                file_auth_retry();
            } else {
                s_auth.pin_len = 0;
                s_auth.pin[0] = '\0';
                snprintf(s_auth.message, sizeof(s_auth.message),
                         "Wrong PIN or user");
                file_invalidate_auth_dialog();
            }
            return;
        }
    }

    /* Handle stat response */
    if (strcmp(tag, "stat") == 0 && s_fs.stat_visible) {
        uint16_t copy = len;
        if (copy > sizeof(s_fs.stat_text) - 1) copy = sizeof(s_fs.stat_text) - 1;
        memcpy(s_fs.stat_text, buf, copy);
        s_fs.stat_text[copy] = '\0';
        file_invalidate_stat_dialog();
        return;
    }

    /* After file operations (mkdir/rm/copy/rename/device switch), refresh */
    s_fs.loading = true;
    s_fs.data_ready = false;
    UART_RequestFileList(NULL);
    file_invalidate_content();
}

/*=============================================================================
 *  File Operations
 *=============================================================================*/

static void file_request_list(void)
{
    s_pending_enter_valid = false;
    s_fs.loading = true;
    s_fs.data_ready = false;
    UART_SetCLICallbacks(&s_file_cb);
    UART_RequestFileList(NULL);
    file_update_status();
    file_invalidate_content();
}

static void file_enter_path(const char *name)
{
    /* 记录尝试进入的目录：若被私密文件夹拦截，认证后重试 */
    strncpy(s_pending_enter, name, sizeof(s_pending_enter) - 1);
    s_pending_enter[sizeof(s_pending_enter) - 1] = '\0';
    s_pending_enter_valid = true;

    s_fs.loading = true;
    s_fs.data_ready = false;
    UART_SetCLICallbacks(&s_file_cb);
    UART_RequestFileList(name);
    file_update_status();
    file_invalidate_content();
}

static void file_go_up(void)
{
    s_pending_enter_valid = false;
    s_fs.loading = true;
    s_fs.data_ready = false;
    UART_SetCLICallbacks(&s_file_cb);
    UART_RequestFileList("..");
    file_update_status();
    file_invalidate_content();
}

static void file_go_root(void)
{
    s_pending_enter_valid = false;
    s_fs.loading = true;
    s_fs.data_ready = false;
    UART_SetCLICallbacks(&s_file_cb);
    UART_RequestFileList("\\");
    file_update_status();
    file_invalidate_content();
}

static void file_switch_device(void)
{
    s_fs.current_device = !s_fs.current_device;
    const char *dev_cmd = s_fs.current_device ? "device usb" : "device sd";

    s_fs.loading = true;
    s_fs.data_ready = false;
    s_fs.path[0] = '\0';
    UART_SetCLICallbacks(&s_file_cb);
    UART_SendCLI(dev_cmd);
    file_update_status();
    file_invalidate_content();
}

static void file_delete_selected(void)
{
    if (s_fs.selected < 0 || s_fs.selected >= s_fs.count) return;
    file_entry_t *e = &s_fs.entries[s_fs.selected];
    s_fs.loading = true;
    UART_SetCLICallbacks(&s_file_cb);
    if (e->attr & FILE_ATTR_IS_DIR)
        UART_SendFileOperation(FILE_OP_DELETE_DIR, e->name);
    else
        UART_SendFileOperation(FILE_OP_DELETE_FILE, e->name);
    file_update_status();
    file_invalidate_content();
}

static void file_create_folder(void)
{
    file_show_input_dialog(INPUT_NEW_FOLDER, "New Folder", "Folder name");
}

static void file_create_file(void)
{
    file_show_input_dialog(INPUT_NEW_FILE, "New File", "File name");
}

static void file_open_selected(void)
{
    if (s_fs.selected < 0 || s_fs.selected >= s_fs.count) return;
    file_entry_t *e = &s_fs.entries[s_fs.selected];
    if (e->attr & FILE_ATTR_IS_DIR) { file_enter_path(e->name); return; }

    if (file_is_wav(e->name)) {
        const char *wav_names[FILE_MAX_ENTRIES];
        int16_t wav_count = 0;
        int16_t wav_index = -1;
        for (int16_t i = 0; i < s_fs.count; i++) {
            if (file_is_wav(s_fs.entries[i].name)) {
                wav_names[wav_count] = s_fs.entries[i].name;
                if (i == s_fs.selected) wav_index = wav_count;
                wav_count++;
            }
        }
        app_music_set_playlist(wav_names, wav_count, wav_index);
        UART_SendPlayMusic(e->name);
        ui_page_push(app_music_get_page());
    } else if (file_is_text(e->name)) {
        app_editor_open_file(e->name, e->name);
        ui_page_push(app_editor_get_page());
    }
    /* Image files: not yet supported for opening */
}

static void file_update_status(void)
{
    if (s_fs.loading)
        snprintf(s_status_text, sizeof(s_status_text), "Loading...");
    else if (!s_fs.data_ready)
        snprintf(s_status_text, sizeof(s_status_text), "Ready");
    else if (s_fs.last_status != 0)
        snprintf(s_status_text, sizeof(s_status_text), "Error %d", s_fs.last_status);
    else
        snprintf(s_status_text, sizeof(s_status_text), "%d items", s_fs.count);

    const char *dev_name = s_fs.current_device ? "USB" : "SD";
    if (s_fs.path[0] == '\0')
        snprintf(s_path_display, sizeof(s_path_display), "[%s] \\", dev_name);
    else
        snprintf(s_path_display, sizeof(s_path_display), "[%s] %s", dev_name, s_fs.path);

    btn_device.text = s_fs.current_device ? "USB" : "SD";
    btn_device.base.flags |= UI_WIDGET_FLAG_DIRTY;
}

/*=============================================================================
 *  Context Menu
 *=============================================================================*/

static void file_show_context_menu(int16_t x, int16_t y, int16_t item_idx)
{
    if (item_idx < 0 || item_idx >= s_fs.count) return;

    ctx_menu_t *ctx = &s_fs.ctx;
    ctx->visible = true;
    ctx->selected = -1;
    ctx->target_idx = item_idx;
    ctx->count = 0;

    /* Always show stat */
    ctx->actions[ctx->count] = CTX_STAT;
    ctx->labels[ctx->count] = "Properties";
    ctx->count++;

    /* Copy */
    ctx->actions[ctx->count] = CTX_COPY;
    ctx->labels[ctx->count] = "Copy";
    ctx->count++;

    /* Rename (only for files, CH378 mv limitation) */
    file_entry_t *e = &s_fs.entries[item_idx];
    if (!(e->attr & FILE_ATTR_IS_DIR)) {
        ctx->actions[ctx->count] = CTX_RENAME;
        ctx->labels[ctx->count] = "Rename";
        ctx->count++;
    }

    /* Delete */
    ctx->actions[ctx->count] = CTX_DELETE;
    ctx->labels[ctx->count] = "Delete";
    ctx->count++;

    /* Position: ensure menu stays on screen */
    int16_t menu_h = ctx->count * CTX_MENU_ITEM_H;
    ctx->x = x;
    ctx->y = y;
    if (ctx->x + CTX_MENU_W > UI_SCREEN_WIDTH) ctx->x = UI_SCREEN_WIDTH - CTX_MENU_W;
    if (ctx->y + menu_h > UI_SCREEN_HEIGHT) ctx->y = UI_SCREEN_HEIGHT - menu_h;
    if (ctx->x < 0) ctx->x = 0;
    if (ctx->y < FILE_LIST_Y) ctx->y = FILE_LIST_Y;

    file_invalidate_ctx_menu();
}

static void file_hide_context_menu(void)
{
    /* Invalidate menu area before hiding to restore underlying content */
    ctx_menu_t *ctx = &s_fs.ctx;
    if (ctx->visible) {
        int16_t menu_h = ctx->count * CTX_MENU_ITEM_H;
        ui_rect_t r = {ctx->x - 2, ctx->y - 2, CTX_MENU_W + 7, menu_h + 7};
        ui_page_invalidate(&r);
    }
    s_fs.ctx.visible = false;
}

static void file_ctx_menu_execute(void)
{
    ctx_menu_t *ctx = &s_fs.ctx;
    if (ctx->selected < 0 || ctx->selected >= ctx->count) return;
    if (ctx->target_idx < 0 || ctx->target_idx >= s_fs.count) return;

    ctx_action_t action = ctx->actions[ctx->selected];
    file_entry_t *e = &s_fs.entries[ctx->target_idx];

    file_hide_context_menu();

    switch (action) {
    case CTX_STAT: {
        /* Send stat command */
        s_fs.stat_visible = true;
        s_fs.stat_text[0] = '\0';
        UART_SetCLICallbacks(&s_file_cb);
        char cmd[128];
        snprintf(cmd, sizeof(cmd), "stat \"%s\"", e->name);
        UART_SendCLI(cmd);
        file_invalidate_stat_dialog();
        break;
    }
    case CTX_COPY:
        file_show_input_dialog(INPUT_COPY, "Copy", "New name");
        break;
    case CTX_RENAME:
        file_show_input_dialog(INPUT_RENAME, "Rename", "New name");
        break;
    case CTX_DELETE:
        file_delete_selected();
        break;
    default:
        break;
    }
}

/*=============================================================================
 *  Input Dialog
 *=============================================================================*/

static void file_show_input_dialog(input_dlg_type_t type, const char *title, const char *hint)
{
    input_dlg_t *dlg = &s_fs.input;
    dlg->visible = true;
    dlg->type = type;
    dlg->buf_len = 0;
    dlg->buffer[0] = '\0';
    dlg->cursor_pos = 0;
    strncpy(dlg->title, title, sizeof(dlg->title) - 1);
    dlg->title[sizeof(dlg->title) - 1] = '\0';
    strncpy(dlg->hint, hint, sizeof(dlg->hint) - 1);
    dlg->hint[sizeof(dlg->hint) - 1] = '\0';

    /* Pre-fill rename/copy with original name */
    if ((type == INPUT_RENAME || type == INPUT_COPY) &&
        s_fs.ctx.target_idx >= 0 && s_fs.ctx.target_idx < s_fs.count) {
        const char *orig = s_fs.entries[s_fs.ctx.target_idx].name;
        uint8_t olen = strlen(orig);
        if (olen > FILE_NAME_MAX_LEN) olen = FILE_NAME_MAX_LEN;
        memcpy(dlg->buffer, orig, olen);
        dlg->buffer[olen] = '\0';
        dlg->buf_len = olen;
        dlg->cursor_pos = olen;
    }

    file_invalidate_input_dialog();
}

static void file_hide_input_dialog(void)
{
    s_fs.input.visible = false;
    file_invalidate_input_dialog();
}

static void file_input_dialog_confirm(void)
{
    input_dlg_t *dlg = &s_fs.input;
    if (dlg->buf_len == 0) {
        file_hide_input_dialog();
        return;
    }

    UART_SetCLICallbacks(&s_file_cb);
    char cmd[256];

    switch (dlg->type) {
    case INPUT_NEW_FOLDER:
        snprintf(cmd, sizeof(cmd), "mkdir \"%s\"", dlg->buffer);
        UART_SendCLI(cmd);
        break;
    case INPUT_NEW_FILE:
        snprintf(cmd, sizeof(cmd), "touch \"%s\"", dlg->buffer);
        UART_SendCLI(cmd);
        break;
    case INPUT_RENAME:
        if (s_fs.ctx.target_idx >= 0 && s_fs.ctx.target_idx < s_fs.count) {
            const char *old_name = s_fs.entries[s_fs.ctx.target_idx].name;
            snprintf(cmd, sizeof(cmd), "mv \"%s\" \"%s\"", old_name, dlg->buffer);
            UART_SendCLI(cmd);
        }
        break;
    case INPUT_COPY:
        if (s_fs.ctx.target_idx >= 0 && s_fs.ctx.target_idx < s_fs.count) {
            const char *src_name = s_fs.entries[s_fs.ctx.target_idx].name;
            snprintf(cmd, sizeof(cmd), "cp \"%s\" \"%s\"", src_name, dlg->buffer);
            UART_SendCLI(cmd);
        }
        break;
    default:
        break;
    }

    file_hide_input_dialog();
}

/*=============================================================================
 *  Auth Dialog (私密文件夹认证：PIN / 指纹 / NFC)
 *=============================================================================*/

static void file_invalidate_auth_dialog(void)
{
    ui_page_invalidate_all();
}

static void file_show_auth_dialog(void)
{
    memset(&s_auth, 0, sizeof(s_auth));
    s_auth.visible = true;
    s_auth.user_sel = -1;
    if (s_pending_enter_valid) {
        strncpy(s_auth.pending_dir, s_pending_enter, sizeof(s_auth.pending_dir) - 1);
    }

    /* PIN Pad 组件启用 */
    ui_widget_set_visible((ui_widget_t *)&s_auth_pinpad, true);
    ui_widget_set_enabled((ui_widget_t *)&s_auth_pinpad, true);

    /* 拉取用户列表供选择 */
    s_auth.fetching_users = true;
    UART_SetCLICallbacks(&s_file_cb);
    UART_SendCLI("user ls");

    s_fs.loading = false;
    file_update_status();
    file_invalidate_auth_dialog();
}

static void file_hide_auth_dialog(void)
{
    s_auth.visible = false;
    s_pending_enter_valid = false;
    ui_widget_set_visible((ui_widget_t *)&s_auth_pinpad, false);
    ui_widget_set_enabled((ui_widget_t *)&s_auth_pinpad, false);
    file_invalidate_auth_dialog();
}

/* 登录成功后的重试：重新进入被拦截的目录 */
static void file_auth_retry(void)
{
    char dir[FILE_NAME_MAX_LEN + 1];

    strncpy(dir, s_auth.pending_dir, sizeof(dir) - 1);
    dir[sizeof(dir) - 1] = '\0';

    s_auth.visible = false;
    s_pending_enter_valid = false;
    ui_widget_set_visible((ui_widget_t *)&s_auth_pinpad, false);
    ui_widget_set_enabled((ui_widget_t *)&s_auth_pinpad, false);

    if (dir[0] != '\0')
        file_enter_path(dir);
    else
        file_request_list();
}

static void file_auth_confirm(void)
{
    char cmd[64];

    if (s_auth.user_sel < 0 || s_auth.user_sel >= s_auth.user_count) {
        snprintf(s_auth.message, sizeof(s_auth.message), "No user selected");
        file_invalidate_auth_dialog();
        return;
    }
    if (s_auth.pin_len == 0) {
        snprintf(s_auth.message, sizeof(s_auth.message), "Enter PIN");
        file_invalidate_auth_dialog();
        return;
    }
    snprintf(cmd, sizeof(cmd), "login %s %s",
             s_auth.users[s_auth.user_sel], s_auth.pin);
    UART_SetCLICallbacks(&s_file_cb);
    UART_SendCLI(cmd);
    snprintf(s_auth.message, sizeof(s_auth.message), "Verifying...");
    file_invalidate_auth_dialog();
}

/* 解析 user ls 输出：行格式 "USER <name> fp=[...] nfc=[...]" */
static void file_auth_parse_users(const char *buf, uint16_t len)
{
    const char *p = buf;
    const char *end = buf + len;

    s_auth.user_count = 0;
    while (p < end && s_auth.user_count < AUTH_MAX_USERS) {
        const char *eol = p;
        while (eol < end && *eol != '\r' && *eol != '\n') eol++;

        if ((eol - p) > 5 && memcmp(p, "USER ", 5) == 0) {
            const char *name = p + 5;
            const char *sp = name;
            uint16_t nlen;

            while (sp < eol && *sp != ' ') sp++;
            nlen = (uint16_t)(sp - name);
            if (nlen > 0) {
                if (nlen > 16) nlen = 16;
                memcpy(s_auth.users[s_auth.user_count], name, nlen);
                s_auth.users[s_auth.user_count][nlen] = '\0';
                s_auth.user_count++;
            }
        }

        p = eol;
        while (p < end && (*p == '\r' || *p == '\n')) p++;
    }

    s_auth.fetching_users = false;
    if (s_auth.user_count > 0)
        s_auth.user_sel = 0;
    else
        snprintf(s_auth.message, sizeof(s_auth.message),
                 "No users. Use CLI: user add");
    file_invalidate_auth_dialog();
}

/* USER_STATUS 推送回调：指纹/NFC 登录成功时自动重试 */
static void file_on_user_status(uint8_t logged_in, const char *name)
{
    (void)name;
    if (s_auth.visible && logged_in)
        file_auth_retry();
}

static uart_user_cb_t s_file_user_cb = {
    .on_user_status = file_on_user_status,
};

/* PIN Pad 按键：数字追加 / <- 删除 / OK 确认 */
static void file_on_auth_pinpad_key(ui_widget_t *w, uint8_t key)
{
    (void)w;

    if (!s_auth.visible)
        return;

    if (key == UI_PINPAD_KEY_BACKSPACE) {
        if (s_auth.pin_len > 0)
            s_auth.pin[--s_auth.pin_len] = '\0';
        file_invalidate_auth_dialog();
    } else if (key == UI_PINPAD_KEY_OK) {
        file_auth_confirm();
    } else {
        if (s_auth.pin_len < AUTH_PIN_MAX) {
            s_auth.pin[s_auth.pin_len++] = (char)key;
            s_auth.pin[s_auth.pin_len] = '\0';
            file_invalidate_auth_dialog();
        }
    }
}

/*=============================================================================
 *  Drawing
 *=============================================================================*/

static void file_draw_toolbar(void)
{
    ui_rect_t tb_bg = {0, FILE_TOOLBAR_Y, UI_SCREEN_WIDTH, FILE_TOOLBAR_H};
    ui_draw_fill_rect(&tb_bg, UI_HEX(0xF5F5F5));
    ui_draw_hline(0, FILE_TOOLBAR_Y + FILE_TOOLBAR_H - 1, UI_SCREEN_WIDTH, FILE_BORDER);
}

static void file_draw_breadcrumb(void)
{
    ui_rect_t bg = {0, FILE_BREADCRUMB_Y, UI_SCREEN_WIDTH, FILE_BREADCRUMB_H};
    ui_draw_fill_rect(&bg, FILE_BREADCRUMB_BG);
    ui_draw_hline(0, FILE_BREADCRUMB_Y + FILE_BREADCRUMB_H - 1, UI_SCREEN_WIDTH, FILE_BORDER);

    /* Parse path into segments and draw breadcrumb */
    int16_t x = 12;
    int16_t y = FILE_BREADCRUMB_Y + 6;

    /* Device indicator */
    const char *dev = s_fs.current_device ? "USB" : "SD";
    ui_draw_text(x, y, dev, UI_FONT_BODY, UI_COLOR_PRIMARY);
    x += ui_text_width(dev, UI_FONT_BODY) + 4;
    ui_draw_text(x, y, "|", UI_FONT_BODY, FILE_BREADCRUMB_SEP);
    x += ui_text_width("|", UI_FONT_BODY) + 6;

    /* Root */
    ui_draw_text(x, y, "\\", UI_FONT_BODY,
                 s_fs.path[0] == '\0' ? UI_COLOR_TEXT_PRIMARY : FILE_BREADCRUMB_TXT);
    x += ui_text_width("\\", UI_FONT_BODY) + 4;

    /* Path segments */
    if (s_fs.path[0] != '\0') {
        char path_copy[FILE_PATH_MAX];
        strncpy(path_copy, s_fs.path, sizeof(path_copy) - 1);
        path_copy[sizeof(path_copy) - 1] = '\0';

        /* Skip leading backslash */
        char *seg = path_copy;
        if (seg[0] == '\\') seg++;

        char *token = strtok(seg, "\\");
        while (token != NULL && x < UI_SCREEN_WIDTH - 20) {
            ui_draw_text(x, y, ">", UI_FONT_BODY, FILE_BREADCRUMB_SEP);
            x += ui_text_width(">", UI_FONT_BODY) + 4;
            ui_draw_text(x, y, token, UI_FONT_BODY, UI_COLOR_TEXT_PRIMARY);
            x += ui_text_width(token, UI_FONT_BODY) + 4;
            token = strtok(NULL, "\\");
        }
    }

    /* Status on the right */
    int16_t sw = ui_text_width(s_status_text, UI_FONT_BODY);
    ui_draw_text(UI_SCREEN_WIDTH - sw - 12, y, s_status_text,
                 UI_FONT_BODY, FILE_SIZE_COLOR);
}

static void file_draw_list(void)
{
    ui_rect_t list_bg = {0, FILE_LIST_Y, UI_SCREEN_WIDTH, FILE_LIST_H};
    ui_draw_fill_rect(&list_bg, FILE_BG);

    if (s_fs.loading) {
        ui_draw_text_in_rect(&list_bg, "Loading...", UI_FONT_TITLE,
                             UI_COLOR_TEXT_SECONDARY, 0x11);
        return;
    }
    if (s_fs.count == 0) {
        ui_draw_text_in_rect(&list_bg, "Empty directory", UI_FONT_TITLE,
                             UI_COLOR_TEXT_SECONDARY, 0x11);
        return;
    }

    /* Items — pixel-level smooth scroll, clipped to the list viewport */
    int32_t pos = s_list_scroller.pos;
    int16_t first = (int16_t)(pos / FILE_ITEM_H);
    int16_t off   = (int16_t)(pos % FILE_ITEM_H);

    ui_render_push_target(&list_bg);
    for (int i = 0; i <= FILE_VISIBLE_ITEMS && (first + i) < s_fs.count; i++) {
        int idx = first + i;
        file_entry_t *e = &s_fs.entries[idx];
        int16_t y = FILE_LIST_Y - off + i * FILE_ITEM_H;
        ui_rect_t item_rect = {0, y, UI_SCREEN_WIDTH, FILE_ITEM_H};
        ui_color_t bg = (idx == s_fs.selected) ? FILE_ITEM_SEL :
                        (idx % 2 == 0) ? FILE_ITEM_BG : FILE_ITEM_ALT;
        ui_draw_fill_rect(&item_rect, bg);
        ui_draw_hline(12, y + FILE_ITEM_H - 1, UI_SCREEN_WIDTH - 24, FILE_BORDER);

        bool is_dir = (e->attr & FILE_ATTR_IS_DIR) != 0;
        ui_color_t icon_clr = file_icon_color(e);
        const char *icon = file_icon_text(e);

        /* Icon badge */
        ui_rect_t badge = {16, y + 12, 28, 28};
        ui_draw_fill_round_rect(&badge, 5, icon_clr);
        ui_draw_text(24, y + 17, icon, UI_FONT_BODY, UI_COLOR_WHITE);

        /* File name */
        ui_draw_text(56, y + 4, e->name, UI_FONT_TITLE, UI_COLOR_TEXT_PRIMARY);

        /* Size or type label */
        if (is_dir) {
            ui_draw_text(56, y + 30, "Folder", UI_FONT_BODY, FILE_SIZE_COLOR);
        } else if (e->size > 0) {
            char size_buf[16];
            file_format_size(e->size, size_buf, sizeof(size_buf));
            ui_draw_text(56, y + 30, size_buf, UI_FONT_BODY, FILE_SIZE_COLOR);
        }
    }
    ui_render_pop_target();

    /* Scroll indicator (position follows the animated pixel offset) */
    if (s_fs.count > FILE_VISIBLE_ITEMS) {
        int16_t bar_h = FILE_LIST_H * FILE_VISIBLE_ITEMS / s_fs.count;
        if (bar_h < 20) bar_h = 20;
        int32_t max_px = (int32_t)(s_fs.count - FILE_VISIBLE_ITEMS) * FILE_ITEM_H;
        int16_t bar_y = FILE_LIST_Y;
        if (max_px > 0)
            bar_y += (int16_t)((int32_t)(FILE_LIST_H - bar_h) * pos / max_px);
        ui_rect_t scroll_bg = {UI_SCREEN_WIDTH - 6, FILE_LIST_Y, 6, FILE_LIST_H};
        ui_draw_fill_rect(&scroll_bg, UI_HEX(0xE0E0E0));
        ui_rect_t scroll_bar = {UI_SCREEN_WIDTH - 6, bar_y, 6, bar_h};
        ui_draw_fill_rect(&scroll_bar, UI_HEX(0xBDBDBD));
    }
}

static void file_draw_context_menu(void)
{
    ctx_menu_t *ctx = &s_fs.ctx;
    if (!ctx->visible) return;

    int16_t menu_h = ctx->count * CTX_MENU_ITEM_H;

    /* Shadow */
    ui_rect_t shadow = {ctx->x + 3, ctx->y + 3, CTX_MENU_W, menu_h};
    ui_draw_fill_rect(&shadow, UI_HEX(0xE0E0E0));

    /* Background */
    ui_rect_t bg = {ctx->x, ctx->y, CTX_MENU_W, menu_h};
    ui_draw_fill_rect(&bg, CTX_MENU_BG);
    ui_draw_rect_border(&bg, CTX_MENU_BORDER, 1);

    /* Items */
    for (int i = 0; i < ctx->count; i++) {
        int16_t iy = ctx->y + i * CTX_MENU_ITEM_H;
        ui_rect_t item_r = {ctx->x + 1, iy, CTX_MENU_W - 2, CTX_MENU_ITEM_H};

        if (i == ctx->selected) {
            ui_draw_fill_rect(&item_r, CTX_MENU_SEL);
        }

        ui_color_t text_clr = UI_COLOR_TEXT_PRIMARY;
        if (ctx->actions[i] == CTX_DELETE) text_clr = CTX_MENU_DANGER;
        ui_draw_text(ctx->x + 16, iy + 7, ctx->labels[i],
                     UI_FONT_TITLE, text_clr);

        if (i < ctx->count - 1)
            ui_draw_hline(ctx->x + 8, iy + CTX_MENU_ITEM_H - 1,
                          CTX_MENU_W - 16, FILE_BORDER);
    }
}

static void file_draw_input_dialog(void)
{
    input_dlg_t *dlg = &s_fs.input;
    if (!dlg->visible) return;

    /* Dim background overlay */
    ui_rect_t screen = {0, 0, UI_SCREEN_WIDTH, UI_SCREEN_HEIGHT};
    ui_draw_fill_rect(&screen, UI_HEX(0xC0C0C0));  /* Semi-dark overlay approx */

    /* Dialog box centered */
    int16_t dx = (UI_SCREEN_WIDTH - INPUT_DLG_W) / 2;
    int16_t dy = (UI_SCREEN_HEIGHT - INPUT_DLG_H) / 2;
    ui_rect_t dlg_bg = {dx, dy, INPUT_DLG_W, INPUT_DLG_H};
    ui_draw_fill_round_rect(&dlg_bg, 8, INPUT_DLG_BG);
    ui_draw_round_rect_border(&dlg_bg, 8, INPUT_DLG_BORDER, 1);

    /* Title */
    ui_draw_text(dx + 20, dy + 14, dlg->title, UI_FONT_TITLE, UI_COLOR_TEXT_PRIMARY);

    /* Input field (shared textfield helper; caret follows cursor_pos) */
    ui_rect_t field = {dx + 20, dy + 46, INPUT_DLG_W - 40, 40};
    ui_textfield_style_t tf_st = {
        .bg = UI_COLOR_WHITE, .border = UI_COLOR_PRIMARY,
        .text = UI_COLOR_TEXT_PRIMARY, .hint = UI_COLOR_TEXT_DISABLED,
        .cursor = UI_COLOR_PRIMARY,
        .font = UI_FONT_TITLE, .hint_font = UI_FONT_BODY,
        .radius = 0, .border_w = 1,
    };
    ui_textfield_draw(&field, dlg->buffer, (uint16_t)dlg->cursor_pos,
                      dlg->hint, true, &tf_st);

    /* Buttons: Cancel | OK */
    int16_t btn_y = dy + INPUT_DLG_H - 44;
    ui_rect_t cancel_r = {dx + INPUT_DLG_W - 180, btn_y, 72, 30};
    ui_draw_fill_round_rect(&cancel_r, 6, UI_HEX(0xE0E0E0));
    ui_draw_text(cancel_r.x + 12, cancel_r.y + 6, "Cancel",
                 UI_FONT_BODY, UI_COLOR_TEXT_PRIMARY);

    ui_rect_t ok_r = {dx + INPUT_DLG_W - 96, btn_y, 72, 30};
    ui_draw_fill_round_rect(&ok_r, 6, UI_COLOR_PRIMARY);
    ui_draw_text(ok_r.x + 22, ok_r.y + 6, "OK",
                 UI_FONT_BODY, UI_COLOR_WHITE);
}

static void file_draw_auth_dialog(void)
{
    if (!s_auth.visible) return;

    /* Dim overlay */
    ui_rect_t screen = {0, 0, UI_SCREEN_WIDTH, UI_SCREEN_HEIGHT};
    ui_draw_fill_rect(&screen, UI_HEX(0xC0C0C0));

    /* Dialog box centered */
    int16_t dx = (UI_SCREEN_WIDTH - AUTH_DLG_W) / 2;
    int16_t dy = (UI_SCREEN_HEIGHT - AUTH_DLG_H) / 2;
    ui_rect_t dlg_bg = {dx, dy, AUTH_DLG_W, AUTH_DLG_H};
    ui_draw_fill_round_rect(&dlg_bg, 8, INPUT_DLG_BG);
    ui_draw_round_rect_border(&dlg_bg, 8, INPUT_DLG_BORDER, 1);

    /* Title */
    ui_draw_text(dx + 20, dy + 14, "Private Folder", UI_FONT_TITLE,
                 UI_COLOR_TEXT_PRIMARY);

    /* Target path */
    {
        char path_line[96];
        if (s_auth.pending_dir[0] != '\0')
            snprintf(path_line, sizeof(path_line), "Folder: %s", s_auth.pending_dir);
        else
            snprintf(path_line, sizeof(path_line), "Folder: %s", s_fs.path);
        ui_draw_text(dx + 20, dy + 42, path_line, UI_FONT_BODY,
                     UI_COLOR_TEXT_SECONDARY);
    }

    /* User selector: [<] [   Name   ] [>] */
    {
        int16_t uy = dy + 66;
        ui_rect_t prev_r = {dx + 20, uy, 36, 32};
        ui_draw_fill_round_rect(&prev_r, 6, UI_HEX(0xE0E0E0));
        ui_draw_text(prev_r.x + 12, uy + 8, "<", UI_FONT_BODY, UI_COLOR_TEXT_PRIMARY);

        ui_rect_t name_r = {dx + 62, uy, 220, 32};
        ui_draw_fill_rect(&name_r, UI_COLOR_WHITE);
        ui_draw_rect_border(&name_r, UI_COLOR_PRIMARY, 1);
        const char *uname = (s_auth.user_sel >= 0 &&
                             s_auth.user_sel < s_auth.user_count)
                            ? s_auth.users[s_auth.user_sel] : "(no user)";
        ui_draw_text_in_rect(&name_r, uname, UI_FONT_TITLE,
                             UI_COLOR_TEXT_PRIMARY, 0x11);

        ui_rect_t next_r = {dx + 288, uy, 36, 32};
        ui_draw_fill_round_rect(&next_r, 6, UI_HEX(0xE0E0E0));
        ui_draw_text(next_r.x + 12, uy + 8, ">", UI_FONT_BODY, UI_COLOR_TEXT_PRIMARY);
    }

    /* PIN field (masked) */
    {
        char masked[AUTH_PIN_MAX + 1];
        uint8_t i;
        for (i = 0; i < s_auth.pin_len; i++) masked[i] = '*';
        masked[i] = '\0';

        ui_rect_t field = {dx + 20, dy + 110, AUTH_LEFT_W - 40, 40};
        ui_textfield_style_t tf_st = {
            .bg = UI_COLOR_WHITE, .border = UI_COLOR_PRIMARY,
            .text = UI_COLOR_TEXT_PRIMARY, .hint = UI_COLOR_TEXT_DISABLED,
            .cursor = UI_COLOR_PRIMARY,
            .font = UI_FONT_TITLE, .hint_font = UI_FONT_BODY,
            .radius = 0, .border_w = 1,
        };
        ui_textfield_draw(&field, masked, (uint16_t)s_auth.pin_len,
                          "PIN", true, &tf_st);
    }

    /* Message / hint */
    if (s_auth.message[0] != '\0') {
        ui_draw_text(dx + 20, dy + 158, s_auth.message, UI_FONT_BODY,
                     UI_COLOR_DANGER);
    } else {
        ui_draw_text(dx + 20, dy + 158, "Fingerprint / NFC card also works",
                     UI_FONT_BODY, UI_COLOR_TEXT_SECONDARY);
    }

    /* Buttons: Cancel | Unlock（左列底部；右侧为 PIN Pad 组件） */
    int16_t btn_y = dy + AUTH_DLG_H - 48;
    ui_rect_t cancel_r = {dx + 20, btn_y, 96, 32};
    ui_draw_fill_round_rect(&cancel_r, 6, UI_HEX(0xE0E0E0));
    ui_draw_text(cancel_r.x + 18, btn_y + 8, "Cancel",
                 UI_FONT_BODY, UI_COLOR_TEXT_PRIMARY);

    ui_rect_t ok_r = {dx + 128, btn_y, 96, 32};
    ui_draw_fill_round_rect(&ok_r, 6, UI_COLOR_PRIMARY);
    ui_draw_text(ok_r.x + 18, btn_y + 8, "Unlock",
                 UI_FONT_BODY, UI_COLOR_WHITE);
}

static void file_draw_stat_dialog(void)
{
    if (!s_fs.stat_visible) return;

    /* Dim overlay */
    ui_rect_t screen = {0, 0, UI_SCREEN_WIDTH, UI_SCREEN_HEIGHT};
    ui_draw_fill_rect(&screen, UI_HEX(0xC0C0C0));

    int16_t dw = 400, dh = 280;
    int16_t dx = (UI_SCREEN_WIDTH - dw) / 2;
    int16_t dy = (UI_SCREEN_HEIGHT - dh) / 2;
    ui_rect_t dlg_bg = {dx, dy, dw, dh};
    ui_draw_fill_round_rect(&dlg_bg, 8, INPUT_DLG_BG);
    ui_draw_round_rect_border(&dlg_bg, 8, INPUT_DLG_BORDER, 1);

    /* Title */
    ui_draw_text(dx + 20, dy + 14, "Properties", UI_FONT_TITLE, UI_COLOR_TEXT_PRIMARY);
    ui_draw_hline(dx + 16, dy + 38, dw - 32, FILE_BORDER);

    /* Stat text (multi-line) */
    if (s_fs.stat_text[0] != '\0') {
        const char *p = s_fs.stat_text;
        int16_t ly = dy + 48;
        char line_buf[64];
        while (*p && ly < dy + dh - 50) {
            int li = 0;
            while (*p && *p != '\n' && *p != '\r' && li < (int)sizeof(line_buf) - 1) {
                line_buf[li++] = *p++;
            }
            line_buf[li] = '\0';
            if (*p == '\r') p++;
            if (*p == '\n') p++;
            if (li > 0) {
                ui_draw_text(dx + 20, ly, line_buf, UI_FONT_BODY, UI_COLOR_TEXT_PRIMARY);
                ly += 22;
            }
        }
    } else {
        ui_draw_text(dx + 20, dy + 48, "Loading...", UI_FONT_BODY, UI_COLOR_TEXT_SECONDARY);
    }

    /* Close button */
    ui_rect_t close_r = {dx + dw - 96, dy + dh - 44, 72, 30};
    ui_draw_fill_round_rect(&close_r, 6, UI_COLOR_PRIMARY);
    ui_draw_text(close_r.x + 14, close_r.y + 6, "Close",
                 UI_FONT_BODY, UI_COLOR_WHITE);
}

/*=============================================================================
 *  Page Callbacks
 *=============================================================================*/

static void file_page_enter(ui_page_t *page)
{
    (void)page;
    UART_SetCLICallbacks(&s_file_cb);
    UART_SetUserCallbacks(&s_file_user_cb);
    if (!s_fs.data_ready && !s_fs.loading) {
        /* Debug: trace enter flow and add delay to avoid timing issue */
        printf("[FILE] enter, requesting root\r\n");
        UART_RequestFileList("\\");
    }
    ui_page_invalidate_all();
}

static void file_page_draw(ui_page_t *page, ui_rect_t *dirty)
{
    (void)page; (void)dirty;
    ui_rect_t bar = {0, 0, UI_SCREEN_WIDTH, APP_TITLE_BAR_H};
    ui_draw_fill_rect(&bar, UI_COLOR_PRIMARY);
    file_draw_toolbar();
    file_draw_breadcrumb();
    file_draw_list();
    file_draw_context_menu();
    file_draw_input_dialog();
    file_draw_stat_dialog();
    file_draw_auth_dialog();
}

/*=============================================================================
 *  Widget Event Handlers
 *=============================================================================*/

static void list_touch_event(ui_widget_t *w, ui_event_t *e)
{
    (void)w;

    /* If auth dialog is open, handle dialog events (topmost) */
    if (s_auth.visible) {
        if (e->type == UI_EVENT_CLICK) {
            int16_t dx = (UI_SCREEN_WIDTH - AUTH_DLG_W) / 2;
            int16_t dy = (UI_SCREEN_HEIGHT - AUTH_DLG_H) / 2;
            int16_t uy = dy + 66;
            int16_t btn_y = dy + AUTH_DLG_H - 48;

            /* User prev */
            ui_rect_t prev_r = {dx + 20, uy, 36, 32};
            if (ui_widget_hit_test((ui_widget_t *)&prev_r, e->pos.x, e->pos.y)) {
                if (s_auth.user_count > 0) {
                    s_auth.user_sel--;
                    if (s_auth.user_sel < 0) s_auth.user_sel = s_auth.user_count - 1;
                    file_invalidate_auth_dialog();
                }
                return;
            }
            /* User next */
            ui_rect_t next_r = {dx + 288, uy, 36, 32};
            if (ui_widget_hit_test((ui_widget_t *)&next_r, e->pos.x, e->pos.y)) {
                if (s_auth.user_count > 0) {
                    s_auth.user_sel++;
                    if (s_auth.user_sel >= s_auth.user_count) s_auth.user_sel = 0;
                    file_invalidate_auth_dialog();
                }
                return;
            }
            /* Cancel */
            ui_rect_t cancel_r = {dx + 20, btn_y, 96, 32};
            if (ui_widget_hit_test((ui_widget_t *)&cancel_r, e->pos.x, e->pos.y)) {
                file_hide_auth_dialog();
                return;
            }
            /* Unlock */
            ui_rect_t ok_r = {dx + 128, btn_y, 96, 32};
            if (ui_widget_hit_test((ui_widget_t *)&ok_r, e->pos.x, e->pos.y)) {
                file_auth_confirm();
                return;
            }
        }
        return;
    }

    /* If input dialog is open, handle dialog events */
    if (s_fs.input.visible) {
        if (e->type == UI_EVENT_CLICK) {
            int16_t dx = (UI_SCREEN_WIDTH - INPUT_DLG_W) / 2;
            int16_t dy = (UI_SCREEN_HEIGHT - INPUT_DLG_H) / 2;
            int16_t btn_y = dy + INPUT_DLG_H - 44;

            /* Cancel button */
            ui_rect_t cancel_r = {dx + INPUT_DLG_W - 180, btn_y, 72, 30};
            if (ui_widget_hit_test((ui_widget_t *)&cancel_r, e->pos.x, e->pos.y)) {
                file_hide_input_dialog();
                return;
            }
            /* OK button */
            ui_rect_t ok_r = {dx + INPUT_DLG_W - 96, btn_y, 72, 30};
            if (ui_widget_hit_test((ui_widget_t *)&ok_r, e->pos.x, e->pos.y)) {
                file_input_dialog_confirm();
                return;
            }
        }
        return;
    }

    /* If stat dialog is open, handle close */
    if (s_fs.stat_visible) {
        if (e->type == UI_EVENT_CLICK) {
            int16_t dw = 400, dh = 280;
            int16_t dx = (UI_SCREEN_WIDTH - dw) / 2;
            int16_t dy = (UI_SCREEN_HEIGHT - dh) / 2;
            ui_rect_t close_r = {dx + dw - 96, dy + dh - 44, 72, 30};
            if (ui_widget_hit_test((ui_widget_t *)&close_r, e->pos.x, e->pos.y)) {
                s_fs.stat_visible = false;
                file_invalidate_stat_dialog();
                return;
            }
        }
        return;
    }

    /* If context menu is open */
    if (s_fs.ctx.visible) {
        if (e->type == UI_EVENT_CLICK) {
            ctx_menu_t *ctx = &s_fs.ctx;
            int16_t rel_x = e->pos.x - ctx->x;
            int16_t rel_y = e->pos.y - ctx->y;
            if (rel_x >= 0 && rel_x < CTX_MENU_W && rel_y >= 0 &&
                rel_y < ctx->count * CTX_MENU_ITEM_H) {
                ctx->selected = rel_y / CTX_MENU_ITEM_H;
                file_ctx_menu_execute();
            } else {
                file_hide_context_menu();
            }
            return;
        }
        return;
    }

    /* Touch swipe scrolling (smooth) */
    if (e->type == UI_EVENT_SWIPE_UP) {
        file_scroll_set(s_fs.scroll_offset + 3, true);
        return;
    }
    if (e->type == UI_EVENT_SWIPE_DOWN) {
        file_scroll_set(s_fs.scroll_offset - 3, true);
        return;
    }

    /* Mouse wheel scrolling (smooth) */
    if (e->type == UI_EVENT_MOVE && e->scroll_delta != 0) {
        file_scroll_set(s_fs.scroll_offset - e->scroll_delta, true);
        return;
    }

    /* Click / Double-click handling */
    if (e->type != UI_EVENT_CLICK && e->type != UI_EVENT_DOUBLE_CLICK) return;
    if (s_fs.count == 0) return;
    int16_t rel_y = e->pos.y - FILE_LIST_Y;
    if (rel_y < 0 || rel_y >= FILE_LIST_H) return;
    /* Use the animated pixel offset so the hit matches what is on screen */
    int item_idx = (int)((rel_y + s_list_scroller.pos) / FILE_ITEM_H);
    if (item_idx < 0 || item_idx >= s_fs.count) return;

    /* Right-click: context menu */
    if (e->type == UI_EVENT_CLICK && (e->mouse_buttons & UI_MOUSE_BTN_RIGHT)) {
        s_fs.selected = item_idx;
        file_show_context_menu(e->pos.x, e->pos.y, item_idx);
        ui_input_consume_rightclick();   /* claim: don't also trigger global Back */
        return;
    }

    if (e->type == UI_EVENT_DOUBLE_CLICK) {
        s_fs.selected = item_idx;
        file_open_selected();
        return;
    }

    /* Single click: select or double-click detection */
    uint32_t now = ui_get_real_ms();
    if (item_idx == s_fs.selected && (now - s_last_click_ms) < DOUBLE_CLICK_MS) {
        file_open_selected();
        s_last_click_ms = 0;
        return;
    }

    int16_t old_sel = s_fs.selected;
    s_fs.selected = item_idx;
    s_last_click_ms = now;
    if (old_sel >= 0 && old_sel != item_idx) file_invalidate_item(old_sel);
    file_invalidate_item(item_idx);
}

/* Page-level event handler — called by UI_Tick before widget dispatch.
 * Returns true if event was consumed (prevents further propagation). */
static bool file_page_event(ui_page_t *page, ui_event_t *e)
{
    (void)page;

    /* Only handle keyboard and core-key events */
    if (e->source != UI_INPUT_KEYBOARD && e->source != UI_INPUT_CORE_KEY)
        return false;

    /* --- Auth dialog is open: consume ALL key events (topmost) --- */
    if (s_auth.visible) {
        /* ESC/Back: cancel dialog */
        if (e->type == UI_EVENT_KEY_DOWN && e->key_code == UI_KEY_BACK) {
            file_hide_auth_dialog();
            return true;
        }
        /* Enter: confirm */
        if (e->type == UI_EVENT_KEY_DOWN && e->key_code == UI_KEY_OK) {
            file_auth_confirm();
            return true;
        }
        /* Left/Right: switch user */
        if (e->type == UI_EVENT_KEY_DOWN || e->type == UI_EVENT_KEY_LONG_REPEAT) {
            if (e->key_code == UI_KEY_LEFT && s_auth.user_count > 0) {
                s_auth.user_sel--;
                if (s_auth.user_sel < 0) s_auth.user_sel = s_auth.user_count - 1;
                file_invalidate_auth_dialog();
                return true;
            }
            if (e->key_code == UI_KEY_RIGHT && s_auth.user_count > 0) {
                s_auth.user_sel++;
                if (s_auth.user_sel >= s_auth.user_count) s_auth.user_sel = 0;
                file_invalidate_auth_dialog();
                return true;
            }
        }
        /* PIN digit/char input */
        if ((e->type == UI_EVENT_KEY_DOWN || e->type == UI_EVENT_KEY_LONG_REPEAT) &&
            e->char_code >= 0x20 && e->char_code <= 0x7E &&
            s_auth.pin_len < AUTH_PIN_MAX) {
            s_auth.pin[s_auth.pin_len++] = (char)e->char_code;
            s_auth.pin[s_auth.pin_len] = '\0';
            file_invalidate_auth_dialog();
            return true;
        }
        /* Backspace */
        if ((e->type == UI_EVENT_KEY_DOWN || e->type == UI_EVENT_KEY_LONG_REPEAT) &&
            e->char_code == 0x08) {
            if (s_auth.pin_len > 0)
                s_auth.pin[--s_auth.pin_len] = '\0';
            file_invalidate_auth_dialog();
            return true;
        }
        return true;
    }

    /* --- Input dialog is open: consume ALL key events --- */
    if (s_fs.input.visible) {
        input_dlg_t *dlg = &s_fs.input;

        /* ESC/Back: cancel dialog */
        if (e->type == UI_EVENT_KEY_DOWN && e->key_code == UI_KEY_BACK) {
            file_hide_input_dialog();
            return true;
        }
        /* Enter: confirm dialog */
        if (e->type == UI_EVENT_KEY_DOWN && e->key_code == UI_KEY_OK) {
            file_input_dialog_confirm();
            return true;
        }
        /* Character input via char_code (KEY_DOWN = immediate, KEY_LONG_REPEAT = held repeat) */
        if ((e->type == UI_EVENT_KEY_DOWN || e->type == UI_EVENT_KEY_LONG_REPEAT) &&
            e->char_code >= 0x20 && e->char_code <= 0x7E &&
            dlg->buf_len < FILE_NAME_MAX_LEN) {
            memmove(&dlg->buffer[dlg->cursor_pos + 1],
                    &dlg->buffer[dlg->cursor_pos],
                    dlg->buf_len - dlg->cursor_pos + 1);
            dlg->buffer[dlg->cursor_pos] = (char)e->char_code;
            dlg->cursor_pos++;
            dlg->buf_len++;
            file_invalidate_input_dialog();
            return true;
        }
        /* Backspace via char_code (KEY_DOWN + KEY_LONG_REPEAT for held delete) */
        if ((e->type == UI_EVENT_KEY_DOWN || e->type == UI_EVENT_KEY_LONG_REPEAT) &&
            e->char_code == 0x08) {
            if (dlg->cursor_pos > 0) {
                memmove(&dlg->buffer[dlg->cursor_pos - 1],
                        &dlg->buffer[dlg->cursor_pos],
                        dlg->buf_len - dlg->cursor_pos + 1);
                dlg->cursor_pos--;
                dlg->buf_len--;
            }
            file_invalidate_input_dialog();
            return true;
        }
        /* Consume all other key events to prevent widgets from receiving them */
        return true;
    }

    /* --- Stat dialog is open: any key closes it --- */
    if (s_fs.stat_visible) {
        if (e->type == UI_EVENT_KEY_CLICK || e->type == UI_EVENT_KEY_DOWN) {
            s_fs.stat_visible = false;
            file_invalidate_stat_dialog();
        }
        return true;  /* Consume all key events while stat dialog is visible */
    }

    /* --- Context menu is open --- */
    if (s_fs.ctx.visible) {
        ctx_menu_t *ctx = &s_fs.ctx;
        if (e->type == UI_EVENT_KEY_DOWN || e->type == UI_EVENT_KEY_LONG_REPEAT) {
            switch (e->key_code) {
            case UI_KEY_UP:
                if (ctx->selected < 0) ctx->selected = ctx->count - 1;
                else if (ctx->selected > 0) ctx->selected--;
                file_invalidate_ctx_menu();
                break;
            case UI_KEY_DOWN:
                if (ctx->selected < 0) ctx->selected = 0;
                else if (ctx->selected < ctx->count - 1) ctx->selected++;
                file_invalidate_ctx_menu();
                break;
            default:
                break;
            }
        }
        if (e->type == UI_EVENT_KEY_CLICK) {
            if (e->key_code == UI_KEY_OK) {
                file_ctx_menu_execute();
            } else if (e->key_code == UI_KEY_BACK) {
                file_hide_context_menu();
            }
        }
        return true;  /* Consume all key events while context menu is visible */
    }

    /* --- Normal list navigation --- */

    /* Arrow keys: KEY_DOWN for immediate response, KEY_LONG_REPEAT for continuous scroll */
    if (e->type == UI_EVENT_KEY_DOWN || e->type == UI_EVENT_KEY_LONG_REPEAT) {
        switch (e->key_code) {
        case UI_KEY_UP:
            if (s_fs.count > 0) {
                int16_t old_sel = s_fs.selected;
                if (s_fs.selected < 0) s_fs.selected = 0;
                else if (s_fs.selected > 0) s_fs.selected--;
                file_ensure_selected_visible();
                file_invalidate_selection_change(old_sel, s_fs.selected);
            }
            return true;
        case UI_KEY_DOWN:
            if (s_fs.count > 0) {
                int16_t old_sel = s_fs.selected;
                if (s_fs.selected < 0) s_fs.selected = 0;
                else if (s_fs.selected < s_fs.count - 1) s_fs.selected++;
                file_ensure_selected_visible();
                file_invalidate_selection_change(old_sel, s_fs.selected);
            }
            return true;
        default:
            break;
        }
    }

    /* KEY_CLICK for confirm/back (prevents double-handling with KEY_DOWN) */
    if (e->type == UI_EVENT_KEY_CLICK) {
        switch (e->key_code) {
        case UI_KEY_OK:
            if (s_fs.selected >= 0) file_open_selected();
            return true;
        case UI_KEY_BACK:
            file_go_up();
            return true;
        case UI_KEY_HOME:
            file_go_root();
            return true;
        default:
            /* Menu key: open context menu */
            if (e->key_code == UI_KEY_MENU && s_fs.selected >= 0) {
                int16_t item_y = FILE_LIST_Y + s_fs.selected * FILE_ITEM_H - (int16_t)s_list_scroller.pos;
                file_show_context_menu(200, item_y, s_fs.selected);
                return true;
            }
            break;
        }
    }

    return false;  /* Unhandled: let global handlers / widgets process */
}

static void btn_up_click(ui_widget_t *w) { (void)w; file_go_up(); }
static void btn_new_folder_click(ui_widget_t *w) { (void)w; if (!s_fs.loading) file_create_folder(); }
static void btn_new_file_click(ui_widget_t *w) { (void)w; if (!s_fs.loading) file_create_file(); }
static void btn_delete_click(ui_widget_t *w) { (void)w; if (!s_fs.loading && s_fs.selected >= 0) file_delete_selected(); }
static void btn_refresh_click(ui_widget_t *w) { (void)w; file_request_list(); }
static void btn_device_click(ui_widget_t *w) { (void)w; file_switch_device(); }

/*=============================================================================
 *  Page Update (per-frame logic — keyboard handled by on_page_event now)
 *=============================================================================*/

static void file_page_update(ui_page_t *page)
{
    (void)page;
    /* Keyboard events are now handled by file_page_event (on_page_event callback),
     * which is called during UI_Tick's event dispatch phase.
     * No need to poll ui_input_poll() here — that was the old broken approach. */

    /* Loading watchdog: if the ls response EOF is lost (dropped frame, or the
     * assembly was wiped by another CLI command), the app must not stay in
     * Loading... forever — auto-recover after 5s. */
    static uint32_t s_loading_since = 0;
    if (s_fs.loading) {
        uint32_t now = ui_get_real_ms();
        if (s_loading_since == 0) s_loading_since = now;
        if ((uint32_t)(now - s_loading_since) > 5000) {
            s_fs.loading = false;
            s_loading_since = 0;
            file_update_status();
            file_invalidate_content();
        }
    } else {
        s_loading_since = 0;
    }
}

/*=============================================================================
 *  Public API
 *=============================================================================*/

void app_file_init(void)
{
    ui_app_page_init(&s_app_file, "Files", 0x101);
    memset(&s_fs, 0, sizeof(s_fs));
    s_fs.current_device = 1;  /* Default to USB */
    ui_scroller_init(&s_list_scroller, 0, file_scroll_moved, NULL);
    file_update_status();

    ui_rect_t r_up = {10, TB_BTN_Y, TB_BTN_W, TB_BTN_H};
    ui_button_init(&btn_up, &r_up, "Up", UI_FONT_BODY);
    ui_button_set_callback(&btn_up, btn_up_click);
    ui_button_set_colors(&btn_up, UI_COLOR_BG_CARD, UI_COLOR_SECONDARY, UI_COLOR_TEXT_PRIMARY);
    btn_up.radius = 8;

    ui_rect_t r_dev = {74, TB_BTN_Y, TB_BTN_W, TB_BTN_H};
    ui_button_init(&btn_device, &r_dev, "USB", UI_FONT_BODY);
    ui_button_set_callback(&btn_device, btn_device_click);
    ui_button_set_colors(&btn_device, UI_HEX(0xE3F2FD), UI_HEX(0x1565C0), UI_HEX(0x1565C0));
    btn_device.radius = 8;

    ui_rect_t r_newf = {138, TB_BTN_Y, TB_BTN_W + 8, TB_BTN_H};
    ui_button_init(&btn_new_folder, &r_newf, "+Dir", UI_FONT_BODY);
    ui_button_set_callback(&btn_new_folder, btn_new_folder_click);
    ui_button_set_colors(&btn_new_folder, UI_COLOR_BG_CARD, UI_COLOR_SECONDARY, UI_COLOR_TEXT_PRIMARY);
    btn_new_folder.radius = 8;

    ui_rect_t r_newfile = {210, TB_BTN_Y, TB_BTN_W + 12, TB_BTN_H};
    ui_button_init(&btn_new_file, &r_newfile, "+File", UI_FONT_BODY);
    ui_button_set_callback(&btn_new_file, btn_new_file_click);
    ui_button_set_colors(&btn_new_file, UI_COLOR_BG_CARD, UI_COLOR_SECONDARY, UI_COLOR_TEXT_PRIMARY);
    btn_new_file.radius = 8;

    ui_rect_t r_delf = {288, TB_BTN_Y, TB_BTN_W, TB_BTN_H};
    ui_button_init(&btn_delete, &r_delf, "Del", UI_FONT_BODY);
    ui_button_set_callback(&btn_delete, btn_delete_click);
    ui_button_set_colors(&btn_delete, UI_HEX(0xFFEBEE), UI_COLOR_ACCENT, UI_COLOR_DANGER);
    btn_delete.radius = 8;

    ui_rect_t r_ref = {352, TB_BTN_Y, TB_BTN_W, TB_BTN_H};
    ui_button_init(&btn_refresh, &r_ref, "Ref", UI_FONT_BODY);
    ui_button_set_callback(&btn_refresh, btn_refresh_click);
    ui_button_set_colors(&btn_refresh, UI_COLOR_BG_CARD, UI_COLOR_SECONDARY, UI_COLOR_TEXT_PRIMARY);
    btn_refresh.radius = 8;

    ui_rect_t touch_rect = {0, FILE_LIST_Y, UI_SCREEN_WIDTH, FILE_LIST_H};
    ui_widget_init(&s_list_touch, &touch_rect);
    s_list_touch.bg_color = UI_COLOR_TRANSPARENT;
    s_list_touch.event_cb = list_touch_event;

    /* 认证对话框 PIN Pad 组件（默认隐藏，AUTH_REQUIRED 弹窗时启用） */
    {
        int16_t dx = (UI_SCREEN_WIDTH - AUTH_DLG_W) / 2;
        int16_t dy = (UI_SCREEN_HEIGHT - AUTH_DLG_H) / 2;
        ui_rect_t pad_r = {dx + AUTH_PAD_X, dy + AUTH_PAD_Y, AUTH_PAD_W, AUTH_PAD_H};
        ui_pinpad_init(&s_auth_pinpad, &pad_r);
        ui_pinpad_set_callback(&s_auth_pinpad, file_on_auth_pinpad_key);
        ui_widget_set_visible((ui_widget_t *)&s_auth_pinpad, false);
        ui_widget_set_enabled((ui_widget_t *)&s_auth_pinpad, false);
    }

    s_file_widgets[0] = (ui_widget_t *)&s_app_file.btn_back;
    s_file_widgets[1] = (ui_widget_t *)&s_app_file.lbl_title;
    s_file_widgets[2] = (ui_widget_t *)&btn_up;
    s_file_widgets[3] = (ui_widget_t *)&btn_device;
    s_file_widgets[4] = (ui_widget_t *)&btn_new_folder;
    s_file_widgets[5] = (ui_widget_t *)&btn_new_file;
    s_file_widgets[6] = (ui_widget_t *)&btn_delete;
    s_file_widgets[7] = (ui_widget_t *)&btn_refresh;
    s_file_widgets[8] = &s_list_touch;
    s_file_widgets[9] = (ui_widget_t *)&s_auth_pinpad;

    ui_page_set_widgets(&s_app_file.page, s_file_widgets, 10);
    ui_page_set_callbacks(&s_app_file.page, file_page_enter, NULL, file_page_draw, NULL);
    ui_page_set_update_cb(&s_app_file.page, file_page_update);
    ui_page_set_event_cb(&s_app_file.page, file_page_event);
    ui_page_register(&s_app_file.page);
}

ui_page_t *app_file_get_page(void) { return &s_app_file.page; }
