sratle/WCH-Model-Terminal/display-model/display-1/Common/Common/Apps/app_editor.c

/********************************** (C) COPYRIGHT *******************************
* File Name          : app_editor.c
* Author             : LCD Model Team
* Version            : V4.0.0
* Date               : 2026/05/25
* Description        : Text Editor app (V4.0 full-featured).
*                      Read/write files via CLI passthrough.
*                      Full keyboard editing: insert, delete, cursor movement.
*                      Mouse click to position cursor, scroll wheel.
*                      Line numbers, status bar, cursor blink.
*                      Save via CLI "echo" redirect.
********************************************************************************/
#include "app_editor.h"
#include "../UI/ui_app_common.h"
#include "../UART/uart_module.h"
#include "../MiniUI/miniui_anim.h"
#include <string.h>
#include <stdio.h>

/*=============================================================================
 *  Layout Configuration (800x480)
 *=============================================================================*/

#define EDIT_STATUS_H       28
#define EDIT_STATUS_Y       (UI_SCREEN_HEIGHT - EDIT_STATUS_H)
#define EDIT_GUTTER_W       48
#define EDIT_TEXT_X         EDIT_GUTTER_W
#define EDIT_TEXT_Y         APP_TITLE_BAR_H
#define EDIT_TEXT_W         (UI_SCREEN_WIDTH - EDIT_GUTTER_W)
#define EDIT_TEXT_H         (EDIT_STATUS_Y - APP_TITLE_BAR_H)
#define EDIT_LINE_H         22
#define EDIT_VISIBLE_LINES  (EDIT_TEXT_H / EDIT_LINE_H)
#define EDIT_BUF_SIZE       4096
#define EDIT_MAX_LINES      256
#define EDIT_MAX_UNDO       64
#define EDIT_TAB_SIZE       4
#define EDIT_MAX_LINE_LEN   256

/* Cursor blink timing */
#define CURSOR_BLINK_ON_MS  530
#define CURSOR_BLINK_OFF_MS 470

/*=============================================================================
 *  Colors
 *=============================================================================*/

#define EDIT_BG             UI_HEX(0xFAFAFA)
#define EDIT_GUTTER_BG      UI_HEX(0xF0F0F0)
#define EDIT_GUTTER_TEXT    UI_HEX(0xAAAAAA)
#define EDIT_TEXT_COLOR     UI_HEX(0x333333)
#define EDIT_STATUS_BG      UI_HEX(0xECEFF1)
#define EDIT_STATUS_TEXT    UI_HEX(0x607D8B)
#define EDIT_BORDER         UI_HEX(0xE0E0E0)
#define EDIT_CURSOR_COLOR   UI_HEX(0x4FC3F7)
#define EDIT_SELECTION_BG   UI_HEX(0xBBDEFB)
#define EDIT_LINE_HIGHLIGHT UI_HEX(0xF5F5F5)
#define EDIT_MODIFIED_COLOR UI_HEX(0xFF8A65)
#define EDIT_SAVED_COLOR    UI_HEX(0x81C784)

/*=============================================================================
 *  Undo Record
 *=============================================================================*/

typedef enum {
    UNDO_INSERT,    /* Inserted chars at pos */
    UNDO_DELETE,    /* Deleted chars at pos */
} undo_type_t;

typedef struct {
    undo_type_t type;
    uint16_t pos;           /* Position in content buffer */
    uint16_t len;           /* Number of chars affected */
    char data[32];          /* Small inline buffer for deleted text */
} undo_record_t;

/*=============================================================================
 *  Editor State
 *=============================================================================*/

typedef struct {
    char file_name[32];
    char file_path[64];
    char content[EDIT_BUF_SIZE];
    uint16_t content_len;
    uint16_t line_offsets[EDIT_MAX_LINES];
    uint16_t line_count;
    int16_t scroll_line;

    /* Cursor position (character offset in content) */
    uint16_t cursor_pos;

    /* Cursor display coordinates (derived from cursor_pos) */
    int16_t cursor_line;    /* Line index (0-based) */
    int16_t cursor_col;     /* Column (character offset within line) */

    /* Selection (selection_start != selection_end means active selection) */
    uint16_t sel_start;     /* Start of selection (min) */
    uint16_t sel_end;       /* End of selection (max) */
    bool has_selection;

    /* Modification tracking */
    bool is_modified;
    bool is_loading;
    bool has_content;
    bool save_sent;             /* a paced save is in progress (awaiting frame ack) */
    uint16_t save_offset;       /* content bytes already sent in this save */
    bool save_started;          /* the "write -s" frame has been sent */
    bool save_final_sent;       /* the "write -e" frame has been sent */
    uint32_t save_wait_ms;      /* time since current frame was sent (ack timeout) */
    uint8_t save_result;        /* transient result: 0=none, 1=ok, 2=fail */
    uint32_t save_result_ms;    /* time since save_result was set (auto-clear) */

    /* Cursor blink */
    uint32_t cursor_blink_ms;
    bool cursor_visible;

    /* Undo stack */
    undo_record_t undo_stack[EDIT_MAX_UNDO];
    int16_t undo_top;
} editor_state_t;

/*=============================================================================
 *  Static Data
 *=============================================================================*/

static ui_app_page_t s_app_editor;
static ui_button_t btn_save;
static ui_widget_t s_text_touch;
static ui_widget_t *s_editor_widgets[5];
static editor_state_t s_ed;
static char s_status_buf[80];

/* Smooth (animated, pixel-level) text scrolling */
static ui_scroller_t s_ed_scroller;

/*=============================================================================
 *  Dirty Region Helpers
 *=============================================================================*/

/* Invalidate the text area (gutter + text content) */
static void editor_invalidate_text_area(void)
{
    ui_rect_t r = {0, EDIT_TEXT_Y, UI_SCREEN_WIDTH, EDIT_TEXT_H};
    ui_page_invalidate(&r);
}

/* Scroller position update: redraw the text area at the new pixel offset */
static void editor_scroll_moved(int32_t value, void *user_data)
{
    (void)value; (void)user_data;
    editor_invalidate_text_area();
}

/* Set scroll position (in lines), clamped; animates the pixel position */
static void editor_scroll_set(int16_t lines, bool animate)
{
    int16_t max_lines = s_ed.line_count - EDIT_VISIBLE_LINES;
    if (max_lines < 0) max_lines = 0;
    if (lines > max_lines) lines = max_lines;
    if (lines < 0) lines = 0;
    s_ed.scroll_line = lines;
    if (animate) {
        ui_scroller_set_goal(&s_ed_scroller, (int32_t)lines * EDIT_LINE_H);
    } else {
        ui_scroller_jump(&s_ed_scroller, (int32_t)lines * EDIT_LINE_H);
    }
}

/* Invalidate the status bar */
static void editor_invalidate_status(void)
{
    ui_rect_t r = {0, EDIT_STATUS_Y, UI_SCREEN_WIDTH, EDIT_STATUS_H};
    ui_page_invalidate(&r);
}

/* Invalidate a specific line in the text area */
static void editor_invalidate_line(int16_t line_idx)
{
    int16_t y = EDIT_TEXT_Y + line_idx * EDIT_LINE_H - (int16_t)s_ed_scroller.pos;
    if (y + EDIT_LINE_H <= EDIT_TEXT_Y || y >= EDIT_TEXT_Y + EDIT_TEXT_H) return;
    ui_rect_t r = {0, y, UI_SCREEN_WIDTH, EDIT_LINE_H};
    ui_page_invalidate(&r);
}

/* Invalidate the cursor region (current line + small area around cursor) */
static void editor_invalidate_cursor(void)
{
    int16_t y = EDIT_TEXT_Y + s_ed.cursor_line * EDIT_LINE_H - (int16_t)s_ed_scroller.pos;
    if (y + EDIT_LINE_H <= EDIT_TEXT_Y || y >= EDIT_TEXT_Y + EDIT_TEXT_H) return;
    ui_rect_t r = {EDIT_GUTTER_W, y, UI_SCREEN_WIDTH - EDIT_GUTTER_W, EDIT_LINE_H};
    ui_page_invalidate(&r);
}

/* Invalidate text area + status bar (for content changes) */
static void editor_invalidate_content(void)
{
    editor_invalidate_text_area();
    editor_invalidate_status();
}

/*=============================================================================
 *  Line Parsing
 *=============================================================================*/

static void editor_parse_lines(void)
{
    s_ed.line_count = 0;
    s_ed.line_offsets[0] = 0;
    s_ed.line_count = 1;
    for (uint16_t i = 0; i < s_ed.content_len && s_ed.line_count < EDIT_MAX_LINES; i++) {
        if (s_ed.content[i] == '\n' && i + 1 < s_ed.content_len) {
            s_ed.line_offsets[s_ed.line_count] = i + 1;
            s_ed.line_count++;
        }
    }
}

/* Update cursor_line and cursor_col from cursor_pos */
static void editor_update_cursor_coords(void)
{
    /* Binary search for the line containing cursor_pos */
    int16_t lo = 0, hi = s_ed.line_count - 1;
    s_ed.cursor_line = 0;
    while (lo <= hi) {
        int16_t mid = (lo + hi) / 2;
        uint16_t line_start = s_ed.line_offsets[mid];
        uint16_t line_end = (mid + 1 < s_ed.line_count) ?
                            s_ed.line_offsets[mid + 1] : s_ed.content_len;
        if (s_ed.cursor_pos >= line_start && s_ed.cursor_pos <= line_end) {
            s_ed.cursor_line = mid;
            break;
        }
        if (s_ed.cursor_pos < line_start)
            hi = mid - 1;
        else
            lo = mid + 1;
    }

    /* Fix: if cursor_pos is exactly at the start of the next line (i.e., the
     * current line ends with '\n' and cursor is positioned right after it),
     * the cursor should be on the next line, not at the end of the current one.
     * Without this, pressing Enter leaves the cursor visually on the old line. */
    if (s_ed.cursor_line + 1 < s_ed.line_count &&
        s_ed.cursor_pos == s_ed.line_offsets[s_ed.cursor_line + 1]) {
        s_ed.cursor_line++;
    }

    /* Column is offset within the line */
    uint16_t line_start = s_ed.line_offsets[s_ed.cursor_line];
    s_ed.cursor_col = s_ed.cursor_pos - line_start;
}

/* Ensure cursor line is visible in the scroll viewport */
static void editor_ensure_cursor_visible(void)
{
    if (s_ed.cursor_line < s_ed.scroll_line)
        editor_scroll_set(s_ed.cursor_line, true);
    else if (s_ed.cursor_line >= s_ed.scroll_line + EDIT_VISIBLE_LINES)
        editor_scroll_set(s_ed.cursor_line - EDIT_VISIBLE_LINES + 1, true);
}

static void editor_update_status(void)
{
    if (s_ed.is_loading)
        snprintf(s_status_buf, sizeof(s_status_buf), "Loading...");
    else if (!s_ed.has_content)
        snprintf(s_status_buf, sizeof(s_status_buf), "No file loaded");
    else if (s_ed.save_sent)
        snprintf(s_status_buf, sizeof(s_status_buf), "Saving...");
    else if (s_ed.save_result == 1)
        snprintf(s_status_buf, sizeof(s_status_buf), "Saved");
    else if (s_ed.save_result == 2)
        snprintf(s_status_buf, sizeof(s_status_buf), "Save failed!");
    else
        snprintf(s_status_buf, sizeof(s_status_buf), "Ln %d, Col %d | %d lines | %d chars%s",
                 s_ed.cursor_line + 1, s_ed.cursor_col + 1,
                 s_ed.line_count, s_ed.content_len,
                 s_ed.is_modified ? " *" : "");
}

/*=============================================================================
 *  Undo System
 *=============================================================================*/

static void editor_push_undo(undo_type_t type, uint16_t pos, uint16_t len, const char *data)
{
    if (s_ed.undo_top >= EDIT_MAX_UNDO) {
        /* Shift stack down */
        memmove(&s_ed.undo_stack[0], &s_ed.undo_stack[1],
                (EDIT_MAX_UNDO - 1) * sizeof(undo_record_t));
        s_ed.undo_top = EDIT_MAX_UNDO - 1;
    }
    undo_record_t *r = &s_ed.undo_stack[s_ed.undo_top++];
    r->type = type;
    r->pos = pos;
    r->len = (len > sizeof(r->data)) ? sizeof(r->data) : len;
    if (data && r->len > 0)
        memcpy(r->data, data, r->len);
}

static void editor_undo(void)
{
    if (s_ed.undo_top <= 0) return;
    undo_record_t *r = &s_ed.undo_stack[--s_ed.undo_top];

    switch (r->type) {
    case UNDO_INSERT:
        /* Undo insert = delete the inserted chars */
        if (r->pos + r->len <= s_ed.content_len) {
            memmove(&s_ed.content[r->pos], &s_ed.content[r->pos + r->len],
                    s_ed.content_len - r->pos - r->len + 1);
            s_ed.content_len -= r->len;
        }
        s_ed.cursor_pos = r->pos;
        break;
    case UNDO_DELETE:
        /* Undo delete = re-insert the deleted chars */
        if (s_ed.content_len + r->len < EDIT_BUF_SIZE) {
            memmove(&s_ed.content[r->pos + r->len], &s_ed.content[r->pos],
                    s_ed.content_len - r->pos + 1);
            memcpy(&s_ed.content[r->pos], r->data, r->len);
            s_ed.content_len += r->len;
        }
        s_ed.cursor_pos = r->pos + r->len;
        break;
    }

    s_ed.is_modified = true;
    editor_parse_lines();
    editor_update_cursor_coords();
    editor_ensure_cursor_visible();
    editor_update_status();
    editor_invalidate_content();
}
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
