sratle/WCH-Model-Terminal/(commit log)

2026-04-17 feat: init driver
2026-04-19 feat: update fmc, fix bug
    [CH9350.c, display.c, fmc_driver.c, fmc_driver.h, keyboard.c, power.c, submodels.c]
2026-04-29 feat: ch9350 driver
2026-05-04 feat: update wireless doc
2026-05-05 feat: add wireless
2026-05-06 feat: update wireless
2026-05-07 feat: update ch378 device select
2026-05-11 feat: update wireless model
2026-05-11 feat: update wireless bt
2026-05-13 feat: gpio can drive ssd1963
    [binFontsTool-0.2.6.2.xlsm]
2026-05-14 feat: spi tx succ
2026-05-14 feat: spi txrx succ
2026-05-15 feat: fix ui font bug
    [binFontsTool-0.2.6.2.xlsm]
2026-05-16 feat: fix spi bug, now bt terminal can work
    [CH585F.c, ch585f_bt.c, ch585f_bt.h]
2026-05-17 feat: fix wireless bt multiframe bug
2026-05-17 feat: fix font bug
    [miniui_render.c]
2026-05-18 feat: complete touch driver
2026-05-18 feat: fix 12 miniui bug
    [app_terminal.c, apps.c, apps.h, main.c, miniui_types.h, miniui_widget.c, miniui_widget.h]
2026-05-19 feat: fix 5 miniui bug
    [CH378.c, main.c, miniui_render.c, miniui_render.h, miniui_widget.c, soft_8080.c, soft_8080.h]
2026-05-19 feat: fps up to 140 but bugs
    [fmc_driver.h, main.c, miniui_page.c, miniui_page.h, ssd1963.c, ui_system.c]
2026-05-19 feat: fps up to 60 but bugs
    [main.c, touch_driver.c]
2026-05-19 feat: lock fps to 30 fix bug
    [miniui_page.c]
2026-07-08 lcd搏斗
2026-07-09 can use ，lcd game rollback
2026-07-21 ebook优化
2026-07-23 power many things
2026-08-05 new user system && h417 itcm dtcm bug resolved
    [app_file.c, app_fingerprint.c, app_nfc.c, display.c, hardware.c]
2026-08-06 优化RGB融入
2026-08-06 完成测距模块全链路，未测试
2026-08-07 完成测距模块全链路，进行lcd优化
2026-08-08 音效系统初步
2026-08-08 音效系统修复
2026-08-08 开发板初步驱动
2026-08-09 文档修补和音效系统修复
2026-08-09 音效系统和CLI bug修复
2026-08-09 chore：修改config
2026-08-09 修复一个display侧缓冲区bug
2026-08-09 devboard更新&keyboard-3 bug
2026-08-12 能力测评
